dcowden/panelviz/docs/power_schematic.jpg

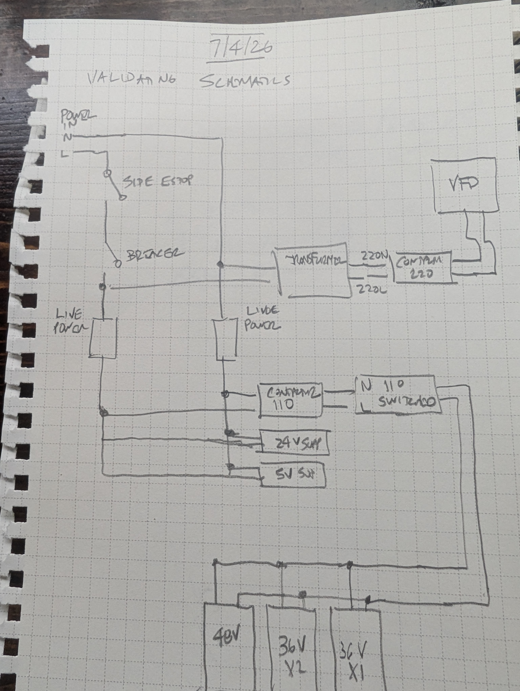
docs/power_schematic.jpg
