dcowden/panelviz/docs/safety_schematic.jpg

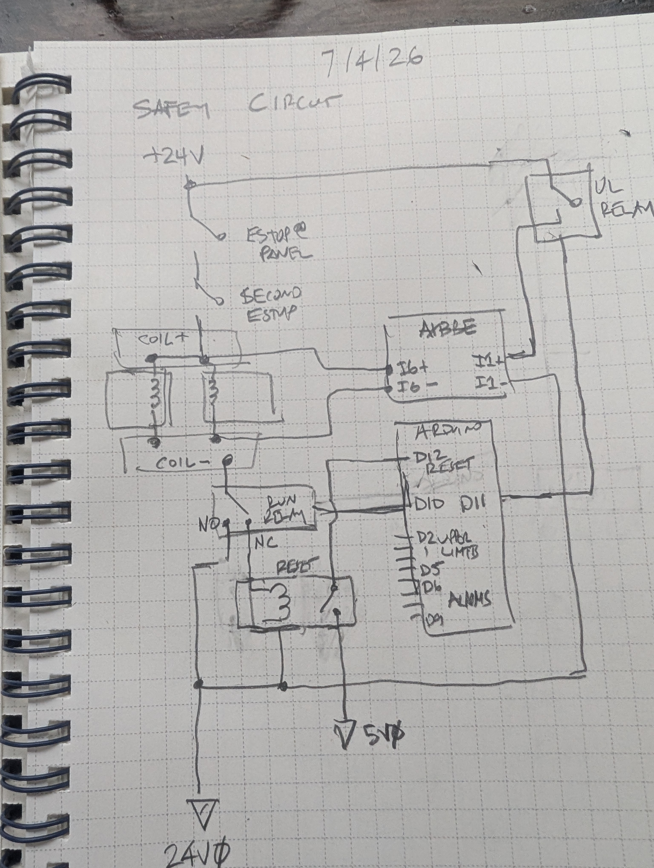
docs/safety_schematic.jpg
