dcowden/panelviz/README.md

# Combination panel software and docs for cnc machine

This is currently in a poor state-- its documentation for the
cnc machine, AND the code that produces it. 

To get interactive docs, install the project and then run:

```
panelviz mycnc.yml.
```

the latest artifacts are in the prod_machine folder
