dcowden/panelviz/wire_list.txt

| wirenumber | from_component | from_pin | to_component | to_pin | netname | awg | tags |
|---|---|---|---|---|---|---|---|
| 110L-1 | wall_plug | 1 | live_power_t | 1A | 110L | 12 | vfd |
| 110L-2 | live_power_t | 1B | transformer | 110L | 110L | 20 | vfd |
| 110L-3 | live_power_t | 3A | contactor_110 | T2 | 110L | 20 | vfd |
| 110L-4 | 24v | 110L | live_power_t | 3B | 110L | 20 | dc_power, vfd |
| 110L-5 | 5v | 110L | live_power_t | 5A | 110L | 20 | dc_power, vfd |
| 110L_SWITCHED-1 | contactor_110 | L2 | switched_110L | 1A | 110L_SWITCHED | 20 | vfd |
| 110L_SWITCHED-2 | 48v | 110L | switched_110L | 1B | 110L_SWITCHED | 20 | vfd |
| 110L_SWITCHED-3 | 36V_X1 | 110L | switched_110L | 2A | 110L_SWITCHED | 20 | vfd |
| 110L_SWITCHED-4 | 36V_X2 | 110L | switched_110L | 2B | 110L_SWITCHED | 20 | vfd |
| 110N-1 | wall_plug | 2 | live_power_t | 2A | 110N | 12 | vfd |
| 110N-2 | live_power_t | 2B | transformer | 110N | 110N | 20 | vfd |
| 110N-3 | live_power_t | 4A | contactor_110 | T3 | 110N | 20 | vfd |
| 110N-4 | 24v | 110N | live_power_t | 4B | 110N | 20 | dc_power, vfd |
| 110N-5 | 5v | 110N | live_power_t | 6A | 110N | 20 | dc_power, vfd |
| 110N_SWITCHED-1 | contactor_110 | L3 | switched_110N | 1A | 110N_SWITCHED | 20 | vfd |
| 110N_SWITCHED-2 | 36V_X1 | 110N | switched_110N | 1B | 110N_SWITCHED | 20 | vfd |
| 110N_SWITCHED-3 | 36V_X2 | 110N | switched_110N | 2A | 110N_SWITCHED | 20 | vfd |
| 110N_SWITCHED-4 | 48v | 110N | switched_110N | 2B | 110N_SWITCHED | 20 | vfd |
| 24V-1 | estop_panel | estop+ | cnc_terminals | 57A | 24V | 20 | terminals |
| 24V-2 | cnc_terminals | 57B | terminals_24v | 1A | 24V | 20 | terminals |
| 24V-3 | estop_panel | light+ | cnc_terminals | 59A | 24V | 20 | terminals |
| 24V-4 | cnc_terminals | 59B | terminals_24v | 1B | 24V | 20 | terminals |
| 24V-5 | 24v | 24V | dc_power_24v | 1A | 24V | 20 | dc_power |
| 24V-6 | dc_power_24v | 1B | safety_24v | 1A | 24V | 20 | dc_power, safety |
| 24V-7 | safety_24v | 1B | control_24v | 1A | 24V | 20 | safety, control |
| 24V-8 | control_24v | 1B | terminals_24v | 2A | 24V | 20 | control, terminals |
| 24V-9 | control_24v | 2A | axbb-e | I1+ | 24V | 20 | control |
| 24V-10 | control_24v | 2B | axbb-e | I2+ | 24V | 20 | control |
| 24V-11 | control_24v | 3A | axbb-e | I3+ | 24V | 20 | control |
| 24V-12 | control_24v | 3B | axbb-e | I4+ | 24V | 20 | control |
| 24V-13 | control_24v | 4A | axbb-e | I5+ | 24V | 20 | control |
| 24V-14 | axbb-e | IN-24V+ | control_24v | 4B | 24V | 20 | control |
| 24V0-1 | 24v | 24V0 | dc_power_24v0 | 1A | 24V0 | 20 | dc_power |
| 24V0-2 | dc_power_24v0 | 1B | safety_24v0 | 1A | 24V0 | 20 | dc_power, safety |
| 24V0-3 | safety_24v0 | 1B | control_24v0 | 1A | 24V0 | 20 | safety, control |
| 24V0-4 | control_24v0 | 1B | terminals_24v0 | 1A | 24V0 | 20 | control, terminals |
| 24V0-5 | axbb-e | IN-24V0 | control_24v0 | 2A | 24V0 | 20 | control |
| 24V0-6 | run_relay | COM | safety_24v0 | 2A | 24V0 | 20 | safety |
| 24V0-7 | upper_limits_ok_relay | COM | safety_24v0 | 2B | 24V0 | 20 | safety |
| 5V-1 | z_limits | 5v | cnc_terminals | 11A | 5V | 20 | terminals |
| 5V-2 | cnc_terminals | 11B | terminals_5v | 1A | 5V | 20 | terminals |
| 5V-3 | y_limits | 5v | cnc_terminals | 25A | 5V | 20 | terminals |
| 5V-4 | cnc_terminals | 25B | terminals_5v | 1B | 5V | 20 | terminals |
| 5V-5 | x1_limits | 5v | cnc_terminals | 37A | 5V | 20 | terminals |
| 5V-6 | cnc_terminals | 37B | terminals_5v | 2A | 5V | 20 | terminals |
| 5V-7 | x2_limits | 5v | cnc_terminals | 49A | 5V | 20 | terminals |
| 5V-8 | cnc_terminals | 49B | terminals_5v | 2B | 5V | 20 | terminals |
| 5V-9 | run_relay | DC+ | safety_5v | 1A | 5V | 20 | safety |
| 5V-10 | upper_limits_ok_relay | DC+ | safety_5v | 1B | 5V | 20 | safety |
| 5V-11 | 5v | 5V | dc_power_5v | 1A | 5V | 20 | dc_power |
| 5V-12 | dc_power_5v | 1B | safety_5v | 2A | 5V | 20 | dc_power, safety |
| 5V-13 | safety_5v | 2B | control_5v | 1A | 5V | 20 | safety, control |
| 5V-14 | control_5v | 1B | terminals_5v | 3A | 5V | 20 | control, terminals |
| 5V-15 | axbb-e | IN-5V+ | control_5v | 2A | 5V | 20 | control |
| 5V-16 | alarm_limit_board | 5V | safety_5v | 3A | 5V | 20 | safety |
| 5V-17 | opto_board | 5+ | safety_5v | 3B | 5V | 20 | safety |
| 5V-18 | opto_board | 6+ | safety_5v | 4A | 5V | 20 | safety |
| 5V-19 | opto_board | 7+ | safety_5v | 4B | 5V | 20 | safety |
| 5V-20 | opto_board | 8+ | safety_5v | 5A | 5V | 20 | safety |
| 5V0-1 | z_limits | 5v0 | cnc_terminals | 14A | 5V0 | 20 | terminals |
| 5V0-2 | cnc_terminals | 14B | terminals_5v0 | 1A | 5V0 | 20 | terminals |
| 5V0-3 | y_limits | 5v0 | cnc_terminals | 28A | 5V0 | 20 | terminals |
| 5V0-4 | cnc_terminals | 28B | terminals_5v0 | 1B | 5V0 | 20 | terminals |
| 5V0-5 | x1_control | alrm- | cnc_terminals | 32A | 5V0 | 20 | terminals |
| 5V0-6 | cnc_terminals | 32B | terminals_5v0 | 2A | 5V0 | 20 | terminals |
| 5V0-7 | x1_control | dir- | cnc_terminals | 34A | 5V0 | 20 | terminals |
| 5V0-8 | cnc_terminals | 34B | terminals_5v0 | 2B | 5V0 | 20 | terminals |
| 5V0-9 | x1_control | pul- | cnc_terminals | 36A | 5V0 | 20 | terminals |
| 5V0-10 | cnc_terminals | 36B | terminals_5v0 | 3A | 5V0 | 20 | terminals |
| 5V0-11 | x1_limits | 5v0 | cnc_terminals | 40A | 5V0 | 20 | terminals |
| 5V0-12 | cnc_terminals | 40B | terminals_5v0 | 3B | 5V0 | 20 | terminals |
| 5V0-13 | x2_control | alrm- | cnc_terminals | 44A | 5V0 | 20 | terminals |
| 5V0-14 | cnc_terminals | 44B | terminals_5v0 | 4A | 5V0 | 20 | terminals |
| 5V0-15 | x2_control | dir- | cnc_terminals | 46A | 5V0 | 20 | terminals |
| 5V0-16 | cnc_terminals | 46B | terminals_5v0 | 4B | 5V0 | 20 | terminals |
| 5V0-17 | x2_control | pul- | cnc_terminals | 48A | 5V0 | 20 | terminals |
| 5V0-18 | cnc_terminals | 48B | terminals_5v0 | 5A | 5V0 | 20 | terminals |
| 5V0-19 | x2_limits | 5v0 | cnc_terminals | 52A | 5V0 | 20 | terminals |
| 5V0-20 | cnc_terminals | 52B | terminals_5v0 | 5B | 5V0 | 20 | terminals |
| 5V0-21 | estop_panel | reset_sw+  | cnc_terminals | 55A | 5V0 | 20 | terminals |
| 5V0-22 | cnc_terminals | 55B | terminals_5v0 | 6A | 5V0 | 20 | terminals |
| 5V0-23 | run_relay | DC- | safety_5v0 | 1A | 5V0 | 20 | safety |
| 5V0-24 | upper_limits_ok_relay | DC- | safety_5v0 | 1B | 5V0 | 20 | safety |
| 5V0-25 | 5v | 5V0 | dc_power_5v0 | 1A | 5V0 | 20 | dc_power |
| 5V0-26 | dc_power_5v0 | 1B | safety_5v0 | 2A | 5V0 | 20 | dc_power, safety |
| 5V0-27 | safety_5v0 | 2B | control_5v0 | 1A | 5V0 | 20 | safety, control |
| 5V0-28 | control_5v0 | 1B | terminals_5v0 | 6B | 5V0 | 20 | control, terminals |
| 5V0-29 | y_cl57s | PUL- | control_5v0 | 2A | 5V0 | 20 | control |
| 5V0-30 | y_cl57s | DIR- | control_5v0 | 2B | 5V0 | 20 | control |
| 5V0-31 | y_cl57s | COM- | control_5v0 | 3A | 5V0 | 20 | control |
| 5V0-32 | Z_cl57s | PUL- | control_5v0 | 3B | 5V0 | 20 | control |
| 5V0-33 | Z_cl57s | DIR- | control_5v0 | 4A | 5V0 | 20 | control |
| 5V0-34 | Z_cl57s | COM- | control_5v0 | 4B | 5V0 | 20 | control |
| 5V0-35 | axbb-e | IN-5V0 | control_5v0 | 5A | 5V0 | 20 | control |
| 5V0-36 | alarm_limit_board | 5V0 | safety_5v0 | 3A | 5V0 | 20 | safety |
| 5V0-37 | opto_board | 1- | safety_5v0 | 3B | 5V0 | 20 | safety |
| 5V0-38 | opto_board | 2- | safety_5v0 | 4A | 5V0 | 20 | safety |
| 5V0-39 | opto_board | 3- | safety_5v0 | 4B | 5V0 | 20 | safety |
| 5V0-40 | opto_board | 4- | safety_5v0 | 5A | 5V0 | 20 | safety |
| COIL+-1 | contactor_110 | A1 | coil_t | 1A | COIL+ | 20 | vfd |
| COIL+-2 | contactor_220 | A1 | coil_t | 1B | COIL+ | 20 | vfd |
| COIL+-3 | secondary_estop | estop- | cnc_terminals | 64A | COIL+ | 20 | terminals |
| COIL+-4 | cnc_terminals | 64B | coil_t | 2A | COIL+ | 20 | terminals, vfd |
| COIL+-5 | axbb-e | I6+ | coil_t | 2B | COIL+ | 20 | control, vfd |
| COIL--1 | contactor_110 | A2 | coil_t | 5A | COIL- | 20 | vfd |
| COIL--2 | contactor_220 | A2 | coil_t | 5B | COIL- | 20 | vfd |
| COIL--3 | axbb-e | I6- | coil_t | 6A | COIL- | 20 | control, vfd |
| COIL--4 | run_relay | NO | coil_t | 6B | COIL- | 20 | safety, vfd |
| DRIVER_48V-1 | y_cl57s | +VDC | 48v | 48V | DRIVER_48V | 20 | control, vfd |
| DRIVER_48V-2 | Z_cl57s | +VDC | 48v | 48V | DRIVER_48V | 20 | control, vfd |
| DRIVER_GND-1 | z_control | gnd | cnc_terminals | 10A | DRIVER_GND | 20 | terminals |
| DRIVER_GND-2 | cnc_terminals | 10B | Z_cl57s | GND | DRIVER_GND | 20 | terminals, control |
| DRIVER_GND-3 | y_control | gnd | cnc_terminals | 24A | DRIVER_GND | 20 | terminals |
| DRIVER_GND-4 | cnc_terminals | 24B | y_cl57s | GND | DRIVER_GND | 20 | terminals, control |
| DRIVER_GND-5 | y_cl57s | GND | 48v | 48V0 | DRIVER_GND | 20 | control, vfd |
| DRIVER_GND-6 | Z_cl57s | GND | 48v | 48V0 | DRIVER_GND | 20 | control, vfd |
| RESET_SW-1 | estop_panel | reset_sw-  | cnc_terminals | 56A | RESET_SW | 20 | terminals |
| RESET_SW-2 | cnc_terminals | 56B | alarm_limit_board | D12 | RESET_SW | 20 | terminals, safety  |
| RUN_RELAY_CTL-1 | alarm_limit_board | D10 | run_relay | IN | RUN_RELAY_CTL | 20 | safety |
| UL1-1 | upper_limits_ok_relay | NC | axbb-e | I1- | UL1 | 20 | safety, control |
| UPPER_LIMITS_OK_RELAY_CTL-1 | alarm_limit_board | D11 | upper_limits_ok_relay | IN | UPPER_LIMITS_OK_RELAY_CTL | 20 | safety |
| VFD_FWD-1 | axbb-e | O3 | vfd | FOR | VFD_FWD | 20 | control, vfd |
| VFD_REV-1 | axbb-e | O2 | vfd | REV | VFD_REV | 20 | control, vfd |
| VFD_V1-1 | axbb-e | A01 | vfd | VI | VFD_V1 | 20 | control, vfd |
| X1DIR-1 | x1_control | dir+ | cnc_terminals | 33A | X1DIR | 20 | terminals |
| X1DIR-2 | cnc_terminals | 33B | axbb-e | O12 | X1DIR | 20 | terminals, control |
| X1LL-1 | x1_limits | ll | cnc_terminals | 39A | X1LL | 20 | terminals |
| X1LL-2 | cnc_terminals | 39B | axbb-e | I3- | X1LL | 20 | terminals, control |
| X1STEP-1 | x1_control | pul+ | cnc_terminals | 35A | X1STEP | 20 | terminals |
| X1STEP-2 | cnc_terminals | 35B | axbb-e | O11 | X1STEP | 20 | terminals, control |
| X1UL_OK-1 | alarm_limit_board | D2 | opto_board | O1 | X1UL_OK | 20 | safety |
| X1_ALM_OK-1 | alarm_limit_board | D6 | opto_board | O5 | X1_ALM_OK | 20 | safety |
| X2DIR-1 | x2_control | dir+ | cnc_terminals | 45A | X2DIR | 20 | terminals |
| X2DIR-2 | cnc_terminals | 45B | axbb-e | O14 | X2DIR | 20 | terminals, control |
| X2LL-1 | x2_limits | ll | cnc_terminals | 51A | X2LL | 20 | terminals |
| X2LL-2 | cnc_terminals | 51B | axbb-e | I4- | X2LL | 20 | terminals, control |
| X2STEP-1 | x2_control | pul+ | cnc_terminals | 47A | X2STEP | 20 | terminals |
| X2STEP-2 | cnc_terminals | 47B | axbb-e | O13 | X2STEP | 20 | terminals, control |
| X2UL_OK-1 | alarm_limit_board | D3 | opto_board | O2 | X2UL_OK | 20 | safety |
| X2_ALM_OK-1 | alarm_limit_board | D7 | opto_board | O6 | X2_ALM_OK | 20 | safety |
| YDIR-1 | y_cl57s | DIR+ | axbb-e | O10 | YDIR | 20 | control |
| YLL-1 | y_limits | ll | cnc_terminals | 27A | YLL | 20 | terminals |
| YLL-2 | cnc_terminals | 27B | axbb-e | I2- | YLL | 20 | terminals, control |
| YSTEP-1 | y_cl57s | PUL+ | axbb-e | O9 | YSTEP | 20 | control |
| YUL_OK-1 | alarm_limit_board | D4 | opto_board | O3 | YUL_OK | 20 | safety |
| Y_ALM_OK-1 | alarm_limit_board | D8 | opto_board | O7 | Y_ALM_OK | 20 | safety |
| ZDIR-1 | Z_cl57s | DIR+ | axbb-e | O16 | ZDIR | 20 | control |
| ZLL-1 | z_limits | ll | cnc_terminals | 13A | ZLL | 20 | terminals |
| ZLL-2 | cnc_terminals | 13B | axbb-e | I5- | ZLL | 20 | terminals, control |
| ZSTEP-1 | Z_cl57s | PUL+ | axbb-e | O15 | ZSTEP | 20 | control |
| ZUL_OK-1 | alarm_limit_board | D5 | opto_board | O4 | ZUL_OK | 20 | safety |
| Z_ALM_OK-1 | alarm_limit_board | D9 | opto_board | O8 | Z_ALM_OK | 20 | safety |
| Z_cl57s.ALM-1 | Z_cl57s | ALM | opto_board | 8- | Z_cl57s.ALM | 20 | control, safety |
| earth-1 | wall_plug | GND | vfd_earth | 1A | earth | 12 | vfd |
| earth-2 | transformer | GND | vfd_earth | 1B | earth | 20 | vfd |
| earth-3 | 48v | GND | vfd_earth | 2A | earth | 20 | vfd |
| earth-4 | 24v | GND | dc_power_earth | 1A | earth | 20 | dc_power |
| earth-5 | 5v | GND | dc_power_earth | 1B | earth | 20 | dc_power |
| earth-6 | 36V_X1 | GND | vfd_earth | 2B | earth | 20 | vfd |
| earth-7 | 36V_X2 | GND | vfd_earth | 3A | earth | 20 | vfd |
| earth-8 | vfd | GND | vfd_earth | 3B | earth | 20 | vfd |
| earth-9 | vfd_earth | 4A | dc_power_earth | 2A | earth | 20 | vfd, dc_power |
| earth-10 | dc_power_earth | 2B | safety_earth | 1A | earth | 20 | dc_power, safety |
| earth-11 | safety_earth | 1B | control_earth | 1A | earth | 20 | safety, control |
| earth-12 | control_earth | 1B | terminals_earth | 1A | earth | 20 | control, terminals |
| estop_panel.estop--1 | estop_panel | estop- | cnc_terminals | 58A | estop_panel.estop- | 20 | terminals |
| estop_panel.estop--2 | cnc_terminals | 58B | secondary_estop | estop+ | estop_panel.estop- | 20 | terminals |
| estop_panel.light--1 | estop_panel | light- | cnc_terminals | 60A | estop_panel.light- | 20 | terminals |
| estop_panel.light--2 | cnc_terminals | 60B | run_relay | NC | estop_panel.light- | 20 | terminals, safety  |
| probe.probe+-1 | probe | probe+ | cnc_terminals | 53A | probe.probe+ | 20 | terminals |
| probe.probe--1 | probe | probe- | cnc_terminals | 54A | probe.probe- | 20 | terminals |
| shield-1 | z_motor | shield | connector_earth | 1A | shield | 20 | terminals |
| shield-2 | z_control | shield | connector_earth | 1B | shield | 20 | terminals |
| shield-3 | z_limits | shield | connector_earth | 2A | shield | 20 | terminals |
| shield-4 | y_motor | shield | connector_earth | 2B | shield | 20 | terminals |
| shield-5 | y_control | shield | connector_earth | 3A | shield | 20 | terminals |
| shield-6 | y_limits | shield | connector_earth | 3B | shield | 20 | terminals |
| shield-7 | x1_motor | shield | connector_earth | 4A | shield | 20 | terminals |
| shield-8 | x1_limits | shield | connector_earth | 4B | shield | 20 | terminals |
| shield-9 | x2_motor | shield | connector_earth | 5A | shield | 20 | terminals |
| shield-10 | x2_limits | shield | connector_earth | 5B | shield | 20 | terminals |
| shield-11 | probe | shield | connector_earth | 6A | shield | 20 | terminals |
| shield-12 | spindle | shield | connector_earth | 6B | shield | 20 | terminals |
| spindle.u-1 | spindle | u | cnc_terminals | 61A | spindle.u | 16 | terminals |
| spindle.u-2 | cnc_terminals | 61B | vfd | U | spindle.u | 16 | terminals, vfd |
| spindle.v-1 | spindle | v | cnc_terminals | 62A | spindle.v | 16 | terminals |
| spindle.v-2 | cnc_terminals | 62B | vfd | V | spindle.v | 16 | terminals, vfd |
| spindle.w-1 | spindle | w | cnc_terminals | 63A | spindle.w | 16 | terminals |
| spindle.w-2 | cnc_terminals | 63B | vfd | W | spindle.w | 16 | terminals, vfd |
| transformer.220L-1 | transformer | 220L | contactor_220 | T1 | transformer.220L | 20 | vfd |
| transformer.220N-1 | transformer | 220N | contactor_220 | T2 | transformer.220N | 20 | vfd |
| vfd.R-1 | vfd | R | contactor_220 | L1 | vfd.R | 20 | vfd |
| vfd.T-1 | vfd | T | contactor_220 | L2 | vfd.T | 20 | vfd |
| x1_control.alrm+-1 | x1_control | alrm+ | cnc_terminals | 31A | x1_control.alrm+ | 20 | terminals |
| x1_control.alrm+-2 | cnc_terminals | 31B | opto_board | 5- | x1_control.alrm+ | 20 | terminals, safety  |
| x1_limits.ul-1 | x1_limits | ul | cnc_terminals | 38A | x1_limits.ul | 20 | terminals |
| x1_limits.ul-2 | cnc_terminals | 38B | opto_board | 1+ | x1_limits.ul | 20 | terminals, safety  |
| x1_motor.M+-1 | x1_motor | M+ | cnc_terminals | 29A | x1_motor.M+ | 16 | terminals |
| x1_motor.M+-2 | cnc_terminals | 29B | 36V_X1 | 36V_X1 | x1_motor.M+ | 16 | terminals, vfd |
| x1_motor.M--1 | x1_motor | M- | cnc_terminals | 30A | x1_motor.M- | 16 | terminals |
| x1_motor.M--2 | cnc_terminals | 30B | 36V_X1 | 36V0_X1  | x1_motor.M- | 16 | terminals, vfd |
| x2_control.alrm+-1 | x2_control | alrm+ | cnc_terminals | 43A | x2_control.alrm+ | 20 | terminals |
| x2_control.alrm+-2 | cnc_terminals | 43B | opto_board | 6- | x2_control.alrm+ | 20 | terminals, safety  |
| x2_limits.ul-1 | x2_limits | ul | cnc_terminals | 50A | x2_limits.ul | 20 | terminals |
| x2_limits.ul-2 | cnc_terminals | 50B | opto_board | 2+ | x2_limits.ul | 20 | terminals, safety  |
| x2_motor.M+-1 | x2_motor | M+ | cnc_terminals | 41A | x2_motor.M+ | 16 | terminals |
| x2_motor.M+-2 | cnc_terminals | 41B | 36V_X2 | 36V_X2 | x2_motor.M+ | 16 | terminals, vfd |
| x2_motor.M--1 | x2_motor | M- | cnc_terminals | 42A | x2_motor.M- | 16 | terminals |
| x2_motor.M--2 | cnc_terminals | 42B | 36V_X2 | 36V0_X2  | x2_motor.M- | 16 | terminals, vfd |
| y_cl57s.ALM-1 | y_cl57s | ALM | opto_board | 7- | y_cl57s.ALM | 20 | control, safety |
| y_control.ea+-1 | y_control | ea+ | cnc_terminals | 21A | y_control.ea+ | 20 | terminals |
| y_control.ea+-2 | cnc_terminals | 21B | y_cl57s | EA+ | y_control.ea+ | 20 | terminals, control |
| y_control.ea--1 | y_control | ea- | cnc_terminals | 22A | y_control.ea- | 20 | terminals |
| y_control.ea--2 | cnc_terminals | 22B | y_cl57s | EA- | y_control.ea- | 20 | terminals, control |
| y_control.eb+-1 | y_control | eb+ | cnc_terminals | 19A | y_control.eb+ | 20 | terminals |
| y_control.eb+-2 | cnc_terminals | 19B | y_cl57s | EB+ | y_control.eb+ | 20 | terminals, control |
| y_control.eb--1 | y_control | eb- | cnc_terminals | 20A | y_control.eb- | 20 | terminals |
| y_control.eb--2 | cnc_terminals | 20B | y_cl57s | EB- | y_control.eb- | 20 | terminals, control |
| y_control.vcc-1 | y_control | vcc | cnc_terminals | 23A | y_control.vcc | 20 | terminals |
| y_control.vcc-2 | cnc_terminals | 23B | y_cl57s | VCC | y_control.vcc | 20 | terminals, control |
| y_limits.ul-1 | y_limits | ul | cnc_terminals | 26A | y_limits.ul | 20 | terminals |
| y_limits.ul-2 | cnc_terminals | 26B | opto_board | 3+ | y_limits.ul | 20 | terminals, safety  |
| y_motor.ma+-1 | y_motor | ma+ | cnc_terminals | 15A | y_motor.ma+ | 16 | terminals |
| y_motor.ma+-2 | cnc_terminals | 15B | y_cl57s | A+ | y_motor.ma+ | 16 | terminals, control |
| y_motor.ma--1 | y_motor | ma- | cnc_terminals | 16A | y_motor.ma- | 16 | terminals |
| y_motor.ma--2 | cnc_terminals | 16B | y_cl57s | A- | y_motor.ma- | 16 | terminals, control |
| y_motor.mb+-1 | y_motor | mb+ | cnc_terminals | 17A | y_motor.mb+ | 16 | terminals |
| y_motor.mb+-2 | cnc_terminals | 17B | y_cl57s | B+ | y_motor.mb+ | 16 | terminals, control |
| y_motor.mb--1 | y_motor | mb- | cnc_terminals | 18A | y_motor.mb- | 16 | terminals |
| y_motor.mb--2 | cnc_terminals | 18B | y_cl57s | B- | y_motor.mb- | 16 | terminals, control |
| z_control.ea+-1 | z_control | ea+ | cnc_terminals | 7A | z_control.ea+ | 20 | terminals |
| z_control.ea+-2 | cnc_terminals | 7B | Z_cl57s | EA+ | z_control.ea+ | 20 | terminals, control |
| z_control.ea--1 | z_control | ea- | cnc_terminals | 8A | z_control.ea- | 20 | terminals |
| z_control.ea--2 | cnc_terminals | 8B | Z_cl57s | EA- | z_control.ea- | 20 | terminals, control |
| z_control.eb+-1 | z_control | eb+ | cnc_terminals | 5A | z_control.eb+ | 20 | terminals |
| z_control.eb+-2 | cnc_terminals | 5B | Z_cl57s | EB+ | z_control.eb+ | 20 | terminals, control |
| z_control.eb--1 | z_control | eb- | cnc_terminals | 6A | z_control.eb- | 20 | terminals |
| z_control.eb--2 | cnc_terminals | 6B | Z_cl57s | EB- | z_control.eb- | 20 | terminals, control |
| z_control.vcc-1 | z_control | vcc | cnc_terminals | 9A | z_control.vcc | 20 | terminals |
| z_control.vcc-2 | cnc_terminals | 9B | Z_cl57s | VCC | z_control.vcc | 20 | terminals, control |
| z_limits.ul-1 | z_limits | ul | cnc_terminals | 12A | z_limits.ul | 20 | terminals |
| z_limits.ul-2 | cnc_terminals | 12B | opto_board | 4+ | z_limits.ul | 20 | terminals, safety  |
| z_motor.ma+-1 | z_motor | ma+ | cnc_terminals | 1A | z_motor.ma+ | 16 | terminals |
| z_motor.ma+-2 | cnc_terminals | 1B | Z_cl57s | A+ | z_motor.ma+ | 16 | terminals, control |
| z_motor.ma--1 | z_motor | ma- | cnc_terminals | 2A | z_motor.ma- | 16 | terminals |
| z_motor.ma--2 | cnc_terminals | 2B | Z_cl57s | A- | z_motor.ma- | 16 | terminals, control |
| z_motor.mb+-1 | z_motor | mb+ | cnc_terminals | 3A | z_motor.mb+ | 16 | terminals |
| z_motor.mb+-2 | cnc_terminals | 3B | Z_cl57s | B+ | z_motor.mb+ | 16 | terminals, control |
| z_motor.mb--1 | z_motor | mb- | cnc_terminals | 4A | z_motor.mb- | 16 | terminals |
| z_motor.mb--2 | cnc_terminals | 4B | Z_cl57s | B- | z_motor.mb- | 16 | terminals, control |
