dcowden/panelviz/prod_machine/mycnc_schematic.pdf

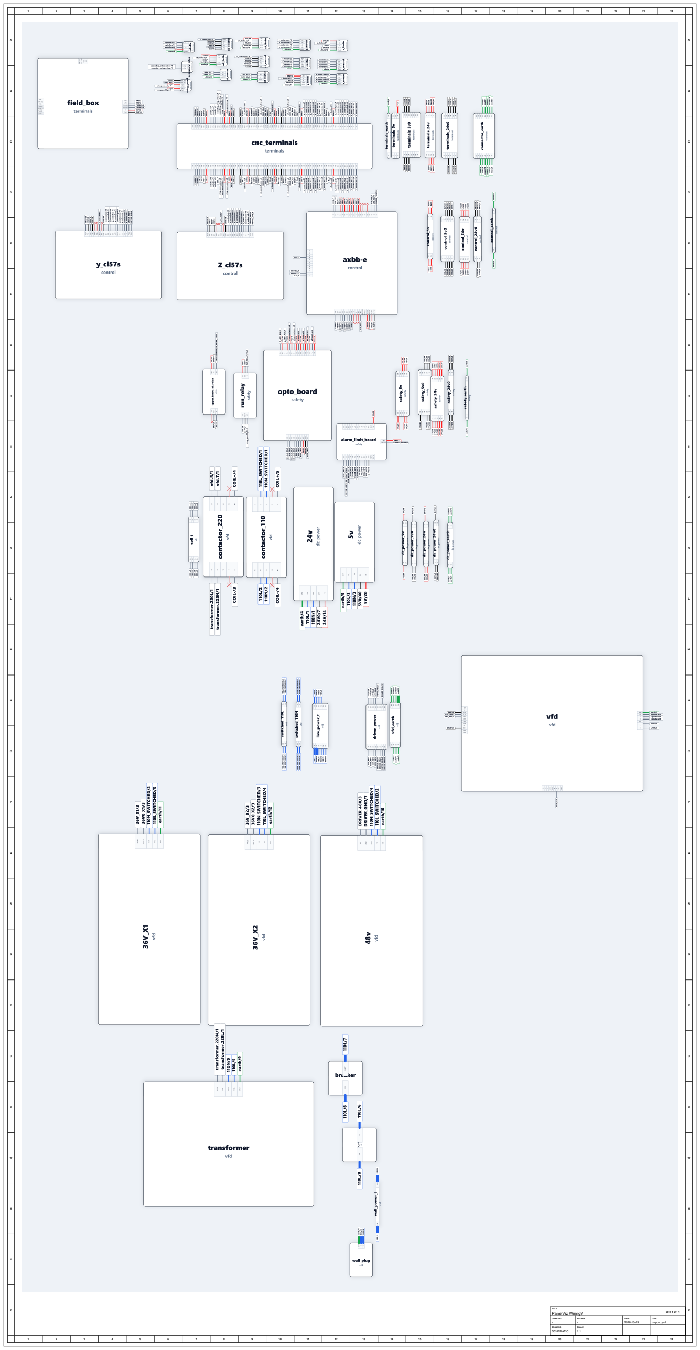
[picture p3: page 1]

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
TITLE

## PanelViz Wiring?

SHT 1 OF 1

COMPANY

AUTHOR

DATE
2026-10-29

FILE
mycnc.yml

DRAWING
SCHEMATIC

SCALE
1:1
