dcowden/panelviz/wirelabel_control.pdf

z_motor.ma+-2 z_motor.ma+-2 z_motor.ma+-2 z_motor.ma+-2 z_motor.ma+-2 | z_control.ea+-2 z_control.ea+-2 z_control.ea+-2 z_control.ea+-2 z_control.ea+-2 | y_motor.mb+-2 y_motor.mb+-2 y_motor.mb+-2 y_motor.mb+-2 y_motor.mb+-2 | y_control.vcc-2 y_control.vcc-2 y_control.vcc-2 y_control.vcc-2 y_control.vcc-2 | ZLL-2 ZLL-2 ZLL-2 ZLL-2 ZLL-2 | X2STEP-2 X2STEP-2 X2STEP-2 X2STEP-2 X2STEP-2
z_motor.ma--2 z_motor.ma--2 z_motor.ma--2 z_motor.ma--2 z_motor.ma--2 | z_control.ea--2 z_control.ea--2 z_control.ea--2 z_control.ea--2 z_control.ea--2 | y_motor.mb--2 y_motor.mb--2 y_motor.mb--2 y_motor.mb--2 y_motor.mb--2 | DRIVER_GND-4 DRIVER_GND-4 DRIVER_GND-4 DRIVER_GND-4 DRIVER_GND-4 | YLL-2 YLL-2 YLL-2 YLL-2 YLL-2 | X2LL-2 X2LL-2 X2LL-2 X2LL-2 X2LL-2
z_motor.mb+-2 z_motor.mb+-2 z_motor.mb+-2 z_motor.mb+-2 z_motor.mb+-2 | z_control.vcc-2 z_control.vcc-2 z_control.vcc-2 z_control.vcc-2 z_control.vcc-2 | y_control.eb+-2 y_control.eb+-2 y_control.eb+-2 y_control.eb+-2 y_control.eb+-2 | y_cl57s.ALM-1 y_cl57s.ALM-1 y_cl57s.ALM-1 y_cl57s.ALM-1 y_cl57s.ALM-1 | X1DIR-2 X1DIR-2 X1DIR-2 X1DIR-2 X1DIR-2 | 5V-13 5V-13 5V-13 5V-13 5V-13
z_motor.mb--2 z_motor.mb--2 z_motor.mb--2 z_motor.mb--2 z_motor.mb--2 | DRIVER_GND-2 DRIVER_GND-2 DRIVER_GND-2 DRIVER_GND-2 DRIVER_GND-2 | y_control.eb--2 y_control.eb--2 y_control.eb--2 y_control.eb--2 y_control.eb--2 | DRIVER_48V-1 DRIVER_48V-1 DRIVER_48V-1 DRIVER_48V-1 DRIVER_48V-1 | X1STEP-2 X1STEP-2 X1STEP-2 X1STEP-2 X1STEP-2 | 5V-14 5V-14 5V-14 5V-14 5V-14
z_control.eb+-2 z_control.eb+-2 z_control.eb+-2 z_control.eb+-2 z_control.eb+-2 | y_motor.ma+-2 y_motor.ma+-2 y_motor.ma+-2 y_motor.ma+-2 y_motor.ma+-2 | y_control.ea+-2 y_control.ea+-2 y_control.ea+-2 y_control.ea+-2 y_control.ea+-2 | DRIVER_GND-5 DRIVER_GND-5 DRIVER_GND-5 DRIVER_GND-5 DRIVER_GND-5 | X1LL-2 X1LL-2 X1LL-2 X1LL-2 X1LL-2 | 5V0-27 5V0-27 5V0-27 5V0-27 5V0-27
z_control.eb--2 z_control.eb--2 z_control.eb--2 z_control.eb--2 z_control.eb--2 | y_motor.ma--2 y_motor.ma--2 y_motor.ma--2 y_motor.ma--2 y_motor.ma--2 | y_control.ea--2 y_control.ea--2 y_control.ea--2 y_control.ea--2 y_control.ea--2 | Z_cl57s.ALM-1 Z_cl57s.ALM-1 Z_cl57s.ALM-1 Z_cl57s.ALM-1 Z_cl57s.ALM-1 | X2DIR-2 X2DIR-2 X2DIR-2 X2DIR-2 X2DIR-2 | 5V0-28 5V0-28 5V0-28 5V0-28 5V0-28
