dcowden/panelviz/wirelabel_control2.pdf

24V-7 24V-7 24V-7 24V-7 24V-7 | YSTEP-1 YSTEP-1 YSTEP-1 YSTEP-1 YSTEP-1 | 5V0-32 5V0-32 5V0-32 5V0-32 5V0-32 | 24V-9 24V-9 24V-9 24V-9 24V-9 | COIL--3 COIL--3 COIL--3 COIL--3 COIL--3 | DRIVER_48V-2 DRIVER_48V-2 DRIVER_48V-2 DRIVER_48V-2 DRIVER_48V-2 | UL1-1 UL1-1 UL1-1 UL1-1 UL1-1
24V-8 24V-8 24V-8 24V-8 24V-8 | 5V0-29 5V0-29 5V0-29 5V0-29 5V0-29 | ZDIR-1 ZDIR-1 ZDIR-1 ZDIR-1 ZDIR-1 | 24V-10 24V-10 24V-10 24V-10 24V-10 | 24V0-5 24V0-5 24V0-5 24V0-5 24V0-5 | DRIVER_GND-6 DRIVER_GND-6 DRIVER_GND-6 DRIVER_GND-6 DRIVER_GND-6
24V0-3 24V0-3 24V0-3 24V0-3 24V0-3 | YDIR-1 YDIR-1 YDIR-1 YDIR-1 YDIR-1 | 5V0-33 5V0-33 5V0-33 5V0-33 5V0-33 | 24V-11 24V-11 24V-11 24V-11 24V-11 | 24V-14 24V-14 24V-14 24V-14 24V-14
24V0-4 24V0-4 24V0-4 24V0-4 24V0-4 | 5V0-30 5V0-30 5V0-30 5V0-30 5V0-30 | 5V0-34 5V0-34 5V0-34 5V0-34 5V0-34 | 24V-12 24V-12 24V-12 24V-12 24V-12 | 5V0-35 5V0-35 5V0-35 5V0-35 5V0-35
earth-11 earth-11 earth-11 earth-11 earth-11 | 5V0-31 5V0-31 5V0-31 5V0-31 5V0-31 | VFD_FWD-1 VFD_FWD-1 VFD_FWD-1 VFD_FWD-1 VFD_FWD-1 | 24V-13 24V-13 24V-13 24V-13 24V-13 | 5V-15 5V-15 5V-15 5V-15 5V-15
earth-12 earth-12 earth-12 earth-12 earth-12 | ZSTEP-1 ZSTEP-1 ZSTEP-1 ZSTEP-1 ZSTEP-1 | VFD_REV-1 VFD_REV-1 VFD_REV-1 VFD_REV-1 VFD_REV-1 | COIL+-5 COIL+-5 COIL+-5 COIL+-5 COIL+-5 | VFD_V1-1 VFD_V1-1 VFD_V1-1 VFD_V1-1 VFD_V1-1
