dcowden/panelviz/wirelabel_dc_power.pdf

earth-4 earth-4 earth-4 earth-4 earth-4 | 5V-11 5V-11 5V-11 5V-11 5V-11 | 24V-6 24V-6 24V-6 24V-6 24V-6
110N-4 110N-4 110N-4 110N-4 110N-4 | 5V0-25 5V0-25 5V0-25 5V0-25 5V0-25 | 24V0-2 24V0-2 24V0-2 24V0-2 24V0-2
110L-4 110L-4 110L-4 110L-4 110L-4 | 24V-5 24V-5 24V-5 24V-5 24V-5 | earth-9 earth-9 earth-9 earth-9 earth-9
110N-5 110N-5 110N-5 110N-5 110N-5 | 24V0-1 24V0-1 24V0-1 24V0-1 24V0-1 | earth-10 earth-10 earth-10 earth-10 earth-10
110L-5 110L-5 110L-5 110L-5 110L-5 | 5V-12 5V-12 5V-12 5V-12 5V-12
earth-5 earth-5 earth-5 earth-5 earth-5 | 5V0-26 5V0-26 5V0-26 5V0-26 5V0-26
