dcowden/panelviz/wirelabel_safety.pdf

z_limits.ul-2 z_limits.ul-2 z_limits.ul-2 z_limits.ul-2 z_limits.ul-2 | 5V-9 5V-9 5V-9 5V-9 5V-9 | 5V0-27 5V0-27 5V0-27 5V0-27 5V0-27 | earth-11 earth-11 earth-11 earth-11 earth-11 | Z_ALM_OK-1 Z_ALM_OK-1 Z_ALM_OK-1 Z_ALM_OK-1 Z_ALM_OK-1 | UL1-1 UL1-1 UL1-1 UL1-1 UL1-1 | x1_control.alrm+-2 x1_control.alrm+-2 x1_control.alrm+-2 x1_control.alrm+-2 x1_control.alrm+-2
y_limits.ul-2 y_limits.ul-2 y_limits.ul-2 y_limits.ul-2 y_limits.ul-2 | 5V0-24 5V0-24 5V0-24 5V0-24 5V0-24 | 24V-6 24V-6 24V-6 24V-6 24V-6 | X1UL_OK-1 X1UL_OK-1 X1UL_OK-1 X1UL_OK-1 X1UL_OK-1 | 5V0-36 5V0-36 5V0-36 5V0-36 5V0-36 | 5V0-37 5V0-37 5V0-37 5V0-37 5V0-37 | x2_control.alrm+-2 x2_control.alrm+-2 x2_control.alrm+-2 x2_control.alrm+-2 x2_control.alrm+-2
x1_limits.ul-2 x1_limits.ul-2 x1_limits.ul-2 x1_limits.ul-2 x1_limits.ul-2 | 5V-10 5V-10 5V-10 5V-10 5V-10 | 24V-7 24V-7 24V-7 24V-7 24V-7 | X2UL_OK-1 X2UL_OK-1 X2UL_OK-1 X2UL_OK-1 X2UL_OK-1 | 5V-16 5V-16 5V-16 5V-16 5V-16 | 5V0-38 5V0-38 5V0-38 5V0-38 5V0-38 | estop_panel.light--2 estop_panel.light--2 estop_panel.light--2 estop_panel.light--2 estop_panel.light--2
x2_limits.ul-2 x2_limits.ul-2 x2_limits.ul-2 x2_limits.ul-2 x2_limits.ul-2 | 5V-12 5V-12 5V-12 5V-12 5V-12 | 24V0-2 24V0-2 24V0-2 24V0-2 24V0-2 | YUL_OK-1 YUL_OK-1 YUL_OK-1 YUL_OK-1 YUL_OK-1 | 24V0-6 24V0-6 24V0-6 24V0-6 24V0-6 | 5V0-39 5V0-39 5V0-39 5V0-39 5V0-39 | RUN_RELAY_CTL-1 RUN_RELAY_CTL-1 RUN_RELAY_CTL-1 RUN_RELAY_CTL-1 RUN_RELAY_CTL-1
RESET_SW-2 RESET_SW-2 RESET_SW-2 RESET_SW-2 RESET_SW-2 | 5V-13 5V-13 5V-13 5V-13 5V-13 | 24V0-3 24V0-3 24V0-3 24V0-3 24V0-3 | ZUL_OK-1 ZUL_OK-1 ZUL_OK-1 ZUL_OK-1 ZUL_OK-1 | COIL--4 COIL--4 COIL--4 COIL--4 COIL--4 | 5V0-40 5V0-40 5V0-40 5V0-40 5V0-40
5V0-23 5V0-23 5V0-23 5V0-23 5V0-23 | 5V0-26 5V0-26 5V0-26 5V0-26 5V0-26 | earth-10 earth-10 earth-10 earth-10 earth-10 | Y_ALM_OK-1 Y_ALM_OK-1 Y_ALM_OK-1 Y_ALM_OK-1 Y_ALM_OK-1 | 24V0-7 24V0-7 24V0-7 24V0-7 24V0-7 | 5V-17 5V-17 5V-17 5V-17 5V-17
