dcowden/panelviz/wirelabel_safety2.pdf

UPPER_LIMITS_OK_RELAY_CTL-1 UPPER_LIMITS_OK_RELAY_CTL-1 UPPER_LIMITS_OK_RELAY_CTL-1 UPPER_LIMITS_OK_RELAY_CTL-1 UPPER_LIMITS_OK_RELAY_CTL-1 | y_cl57s.ALM-1 y_cl57s.ALM-1 y_cl57s.ALM-1 y_cl57s.ALM-1 y_cl57s.ALM-1 | 5V-18 5V-18 5V-18 5V-18 5V-18
| Z_cl57s.ALM-1 Z_cl57s.ALM-1 Z_cl57s.ALM-1 Z_cl57s.ALM-1 Z_cl57s.ALM-1 | 5V-19 5V-19 5V-19 5V-19 5V-19
| X1_ALM_OK-1 X1_ALM_OK-1 X1_ALM_OK-1 X1_ALM_OK-1 X1_ALM_OK-1 | 5V-20 5V-20 5V-20 5V-20 5V-20
| X2_ALM_OK-1 X2_ALM_OK-1 X2_ALM_OK-1 X2_ALM_OK-1 X2_ALM_OK-1
