dcowden/panelviz/wirelabel_terminals.pdf

x1_control.alrm+-1 x1_control.alrm+-1 x1_control.alrm+-1 x1_control.alrm+-1 x1_control.alrm+-1 | z_motor.ma+-1 z_motor.ma+-1 z_motor.ma+-1 z_motor.ma+-1 z_motor.ma+-1 | z_motor.mb--1 z_motor.mb--1 z_motor.mb--1 z_motor.mb--1 z_motor.mb--1 | z_control.ea+-1 z_control.ea+-1 z_control.ea+-1 z_control.ea+-1 z_control.ea+-1 | DRIVER_GND-1 DRIVER_GND-1 DRIVER_GND-1 DRIVER_GND-1 DRIVER_GND-1 | y_motor.mb+-1 y_motor.mb+-1 y_motor.mb+-1 y_motor.mb+-1 y_motor.mb+-1
x1_control.alrm+-2 x1_control.alrm+-2 x1_control.alrm+-2 x1_control.alrm+-2 x1_control.alrm+-2 | z_motor.ma+-2 z_motor.ma+-2 z_motor.ma+-2 z_motor.ma+-2 z_motor.ma+-2 | z_motor.mb--2 z_motor.mb--2 z_motor.mb--2 z_motor.mb--2 z_motor.mb--2 | z_control.ea+-2 z_control.ea+-2 z_control.ea+-2 z_control.ea+-2 z_control.ea+-2 | DRIVER_GND-2 DRIVER_GND-2 DRIVER_GND-2 DRIVER_GND-2 DRIVER_GND-2 | y_motor.mb+-2 y_motor.mb+-2 y_motor.mb+-2 y_motor.mb+-2 y_motor.mb+-2
x2_control.alrm+-1 x2_control.alrm+-1 x2_control.alrm+-1 x2_control.alrm+-1 x2_control.alrm+-1 | z_motor.ma--1 z_motor.ma--1 z_motor.ma--1 z_motor.ma--1 z_motor.ma--1 | z_control.eb+-1 z_control.eb+-1 z_control.eb+-1 z_control.eb+-1 z_control.eb+-1 | z_control.ea--1 z_control.ea--1 z_control.ea--1 z_control.ea--1 z_control.ea--1 | y_motor.ma+-1 y_motor.ma+-1 y_motor.ma+-1 y_motor.ma+-1 y_motor.ma+-1 | y_motor.mb--1 y_motor.mb--1 y_motor.mb--1 y_motor.mb--1 y_motor.mb--1
x2_control.alrm+-2 x2_control.alrm+-2 x2_control.alrm+-2 x2_control.alrm+-2 x2_control.alrm+-2 | z_motor.ma--2 z_motor.ma--2 z_motor.ma--2 z_motor.ma--2 z_motor.ma--2 | z_control.eb+-2 z_control.eb+-2 z_control.eb+-2 z_control.eb+-2 z_control.eb+-2 | z_control.ea--2 z_control.ea--2 z_control.ea--2 z_control.ea--2 z_control.ea--2 | y_motor.ma+-2 y_motor.ma+-2 y_motor.ma+-2 y_motor.ma+-2 y_motor.ma+-2 | y_motor.mb--2 y_motor.mb--2 y_motor.mb--2 y_motor.mb--2 y_motor.mb--2
estop_panel.estop--1 estop_panel.estop--1 estop_panel.estop--1 estop_panel.estop--1 estop_panel.estop--1 | z_motor.mb+-1 z_motor.mb+-1 z_motor.mb+-1 z_motor.mb+-1 z_motor.mb+-1 | z_control.eb--1 z_control.eb--1 z_control.eb--1 z_control.eb--1 z_control.eb--1 | z_control.vcc-1 z_control.vcc-1 z_control.vcc-1 z_control.vcc-1 z_control.vcc-1 | y_motor.ma--1 y_motor.ma--1 y_motor.ma--1 y_motor.ma--1 y_motor.ma--1 | y_control.eb+-1 y_control.eb+-1 y_control.eb+-1 y_control.eb+-1 y_control.eb+-1
estop_panel.estop--2 estop_panel.estop--2 estop_panel.estop--2 estop_panel.estop--2 estop_panel.estop--2 | z_motor.mb+-2 z_motor.mb+-2 z_motor.mb+-2 z_motor.mb+-2 z_motor.mb+-2 | z_control.eb--2 z_control.eb--2 z_control.eb--2 z_control.eb--2 z_control.eb--2 | z_control.vcc-2 z_control.vcc-2 z_control.vcc-2 z_control.vcc-2 z_control.vcc-2 | y_motor.ma--2 y_motor.ma--2 y_motor.ma--2 y_motor.ma--2 y_motor.ma--2 | y_control.eb+-2 y_control.eb+-2 y_control.eb+-2 y_control.eb+-2 y_control.eb+-2
