dcowden/panelviz/wirelabel_terminals2.pdf

y_control.eb--1 y_control.eb--1 y_control.eb--1 y_control.eb--1 y_control.eb--1 | y_control.vcc-1 y_control.vcc-1 y_control.vcc-1 y_control.vcc-1 y_control.vcc-1 | x1_motor.M--1 x1_motor.M--1 x1_motor.M--1 x1_motor.M--1 x1_motor.M--1 | shield-1 shield-1 shield-1 shield-1 shield-1 | ZLL-1 ZLL-1 ZLL-1 ZLL-1 ZLL-1 | shield-5 shield-5 shield-5 shield-5 shield-5 | YLL-2 YLL-2 YLL-2 YLL-2 YLL-2
y_control.eb--2 y_control.eb--2 y_control.eb--2 y_control.eb--2 y_control.eb--2 | y_control.vcc-2 y_control.vcc-2 y_control.vcc-2 y_control.vcc-2 y_control.vcc-2 | x1_motor.M--2 x1_motor.M--2 x1_motor.M--2 x1_motor.M--2 x1_motor.M--2 | shield-2 shield-2 shield-2 shield-2 shield-2 | ZLL-2 ZLL-2 ZLL-2 ZLL-2 ZLL-2 | 5V-3 5V-3 5V-3 5V-3 5V-3 | 5V0-3 5V0-3 5V0-3 5V0-3 5V0-3
y_control.ea+-1 y_control.ea+-1 y_control.ea+-1 y_control.ea+-1 y_control.ea+-1 | DRIVER_GND-3 DRIVER_GND-3 DRIVER_GND-3 DRIVER_GND-3 DRIVER_GND-3 | x2_motor.M+-1 x2_motor.M+-1 x2_motor.M+-1 x2_motor.M+-1 x2_motor.M+-1 | 5V-1 5V-1 5V-1 5V-1 5V-1 | 5V0-1 5V0-1 5V0-1 5V0-1 5V0-1 | 5V-4 5V-4 5V-4 5V-4 5V-4 | 5V0-4 5V0-4 5V0-4 5V0-4 5V0-4
y_control.ea+-2 y_control.ea+-2 y_control.ea+-2 y_control.ea+-2 y_control.ea+-2 | DRIVER_GND-4 DRIVER_GND-4 DRIVER_GND-4 DRIVER_GND-4 DRIVER_GND-4 | x2_motor.M+-2 x2_motor.M+-2 x2_motor.M+-2 x2_motor.M+-2 x2_motor.M+-2 | 5V-2 5V-2 5V-2 5V-2 5V-2 | 5V0-2 5V0-2 5V0-2 5V0-2 5V0-2 | y_limits.ul-1 y_limits.ul-1 y_limits.ul-1 y_limits.ul-1 y_limits.ul-1 | shield-6 shield-6 shield-6 shield-6 shield-6
y_control.ea--1 y_control.ea--1 y_control.ea--1 y_control.ea--1 y_control.ea--1 | x1_motor.M+-1 x1_motor.M+-1 x1_motor.M+-1 x1_motor.M+-1 x1_motor.M+-1 | x2_motor.M--1 x2_motor.M--1 x2_motor.M--1 x2_motor.M--1 x2_motor.M--1 | z_limits.ul-1 z_limits.ul-1 z_limits.ul-1 z_limits.ul-1 z_limits.ul-1 | shield-3 shield-3 shield-3 shield-3 shield-3 | y_limits.ul-2 y_limits.ul-2 y_limits.ul-2 y_limits.ul-2 y_limits.ul-2 | shield-7 shield-7 shield-7 shield-7 shield-7
y_control.ea--2 y_control.ea--2 y_control.ea--2 y_control.ea--2 y_control.ea--2 | x1_motor.M+-2 x1_motor.M+-2 x1_motor.M+-2 x1_motor.M+-2 x1_motor.M+-2 | x2_motor.M--2 x2_motor.M--2 x2_motor.M--2 x2_motor.M--2 x2_motor.M--2 | z_limits.ul-2 z_limits.ul-2 z_limits.ul-2 z_limits.ul-2 z_limits.ul-2 | shield-4 shield-4 shield-4 shield-4 shield-4 | YLL-1 YLL-1 YLL-1 YLL-1 YLL-1 | 5V0-5 5V0-5 5V0-5 5V0-5 5V0-5
