dcowden/panelviz/wirelabel_terminals3.pdf

5V0-6 5V0-6 5V0-6 5V0-6 5V0-6 | X1STEP-2 X1STEP-2 X1STEP-2 X1STEP-2 X1STEP-2 | x1_limits.ul-2 x1_limits.ul-2 x1_limits.ul-2 x1_limits.ul-2 x1_limits.ul-2 | shield-9 shield-9 shield-9 shield-9 shield-9 | 5V0-16 5V0-16 5V0-16 5V0-16 5V0-16 | 5V-8 5V-8 5V-8 5V-8 5V-8 | 5V0-20 5V0-20 5V0-20 5V0-20 5V0-20
X1DIR-1 X1DIR-1 X1DIR-1 X1DIR-1 X1DIR-1 | 5V0-9 5V0-9 5V0-9 5V0-9 5V0-9 | X1LL-1 X1LL-1 X1LL-1 X1LL-1 X1LL-1 | 5V0-13 5V0-13 5V0-13 5V0-13 5V0-13 | X2STEP-1 X2STEP-1 X2STEP-1 X2STEP-1 X2STEP-1 | x2_limits.ul-1 x2_limits.ul-1 x2_limits.ul-1 x2_limits.ul-1 x2_limits.ul-1 | shield-10 shield-10 shield-10 shield-10 shield-10
X1DIR-2 X1DIR-2 X1DIR-2 X1DIR-2 X1DIR-2 | 5V0-10 5V0-10 5V0-10 5V0-10 5V0-10 | X1LL-2 X1LL-2 X1LL-2 X1LL-2 X1LL-2 | 5V0-14 5V0-14 5V0-14 5V0-14 5V0-14 | X2STEP-2 X2STEP-2 X2STEP-2 X2STEP-2 X2STEP-2 | x2_limits.ul-2 x2_limits.ul-2 x2_limits.ul-2 x2_limits.ul-2 x2_limits.ul-2 | shield-11 shield-11 shield-11 shield-11 shield-11
5V0-7 5V0-7 5V0-7 5V0-7 5V0-7 | 5V-5 5V-5 5V-5 5V-5 5V-5 | 5V0-11 5V0-11 5V0-11 5V0-11 5V0-11 | X2DIR-1 X2DIR-1 X2DIR-1 X2DIR-1 X2DIR-1 | 5V0-17 5V0-17 5V0-17 5V0-17 5V0-17 | X2LL-1 X2LL-1 X2LL-1 X2LL-1 X2LL-1 | 5V0-21 5V0-21 5V0-21 5V0-21 5V0-21
5V0-8 5V0-8 5V0-8 5V0-8 5V0-8 | 5V-6 5V-6 5V-6 5V-6 5V-6 | 5V0-12 5V0-12 5V0-12 5V0-12 5V0-12 | X2DIR-2 X2DIR-2 X2DIR-2 X2DIR-2 X2DIR-2 | 5V0-18 5V0-18 5V0-18 5V0-18 5V0-18 | X2LL-2 X2LL-2 X2LL-2 X2LL-2 X2LL-2 | 5V0-22 5V0-22 5V0-22 5V0-22 5V0-22
X1STEP-1 X1STEP-1 X1STEP-1 X1STEP-1 X1STEP-1 | x1_limits.ul-1 x1_limits.ul-1 x1_limits.ul-1 x1_limits.ul-1 x1_limits.ul-1 | shield-8 shield-8 shield-8 shield-8 shield-8 | 5V0-15 5V0-15 5V0-15 5V0-15 5V0-15 | 5V-7 5V-7 5V-7 5V-7 5V-7 | 5V0-19 5V0-19 5V0-19 5V0-19 5V0-19 | RESET_SW-1 RESET_SW-1 RESET_SW-1 RESET_SW-1 RESET_SW-1
