dcowden/panelviz/wirelabel_terminals4.pdf

RESET_SW-2 RESET_SW-2 RESET_SW-2 RESET_SW-2 RESET_SW-2 | COIL+-4 COIL+-4 COIL+-4 COIL+-4 COIL+-4 | spindle.w-2 spindle.w-2 spindle.w-2 spindle.w-2 spindle.w-2 | estop_panel.light--1 estop_panel.light--1 estop_panel.light--1 estop_panel.light--1 estop_panel.light--1 | probe.probe+-1 probe.probe+-1 probe.probe+-1 probe.probe+-1 probe.probe+-1 | earth-12 earth-12 earth-12 earth-12 earth-12
24V-1 24V-1 24V-1 24V-1 24V-1 | spindle.u-1 spindle.u-1 spindle.u-1 spindle.u-1 spindle.u-1 | shield-12 shield-12 shield-12 shield-12 shield-12 | estop_panel.light--2 estop_panel.light--2 estop_panel.light--2 estop_panel.light--2 estop_panel.light--2 | probe.probe--1 probe.probe--1 probe.probe--1 probe.probe--1 probe.probe--1
24V-2 24V-2 24V-2 24V-2 24V-2 | spindle.u-2 spindle.u-2 spindle.u-2 spindle.u-2 spindle.u-2 | 5V-14 5V-14 5V-14 5V-14 5V-14
24V-3 24V-3 24V-3 24V-3 24V-3 | spindle.v-1 spindle.v-1 spindle.v-1 spindle.v-1 spindle.v-1 | 5V0-28 5V0-28 5V0-28 5V0-28 5V0-28
24V-4 24V-4 24V-4 24V-4 24V-4 | spindle.v-2 spindle.v-2 spindle.v-2 spindle.v-2 spindle.v-2 | 24V-8 24V-8 24V-8 24V-8 24V-8
COIL+-3 COIL+-3 COIL+-3 COIL+-3 COIL+-3 | spindle.w-1 spindle.w-1 spindle.w-1 spindle.w-1 spindle.w-1 | 24V0-4 24V0-4 24V0-4 24V0-4 24V0-4
