dcowden/panelviz/wirelabel_vfd.pdf

transformer.220L-1 transformer.220L-1 transformer.220L-1 transformer.220L-1 transformer.220L-1 | x1_motor.M+-2 x1_motor.M+-2 x1_motor.M+-2 x1_motor.M+-2 x1_motor.M+-2 | earth-1 earth-1 earth-1 earth-1 earth-1 | 110N-3 110N-3 110N-3 110N-3 110N-3 | 110L-5 110L-5 110L-5 110L-5 110L-5 | COIL--2 COIL--2 COIL--2 COIL--2 COIL--2 | earth-9 earth-9 earth-9 earth-9 earth-9
transformer.220N-1 transformer.220N-1 transformer.220N-1 transformer.220N-1 transformer.220N-1 | x1_motor.M--2 x1_motor.M--2 x1_motor.M--2 x1_motor.M--2 x1_motor.M--2 | 110L-1 110L-1 110L-1 110L-1 110L-1 | earth-2 earth-2 earth-2 earth-2 earth-2 | earth-6 earth-6 earth-6 earth-6 earth-6 | earth-8 earth-8 earth-8 earth-8 earth-8 | vfd.R-1 vfd.R-1 vfd.R-1 vfd.R-1 vfd.R-1
110L_SWITCHED-1 110L_SWITCHED-1 110L_SWITCHED-1 110L_SWITCHED-1 110L_SWITCHED-1 | x2_motor.M+-2 x2_motor.M+-2 x2_motor.M+-2 x2_motor.M+-2 x2_motor.M+-2 | 110N-1 110N-1 110N-1 110N-1 110N-1 | earth-3 earth-3 earth-3 earth-3 earth-3 | earth-7 earth-7 earth-7 earth-7 earth-7 | COIL+-4 COIL+-4 COIL+-4 COIL+-4 COIL+-4 | vfd.T-1 vfd.T-1 vfd.T-1 vfd.T-1 vfd.T-1
110N_SWITCHED-1 110N_SWITCHED-1 110N_SWITCHED-1 110N_SWITCHED-1 110N_SWITCHED-1 | x2_motor.M--2 x2_motor.M--2 x2_motor.M--2 x2_motor.M--2 x2_motor.M--2 | 110L-2 110L-2 110L-2 110L-2 110L-2 | 110N-4 110N-4 110N-4 110N-4 110N-4 | COIL+-1 COIL+-1 COIL+-1 COIL+-1 COIL+-1 | spindle.u-2 spindle.u-2 spindle.u-2 spindle.u-2 spindle.u-2 | VFD_FWD-1 VFD_FWD-1 VFD_FWD-1 VFD_FWD-1 VFD_FWD-1
110L_SWITCHED-2 110L_SWITCHED-2 110L_SWITCHED-2 110L_SWITCHED-2 110L_SWITCHED-2 | DRIVER_48V-1 DRIVER_48V-1 DRIVER_48V-1 DRIVER_48V-1 DRIVER_48V-1 | 110N-2 110N-2 110N-2 110N-2 110N-2 | 110L-4 110L-4 110L-4 110L-4 110L-4 | COIL+-2 COIL+-2 COIL+-2 COIL+-2 COIL+-2 | spindle.v-2 spindle.v-2 spindle.v-2 spindle.v-2 spindle.v-2 | VFD_REV-1 VFD_REV-1 VFD_REV-1 VFD_REV-1 VFD_REV-1
110N_SWITCHED-2 110N_SWITCHED-2 110N_SWITCHED-2 110N_SWITCHED-2 110N_SWITCHED-2 | DRIVER_GND-5 DRIVER_GND-5 DRIVER_GND-5 DRIVER_GND-5 DRIVER_GND-5 | 110L-3 110L-3 110L-3 110L-3 110L-3 | 110N-5 110N-5 110N-5 110N-5 110N-5 | COIL--1 COIL--1 COIL--1 COIL--1 COIL--1 | spindle.w-2 spindle.w-2 spindle.w-2 spindle.w-2 spindle.w-2 | COIL+-5 COIL+-5 COIL+-5 COIL+-5 COIL+-5
