dcowden/panelviz/wirelabel_vfd2.pdf

110L_SWITCHED-3 110L_SWITCHED-3 110L_SWITCHED-3 110L_SWITCHED-3 110L_SWITCHED-3 | DRIVER_48V-2 DRIVER_48V-2 DRIVER_48V-2 DRIVER_48V-2 DRIVER_48V-2 | COIL--3 COIL--3 COIL--3 COIL--3 COIL--3
110N_SWITCHED-3 110N_SWITCHED-3 110N_SWITCHED-3 110N_SWITCHED-3 110N_SWITCHED-3 | DRIVER_GND-6 DRIVER_GND-6 DRIVER_GND-6 DRIVER_GND-6 DRIVER_GND-6 | VFD_V1-1 VFD_V1-1 VFD_V1-1 VFD_V1-1 VFD_V1-1
110L_SWITCHED-4 110L_SWITCHED-4 110L_SWITCHED-4 110L_SWITCHED-4 110L_SWITCHED-4 | | COIL--4 COIL--4 COIL--4 COIL--4 COIL--4

110N_SWITCHED-4 110N_SWITCHED-4 110N_SWITCHED-4 110N_SWITCHED-4 110N_SWITCHED-4
