dcowden/panelviz/prod_machine/mycnc_wire_list.pdf

WIRE LIST

# PanelViz Wiring Sc?

FILE

### mycnc.yml

PRINTED
2026-10-29

### PAGE 1 OF 7

Wire count: 275 | Component count: 64
Wire | From | Pin | To | Pin | Net | AWG | Tags | From Ref | To Ref
110L/4 | wall_plug | 1 | wall_power_t | 1A | 110L | 12 | vfd | Y13 | Y14
110L/8 | wall_power_t | 1B | power_switch | L_IN | 110L | 12 | vfd | X14 | X13
110L/6 | power_switch | L_OUT | breaker | L_IN | 110L | 12 | vfd | W13 | V12
110L/7 | breaker | L_OUT | live_power_t | 1A | 110L | 12 | vfd | V12 | O11
110L/5 | live_power_t | 1B | transformer | 110L | 110L | 20 | vfd | N11 | V8
110L/2 | live_power_t | 3A | contactor_110 | T2 | 110L | 20 | vfd | O11 | L9
110L/1 | 24v | 110L | live_power_t | 3B | 110L | 20 | dc_power, vfd | L11 | N11
110L/3 | 5v | 110L | live_power_t | 5A | 110L | 20 | dc_power, vfd | L12 | O12
110L_SWITCHED/1 | contactor_110 | L2 | switched_110L | 1A | 110L_SWITCHED | 20 | vfd | J9 | N10
110L_SWITCHED/2 | 48v | 110L | switched_110L | 1B | 110L_SWITCHED | 20 | vfd | Q14 | O10
110L_SWITCHED/3 | 36V_X1 | 110L | switched_110L | 2A | 110L_SWITCHED | 20 | vfd | Q5 | N10
110L_SWITCHED/4 | 36V_X2 | 110L | switched_110L | 2B | 110L_SWITCHED | 20 | vfd | Q9 | O10
110N/4 | wall_plug | 2 | live_power_t | 2A | 110N | 12 | vfd | Y13 | O11
110N/5 | live_power_t | 2B | transformer | 110N | 110N | 20 | vfd | N11 | V8
110N/2 | live_power_t | 4A | contactor_110 | T3 | 110N | 20 | vfd | O11 | L9
110N/1 | 24v | 110N | live_power_t | 4B | 110N | 20 | dc_power, vfd | L11 | N11
110N/3 | 5v | 110N | live_power_t | 6A | 110N | 20 | dc_power, vfd | L13 | O12
110N_SWITCHED/1 | contactor_110 | L3 | switched_110N | 1A | 110N_SWITCHED | 20 | vfd | J9 | N11
110N_SWITCHED/2 | 36V_X1 | 110N | switched_110N | 1B | 110N_SWITCHED | 20 | vfd | Q5 | O11
110N_SWITCHED/3 | 36V_X2 | 110N | switched_110N | 2A | 110N_SWITCHED | 20 | vfd | Q9 | N11
110N_SWITCHED/4 | 48v | 110N | switched_110N | 2B | 110N_SWITCHED | 20 | vfd | Q13 | O11
24V/15 | z_limits | 24v | cnc_terminals | 11A | 24V | 20 | terminals | A12 | C12
24V/16 | cnc_terminals | 11B | terminals_24v | 1A | 24V | 20 | terminals | D12 | B16
24V/17 | y_limits | 24v | cnc_terminals | 25A | 24V | 20 | terminals | B11 | C11
24V/18 | cnc_terminals | 25B | terminals_24v | 1B | 24V | 20 | terminals | D11 | C16
24V/19 | x1_limits | 24v | cnc_terminals | 37A | 24V | 20 | terminals | A9 | C10
24V/20 | cnc_terminals | 37B | terminals_24v | 2A | 24V | 20 | terminals | D10 | B15
24V/21 | x2_limits | 24v | cnc_terminals | 49A | 24V | 20 | terminals | A8 | C9
24V/22 | cnc_terminals | 49B | terminals_24v | 2B | 24V | 20 | terminals | D9 | C15
24V/1 | estop_panel | estop+ | cnc_terminals | 57A | 24V | 20 | terminals | B6 | C8
24V/2 | cnc_terminals | 57B | terminals_24v | 3A | 24V | 20 | terminals | D8 | B15
24V/3 | estop_panel | light+ | cnc_terminals | 59A | 24V | 20 | terminals | B6 | C8
24V/4 | cnc_terminals | 59B | terminals_24v | 3B | 24V | 20 | terminals | D8 | C15
24V/14 | 24v | 24V | dc_power_24v | 1A | 24V | 20 | dc_power | L12 | L15
24V/13 | dc_power_24v | 1B | safety_24v | 1A | 24V | 20 | dc_power, safe? | K15 | I16
24V/12 | safety_24v | 1B | control_24v | 1A | 24V | 20 | safety, control | H16 | D17
24V/5 | control_24v | 1B | terminals_24v | 4A | 24V | 20 | control, termi? | E17 | B15
24V/6 | control_24v | 2A | axbb-e | I1+ | 24V | 20 | control | D17 | D13
24V/7 | control_24v | 2B | axbb-e | I2+ | 24V | 20 | control | E17 | D13
24V/8 | control_24v | 3A | axbb-e | I3+ | 24V | 20 | control | D17 | D12
24V/9 | control_24v | 3B | axbb-e | I4+ | 24V | 20 | control | E17 | D12
24V/10 | control_24v | 4A | axbb-e | I5+ | 24V | 20 | control | D17 | D12

### PAGE 2 OF 7

Wire | From | Pin | To | Pin | Net | AWG | Tags | From Ref | To Ref
24V/11 | axbb-e | IN-24V+ | control_24v | 4B | 24V | 20 | control | F13 | E17
24V/27 | opto_board | 1+ | safety_24v | 4A | 24V | 20 | safety | G11 | I16
24V/28 | opto_board | 2+ | safety_24v | 4B | 24V | 20 | safety | G11 | H16
24V/29 | opto_board | 3+ | safety_24v | 5A | 24V | 20 | safety | G11 | I16
24V/30 | opto_board | 4+ | safety_24v | 5B | 24V | 20 | safety | G11 | H16
24V/23 | opto_board | 5+ | safety_24v | 2A | 24V | 20 | safety | G11 | I16
24V/24 | opto_board | 6+ | safety_24v | 2B | 24V | 20 | safety | G10 | H16
24V/25 | opto_board | 7+ | safety_24v | 3A | 24V | 20 | safety | G10 | I16
24V/26 | opto_board | 8+ | safety_24v | 3B | 24V | 20 | safety | G10 | H16
24V/31 | dc_power_24v | 2A | alarm_limit_board | 24V | 24V | 20 | dc_power, safe? | L15 | I14
24V0/8 | z_limits | 24v0 | cnc_terminals | 14A | 24V0 | 20 | terminals | A12 | C12
24V0/9 | cnc_terminals | 14B | terminals_24v0 | 1A | 24V0 | 20 | terminals | D12 | B16
24V0/10 | y_limits | 24v0 | cnc_terminals | 28A | 24V0 | 20 | terminals | B11 | C10
24V0/11 | cnc_terminals | 28B | terminals_24v0 | 1B | 24V0 | 20 | terminals | D10 | C16
24V0/21 | x1_control | alrm- | cnc_terminals | 32A | 24V0 | 20 | terminals | A9 | C10
24V0/22 | cnc_terminals | 32B | terminals_24v0 | 4A | 24V0 | 20 | terminals | D10 | B16
24V0/12 | x1_limits | 24v0 | cnc_terminals | 40A | 24V0 | 20 | terminals | A9 | C9
24V0/13 | cnc_terminals | 40B | terminals_24v0 | 2A | 24V0 | 20 | terminals | D9 | B16
24V0/23 | x2_control | alrm- | cnc_terminals | 44A | 24V0 | 20 | terminals | A8 | C9
24V0/24 | cnc_terminals | 44B | terminals_24v0 | 4B | 24V0 | 20 | terminals | D9 | C16
24V0/14 | x2_limits | 24v0 | cnc_terminals | 52A | 24V0 | 20 | terminals | A8 | C8
24V0/15 | cnc_terminals | 52B | terminals_24v0 | 2B | 24V0 | 20 | terminals | D8 | C16
24V0/7 | 24v | 24V0 | dc_power_24v0 | 1A | 24V0 | 20 | dc_power | L11 | L16
24V0/6 | dc_power_24v0 | 1B | safety_24v0 | 1A | 24V0 | 20 | dc_power, safe? | K16 | H16
24V0/3 | safety_24v0 | 1B | control_24v0 | 1A | 24V0 | 20 | safety, control | I16 | D17
24V0/25 | y_cl57s | COM- | control_24v0 | 2B | 24V0 | 20 | control | E3 | E17
24V0/26 | Z_cl57s | COM- | control_24v0 | 3A | 24V0 | 20 | control | E8 | D17
24V0/2 | axbb-e | IN-24V0 | control_24v0 | 1B | 24V0 | 20 | control | F13 | E17
24V0/4 | run_relay | COM | safety_24v0 | 2A | 24V0 | 20 | safety | I9 | H16
24V0/5 | upper_limits_ok_relay | COM | safety_24v0 | 2B | 24V0 | 20 | safety | I8 | I16
24V0/20 | control_24v0 | 2A | terminals_24v0 | 3A | 24V0 | 20 | control, termi? | D17 | B16
24V0/27 | dc_power_24v0 | 2A | vfd | DCM | 24V0 | 20 | dc_power, vfd | L16 | O17
36V0_X1/3 | 36V_X1 | 36V0_X1 | driver_power | 2A | 36V0_X1 | 20 | vfd | Q5 | O13
36V0_X1/1 | x1_motor | M- | cnc_terminals | 30A | 36V0_X1 | 16 | terminals | B9 | C10
36V0_X1/2 | cnc_terminals | 30B | driver_power | 2B | 36V0_X1 | 16 | terminals, vfd | D10 | N13
36V0_X2/3 | 36V_X2 | 36V0_X2 | driver_power | 4A | 36V0_X2 | 20 | vfd | Q9 | O13
36V0_X2/1 | x2_motor | M- | cnc_terminals | 42A | 36V0_X2 | 16 | terminals | B8 | C9
36V0_X2/2 | cnc_terminals | 42B | driver_power | 4B | 36V0_X2 | 16 | terminals, vfd | D9 | N13
36V_X1/3 | 36V_X1 | 36V_X1 | driver_power | 1A | 36V_X1 | 20 | vfd | Q5 | O13
36V_X1/1 | x1_motor | M+ | cnc_terminals | 29A | 36V_X1 | 16 | terminals | B9 | C10
36V_X1/2 | cnc_terminals | 29B | driver_power | 1B | 36V_X1 | 16 | terminals, vfd | D10 | N13
36V_X2/3 | 36V_X2 | 36V_X2 | driver_power | 3A | 36V_X2 | 20 | vfd | Q9 | O13
36V_X2/1 | x2_motor | M+ | cnc_terminals | 41A | 36V_X2 | 16 | terminals | B8 | C9
36V_X2/2 | cnc_terminals | 41B | driver_power | 3B | 36V_X2 | 16 | terminals, vfd | D9 | N13
5V/17 | run_relay | DC+ | safety_5v | 1A | 5V | 20 | safety | H9 | H15

### PAGE 3 OF 7

Wire | From | Pin | To | Pin | Net | AWG | Tags | From Ref | To Ref
5V/18 | upper_limits_ok_relay | DC+ | safety_5v | 1B | 5V | 20 | safety | H7 | I15
5V/20 | 5v | 5V | dc_power_5v | 1A | 5V | 20 | dc_power | L13 | L14
5V/19 | dc_power_5v | 1B | safety_5v | 2A | 5V | 20 | dc_power, safe? | K14 | H15
5V/11 | safety_5v | 2B | control_5v | 1A | 5V | 20 | safety, control | I15 | D15
5V/9 | control_5v | 1B | terminals_5v | 1A | 5V | 20 | control, termi? | E15 | B14
5V/10 | axbb-e | IN-5V+ | control_5v | 2A | 5V | 20 | control | F13 | D15
5V/16 | alarm_limit_board | 5V | safety_5v | 3A | 5V | 20 | safety | I13 | H14
5V/21 | opto_board | VCC | safety_5v | 5B | 5V | 20 | safety | I11 | I14
5V/22 | control_5v | 2B | cnc_terminals | 67A | 5V | 20 | control, termi? | E15 | C7
5V/23 | cnc_terminals | 67B | field_box | 5V | 5V | 20 | terminals | D7 | B4
5V0/7 | x1_control | dir- | cnc_terminals | 34A | 5V0 | 20 | terminals | A9 | C10
5V0/8 | cnc_terminals | 34B | terminals_5v0 | 1A | 5V0 | 20 | terminals | D10 | C14
5V0/9 | x1_control | pul- | cnc_terminals | 36A | 5V0 | 20 | terminals | A9 | C10
5V0/10 | cnc_terminals | 36B | terminals_5v0 | 1B | 5V0 | 20 | terminals | D10 | B14
5V0/15 | x2_control | dir- | cnc_terminals | 46A | 5V0 | 20 | terminals | A8 | C9
5V0/16 | cnc_terminals | 46B | terminals_5v0 | 2A | 5V0 | 20 | terminals | D9 | C15
5V0/17 | x2_control | pul- | cnc_terminals | 48A | 5V0 | 20 | terminals | A8 | C9
5V0/18 | cnc_terminals | 48B | terminals_5v0 | 2B | 5V0 | 20 | terminals | D9 | B15
5V0/21 | estop_panel | reset_sw+ | cnc_terminals | 55A | 5V0 | 20 | terminals | B6 | C8
5V0/22 | cnc_terminals | 55B | terminals_5v0 | 3A | 5V0 | 20 | terminals | D8 | C15
5V0/37 | run_relay | DC- | safety_5v0 | 1A | 5V0 | 20 | safety | H9 | H15
5V0/38 | upper_limits_ok_relay | DC- | safety_5v0 | 1B | 5V0 | 20 | safety | H8 | I15
5V0/40 | 5v | 5V0 | dc_power_5v0 | 1A | 5V0 | 20 | dc_power | L13 | L15
5V0/39 | dc_power_5v0 | 1B | safety_5v0 | 2A | 5V0 | 20 | dc_power, safe? | K15 | H15
5V0/31 | safety_5v0 | 2B | control_5v0 | 1A | 5V0 | 20 | safety, control | I15 | D16
5V0/23 | control_5v0 | 1B | terminals_5v0 | 3B | 5V0 | 20 | control, termi? | E16 | B15
5V0/28 | y_cl57s | PUL- | control_5v0 | 2A | 5V0 | 20 | control | E3 | D16
5V0/29 | y_cl57s | DIR- | control_5v0 | 2B | 5V0 | 20 | control | E3 | E16
5V0/24 | Z_cl57s | PUL- | control_5v0 | 3A | 5V0 | 20 | control | E7 | D16
5V0/25 | Z_cl57s | DIR- | control_5v0 | 3B | 5V0 | 20 | control | E8 | E16
5V0/27 | axbb-e | IN-5V0 | control_5v0 | 4A | 5V0 | 20 | control | F13 | D16
5V0/36 | alarm_limit_board | 5V0 | safety_5v0 | 3A | 5V0 | 20 | safety | I13 | H15
5V0/41 | opto_board | GND | safety_5v0 | 5B | 5V0 | 20 | safety | I11 | I15
5V0/42 | dc_power_5v0 | 2A | vfd | ACM | 5V0 | 20 | dc_power, vfd | L15 | O17
5V0/43 | control_5v0 | 4B | cnc_terminals | 68A | 5V0 | 20 | control, termi? | E16 | C7
5V0/44 | cnc_terminals | 68B | field_box | 5V0 | 5V0 | 20 | terminals | D7 | B4
ATC/1 | axbb-e | 12 | cnc_terminals | 69A | ATC | 20 | control, termi? | F11 | C7
ATC/2 | cnc_terminals | 69B | field_box | ATC | ATC | 20 | terminals | D7 | B4
CHARGE_PUMP/1 | axbb-e | O1 | alarm_limit_board | CPUMP | CHARGE_PUMP | 20 | control, safety | D13 | I14
COIL-/4 | contactor_110 | A2 | coil_t | 3A | COIL- | 20 | vfd | L10 | L7
COIL-/3 | contactor_220 | A2 | coil_t | 3B | COIL- | 20 | vfd | L8 | K7
COIL-/1 | axbb-e | I6- | coil_t | 4A | COIL- | 20 | control, vfd | D12 | L7
COIL-/2 | run_relay | NO | coil_t | 4B | COIL- | 20 | safety, vfd | I9 | K7
DRIVER_48V/3 | 48v | 48V | driver_power | 5A | DRIVER_48V | 20 | vfd | Q13 | O14
DRIVER_48V/2 | y_cl57s | +VDC | driver_power | 5B | DRIVER_48V | 20 | control, vfd | E4 | N14

### PAGE 4 OF 7

Wire | From | Pin | To | Pin | Net | AWG | Tags | From Ref | To Ref
DRIVER_48V/1 | Z_cl57s | +VDC | driver_power | 6A | DRIVER_48V | 20 | control, vfd | E9 | O14
DRIVER_GND/7 | 48v | 48V0 | driver_power | 7A | DRIVER_GND | 20 | vfd | Q13 | O14
DRIVER_GND/6 | y_cl57s | GND | driver_power | 7B | DRIVER_GND | 20 | control, vfd | E4 | N14
DRIVER_GND/5 | Z_cl57s | GND | driver_power | 8A | DRIVER_GND | 20 | control, vfd | E9 | O14
PROBE1/1 | axbb-e | 10 | cnc_terminals | 71A | PROBE1 | 20 | control, termi? | F11 | C7
PROBE1/2 | cnc_terminals | 71B | field_box | PROBE1 | PROBE1 | 20 | terminals | D7 | B4
PROBE2/1 | axbb-e | 11 | cnc_terminals | 72A | PROBE2 | 20 | control, termi? | F11 | C7
PROBE2/2 | cnc_terminals | 72B | field_box | PROBE2 | PROBE2 | 20 | terminals | D7 | B4
RESET_SW/1 | estop_panel | reset_sw- | cnc_terminals | 56A | RESET_SW | 20 | terminals | B6 | C8
RESET_SW/2 | cnc_terminals | 56B | alarm_limit_board | D12 | RESET_SW | 20 | terminals, saf? | D8 | I12
RUN_RELAY_CTL/1 | alarm_limit_board | D10 | run_relay | IN | RUN_RELAY_CTL | 20 | safety | I12 | H9
UL1/1 | upper_limits_ok_relay | NC | axbb-e | I1- | UL1 | 20 | safety, control | I8 | D13
UPPER_LIMITS_OK_R?alarm_limit_board | | D11 | upper_limits_ok_relay | IN | UPPER_LIMITS_OK_REL?20 | | safety | I12 | H8
VAC/1 | axbb-e | 4 | cnc_terminals | 70A | VAC | 20 | control, termi? | E11 | C7
VAC/2 | cnc_terminals | 70B | field_box | VAC | VAC | 20 | terminals | D7 | B4
VFD_FWD/1 | axbb-e | O3 | vfd | FOR | VFD_FWD | 20 | control, vfd | D13 | O17
VFD_REV/1 | axbb-e | O2 | vfd | REV | VFD_REV | 20 | control, vfd | D13 | O17
VFD_V1/1 | axbb-e | A01 | vfd | VI | VFD_V1 | 20 | control, vfd | F13 | P20
X1DIR/1 | x1_control | dir+ | cnc_terminals | 33A | X1DIR | 20 | terminals | A9 | C10
X1DIR/2 | cnc_terminals | 33B | axbb-e | O12 | X1DIR | 20 | terminals, con? | D10 | F12
X1LL/1 | x1_limits | ll | cnc_terminals | 39A | X1LL | 20 | terminals | A9 | C10
X1LL/2 | cnc_terminals | 39B | axbb-e | I3- | X1LL | 20 | terminals, con? | D10 | D12
X1STEP/1 | x1_control | pul+ | cnc_terminals | 35A | X1STEP | 20 | terminals | A9 | C10
X1STEP/2 | cnc_terminals | 35B | axbb-e | O11 | X1STEP | 20 | terminals, con? | D10 | F12
X1UL_OK/1 | alarm_limit_board | D2 | opto_board | O1 | X1UL_OK | 20 | safety | I13 | I11
X1_ALM_OK/1 | alarm_limit_board | D6 | opto_board | O5 | X1_ALM_OK | 20 | safety | I13 | I10
X2DIR/1 | x2_control | dir+ | cnc_terminals | 45A | X2DIR | 20 | terminals | A8 | C9
X2DIR/2 | cnc_terminals | 45B | axbb-e | O14 | X2DIR | 20 | terminals, con? | D9 | F12
X2LL/1 | x2_limits | ll | cnc_terminals | 51A | X2LL | 20 | terminals | A8 | C9
X2LL/2 | cnc_terminals | 51B | axbb-e | I4- | X2LL | 20 | terminals, con? | D9 | D12
X2STEP/1 | x2_control | pul+ | cnc_terminals | 47A | X2STEP | 20 | terminals | A8 | C9
X2STEP/2 | cnc_terminals | 47B | axbb-e | O13 | X2STEP | 20 | terminals, con? | D9 | F12
X2UL_OK/1 | alarm_limit_board | D3 | opto_board | O2 | X2UL_OK | 20 | safety | I13 | I11
X2_ALM_OK/1 | alarm_limit_board | D7 | opto_board | O6 | X2_ALM_OK | 20 | safety | I13 | I10
YDIR/1 | y_cl57s | DIR+ | axbb-e | O10 | YDIR | 20 | control | E3 | F12
YLL/1 | y_limits | ll | cnc_terminals | 27A | YLL | 20 | terminals | B11 | C11
YLL/2 | cnc_terminals | 27B | axbb-e | I2- | YLL | 20 | terminals, con? | D11 | D13
YSTEP/1 | y_cl57s | PUL+ | axbb-e | O9 | YSTEP | 20 | control | E3 | F12
YUL_OK/1 | alarm_limit_board | D4 | opto_board | O3 | YUL_OK | 20 | safety | I13 | I11
Y_ALM_OK/1 | alarm_limit_board | D8 | opto_board | O7 | Y_ALM_OK | 20 | safety | I13 | I10
ZDIR/1 | Z_cl57s | DIR+ | axbb-e | O16 | ZDIR | 20 | control | E7 | F13
ZLL/1 | z_limits | ll | cnc_terminals | 13A | ZLL | 20 | terminals | A12 | C12
ZLL/2 | cnc_terminals | 13B | axbb-e | I5- | ZLL | 20 | terminals, con? | D12 | D12
ZSTEP/1 | Z_cl57s | PUL+ | axbb-e | O15 | ZSTEP | 20 | control | E7 | F12
ZUL_OK/1 | alarm_limit_board | D5 | opto_board | O4 | ZUL_OK | 20 | safety | I13 | I11

### PAGE 5 OF 7

Wire | From | Pin | To | Pin | Net | AWG | Tags | From Ref | To Ref
Z_ALM_OK/1 | alarm_limit_board | D9 | opto_board | O8 | Z_ALM_OK | 20 | safety | I13 | I10
Z_cl57s.ALM/1 | Z_cl57s | ALM | opto_board | 8- | Z_cl57s.ALM | 20 | control, safety | E8 | G10
earth/8 | wall_plug | GND | vfd_earth | 1A | earth | 12 | vfd | Y13 | N14
earth/9 | transformer | GND | vfd_earth | 1B | earth | 20 | vfd | V8 | O14
earth/10 | 48v | GND | vfd_earth | 2A | earth | 20 | vfd | Q14 | N14
earth/4 | 24v | GND | dc_power_earth | 1A | earth | 20 | dc_power | L11 | K16
earth/5 | 5v | GND | dc_power_earth | 1B | earth | 20 | dc_power | L12 | L16
earth/11 | 36V_X1 | GND | vfd_earth | 2B | earth | 20 | vfd | Q6 | O14
earth/12 | 36V_X2 | GND | vfd_earth | 3A | earth | 20 | vfd | Q10 | N14
earth/7 | vfd | GND | vfd_earth | 3B | earth | 20 | vfd | O23 | O14
earth/6 | vfd_earth | 4A | dc_power_earth | 2A | earth | 20 | vfd, dc_power | N14 | K16
earth/3 | dc_power_earth | 2B | safety_earth | 1A | earth | 20 | dc_power, safe? | L16 | H17
earth/2 | safety_earth | 1B | control_earth | 1A | earth | 20 | safety, control | I17 | D18
earth/1 | control_earth | 1B | terminals_earth | 1A | earth | 20 | control, termi? | E18 | B14
estop_panel.estop? | estop_panel | estop- | cnc_terminals | 58A | estop_panel.estop- | 20 | terminals | B6 | C8
estop_panel.estop? | cnc_terminals | 58B | cnc_terminals | 61B | estop_panel.estop- | 20 | terminals | D8 | D8
secondary_estop.e? | secondary_estop | estop+ | cnc_terminals | 61A | estop_panel.estop- | 20 | terminals | A6 | C8
estop_panel.light? | estop_panel | light- | cnc_terminals | 60A | estop_panel.light- | 20 | terminals | B6 | C8
estop_panel.light? | cnc_terminals | 60B | run_relay | NC | estop_panel.light- | 20 | terminals, saf? | D8 | I9
COIL+/5 | contactor_110 | A1 | coil_t | 1A | secondary_estop.est? | 20 | vfd | J10 | L7
COIL+/4 | contactor_220 | A1 | coil_t | 1B | secondary_estop.est? | 20 | vfd | J8 | K7
secondary_estop.e? | secondary_estop | estop- | cnc_terminals | 62A | secondary_estop.est? | 20 | terminals | A6 | C8
COIL+/1 | cnc_terminals | 62B | coil_t | 2A | secondary_estop.est? | 20 | terminals, vfd | D8 | L7
COIL+/3 | axbb-e | I6+ | coil_t | 2B | secondary_estop.est? | 20 | control, vfd | D12 | K7
shield/2 | z_motor | shield | connector_earth | 1A | shield | 20 | terminals | B12 | B18
shield/8 | z_control | shield | connector_earth | 1B | shield | 20 | terminals | A12 | C18
shield/12 | z_limits | shield | connector_earth | 2A | shield | 20 | terminals | A12 | B18
shield/1 | y_motor | shield | connector_earth | 2B | shield | 20 | terminals | A11 | C18
shield/6 | y_control | shield | connector_earth | 3A | shield | 20 | terminals | A11 | B18
shield/11 | y_limits | shield | connector_earth | 3B | shield | 20 | terminals | B11 | C18
shield/3 | x1_motor | shield | connector_earth | 4A | shield | 20 | terminals | B9 | B17
shield/10 | x1_limits | shield | connector_earth | 4B | shield | 20 | terminals | A9 | C17
shield/5 | x2_motor | shield | connector_earth | 5A | shield | 20 | terminals | B8 | B17
shield/9 | x2_limits | shield | connector_earth | 5B | shield | 20 | terminals | A8 | C17
shield/4 | spindle | shield | connector_earth | 6B | shield | 20 | terminals | A6 | C17
spindle.u/1 | spindle | u | cnc_terminals | 63A | spindle.u | 16 | terminals | A6 | C8
spindle.u/2 | cnc_terminals | 63B | vfd | U | spindle.u | 16 | terminals, vfd | D8 | O23
spindle.v/1 | spindle | v | cnc_terminals | 64A | spindle.v | 16 | terminals | A6 | C7
spindle.v/2 | cnc_terminals | 64B | vfd | V | spindle.v | 16 | terminals, vfd | D7 | O23
spindle.w/1 | spindle | w | cnc_terminals | 65A | spindle.w | 16 | terminals | A6 | C7
spindle.w/2 | cnc_terminals | 65B | vfd | W | spindle.w | 16 | terminals, vfd | D7 | O23
transformer.220L/1 | transformer | 220L | contactor_220 | T1 | transformer.220L | 20 | vfd | V8 | L7
transformer.220N/1 | transformer | 220N | contactor_220 | T2 | transformer.220N | 20 | vfd | V8 | L8
vfd.R/1 | vfd | R | contactor_220 | L1 | vfd.R | 20 | vfd | O23 | J7
vfd.T/1 | vfd | T | contactor_220 | L2 | vfd.T | 20 | vfd | O23 | J8

### PAGE 6 OF 7

Wire | From | Pin | To | Pin | Net | AWG | Tags | From Ref | To Ref
x1_control.alrm+/1 | x1_control | alrm+ | cnc_terminals | 31A | x1_control.alrm+ | 20 | terminals | A9 | C10
x1_control.alrm+/2 | cnc_terminals | 31B | opto_board | 5- | x1_control.alrm+ | 20 | terminals, saf? | D10 | G10
x1_limits.ul/1 | x1_limits | ul | cnc_terminals | 38A | x1_limits.ul | 20 | terminals | A9 | C10
x1_limits.ul/2 | cnc_terminals | 38B | opto_board | 1- | x1_limits.ul | 20 | terminals, saf? | D10 | G11
x2_control.alrm+/1 | x2_control | alrm+ | cnc_terminals | 43A | x2_control.alrm+ | 20 | terminals | A8 | C9
x2_control.alrm+/2 | cnc_terminals | 43B | opto_board | 6- | x2_control.alrm+ | 20 | terminals, saf? | D9 | G10
x2_limits.ul/1 | x2_limits | ul | cnc_terminals | 50A | x2_limits.ul | 20 | terminals | A8 | C9
x2_limits.ul/2 | cnc_terminals | 50B | opto_board | 2- | x2_limits.ul | 20 | terminals, saf? | D9 | G11
y_cl57s.ALM/1 | y_cl57s | ALM | opto_board | 7- | y_cl57s.ALM | 20 | control, safety | E3 | G10
y_control.ea+/1 | y_control | ea+ | cnc_terminals | 21A | y_control.ea+ | 20 | terminals | A11 | C11
y_control.ea+/2 | cnc_terminals | 21B | y_cl57s | EA+ | y_control.ea+ | 20 | terminals, con? | D11 | E4
y_control.ea-/1 | y_control | ea- | cnc_terminals | 22A | y_control.ea- | 20 | terminals | A11 | C11
y_control.ea-/2 | cnc_terminals | 22B | y_cl57s | EA- | y_control.ea- | 20 | terminals, con? | D11 | E4
y_control.eb+/1 | y_control | eb+ | cnc_terminals | 19A | y_control.eb+ | 20 | terminals | A11 | C11
y_control.eb+/2 | cnc_terminals | 19B | y_cl57s | EB+ | y_control.eb+ | 20 | terminals, con? | D11 | E4
y_control.eb-/1 | y_control | eb- | cnc_terminals | 20A | y_control.eb- | 20 | terminals | A11 | C11
y_control.eb-/2 | cnc_terminals | 20B | y_cl57s | EB- | y_control.eb- | 20 | terminals, con? | D11 | E4
y_control.gnd/1 | y_control | gnd | cnc_terminals | 24A | y_control.gnd | 20 | terminals | A11 | C11
y_control.gnd/2 | cnc_terminals | 24B | y_cl57s | EGND | y_control.gnd | 20 | terminals, con? | D11 | E4
y_control.vcc/1 | y_control | vcc | cnc_terminals | 23A | y_control.vcc | 20 | terminals | A11 | C11
y_control.vcc/2 | cnc_terminals | 23B | y_cl57s | VCC | y_control.vcc | 20 | terminals, con? | D11 | E4
y_limits.ul/1 | y_limits | ul | cnc_terminals | 26A | y_limits.ul | 20 | terminals | B11 | C11
y_limits.ul/2 | cnc_terminals | 26B | opto_board | 3- | y_limits.ul | 20 | terminals, saf? | D11 | G11
y_motor.ma+/1 | y_motor | ma+ | cnc_terminals | 15A | y_motor.ma+ | 16 | terminals | A11 | C12
y_motor.ma+/2 | cnc_terminals | 15B | y_cl57s | A+ | y_motor.ma+ | 16 | terminals, con? | D12 | E4
y_motor.ma-/1 | y_motor | ma- | cnc_terminals | 16A | y_motor.ma- | 16 | terminals | A11 | C11
y_motor.ma-/2 | cnc_terminals | 16B | y_cl57s | A- | y_motor.ma- | 16 | terminals, con? | D11 | E4
y_motor.mb+/1 | y_motor | mb+ | cnc_terminals | 17A | y_motor.mb+ | 16 | terminals | A11 | C11
y_motor.mb+/2 | cnc_terminals | 17B | y_cl57s | B+ | y_motor.mb+ | 16 | terminals, con? | D11 | E4
y_motor.mb-/1 | y_motor | mb- | cnc_terminals | 18A | y_motor.mb- | 16 | terminals | A11 | C11
y_motor.mb-/2 | cnc_terminals | 18B | y_cl57s | B- | y_motor.mb- | 16 | terminals, con? | D11 | E4
z_control.ea+/1 | z_control | ea+ | cnc_terminals | 7A | z_control.ea+ | 20 | terminals | A12 | C12
z_control.ea+/2 | cnc_terminals | 7B | Z_cl57s | EA+ | z_control.ea+ | 20 | terminals, con? | D12 | E8
z_control.ea-/1 | z_control | ea- | cnc_terminals | 8A | z_control.ea- | 20 | terminals | A12 | C12
z_control.ea-/2 | cnc_terminals | 8B | Z_cl57s | EA- | z_control.ea- | 20 | terminals, con? | D12 | E8
z_control.eb+/1 | z_control | eb+ | cnc_terminals | 5A | z_control.eb+ | 20 | terminals | A12 | C12
z_control.eb+/2 | cnc_terminals | 5B | Z_cl57s | EB+ | z_control.eb+ | 20 | terminals, con? | D12 | E8
z_control.eb-/1 | z_control | eb- | cnc_terminals | 6A | z_control.eb- | 20 | terminals | A12 | C12
z_control.eb-/2 | cnc_terminals | 6B | Z_cl57s | EB- | z_control.eb- | 20 | terminals, con? | D12 | E8
z_control.gnd/1 | z_control | gnd | cnc_terminals | 10A | z_control.gnd | 20 | terminals | A12 | C12
z_control.gnd/2 | cnc_terminals | 10B | Z_cl57s | EGND | z_control.gnd | 20 | terminals, con? | D12 | E8
z_control.vcc/1 | z_control | vcc | cnc_terminals | 9A | z_control.vcc | 20 | terminals | A12 | C12
z_control.vcc/2 | cnc_terminals | 9B | Z_cl57s | VCC | z_control.vcc | 20 | terminals, con? | D12 | E8
z_limits.ul/1 | z_limits | ul | cnc_terminals | 12A | z_limits.ul | 20 | terminals | A12 | C12
z_limits.ul/2 | cnc_terminals | 12B | opto_board | 4- | z_limits.ul | 20 | terminals, saf? | D12 | G11

### PAGE 7 OF 7

Wire | From | Pin | To | Pin | Net | AWG | Tags | From Ref | To Ref
z_motor.ma+/1 | z_motor | ma+ | cnc_terminals | 1A | z_motor.ma+ | 16 | terminals | B12 | C13
z_motor.ma+/2 | cnc_terminals | 1B | Z_cl57s | A+ | z_motor.ma+ | 16 | terminals, con? | D13 | E9
z_motor.ma-/1 | z_motor | ma- | cnc_terminals | 2A | z_motor.ma- | 16 | terminals | B12 | C13
z_motor.ma-/2 | cnc_terminals | 2B | Z_cl57s | A- | z_motor.ma- | 16 | terminals, con? | D13 | E9
z_motor.mb+/1 | z_motor | mb+ | cnc_terminals | 3A | z_motor.mb+ | 16 | terminals | B12 | C13
z_motor.mb+/2 | cnc_terminals | 3B | Z_cl57s | B+ | z_motor.mb+ | 16 | terminals, con? | D13 | E9
z_motor.mb-/1 | z_motor | mb- | cnc_terminals | 4A | z_motor.mb- | 16 | terminals | B12 | C12
z_motor.mb-/2 | cnc_terminals | 4B | Z_cl57s | B- | z_motor.mb- | 16 | terminals, con? | D12 | E9
