dcowden/panelviz/output/pdf/axbb_e_opto_board_labels.pdf

PANEL COMPONENT OVERLAYS - PRINT AT 100% | CUT SOLID | FOLD BLUE DASHED

### AXBB-E - 3.3 IN FACE + 2 x 0.5 IN FOLDS FOLD DOWN ⁻ SHELL / TERMINAL GAP

FOLD DOWN - SHELL / TERMINAL GAP

O9 | YSTEP
O10 | YDIR
O11 | X1STEP
O12 | X1DIR

OUT-5V+ NC / SPARE

OUT-5V0 NC / SPARE

O13 | X2STEP
O14 | X2DIR
O15 | ZSTEP
O16 | ZDIR
O17 | NC / SPARE
AI1 | NC / SPARE
AI2 | NC / SPARE
A01 | VFD V1

OUT-5V+ NC / SPARE

OUT-5V0 NC / SPARE

IN-5V+ | 5V
IN-5V0 | 5V0

IN-24V+ 24V

IN-24V0 24V0

COIL- I6-

secondary estop.estop- I6+

ZLL I5-

24V I5+

X2LL I4-

24V I4+

X1LL I3-

24V I3+

YLL I2-

24V I2+

UL1 I1-

24V I1+

NC / SPARE O8

NC / SPARE O7

NC / SPARE O6

NC / SPARE O5

NC / SPARE O4

VFD FWD O3

VFD REV O2

CHARGE_PUMP O1

## AXBB-E

MOTION CONTROL

CUSTOM / REVISION
09/2026

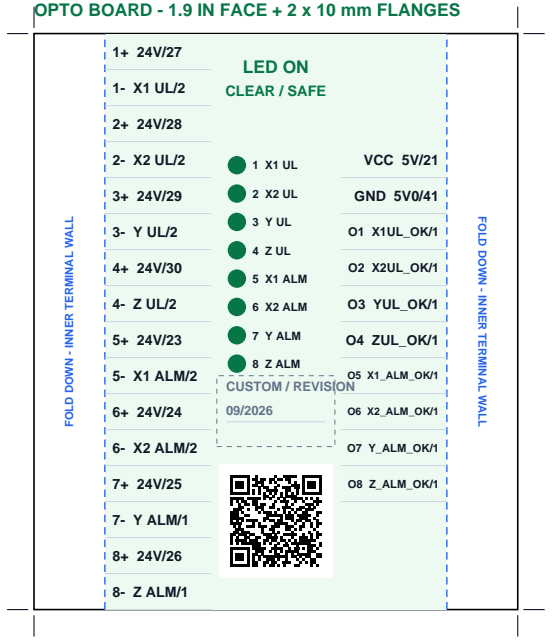
[picture p4: figure]
FOLD DOWN - INNER TERMINAL WALL; 5- X1 ALM/2; 6- X2 ALM/2; 7- Y ALM/1; 8- Z ALM/1; VCC 5V/21; GND 5V0/41; O3 YUL_OK/1; O4 ZUL_OK/1; O5 X1_ALM_OK/1; O6 X2_ALM_OK/1; O7 Y_ALM_OK/1; O8 Z_ALM_OK/1; LED ON; CLEAR / SAFE; 5 X1 ALM; 6 X2 ALM; 7 Y ALM; 8 Z ALM CUSTOM / REVISION

### OPTO BOARD - 1.9 IN FACE + 2 x 10 mm FLANGES FOLD DOWN ⁻ INNER TERMINAL WALL NANO SAFETY CONTROLLER - ROTATED 90 DEGREES

N/C
RESET <--
UL OK <--
RUN <--
Z ALM <--
Y ALM <--
X2 ALM <--
X1 ALM <--
Z UL <--
Y UL <--
X2 UL <--
X1 UL <--
GND
RST
RX
TX
N/C XXXXXXX
5V
UL OK -->
RUN -->

UL OK LED

RUN OK LED
N/C
24V
OK<--

github.com/dcowden/panelviz/blob/master/src/EstopBoardv3

50 mm SCALE CHECK | PRINT AT 100% - DISABLE FIT / SHRINK / SCALE | 1.000 IN / 0.100 IN TICKS
