dcowden/panelviz/docs/as_built/1000005609.jpg

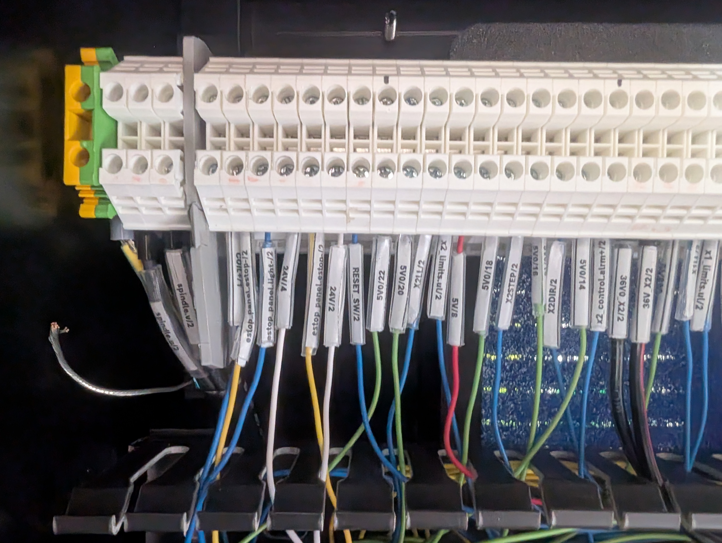
docs/as_built/1000005609.jpg
