dcowden/panelviz/docs/as_built/1000005610.jpg

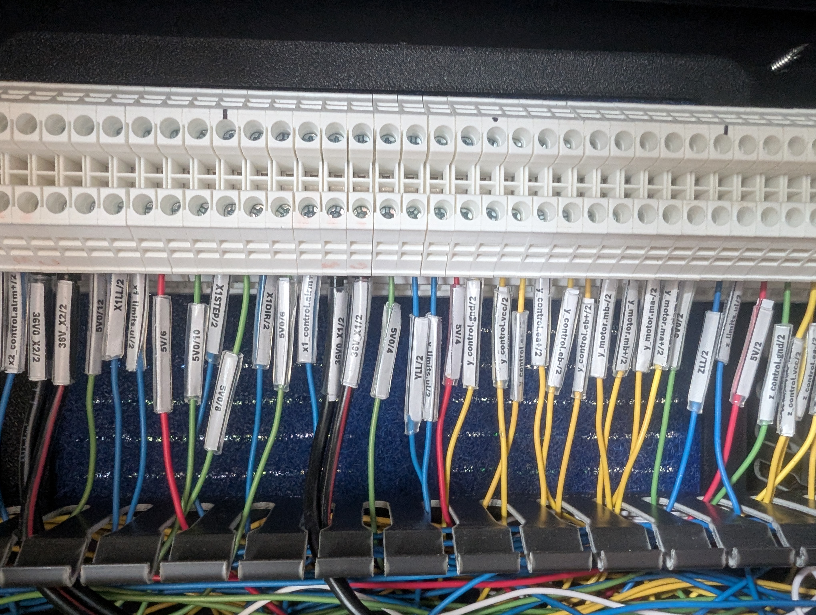
docs/as_built/1000005610.jpg
