dcowden/panelviz/docs/as_built/1000005611.jpg

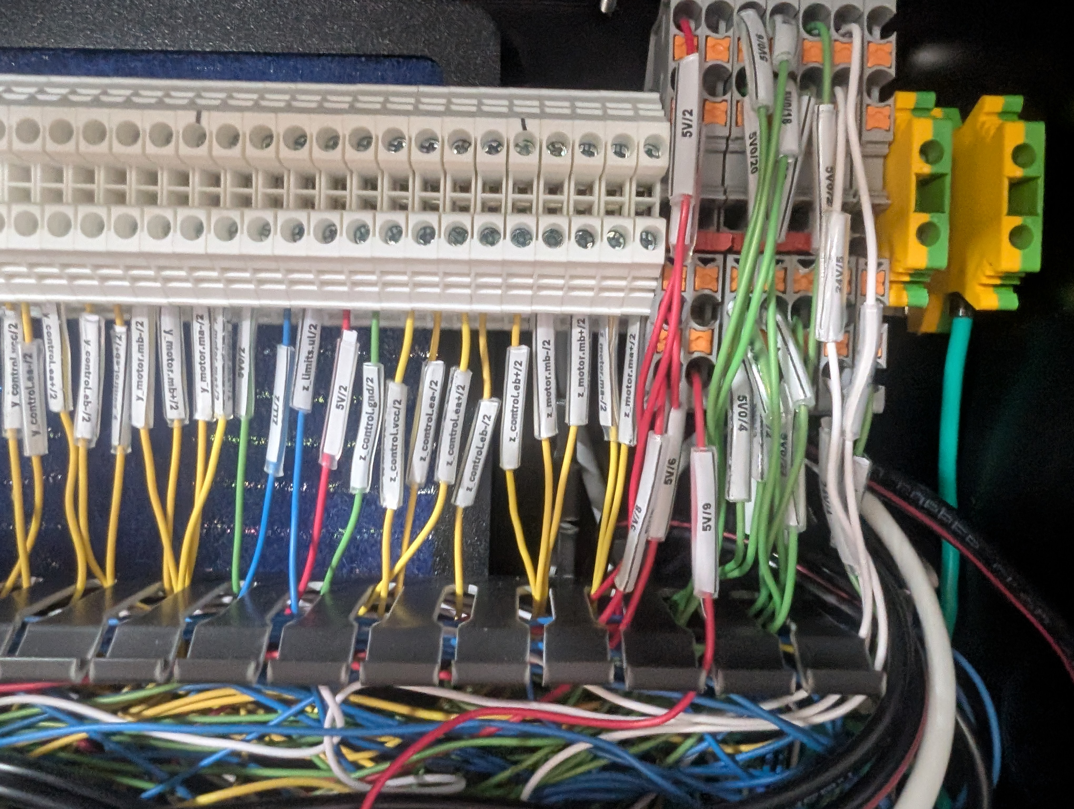
docs/as_built/1000005611.jpg
