dcowden/panelviz/docs/as_built/1000005612.jpg

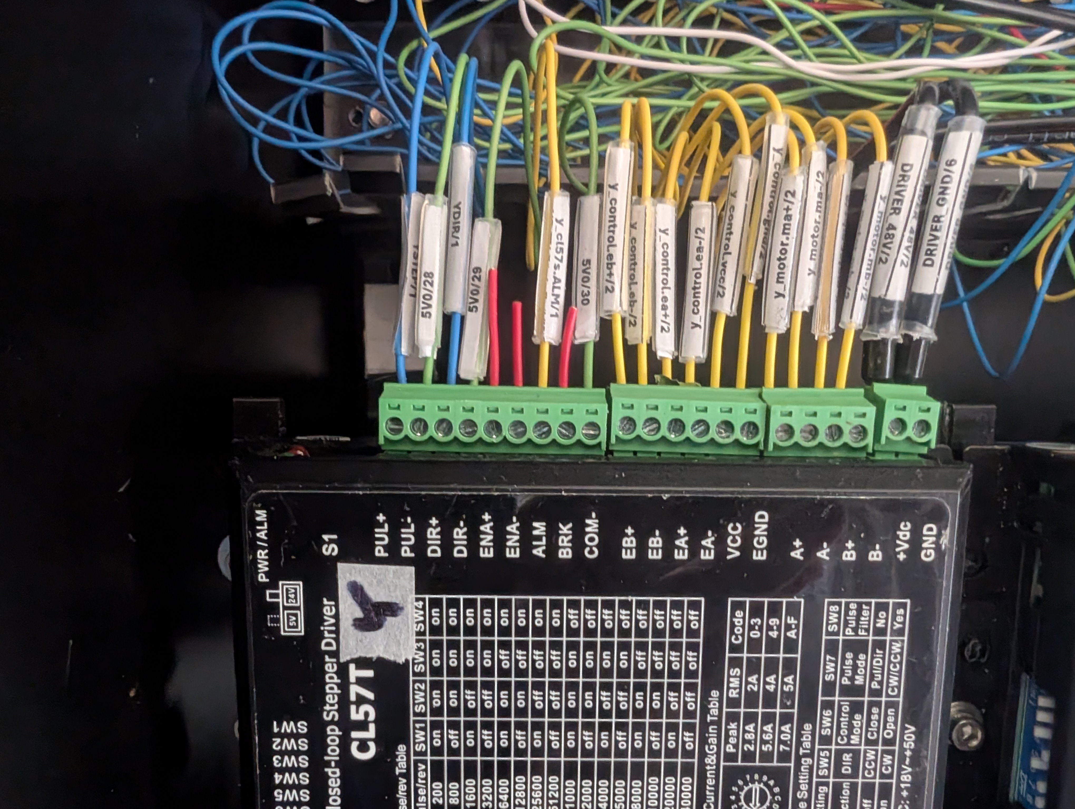
docs/as_built/1000005612.jpg
