dcowden/panelviz/docs/as_built/1000005613.jpg

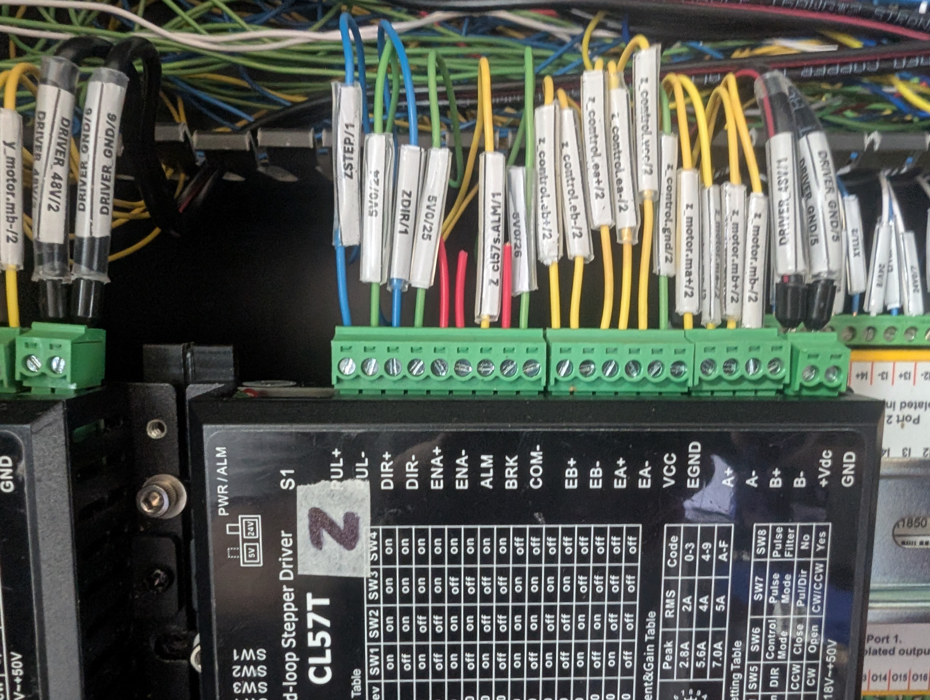
docs/as_built/1000005613.jpg
