dcowden/panelviz/docs/as_built/1000005614.jpg

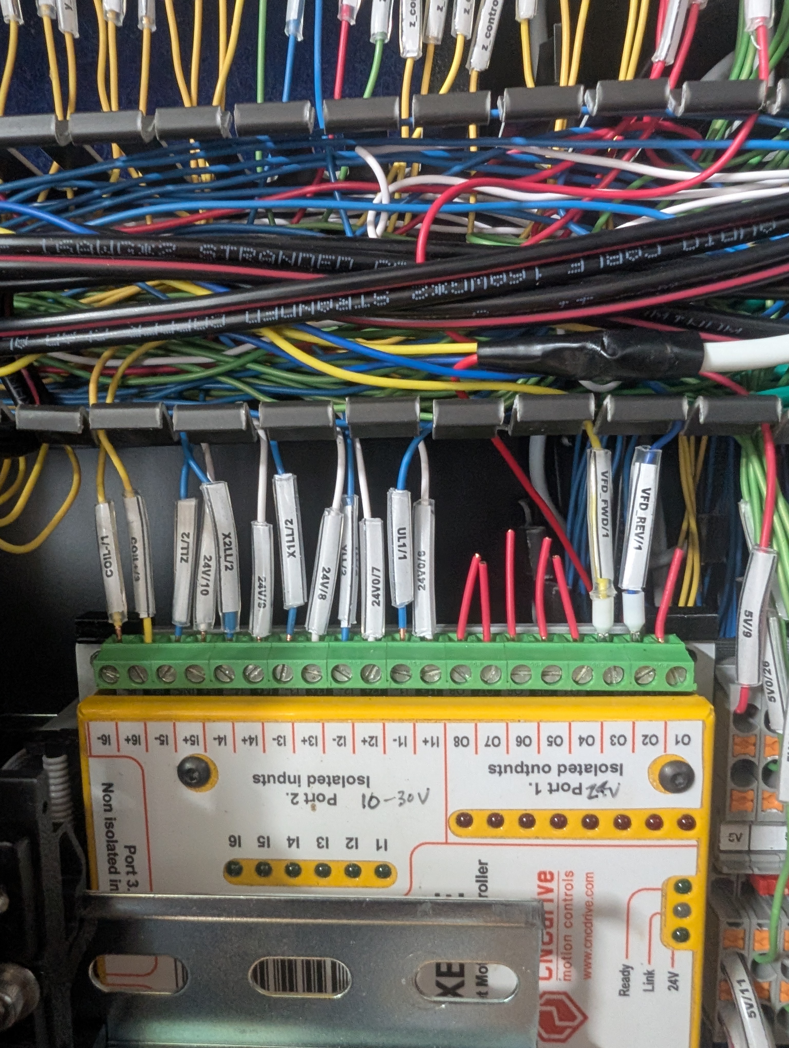
docs/as_built/1000005614.jpg
