dcowden/panelviz/docs/as_built/1000005616.jpg

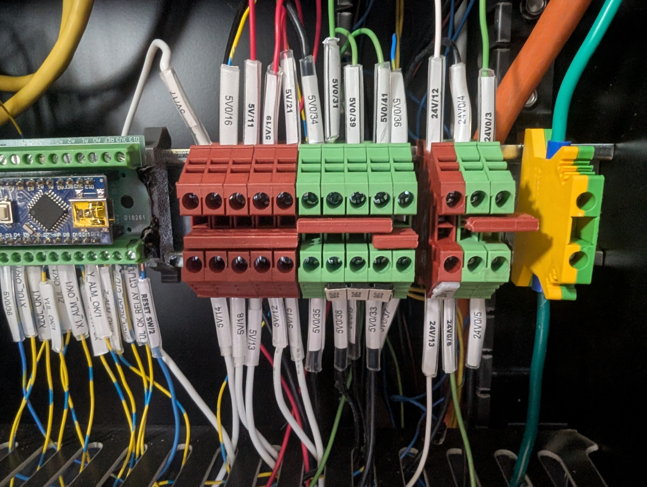
docs/as_built/1000005616.jpg
