dcowden/panelviz/docs/as_built/1000005617.jpg

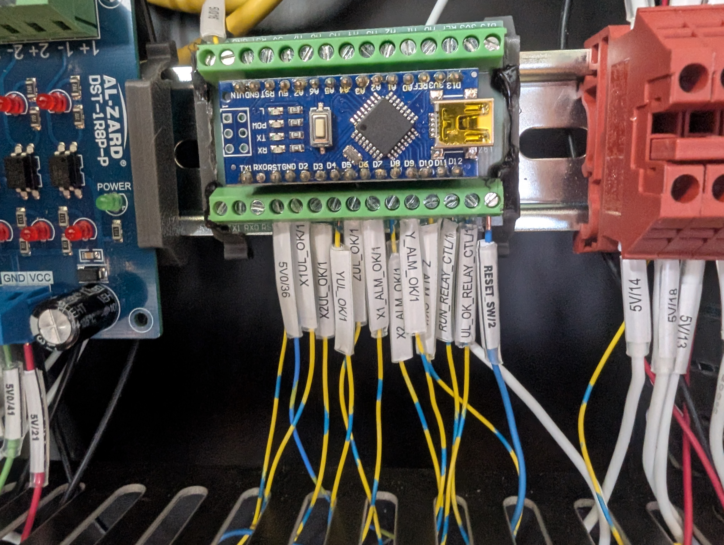
docs/as_built/1000005617.jpg
