dcowden/panelviz/docs/as_built/1000005618.jpg

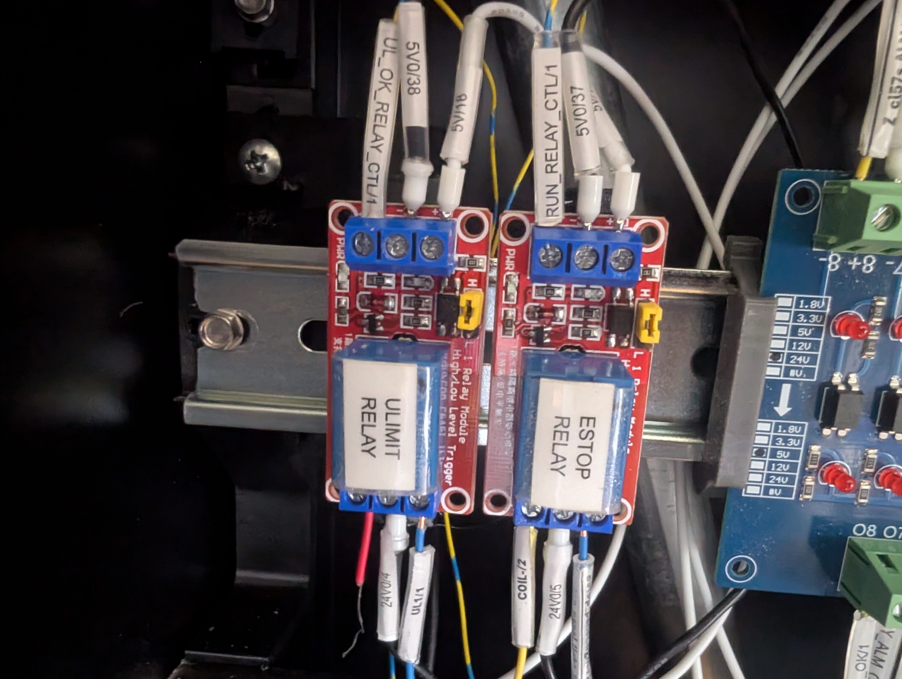
docs/as_built/1000005618.jpg
