dcowden/panelviz/docs/as_built/1000005619.jpg

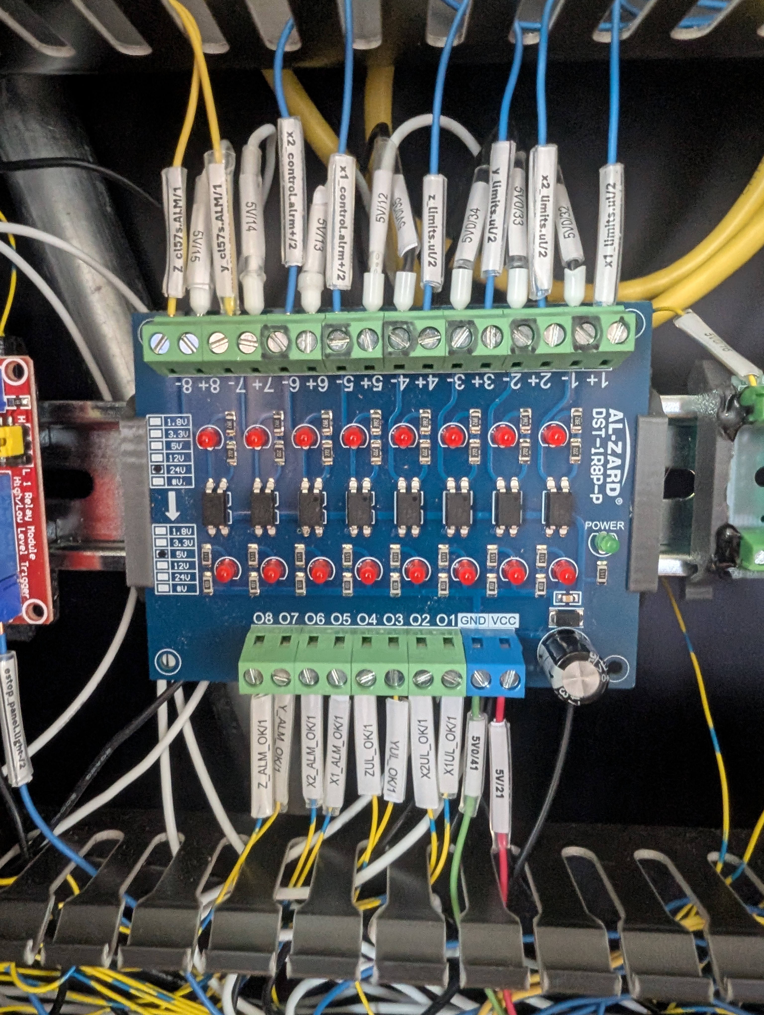
docs/as_built/1000005619.jpg
