dcowden/panelviz/docs/as_built/1000005620.jpg

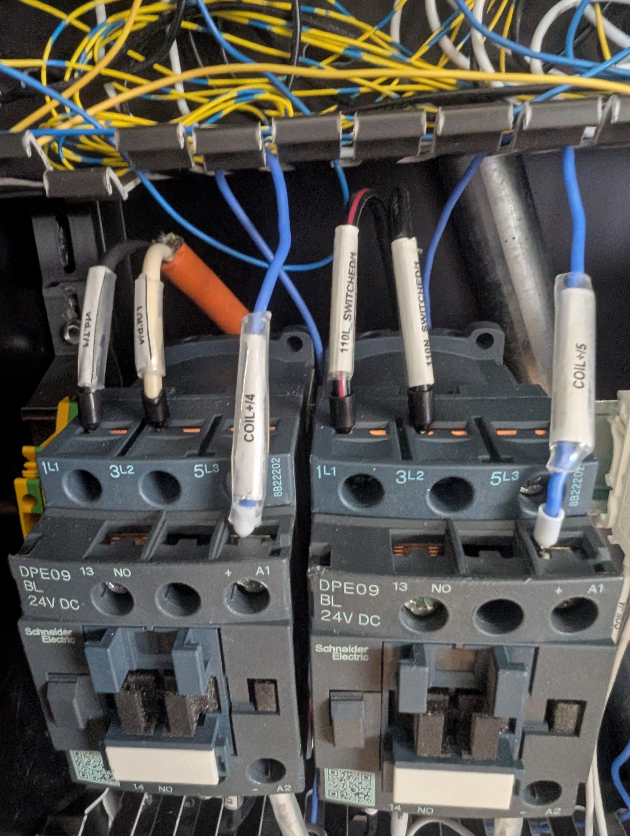
docs/as_built/1000005620.jpg
