dcowden/panelviz/docs/as_built/1000005621.jpg

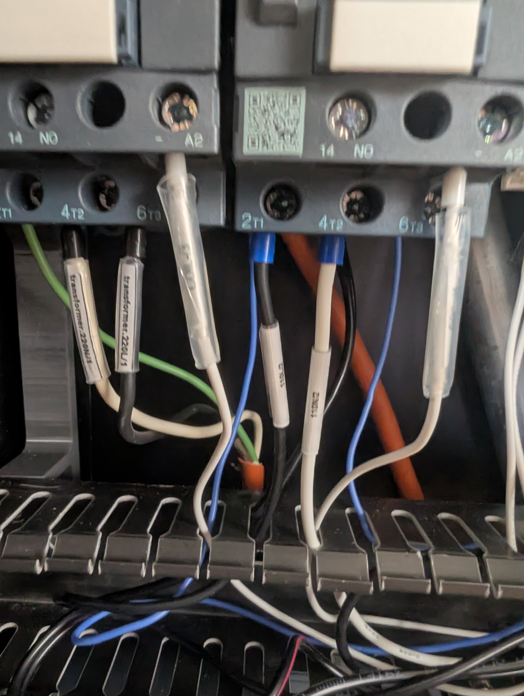
docs/as_built/1000005621.jpg
