dcowden/panelviz/docs/as_built/1000005622.jpg

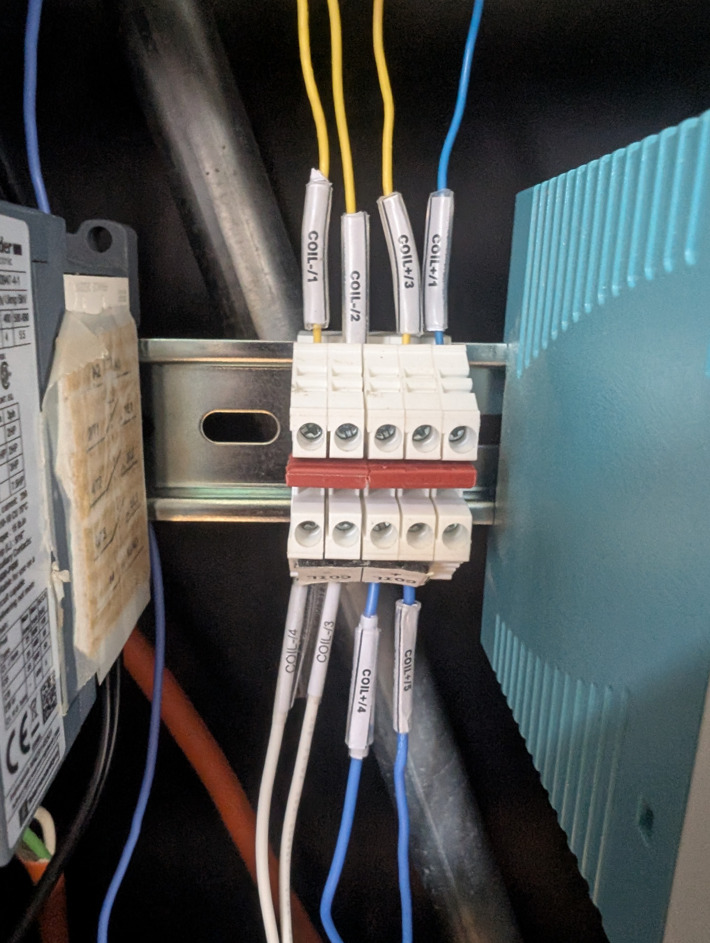
docs/as_built/1000005622.jpg
