dcowden/panelviz/docs/as_built/1000005623.jpg

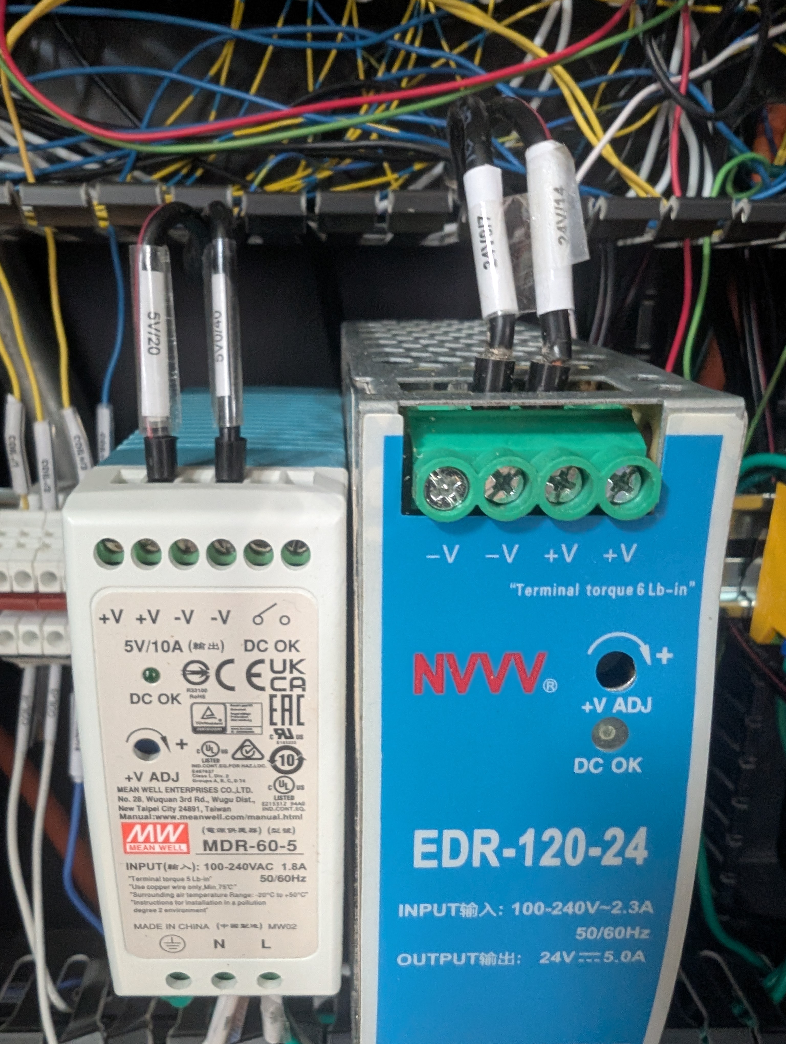
docs/as_built/1000005623.jpg
