dcowden/panelviz/docs/as_built/1000005624.jpg

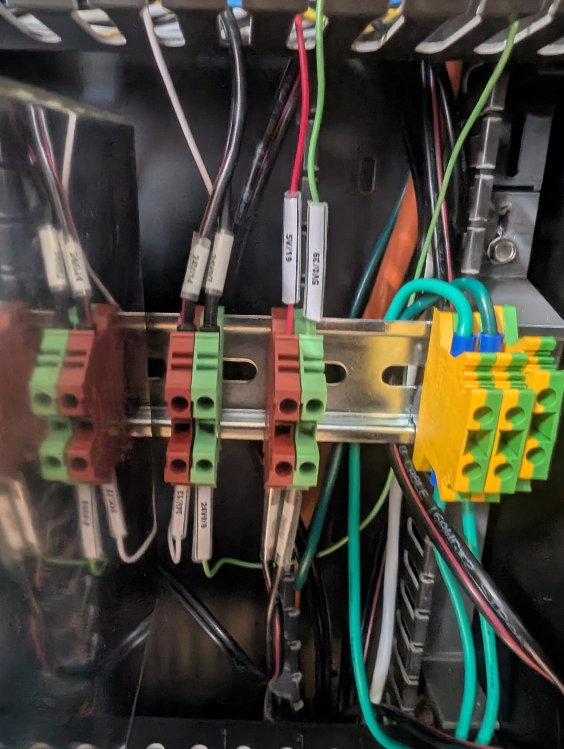
docs/as_built/1000005624.jpg
