dcowden/panelviz/docs/as_built/1000005626.jpg

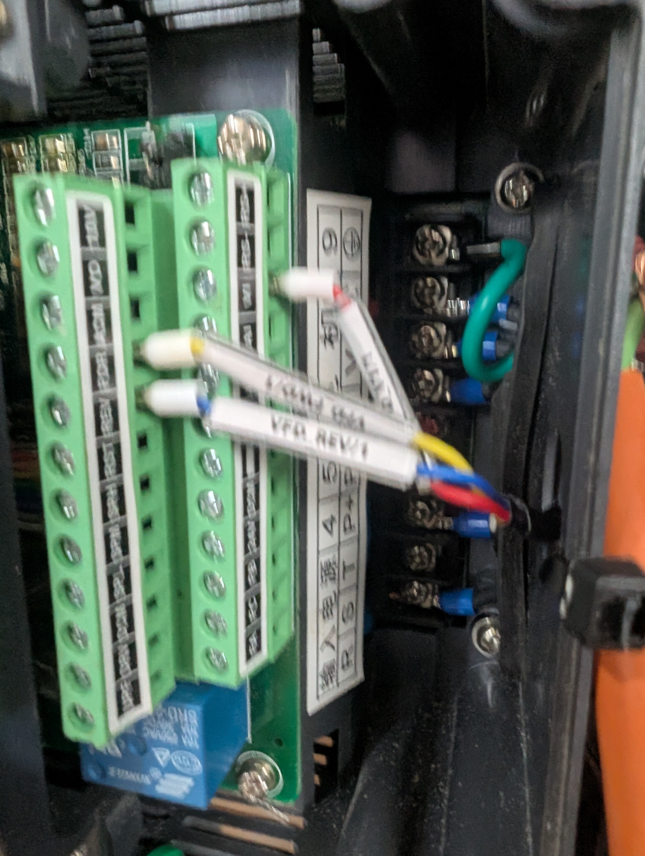
docs/as_built/1000005626.jpg
