dcowden/panelviz/docs/safety_circuit_with_charge_pump.jpg

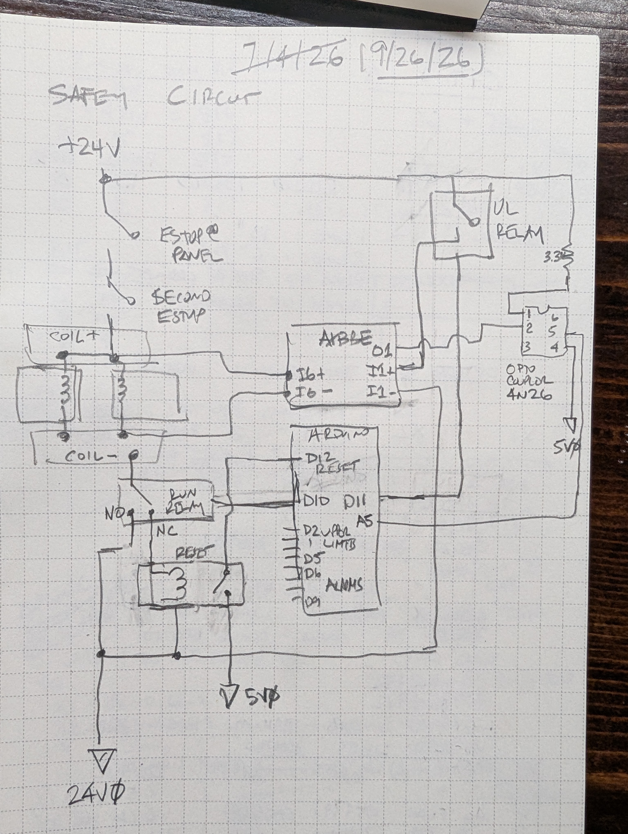
docs/safety_circuit_with_charge_pump.jpg
