dcowden/panelviz/component_summary.txt

| component | type | pins | unconnected_pins | no_connects | multi_connected_pins | warnings |
|---|---|---|---|---|---|---|
| y_cl57s | driver | 21 | EGND | ENA+, ENA-, BRK | GND (2) | 1 unconnected; 1 multi-connected |
| Z_cl57s | driver | 21 | EGND | ENA+, ENA-, BRK | GND (2) | 1 unconnected; 1 multi-connected |
| axbb-e | driver | 48 | OUT-5V+, OUT-5V0, 1, 2, 3, 4, 5, 6, 7, 8, 9, 10 | O1, O4, O5, O6, O7, O8, AI2, AI1, O17 | - | 12 unconnected |
| contactor_110 | switch | 10 | L1, T1 | 13, 14 | - | 2 unconnected |
| contactor_220 | switch | 10 | L3, T3 | 13, 14 | - | 2 unconnected |
| transformer | power_supply | 5 | - | - | - | - |
| 36V_X1 | power_supply | 5 | - | - | - | - |
| 36V_X2 | power_supply | 5 | - | - | - | - |
| 48v | power_supply | 5 | - | - | 48V0 (2), 48V (2) | 2 multi-connected |
| 24v | power_supply | 5 | - | - | - | - |
| 5v | power_supply | 5 | - | - | - | - |
| wall_plug | connector | 3 | - | - | - | - |
| run_relay | relay | 6 | - | - | - | - |
| upper_limits_ok_relay | relay | 6 | - | NO | - | - |
| opto_board | pcb | 24 | - | - | - | - |
| alarm_limit_board | pcb | 28 | D13, 3V3, REF, A0, A1, A2, A3, A4, A5, A6, A7, RST, GND, RST2, RX TX | - | - | 15 unconnected |
| vfd | vfd | 29 | FA, PC, FB, 24V, DCM2, AI, RS-, RS+, UPF, DRV, DCM, SPL, SPM, SPH, RST, ACM, V0, 10V, S, P+ | - | - | 20 unconnected |
| cnc_terminals | terminal_block | 132 | 53B, 54B, 65A, 65B, 66A, 66B | - | - | 6 unconnected |
| live_power_t | terminal_block | 12 | 5B, 6B | - | - | 2 unconnected |
| switched_110N | bus_block | 8 | 3A, 3B, 4A, 4B | - | - | 4 unconnected |
| switched_110L | bus_block | 8 | 3A, 3B, 4A, 4B | - | - | 4 unconnected |
| terminals_5v | bus_block | 6 | 3B | - | - | 1 unconnected |
| terminals_5v0 | bus_block | 14 | 7A, 7B | - | - | 2 unconnected |
| terminals_24v | bus_block | 4 | 2B | - | - | 1 unconnected |
| terminals_24v0 | bus_block | 2 | 1B | - | - | 1 unconnected |
| terminals_earth | bus_block | 2 | 1B | - | - | 1 unconnected |
| control_5v | bus_block | 4 | 2B | - | - | 1 unconnected |
| control_5v0 | bus_block | 10 | 5B | - | - | 1 unconnected |
| control_24v | bus_block | 8 | - | - | - | - |
| control_24v0 | bus_block | 4 | 2B | - | - | 1 unconnected |
| control_earth | bus_block | 2 | - | - | - | - |
| safety_5v | bus_block | 10 | 5B | - | - | 1 unconnected |
| safety_5v0 | bus_block | 10 | 5B | - | - | 1 unconnected |
| safety_24v | bus_block | 2 | - | - | - | - |
| safety_24v0 | bus_block | 4 | - | - | - | - |
| safety_earth | bus_block | 2 | - | - | - | - |
| dc_power_5v | bus_block | 4 | 2A, 2B | - | - | 2 unconnected |
| dc_power_5v0 | bus_block | 4 | 2A, 2B | - | - | 2 unconnected |
| dc_power_24v | bus_block | 4 | 2A, 2B | - | - | 2 unconnected |
| dc_power_24v0 | bus_block | 4 | 2A, 2B | - | - | 2 unconnected |
| dc_power_earth | bus_block | 4 | - | - | - | - |
| vfd_earth | bus_block | 8 | 4B | - | - | 1 unconnected |
| coil_t | terminal_block | 16 | 3A, 3B, 4A, 4B, 7A, 7B, 8A, 8B | - | - | 8 unconnected |
| connector_earth | bus_block | 16 | 7A, 7B, 8A, 8B | - | - | 4 unconnected |
| z_motor | connector | 5 | - | - | - | - |
| z_control | connector | 7 | - | - | - | - |
| z_limits | connector | 5 | - | - | - | - |
| y_motor | connector | 5 | - | - | - | - |
| y_control | connector | 7 | - | - | - | - |
| y_limits | connector | 5 | - | - | - | - |
| x1_motor | connector | 3 | - | - | - | - |
| x1_control | connector | 6 | - | - | - | - |
| x1_limits | connector | 5 | - | - | - | - |
| x2_motor | connector | 3 | - | - | - | - |
| x2_control | connector | 6 | - | - | - | - |
| x2_limits | connector | 5 | - | - | - | - |
| probe | connector | 3 | - | - | - | - |
| estop_panel | connector | 6 | - | - | - | - |
| secondary_estop | connector | 2 | - | - | - | - |
| spindle | connector | 5 | - | x | - | - |
