dcowden/panelviz/output/pdf/arduino_safety_logic_test_sheet.pdf

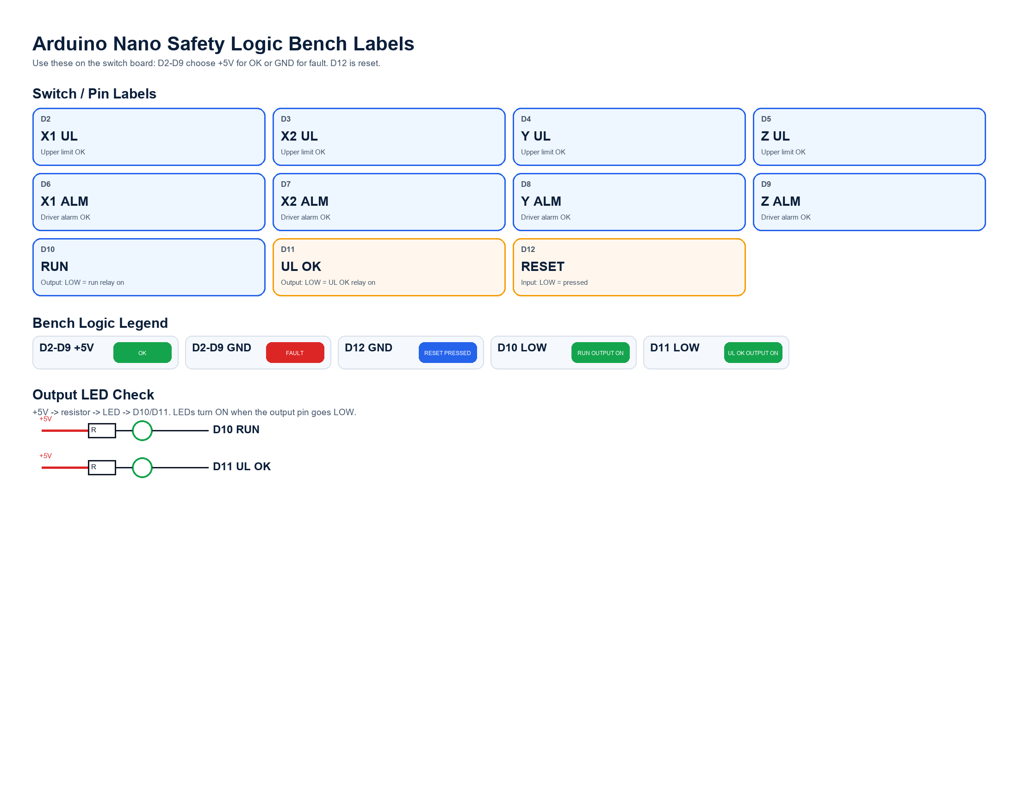
[picture p22: page 1]
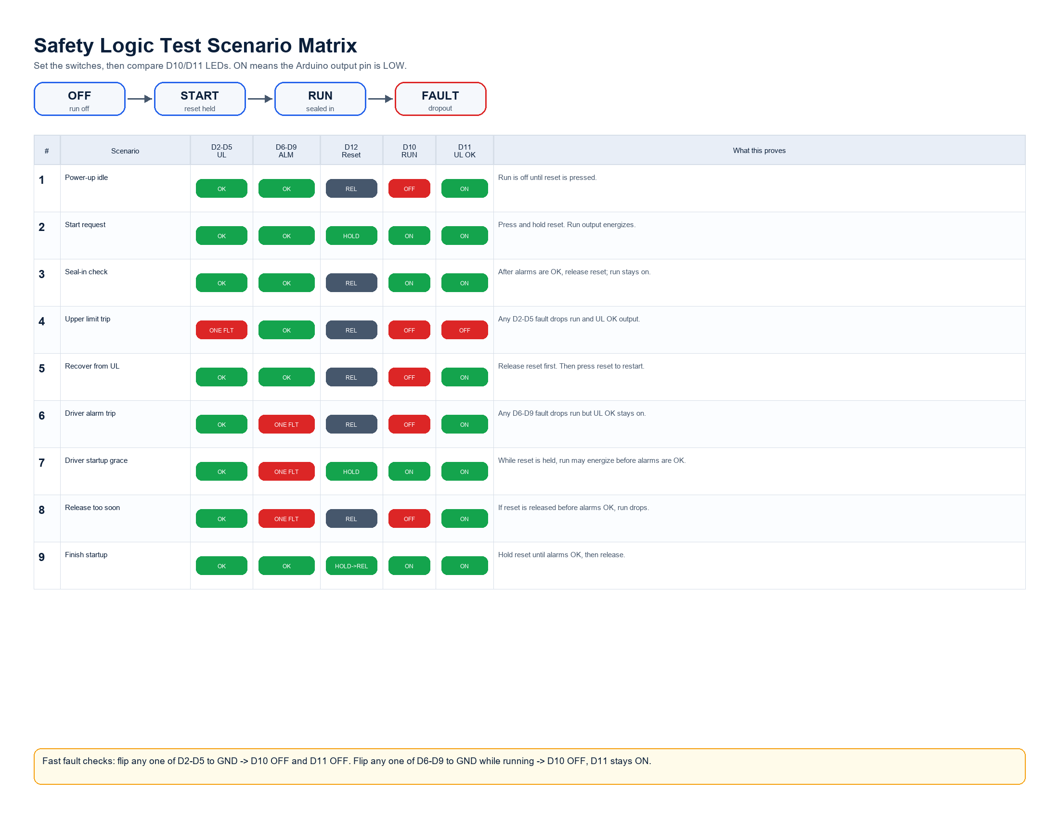
[picture p23: page 2]
