dcowden/panelviz/docs/HY01D523B-VFD-Manual.pdf

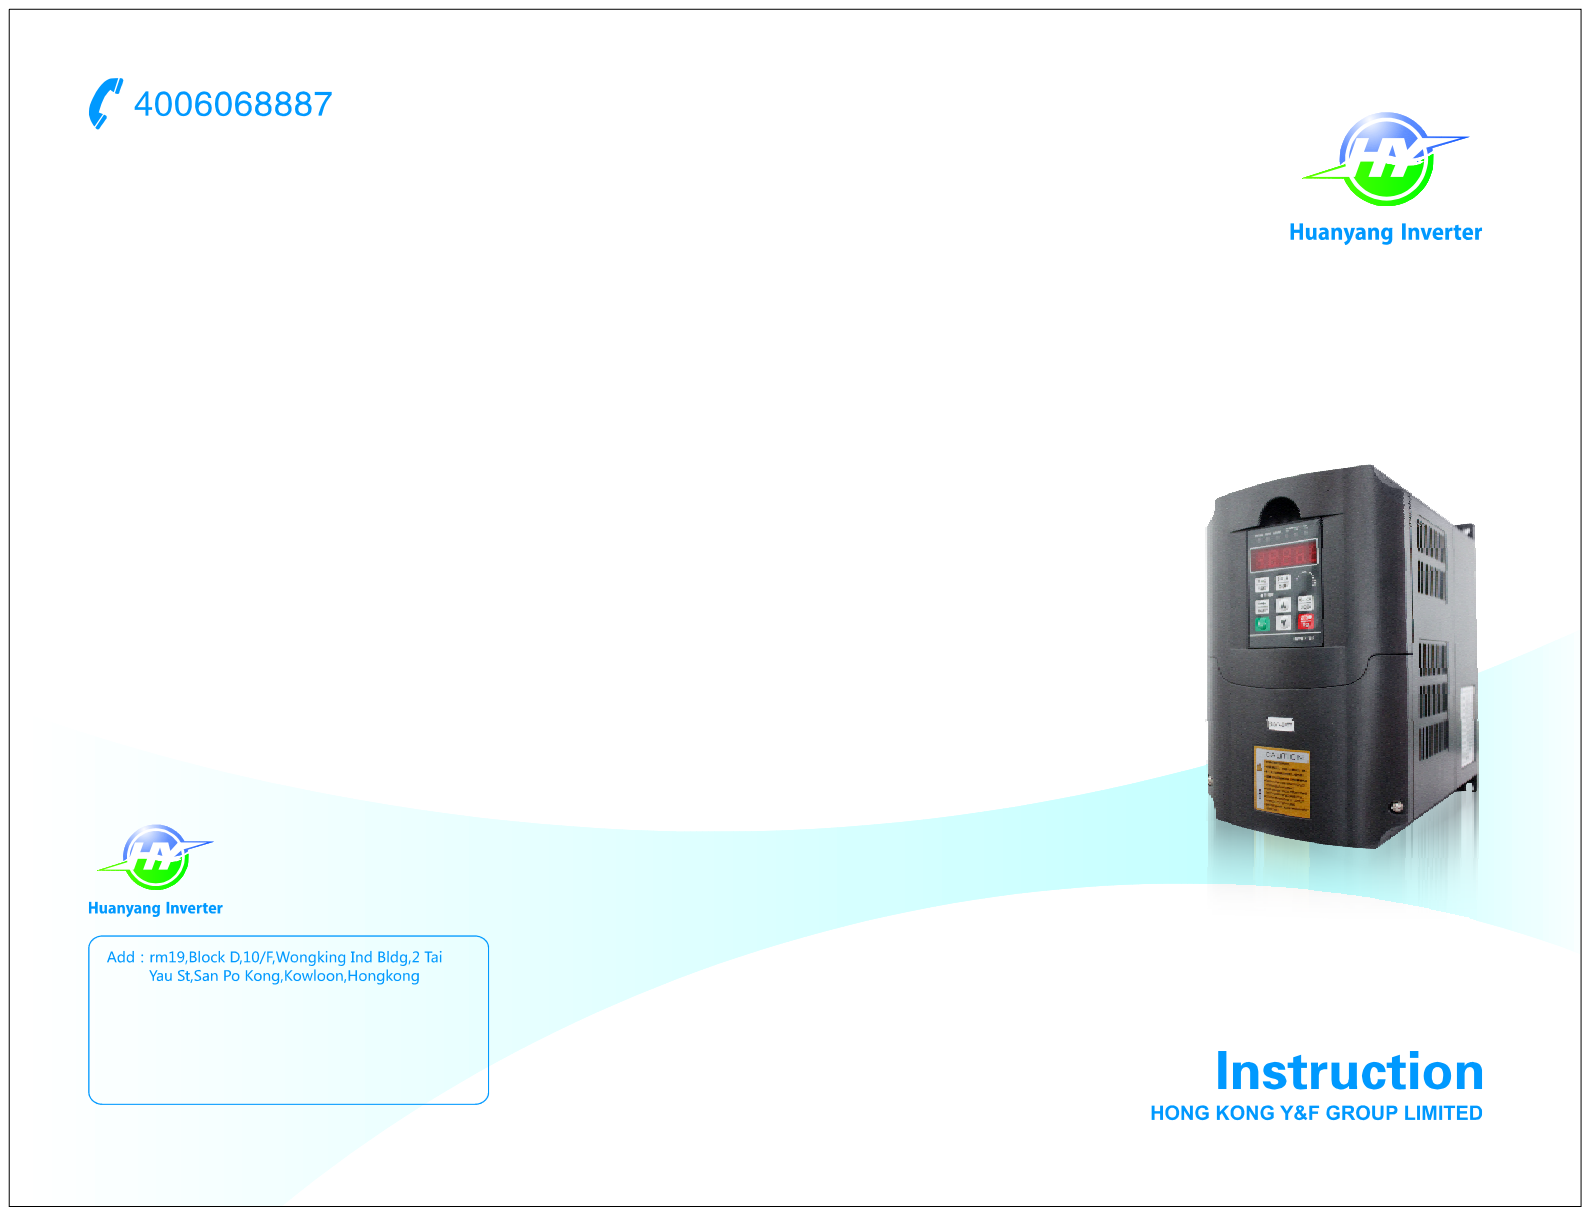
[picture p24: page 1]

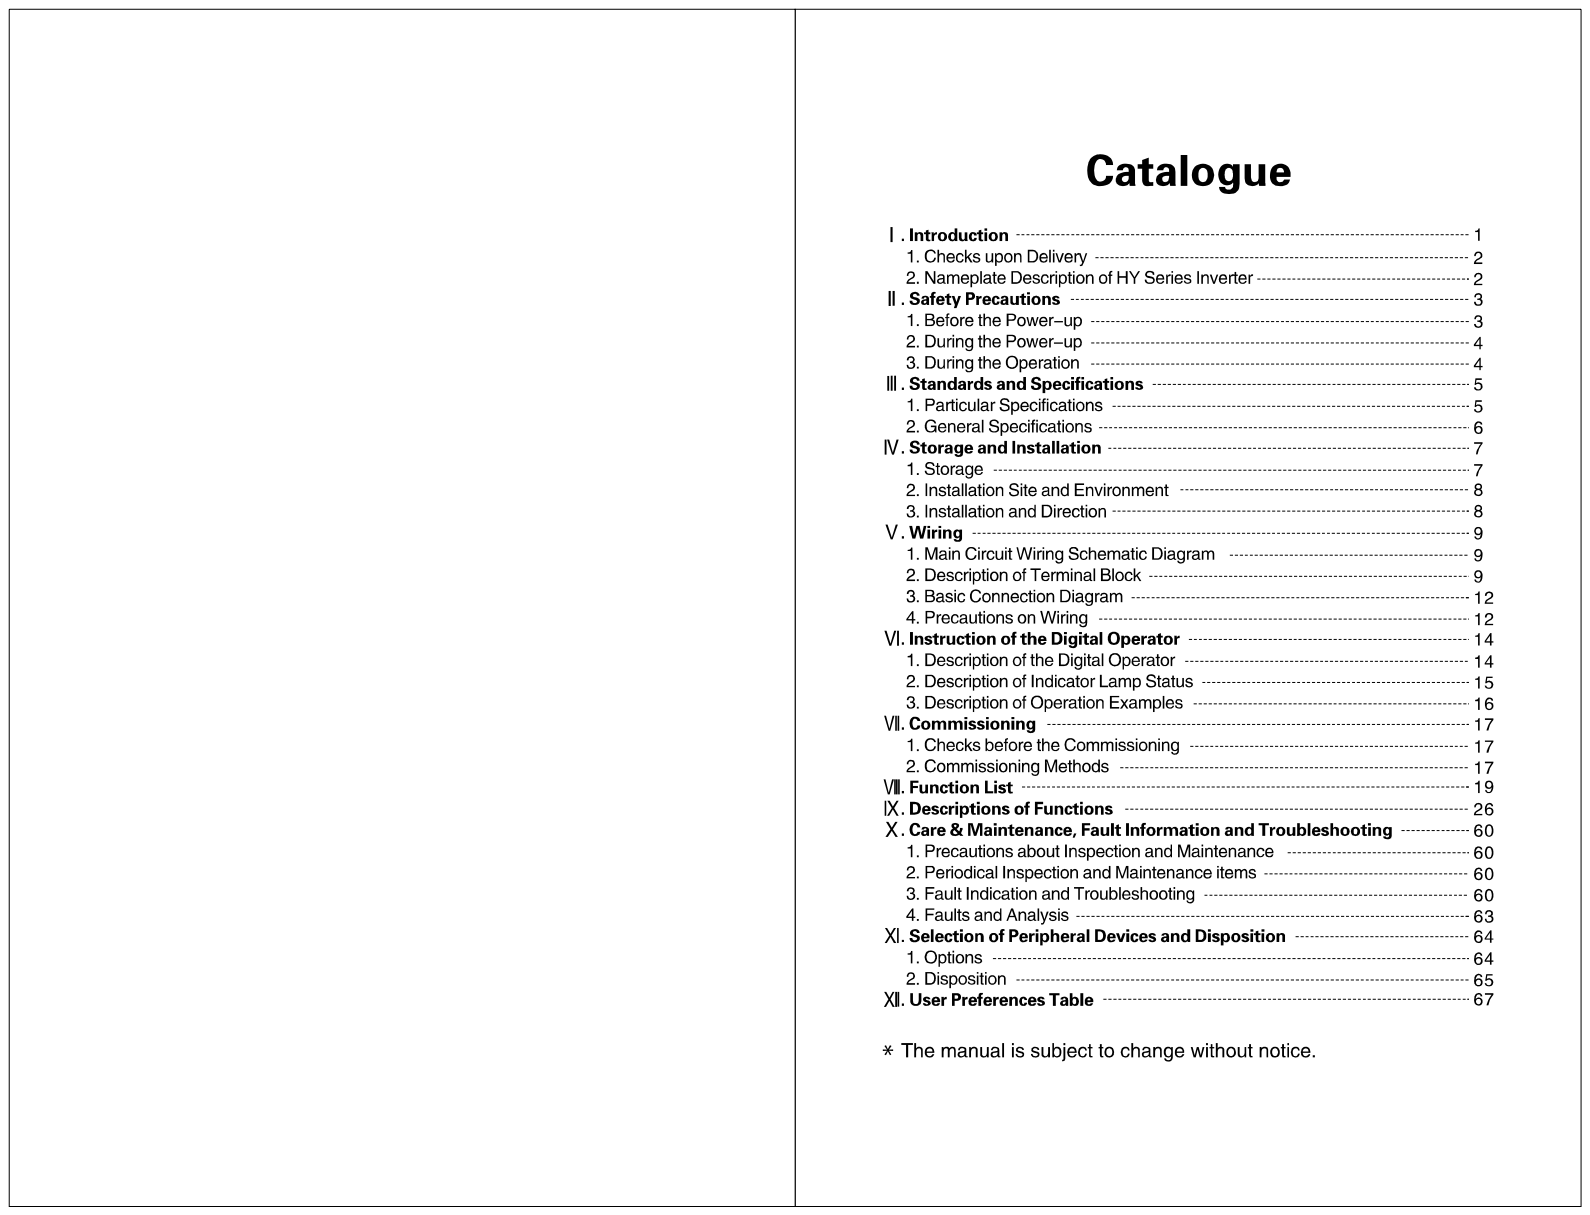
[picture p25: page 2]

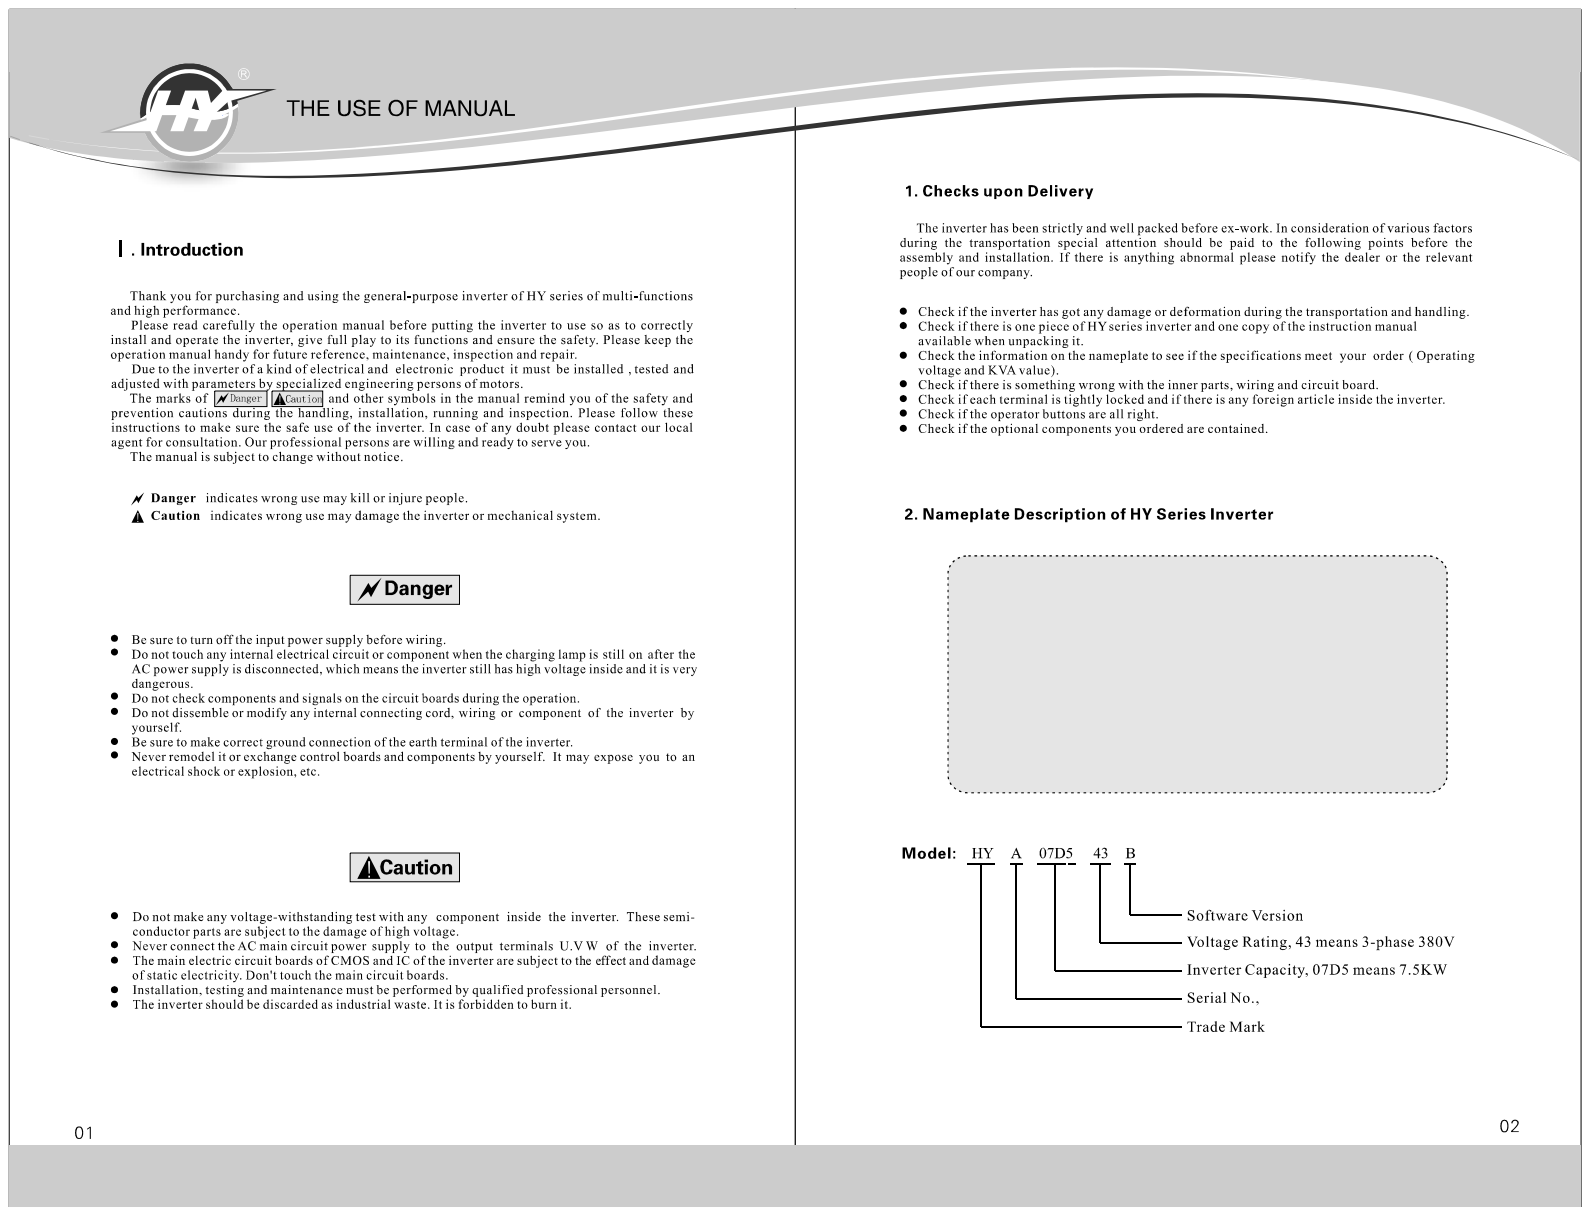
[picture p26: page 3]

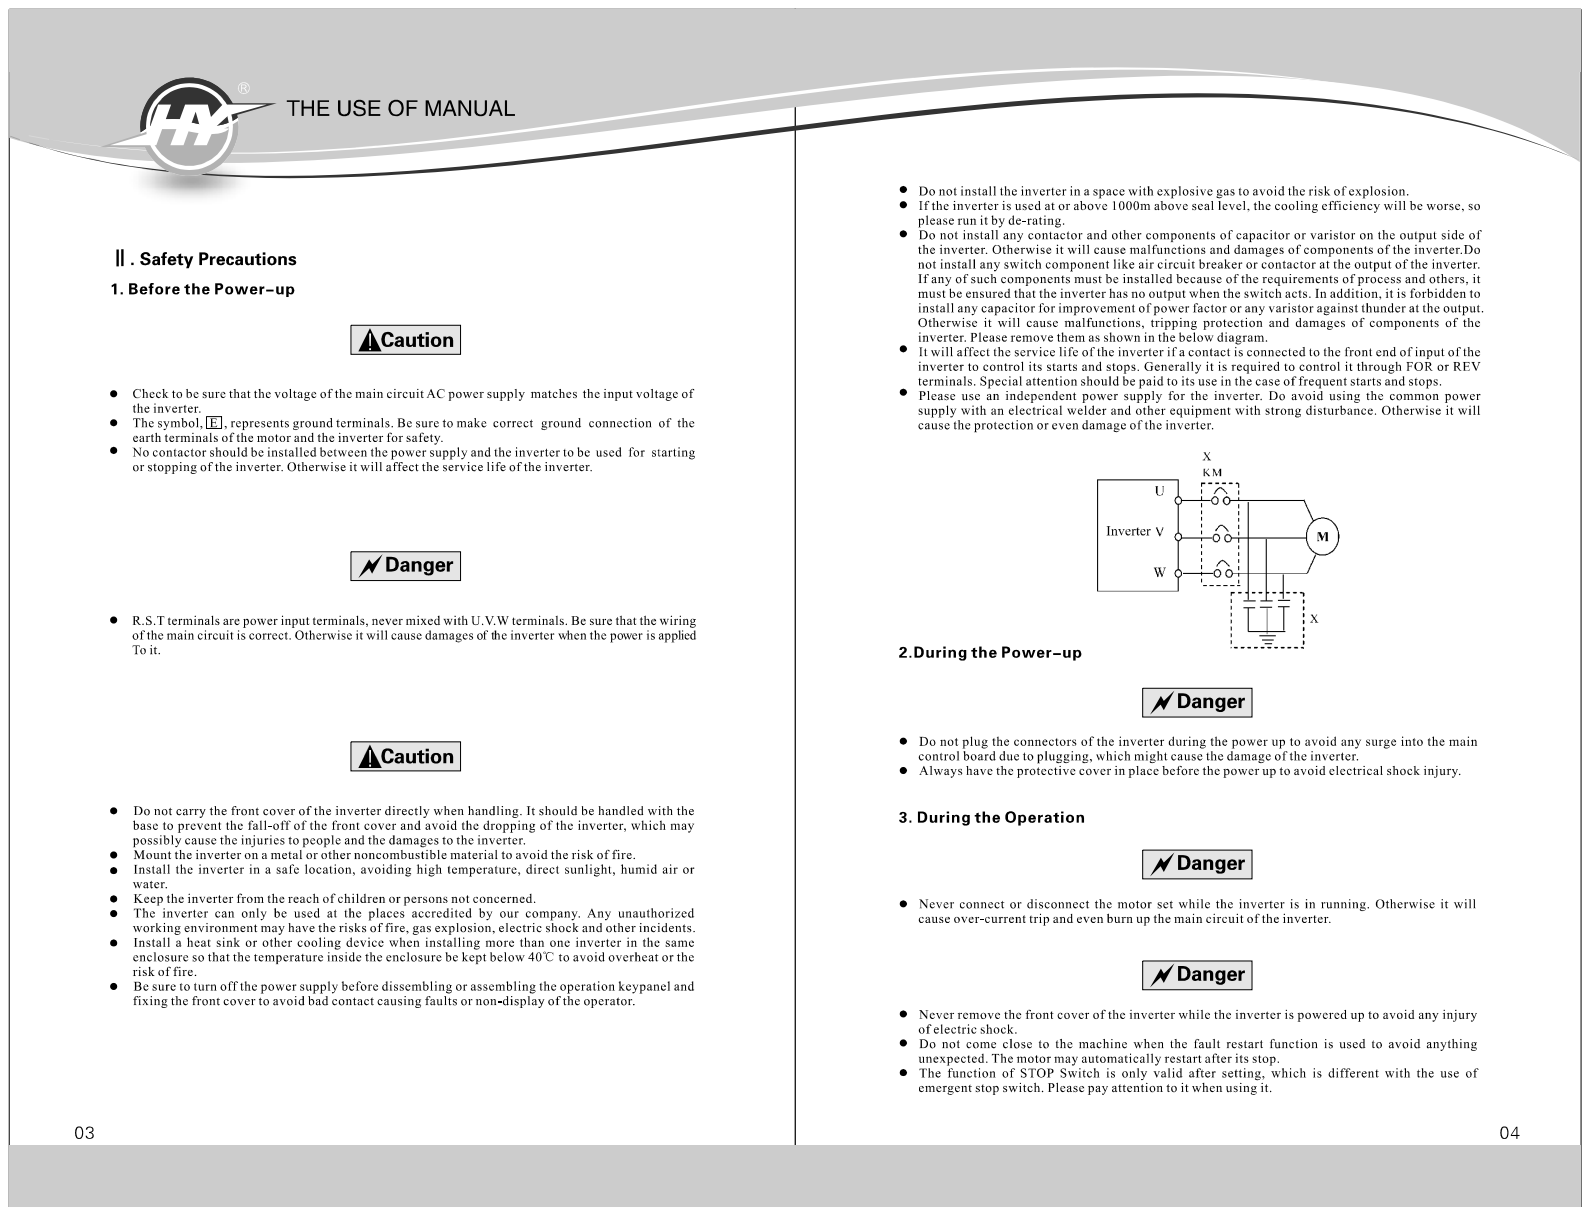
[picture p27: page 4]

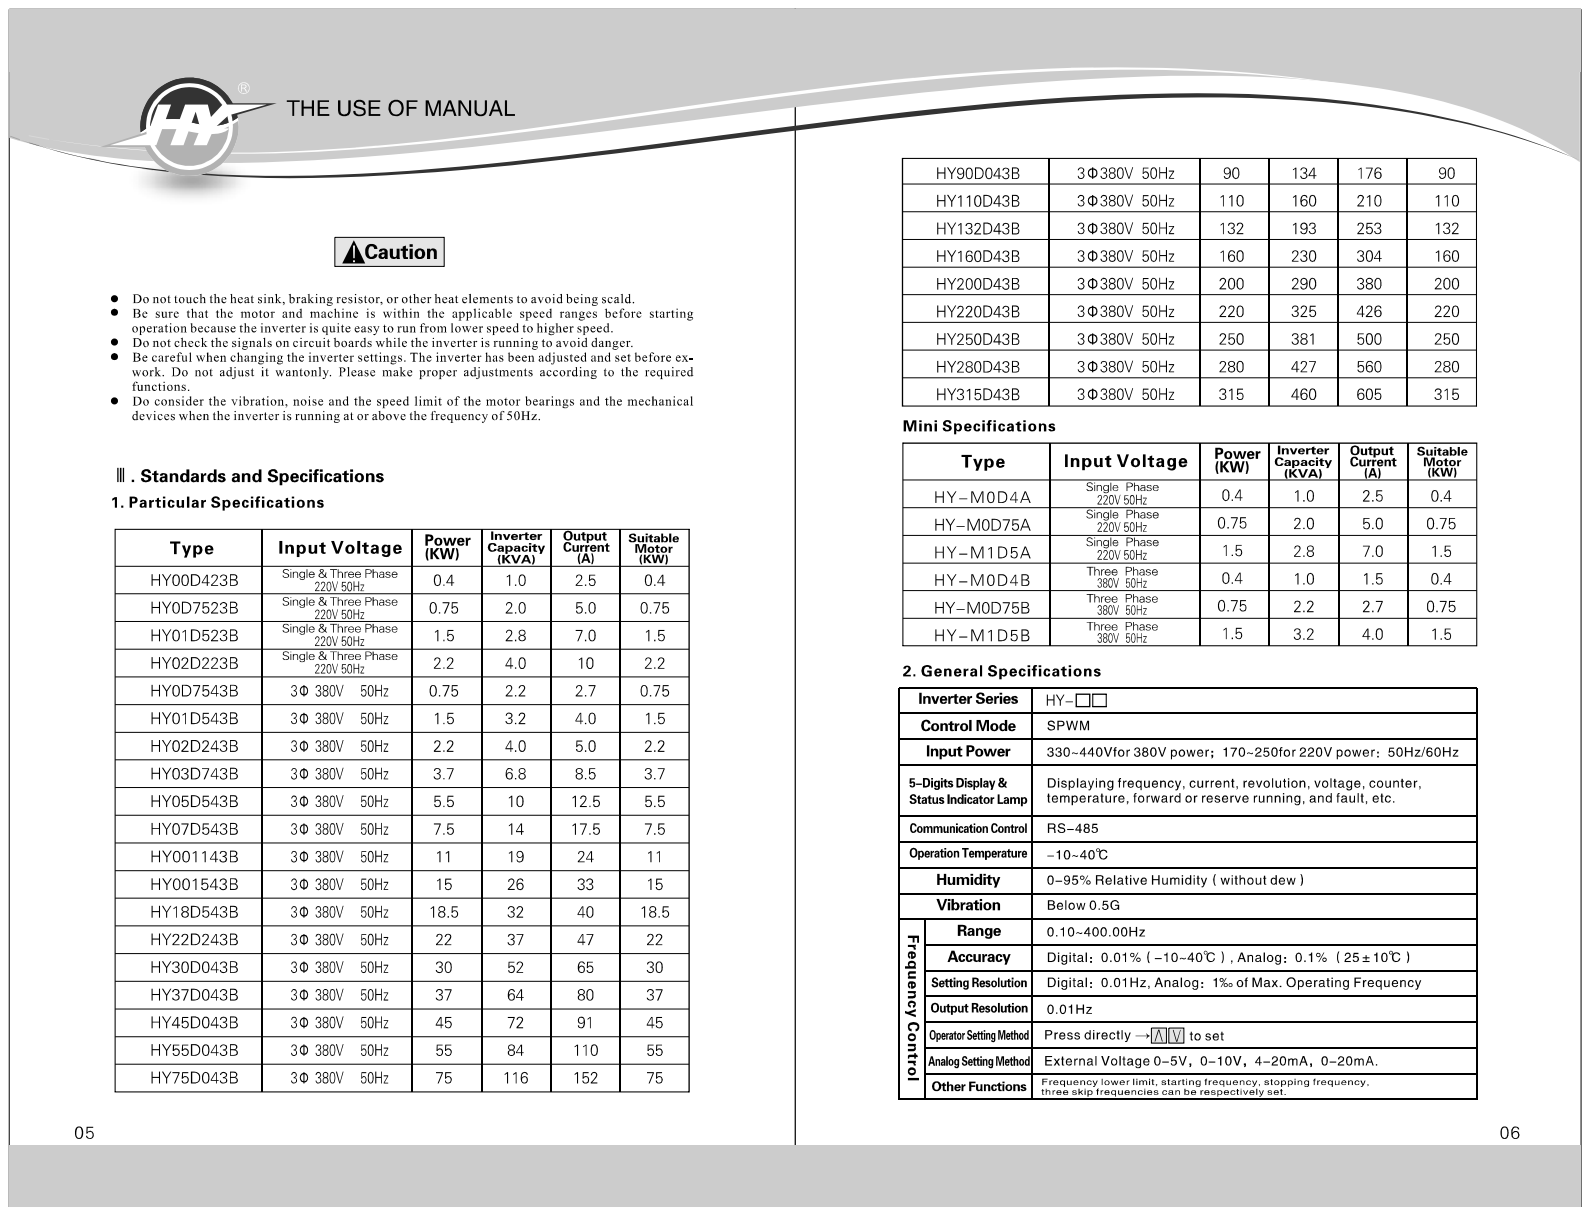
[picture p28: page 5]

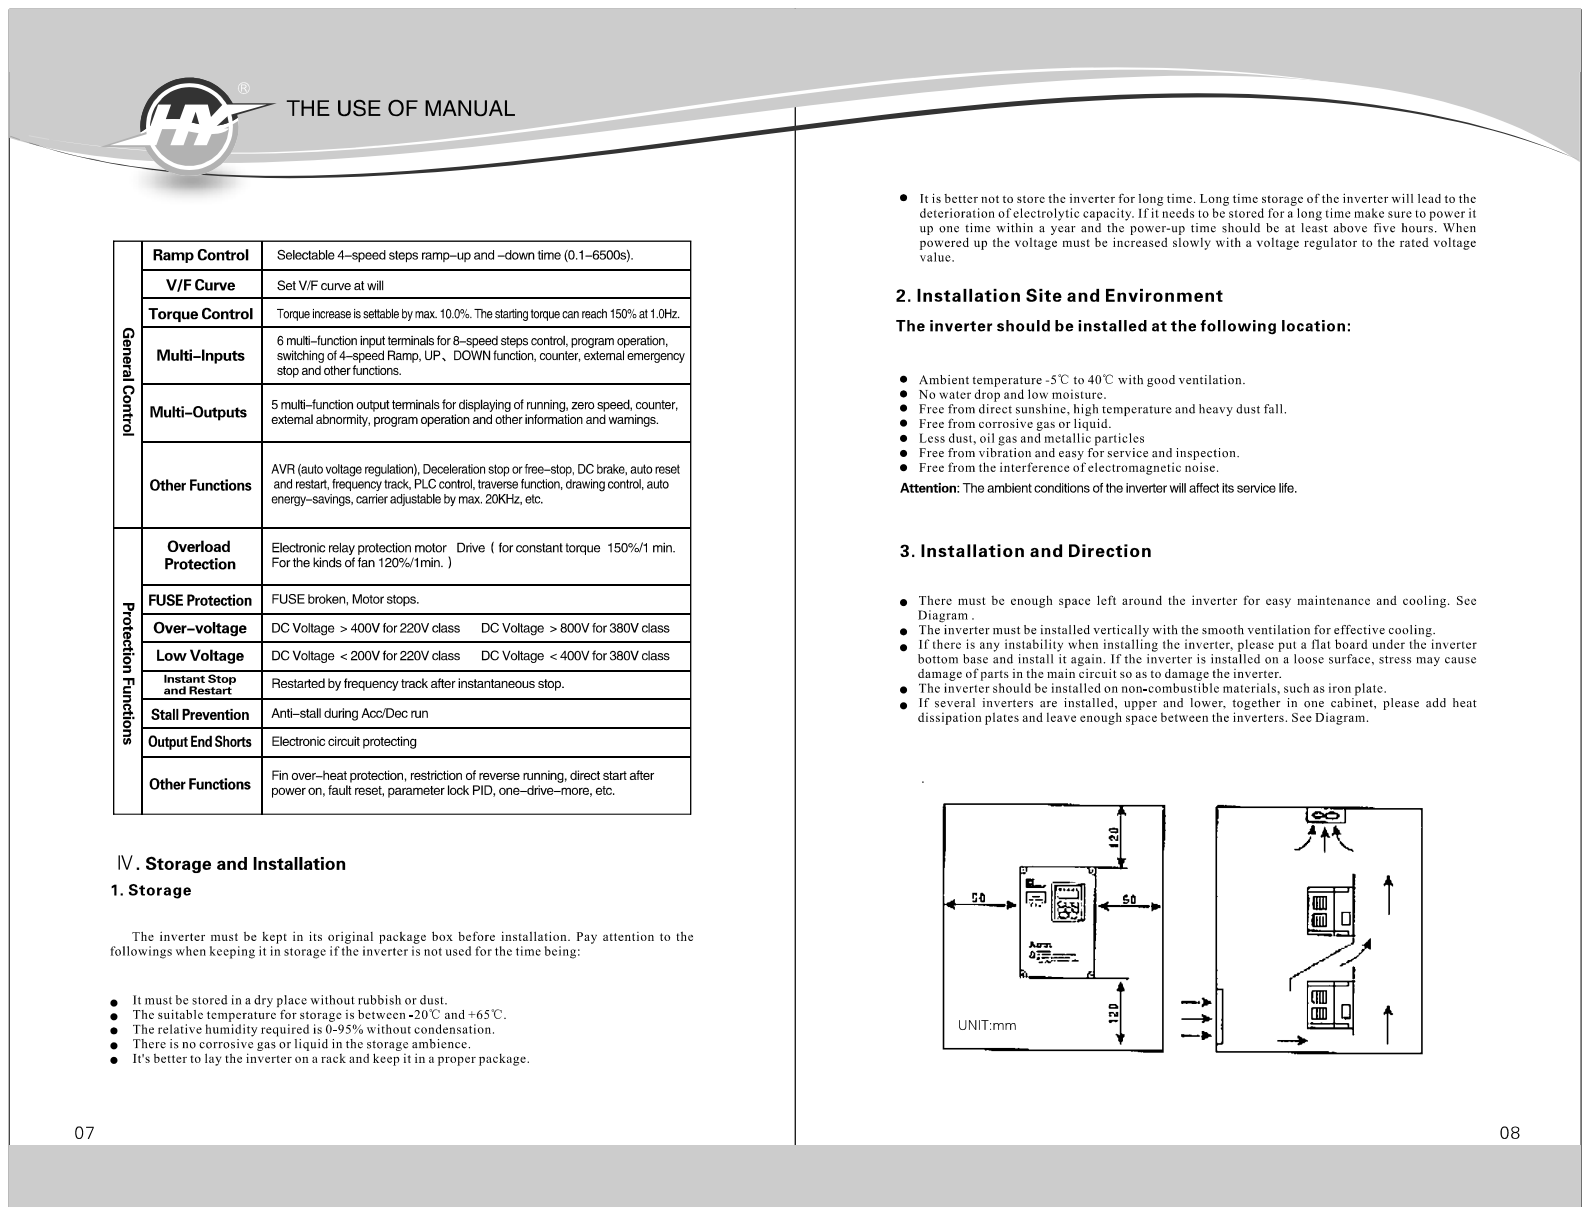
[picture p29: page 6]

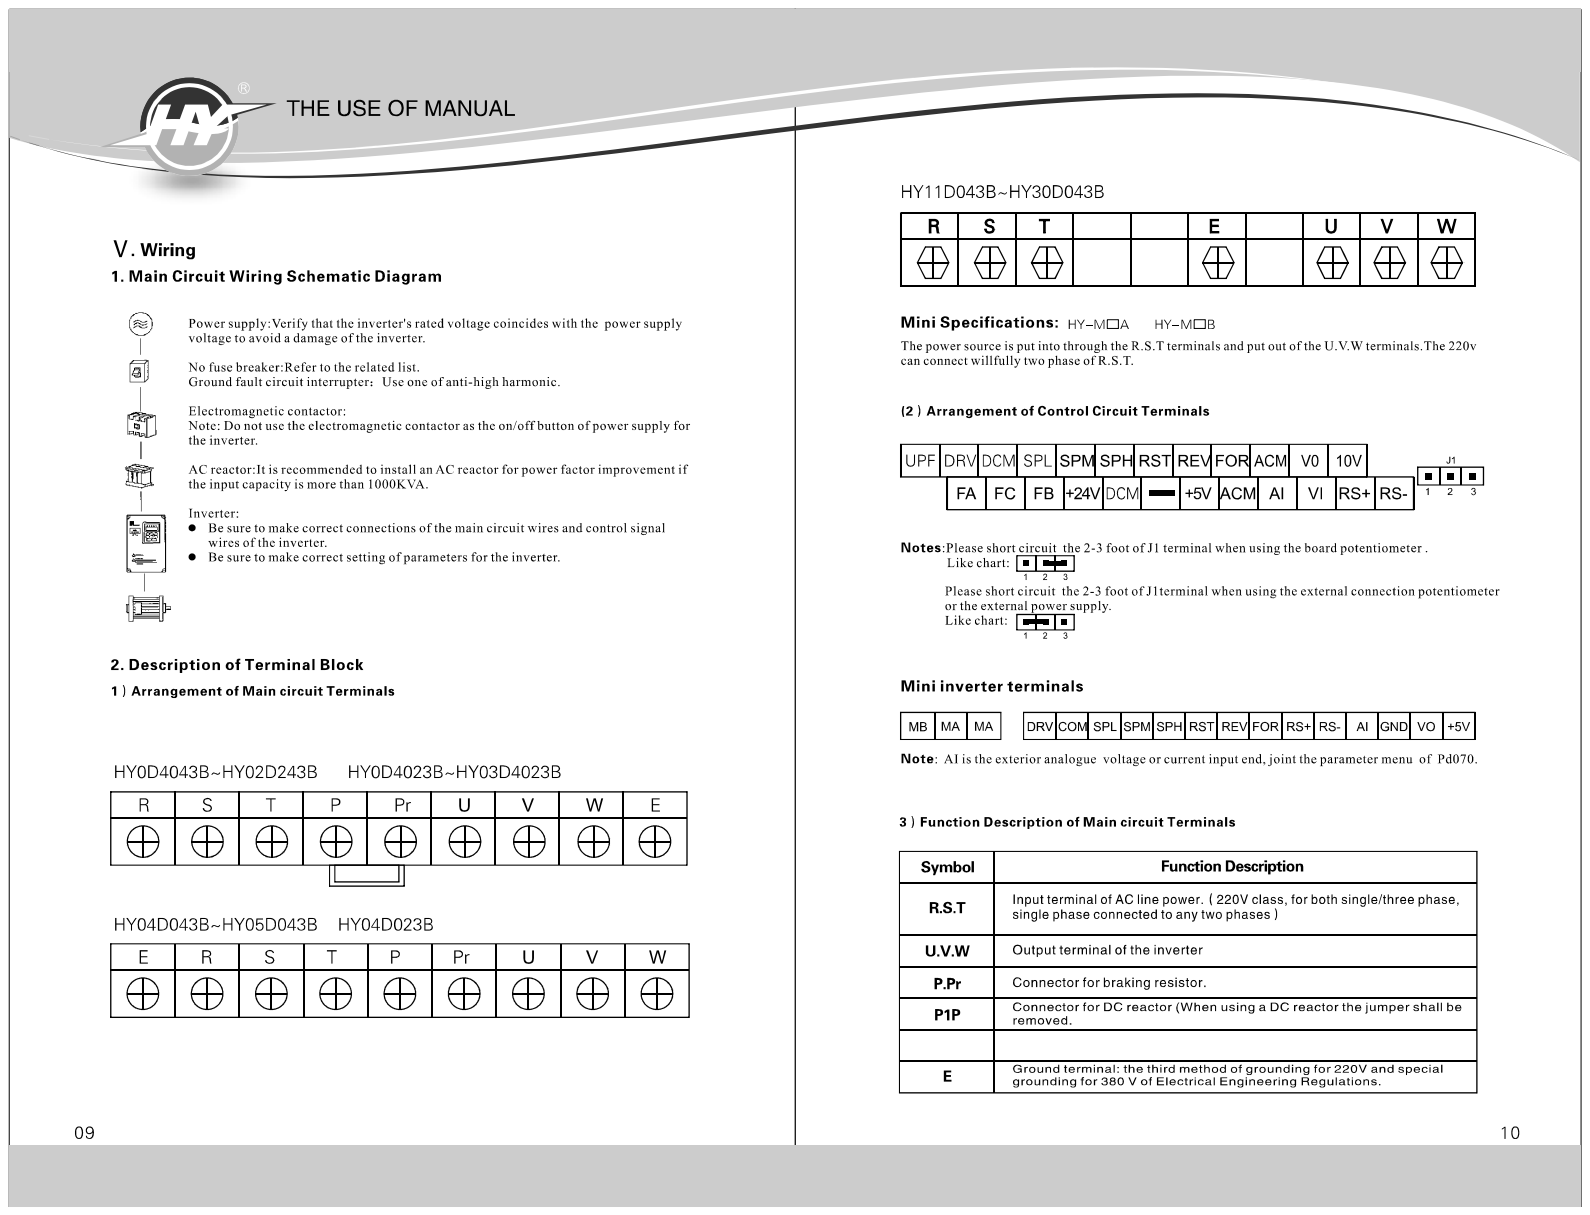
[picture p30: page 7]

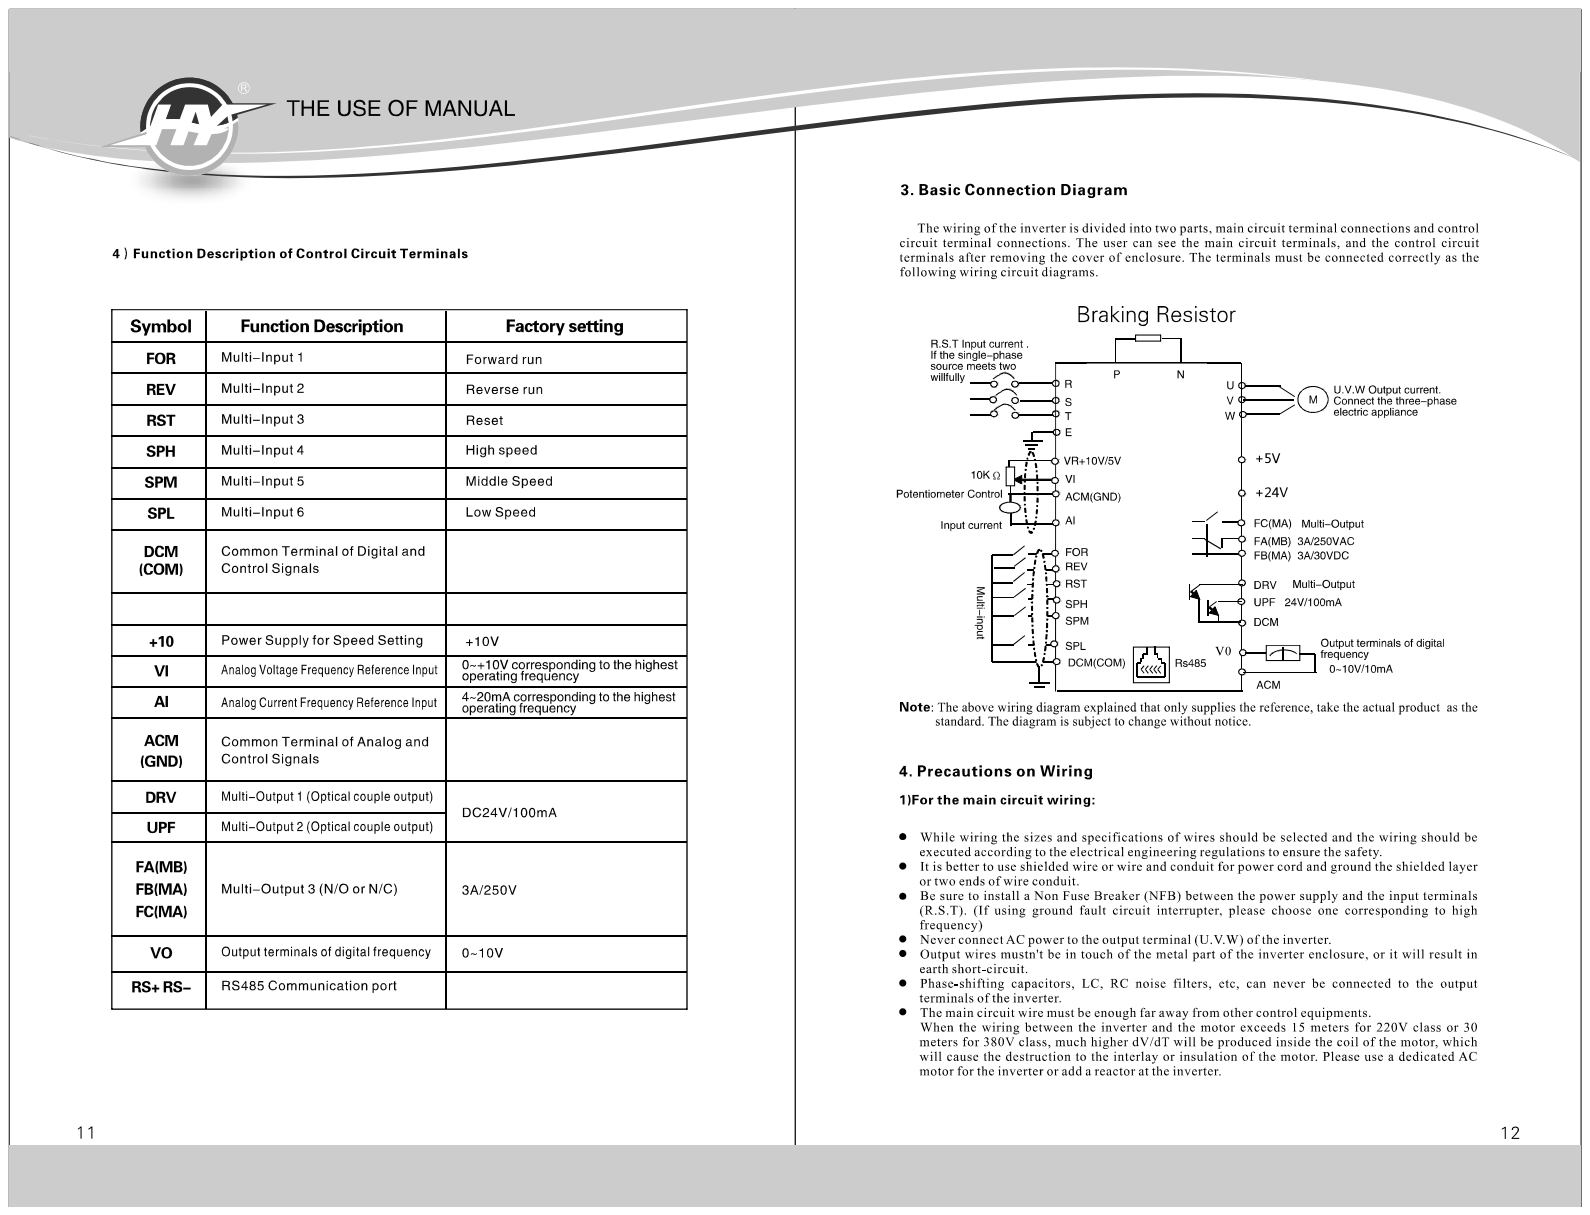
[picture p31: page 8]

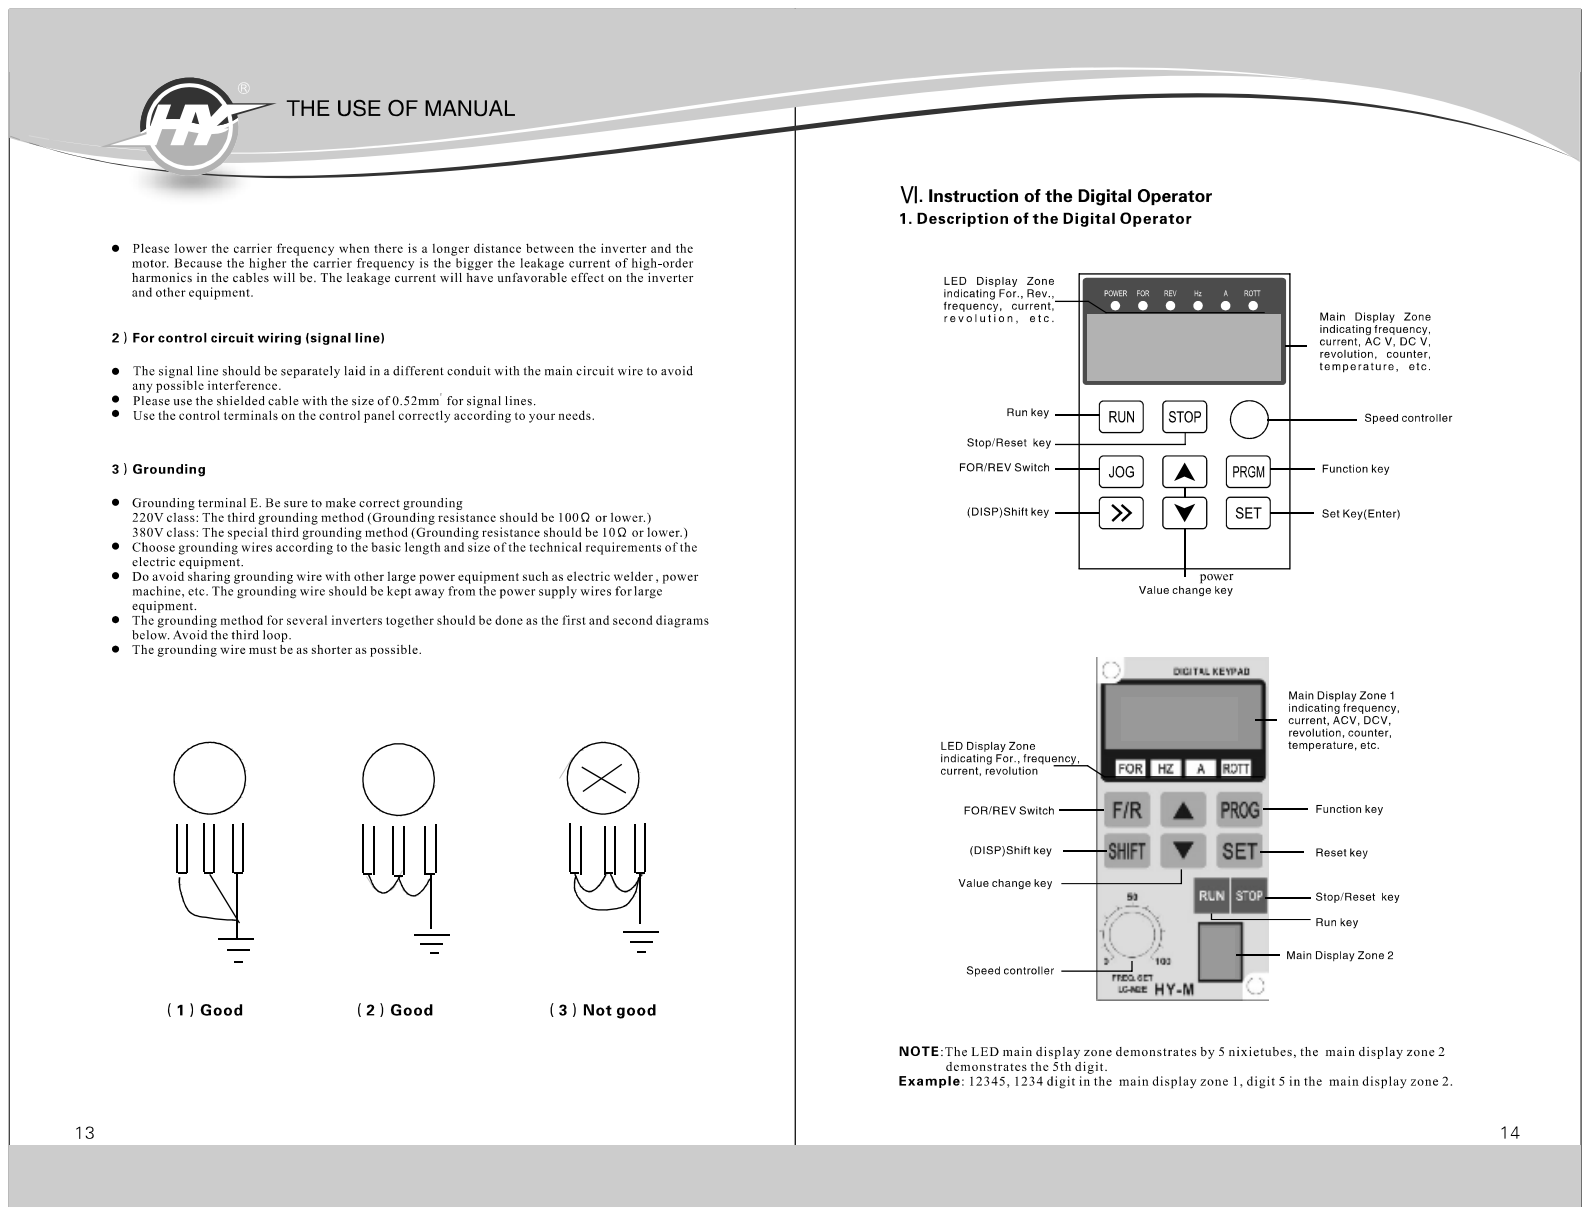
[picture p32: page 9]

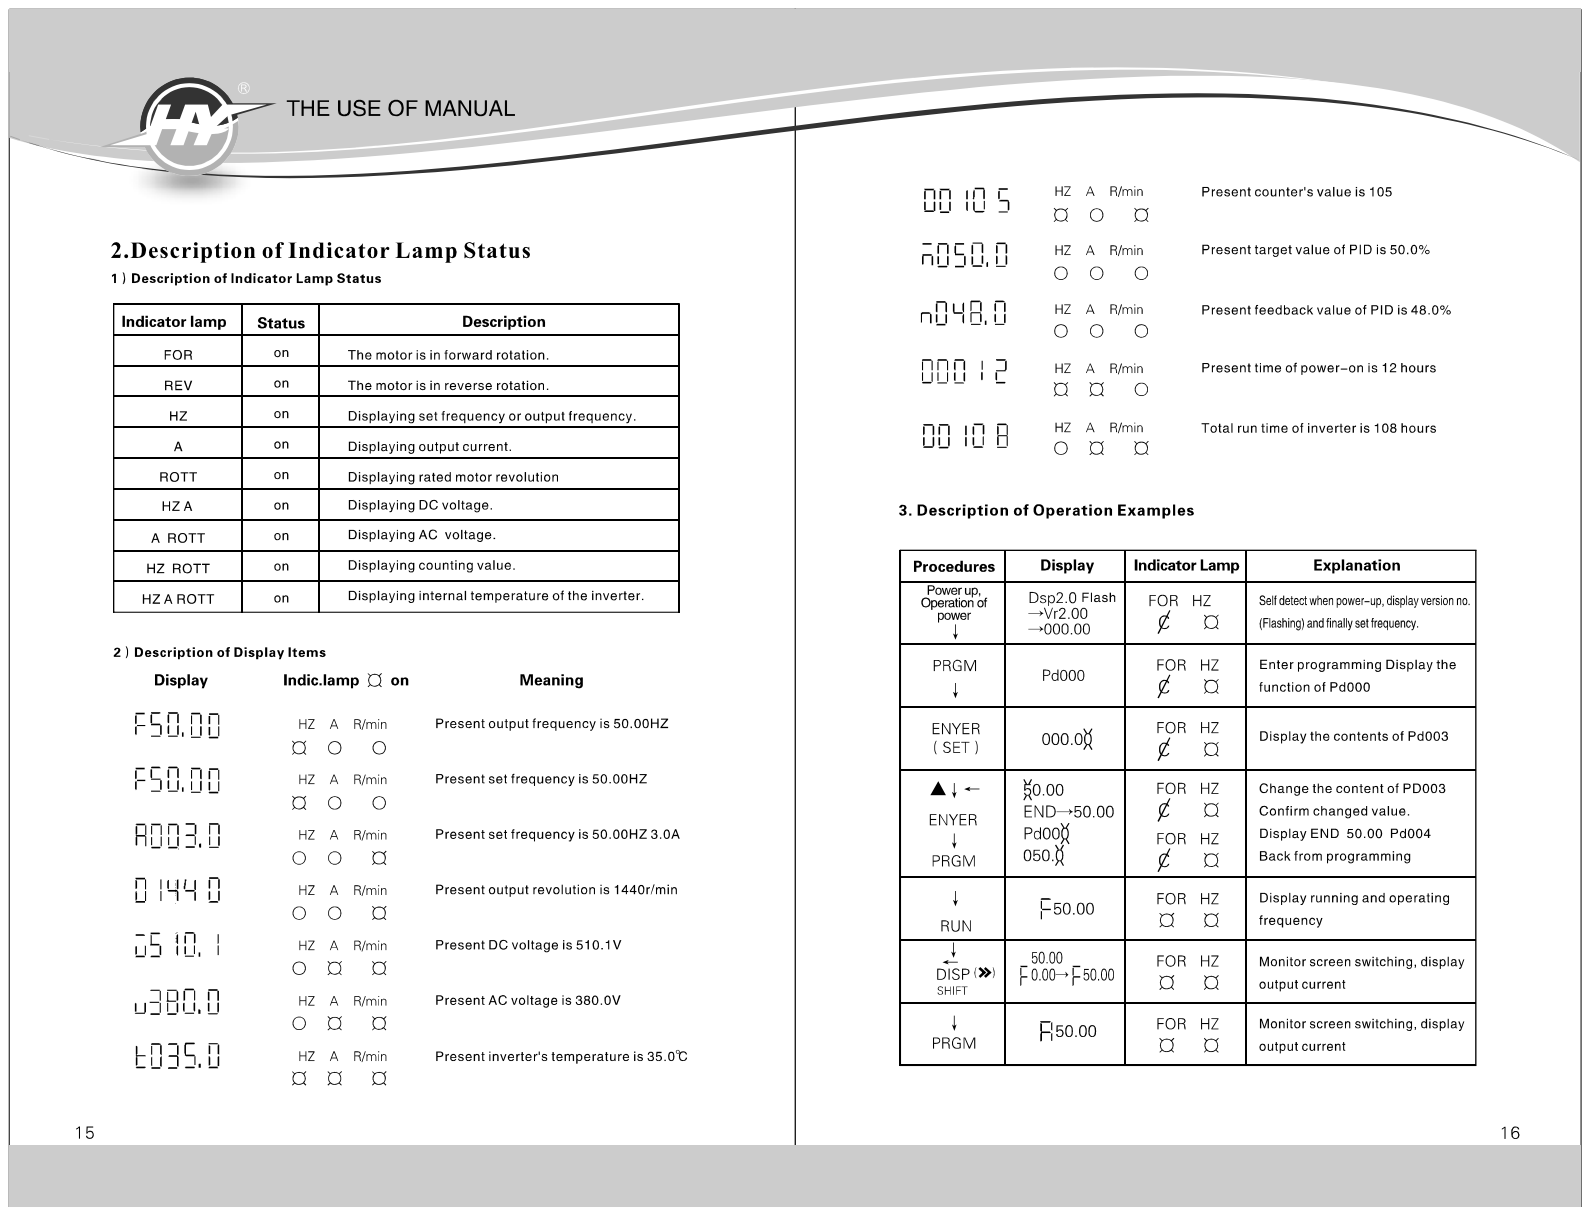
[picture p33: page 10]

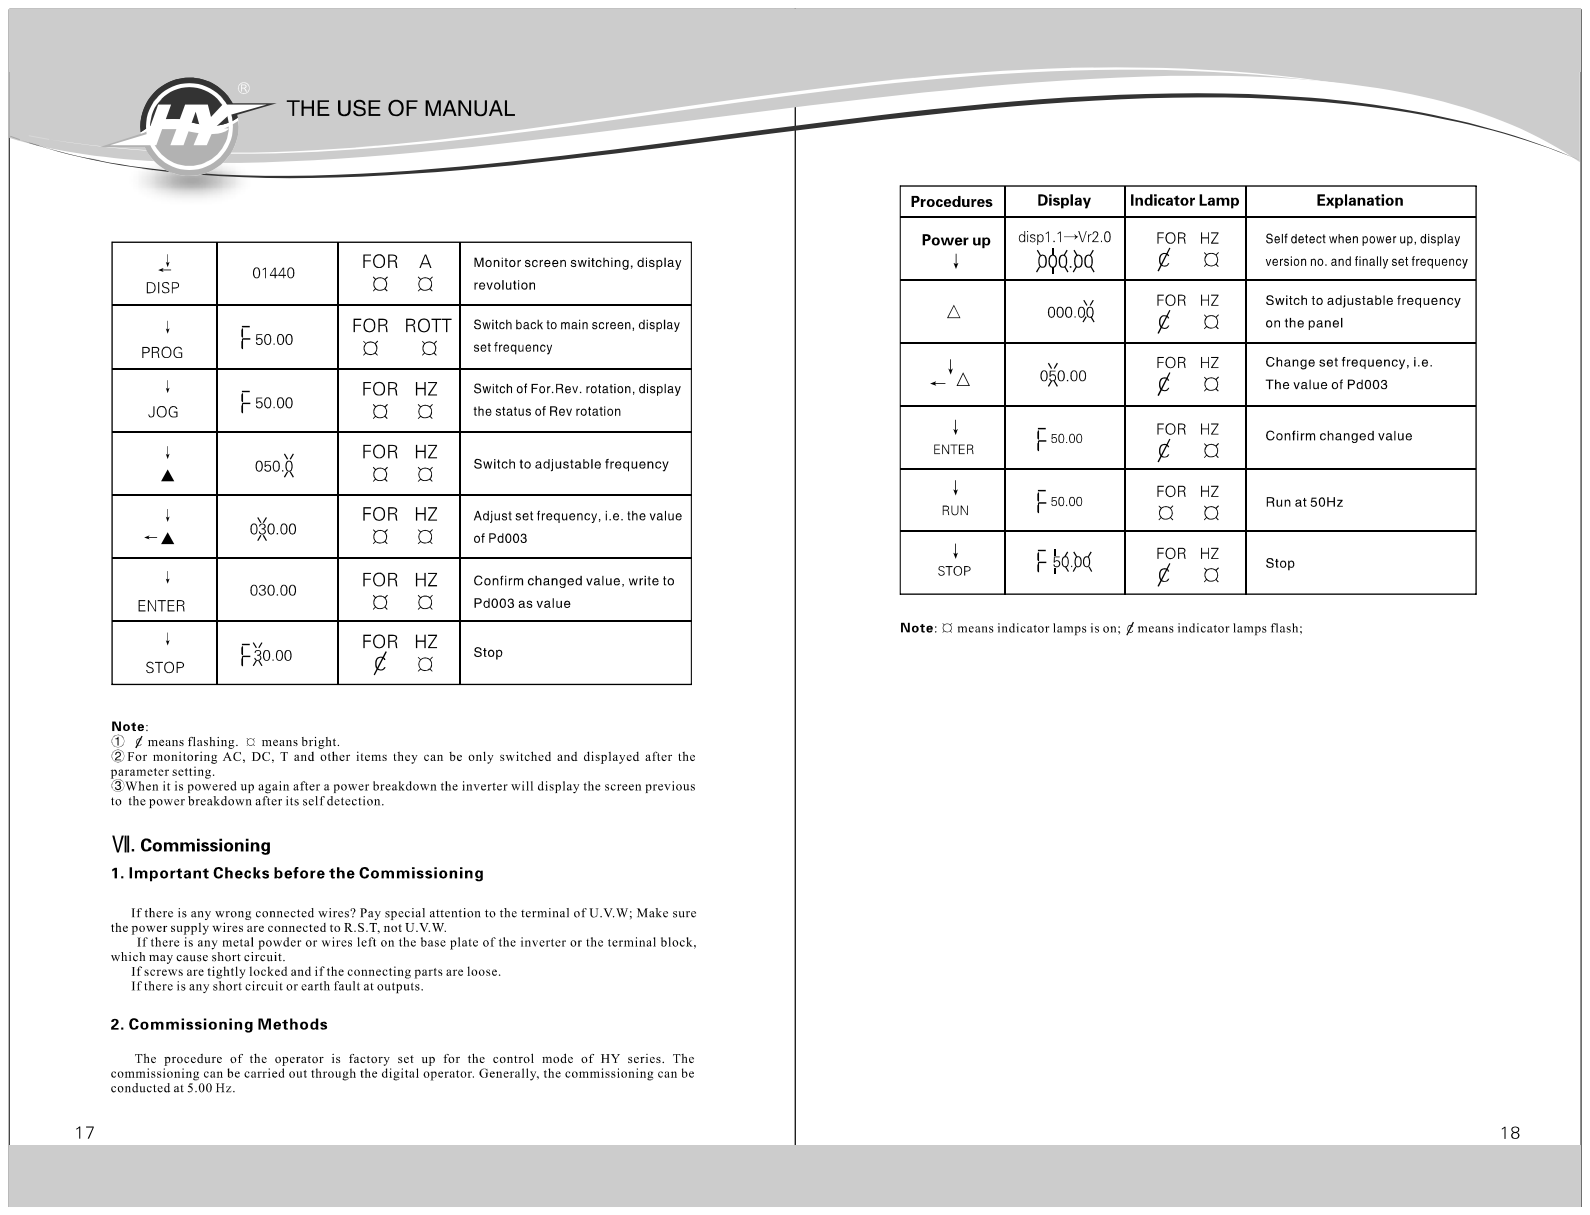
[picture p34: page 11]

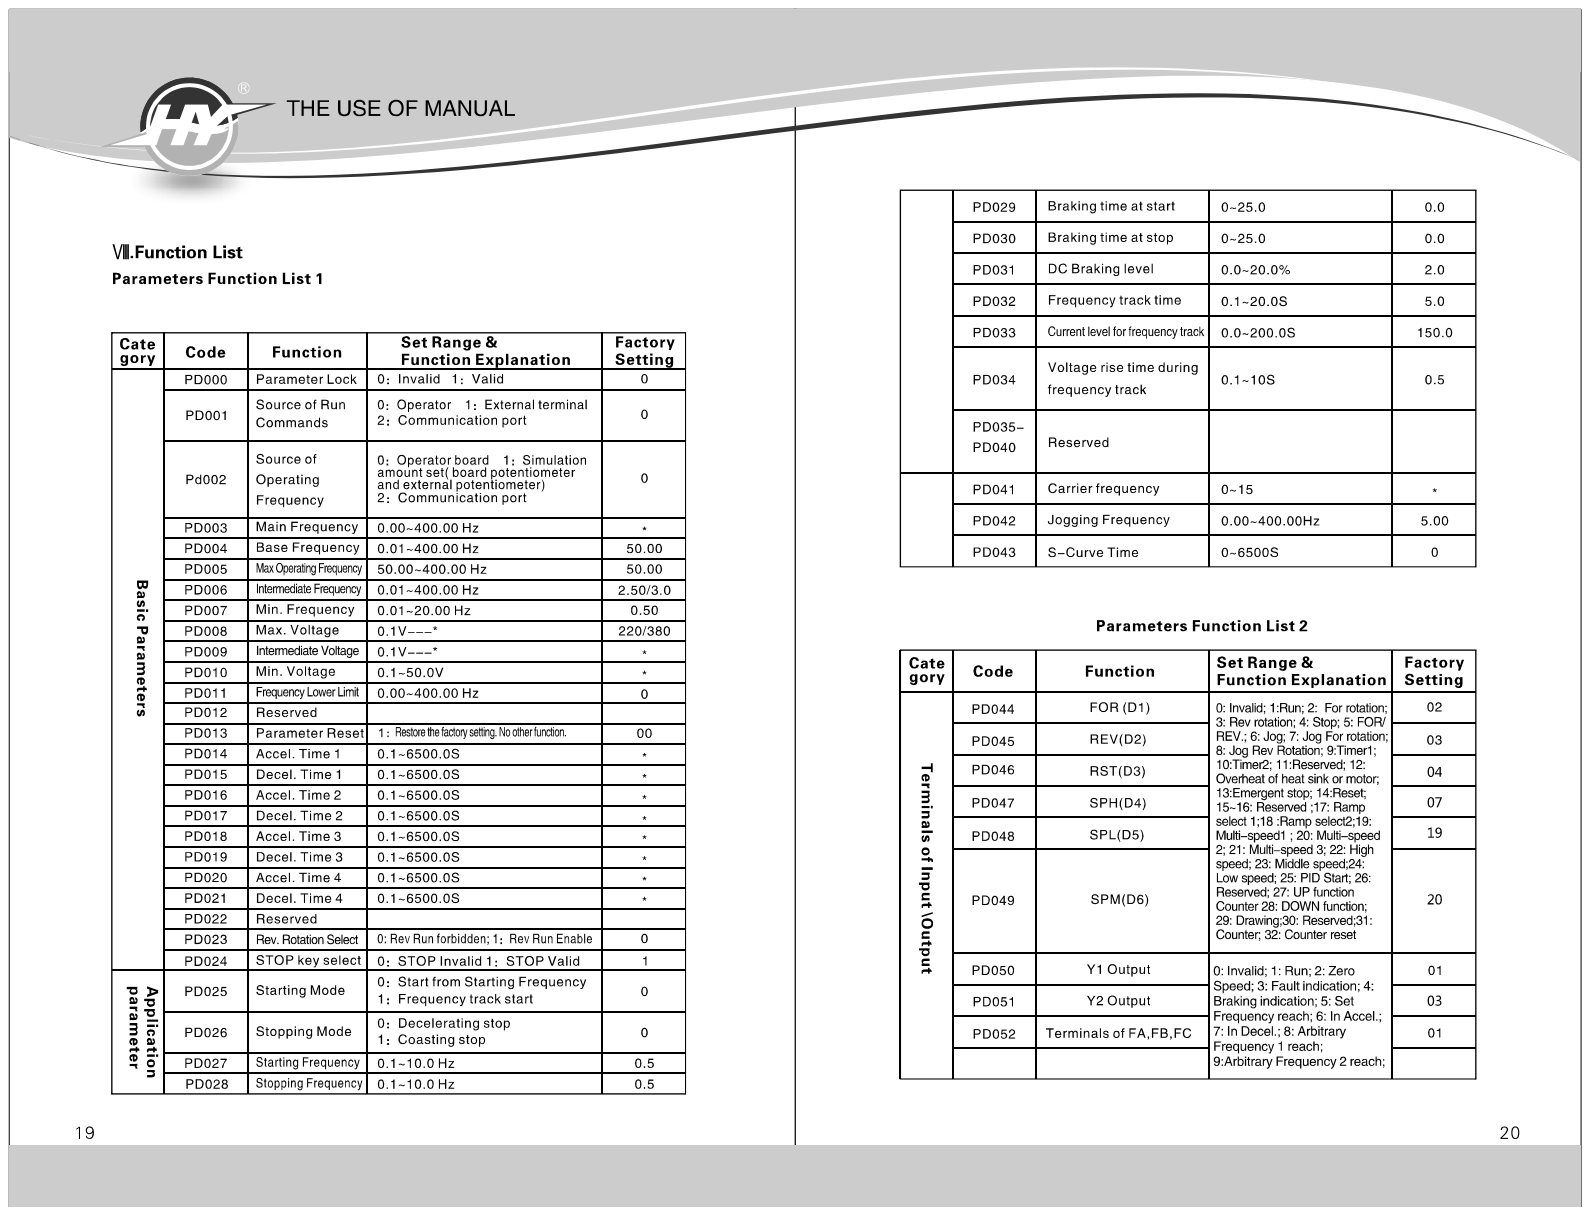
[picture p35: page 12]

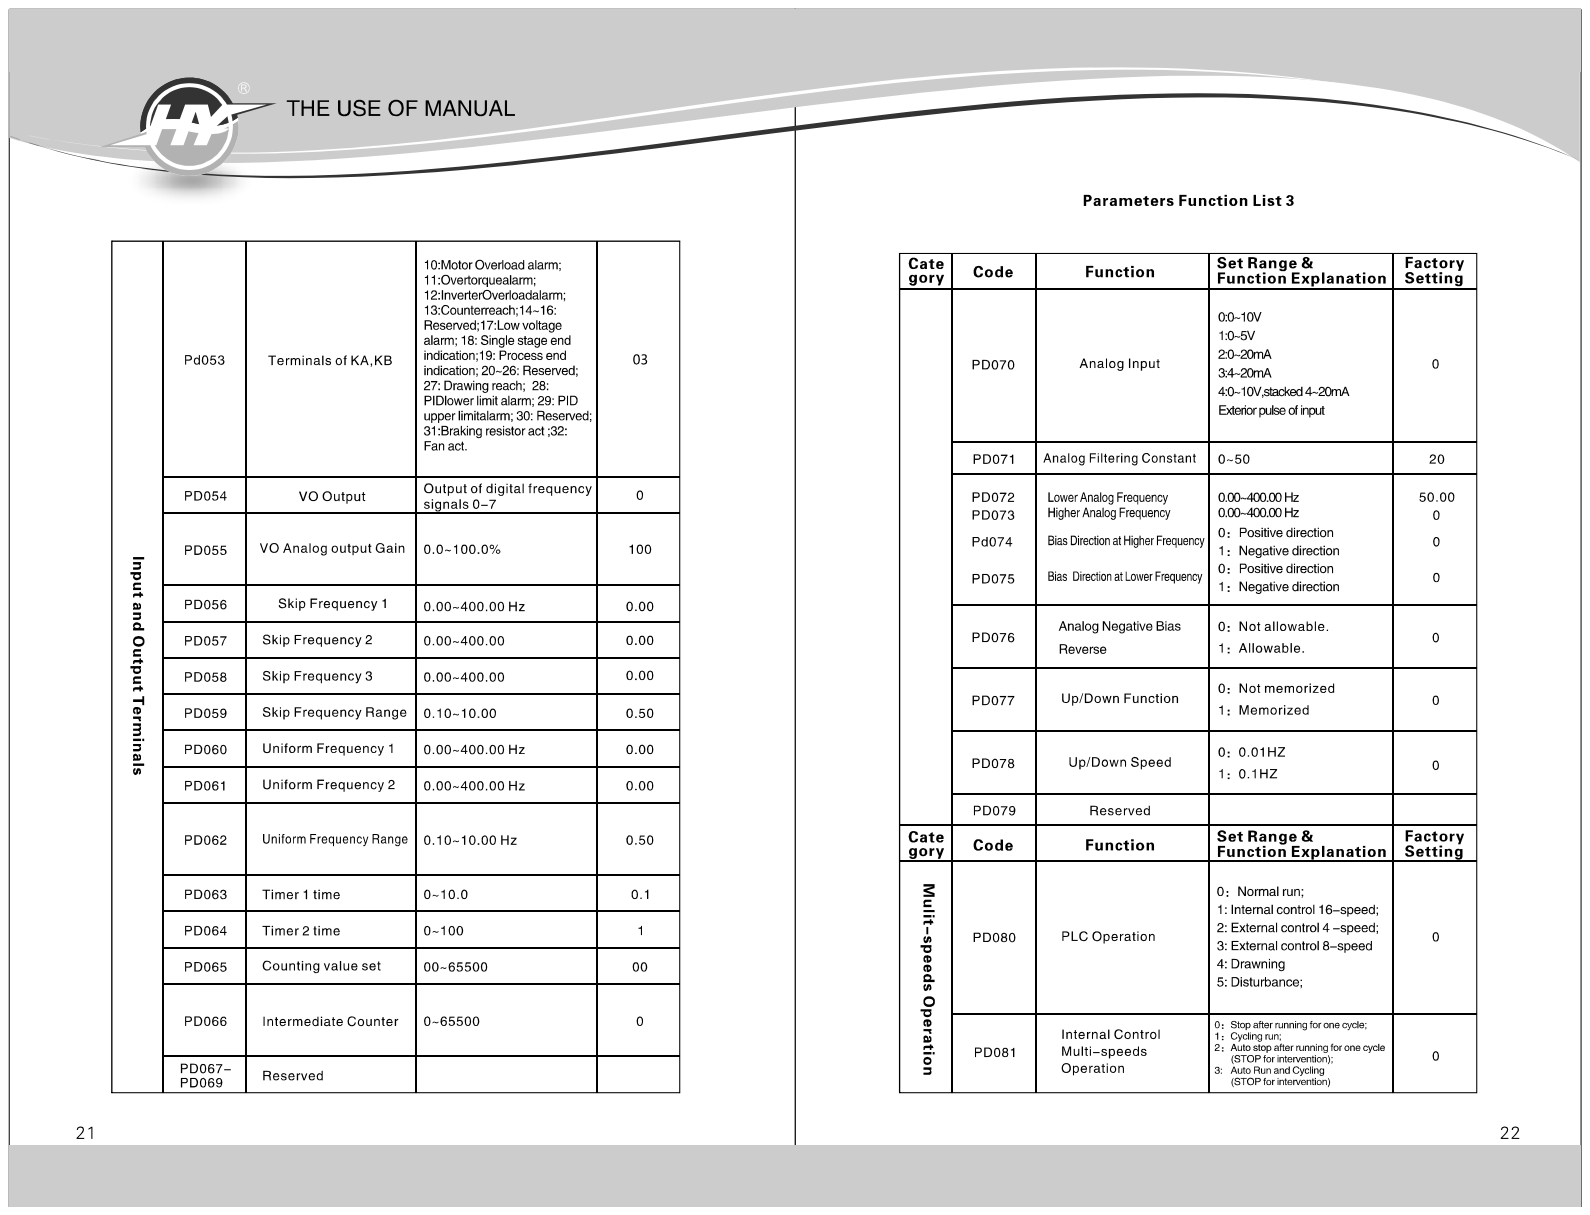
[picture p36: page 13]

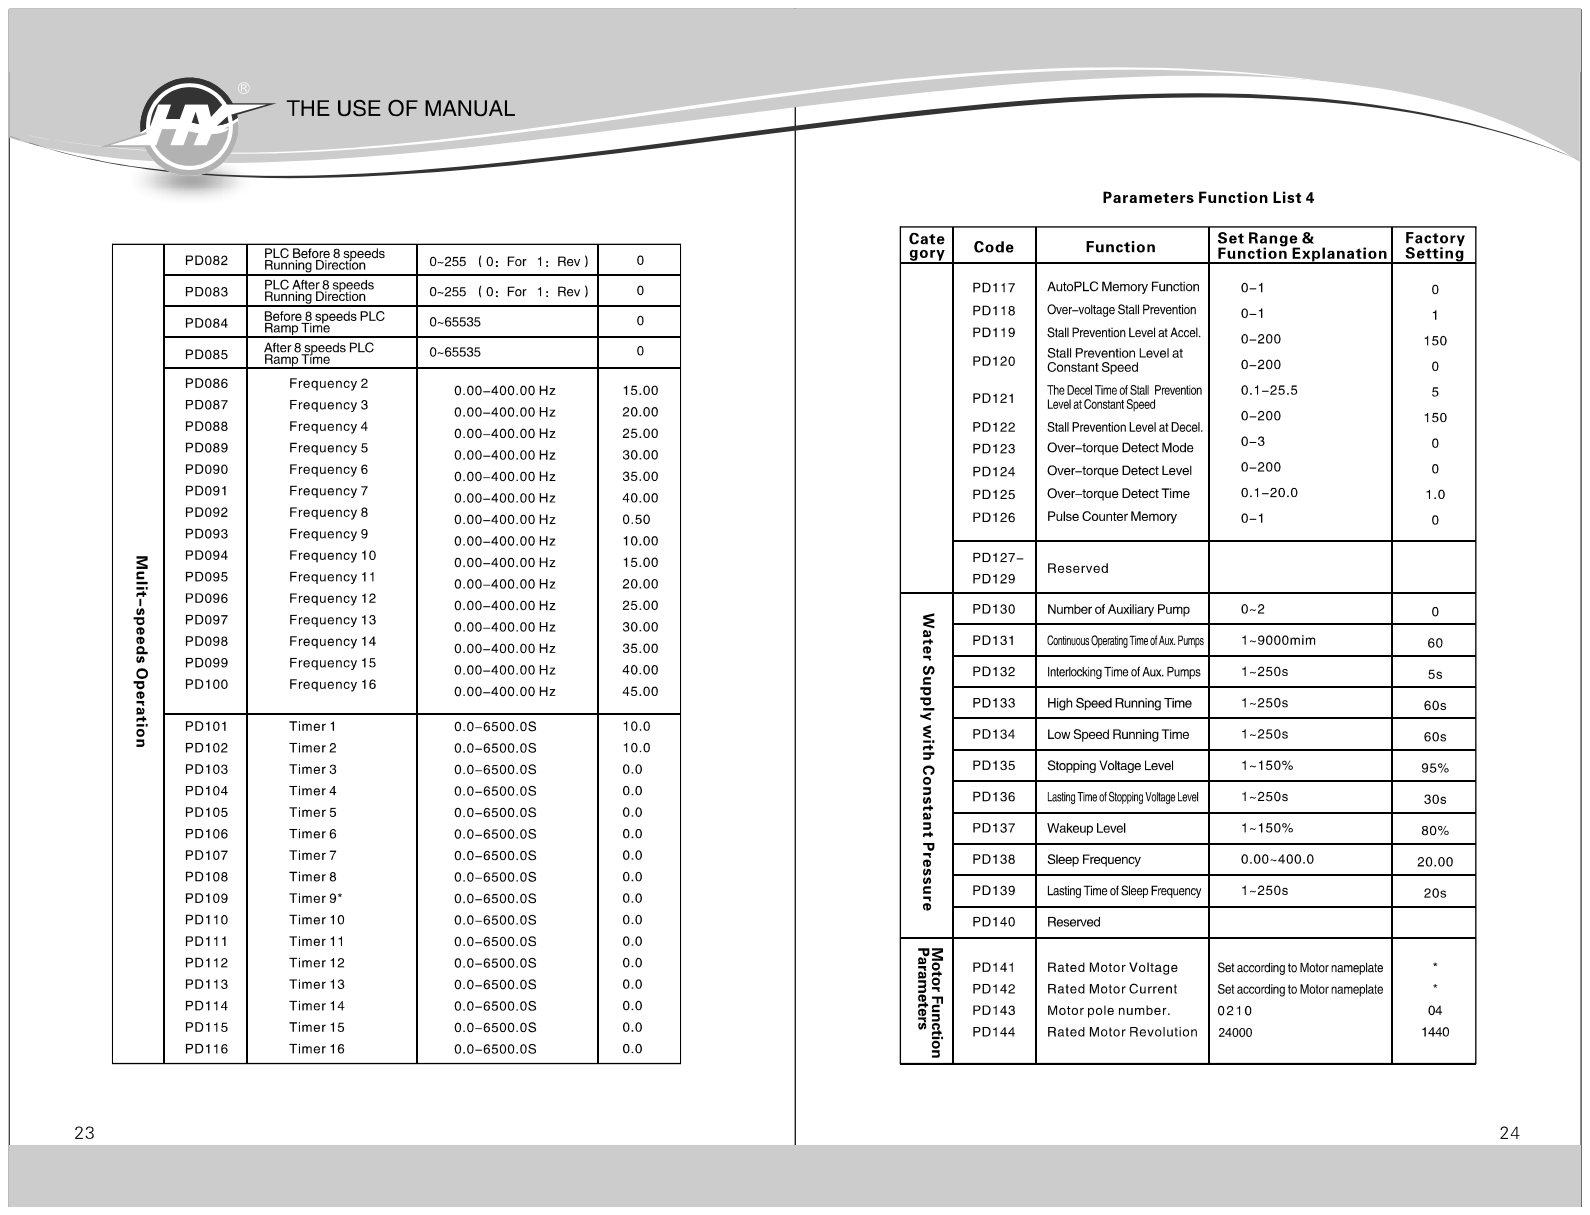
[picture p37: page 14]

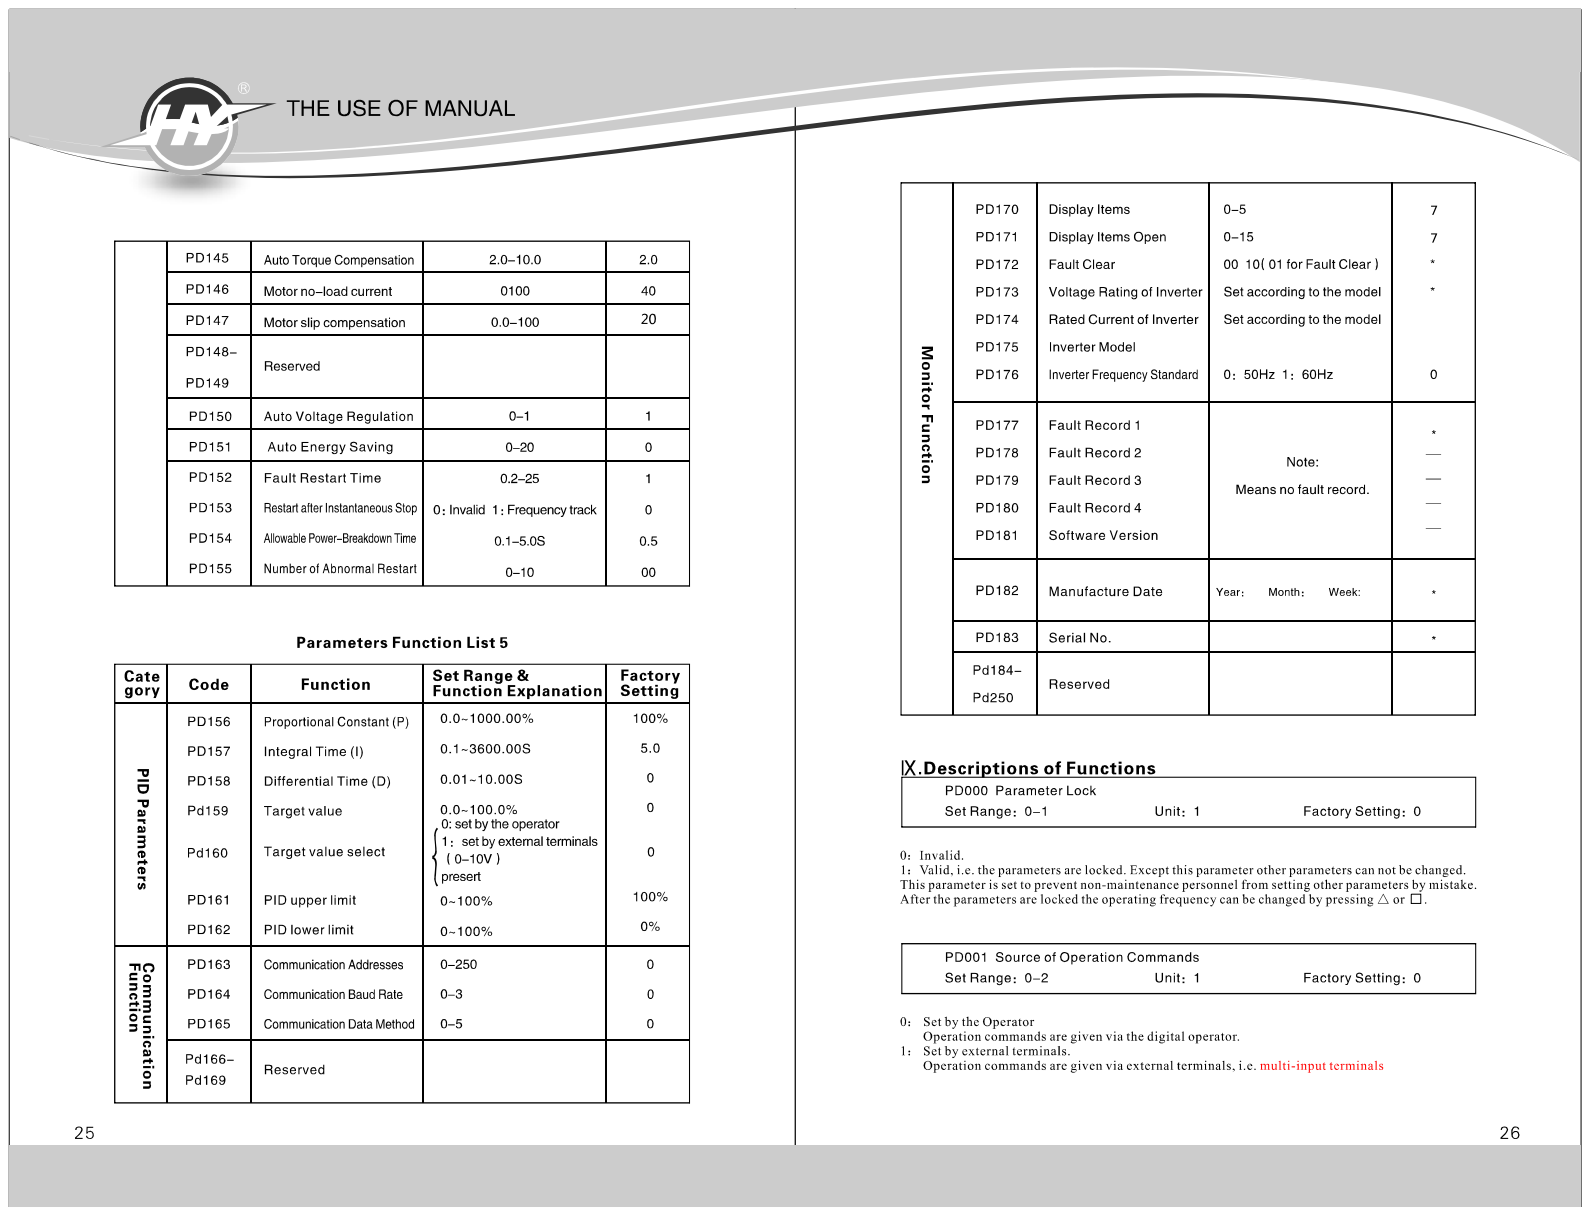
[picture p38: page 15]

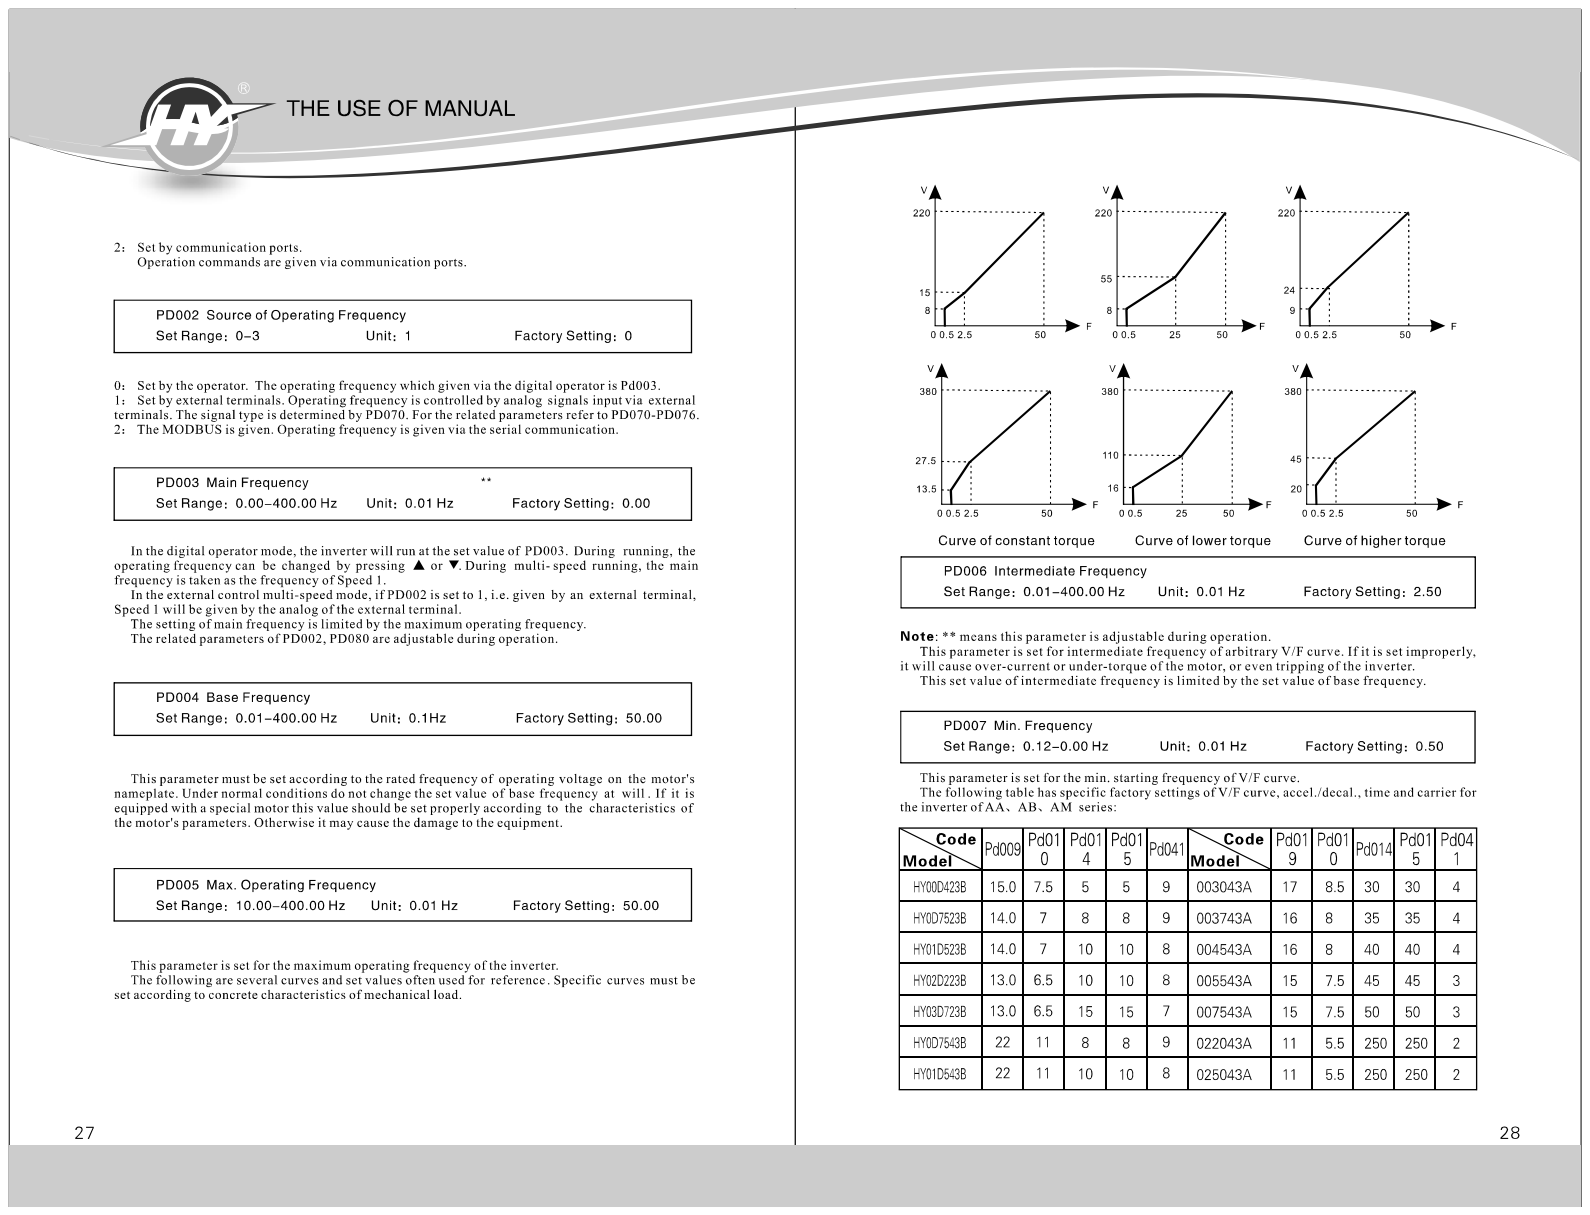
[picture p39: page 16]

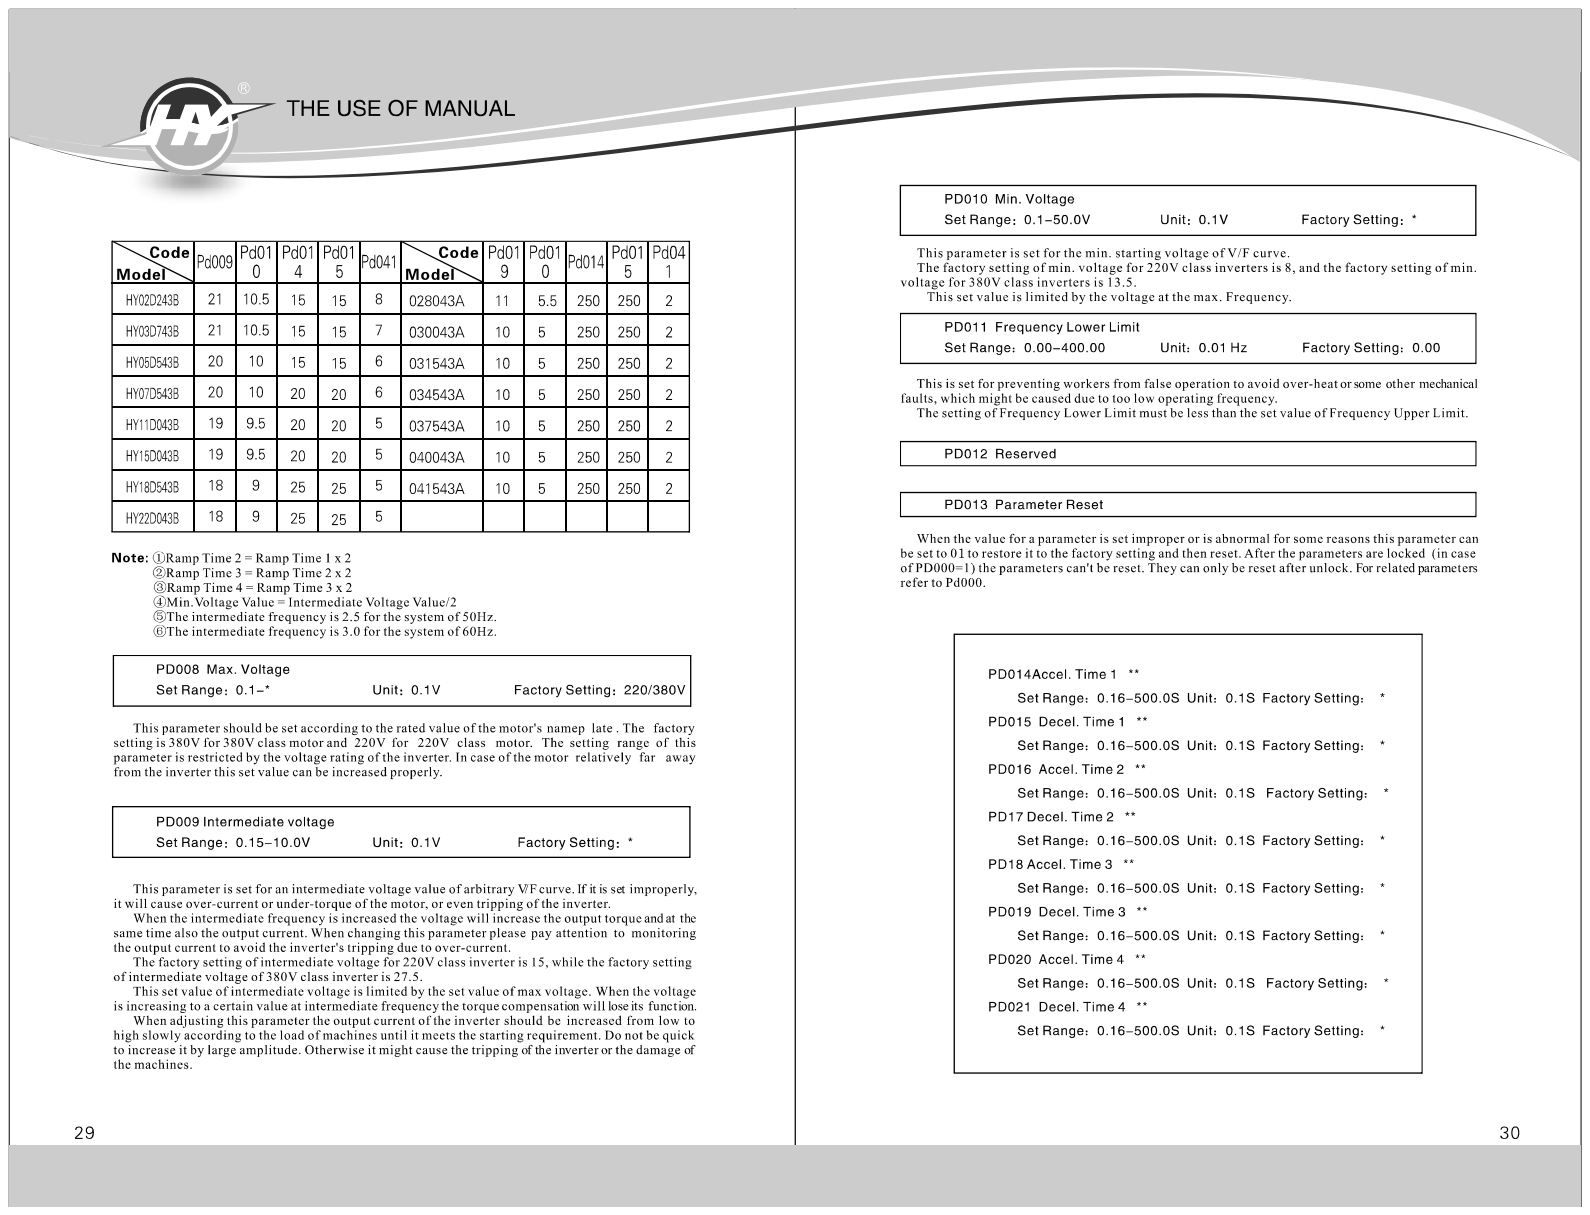
[picture p40: page 17]

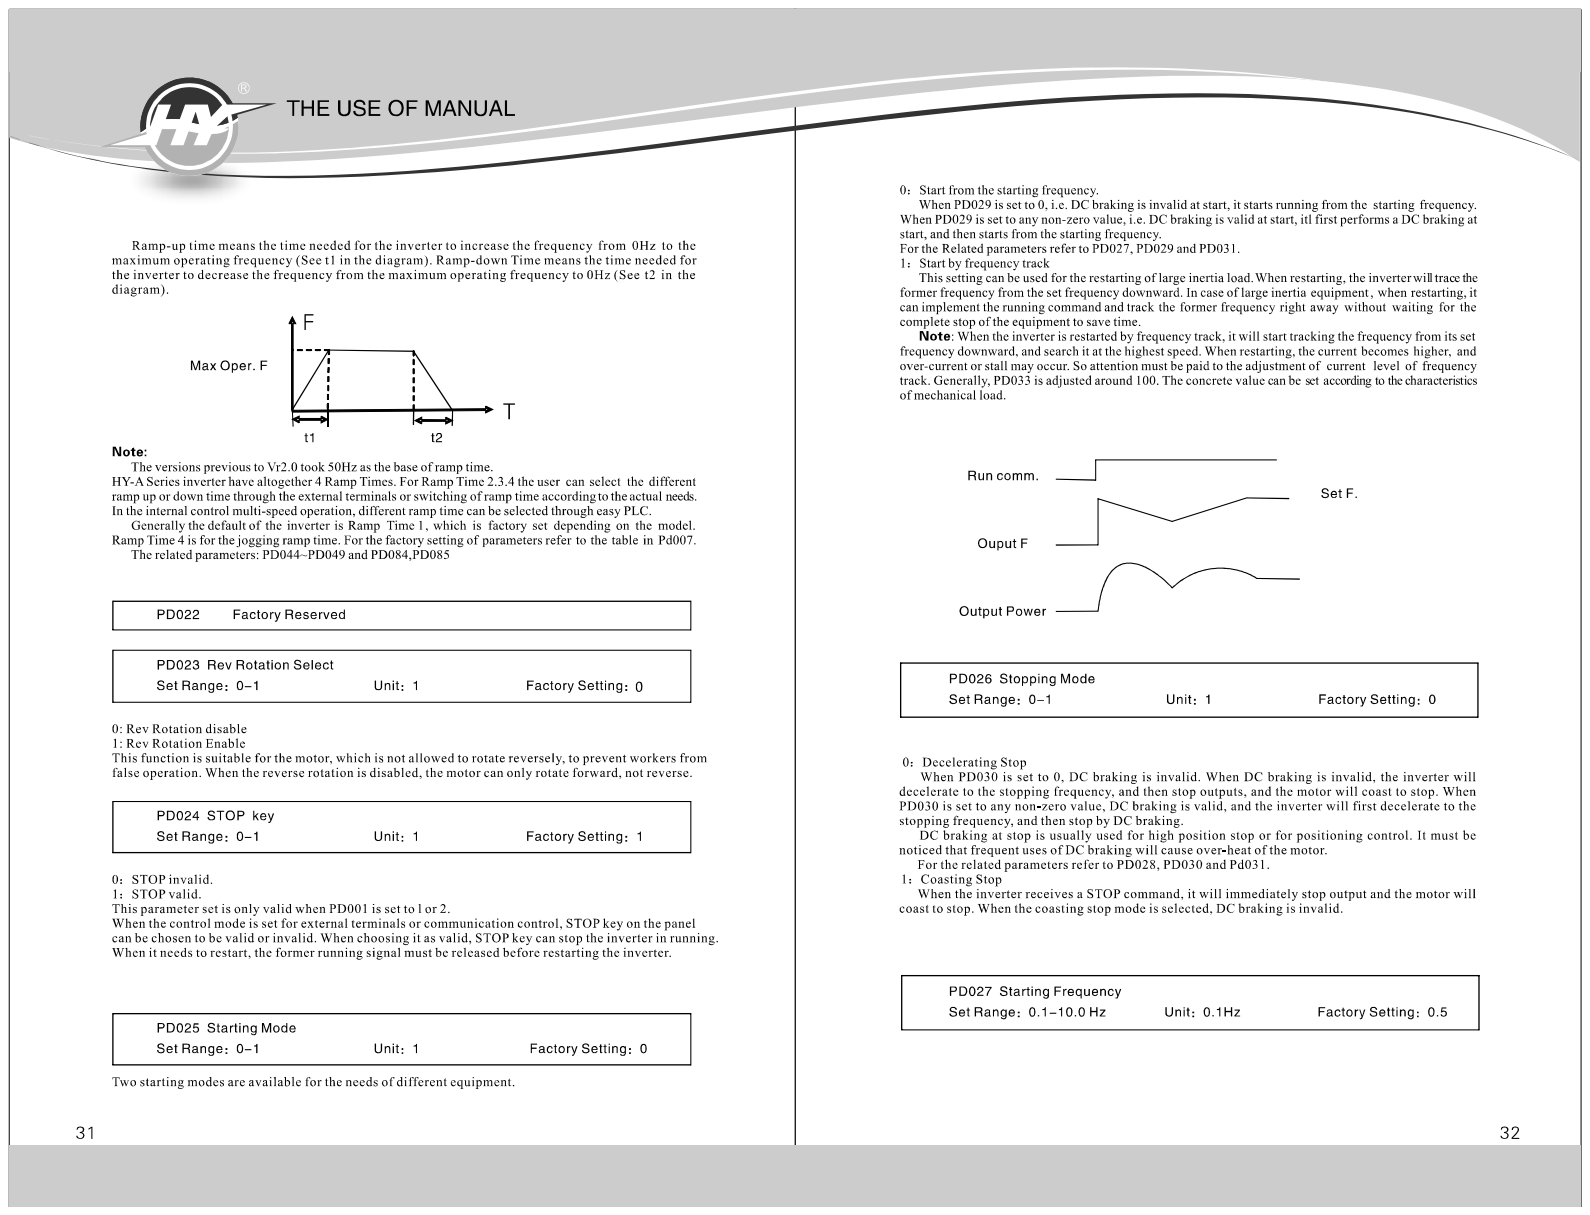
[picture p41: page 18]

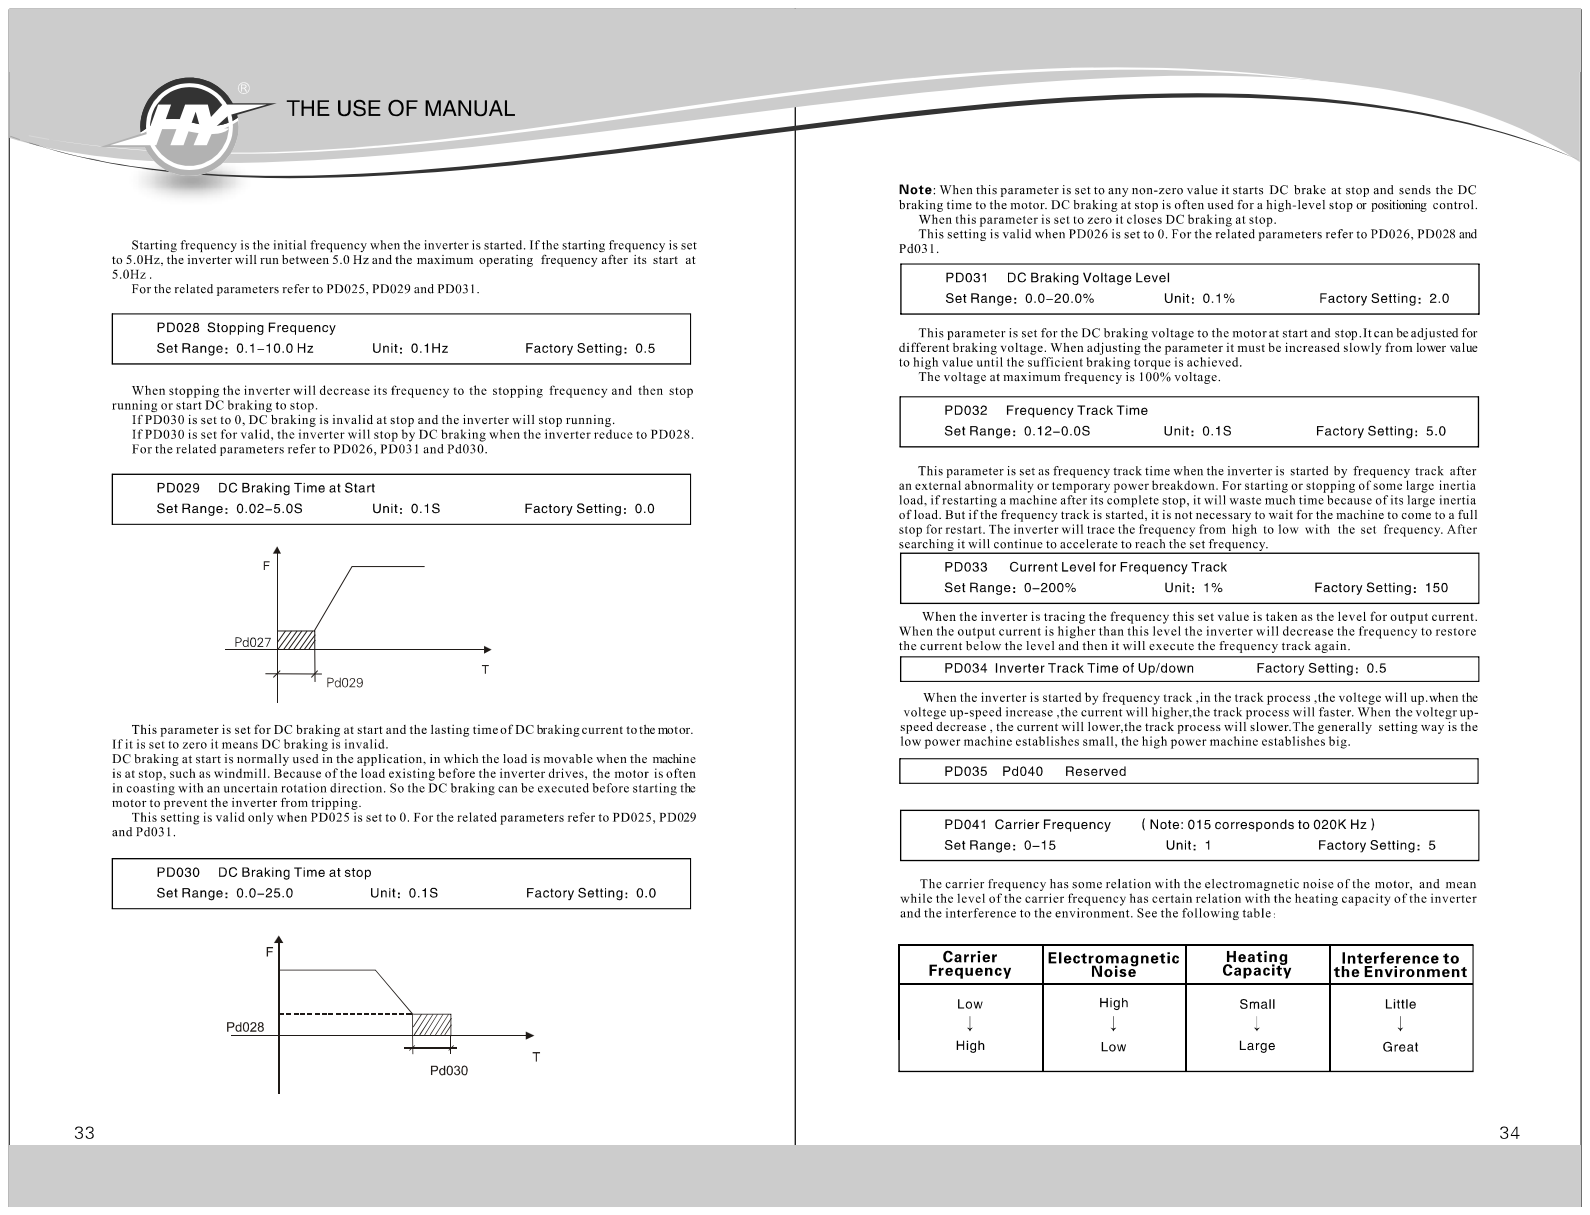
[picture p42: page 19]

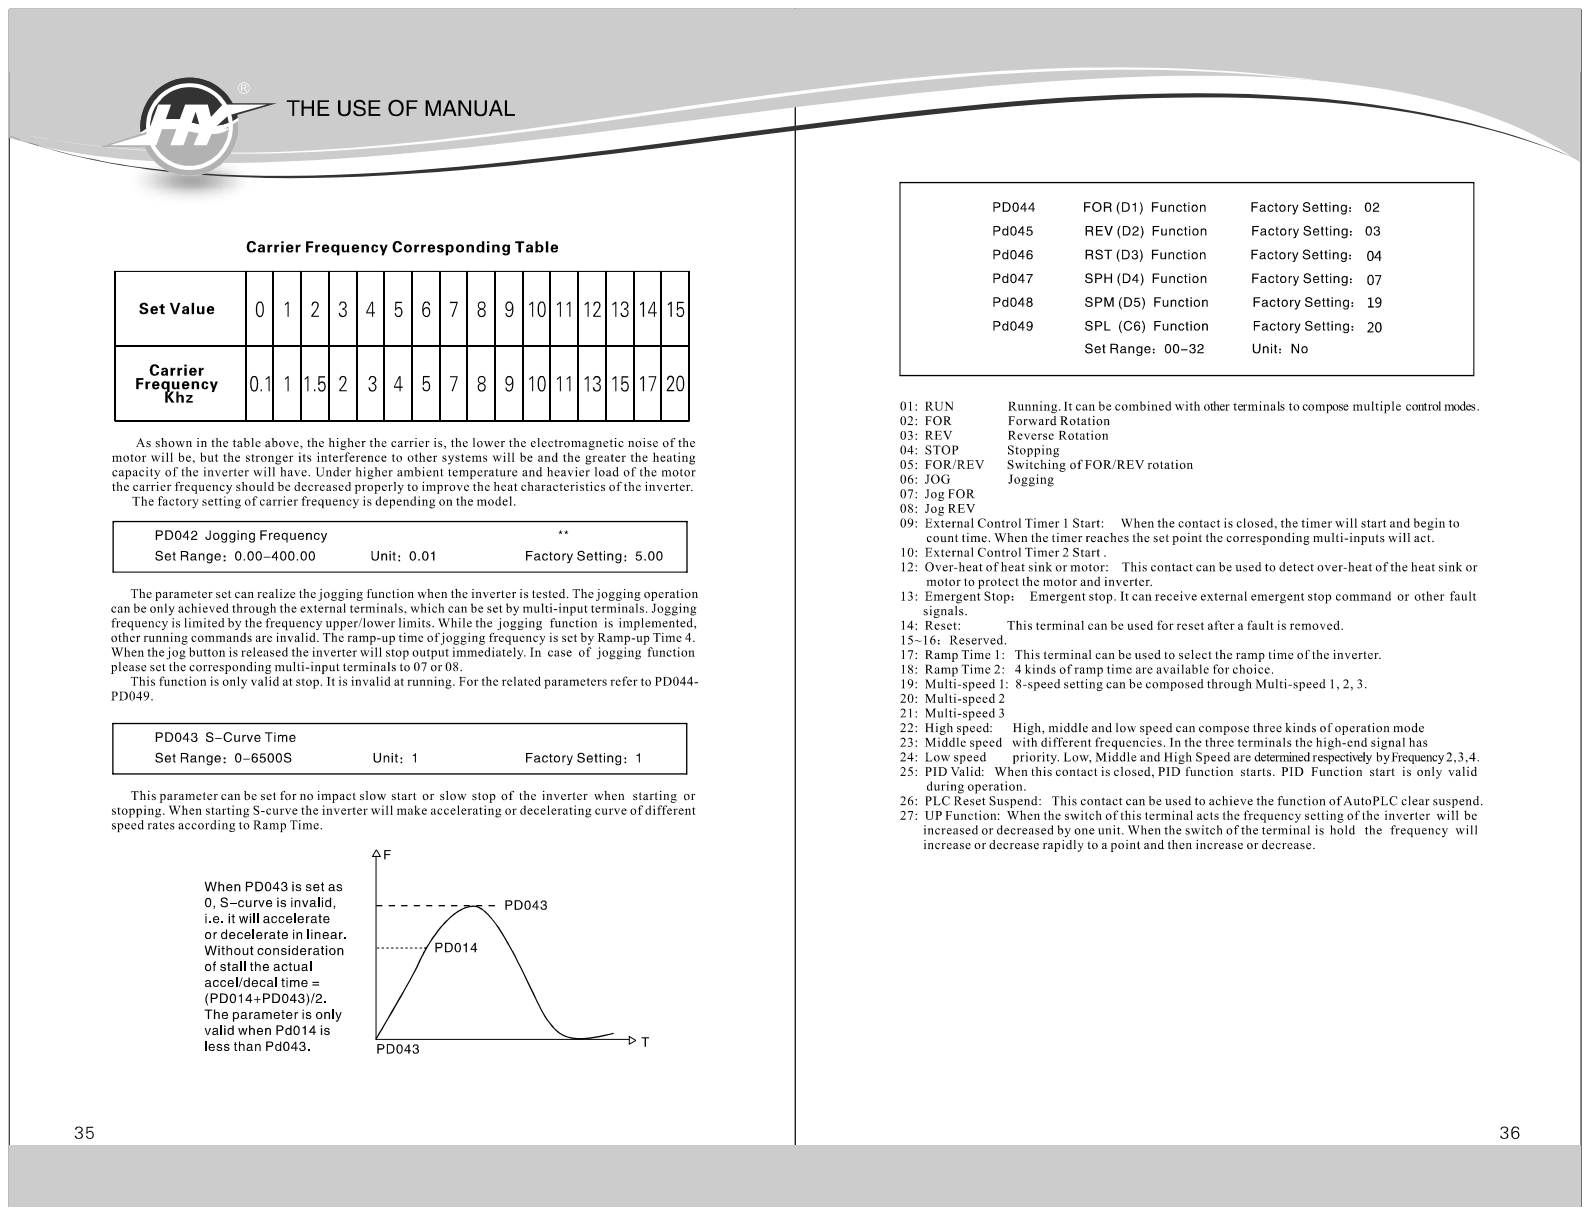
[picture p43: page 20]

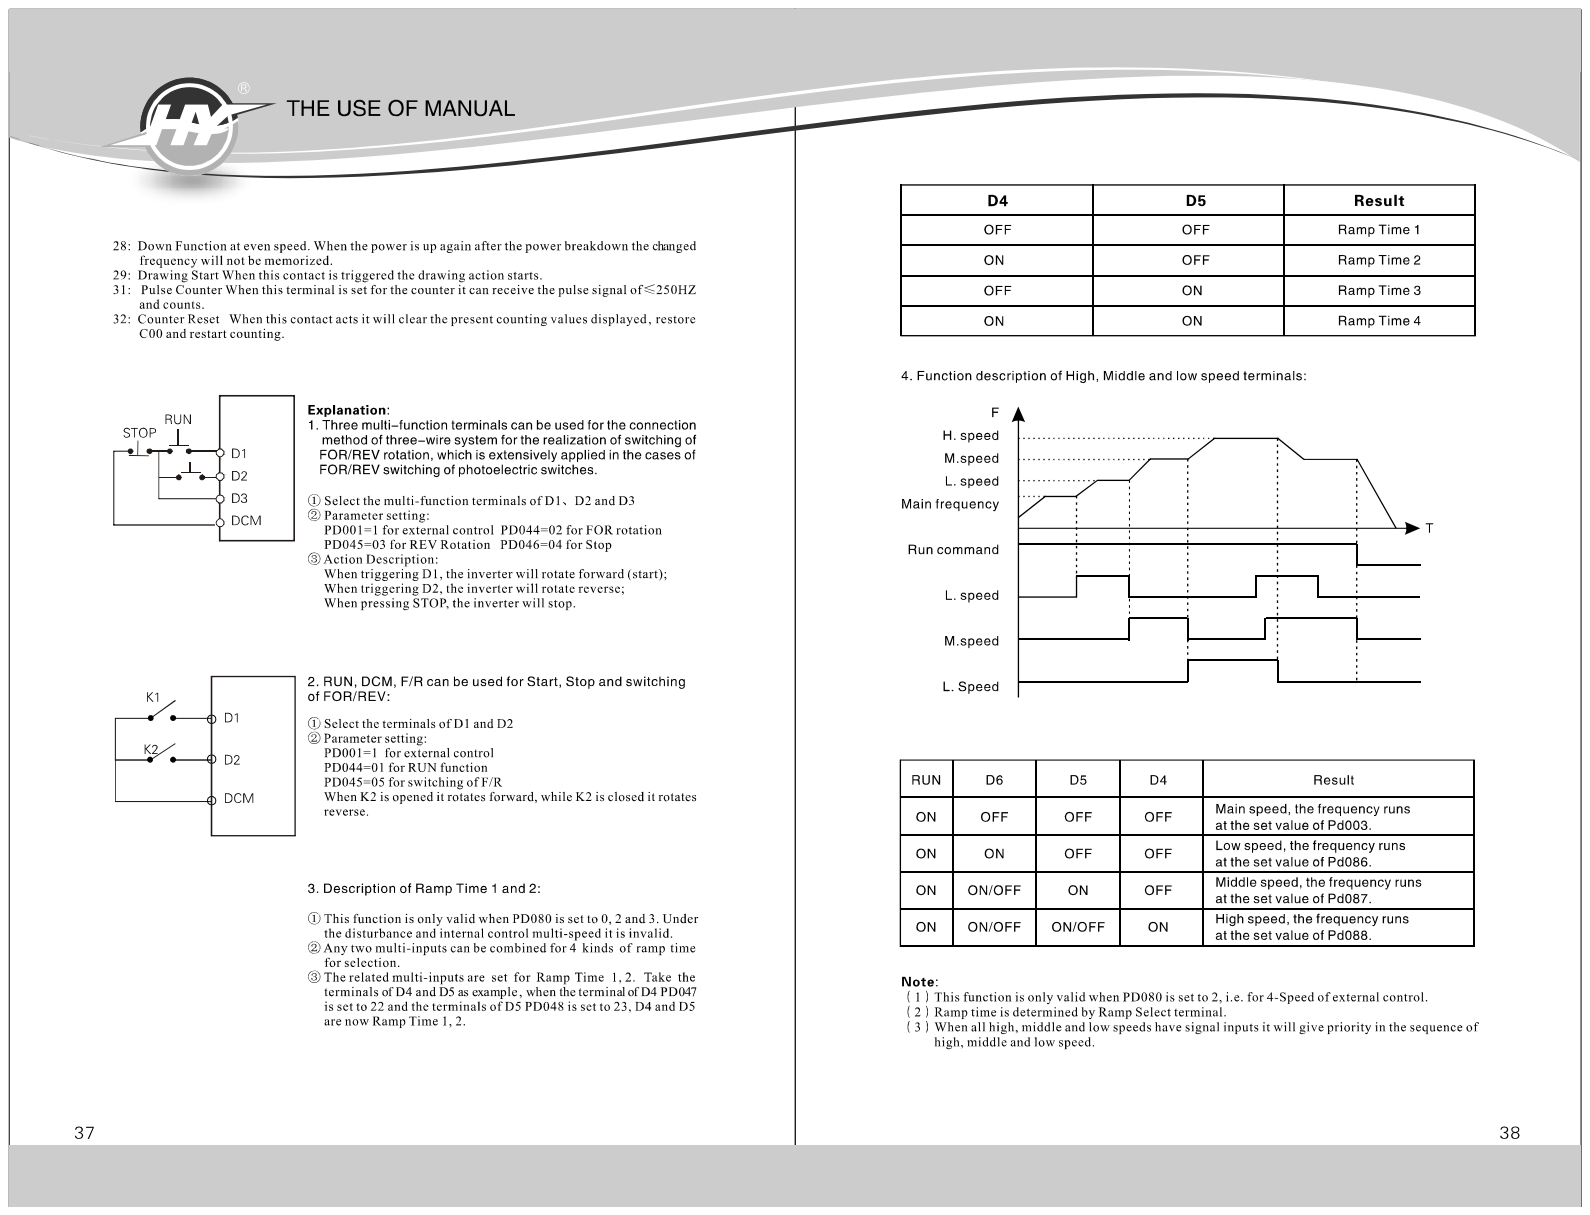
[picture p44: page 21]

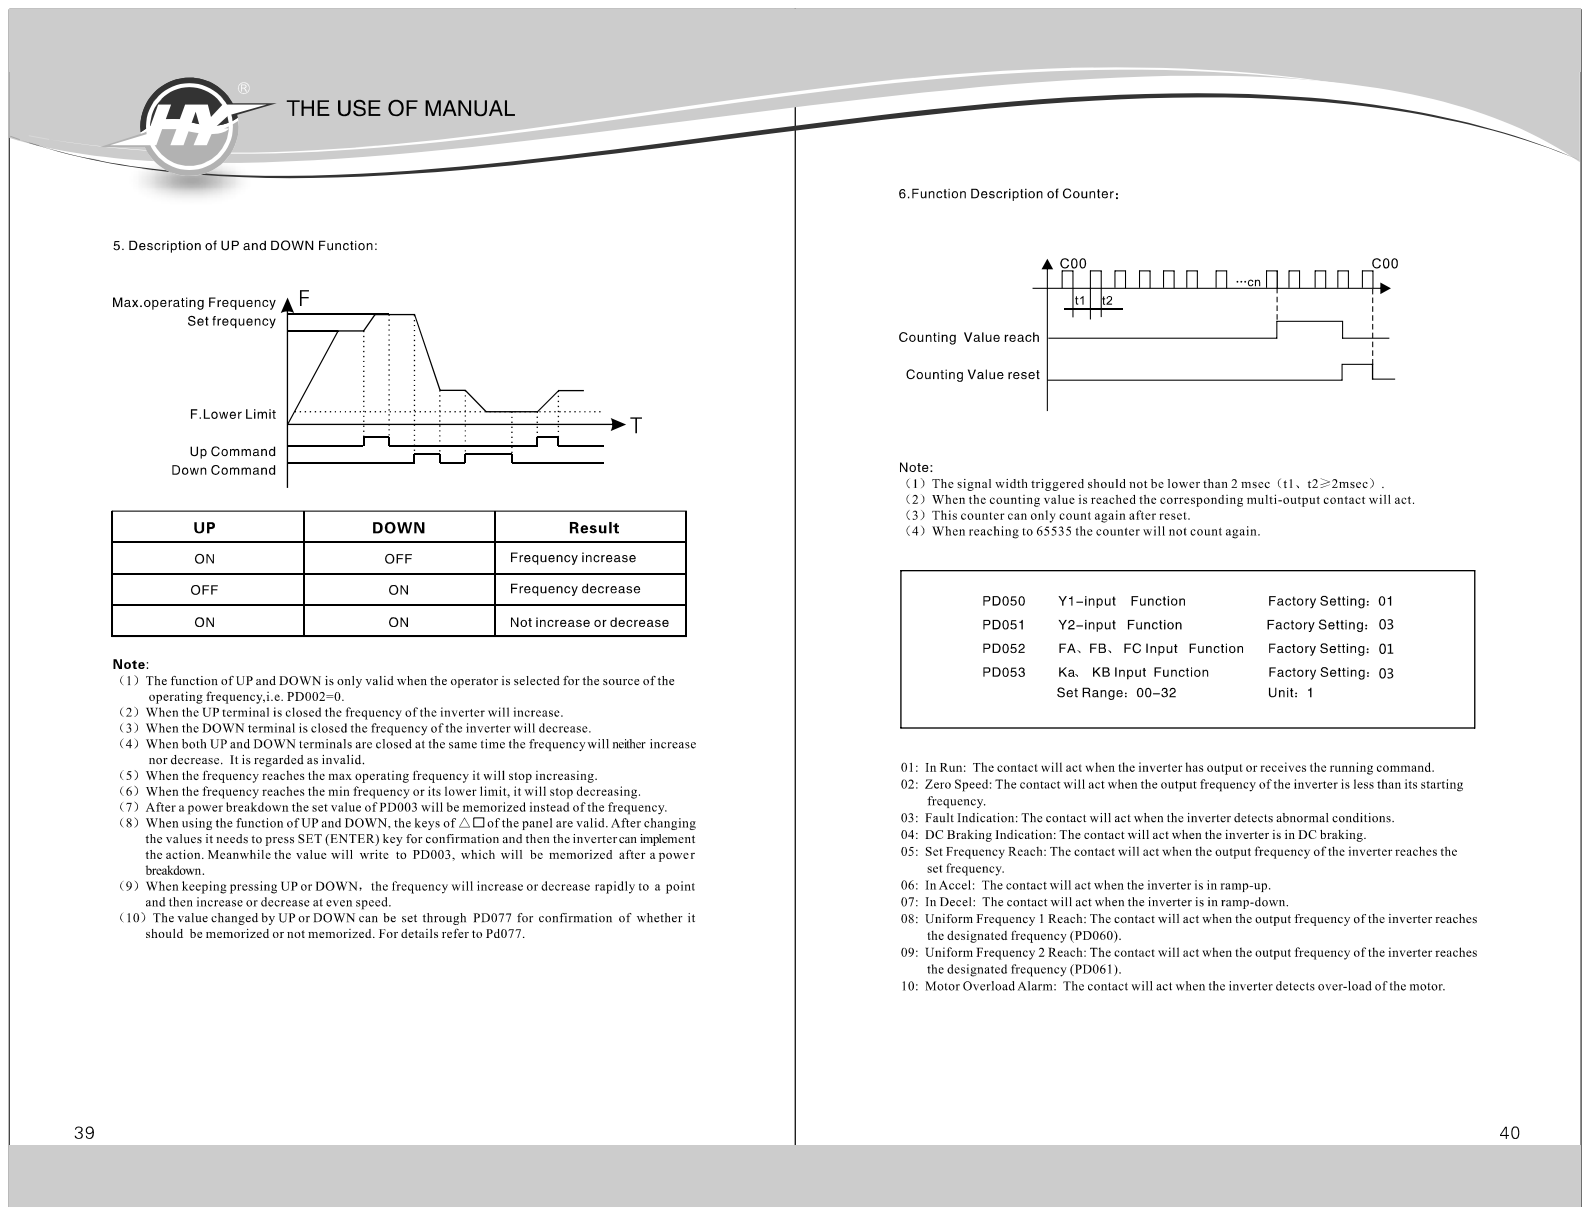
[picture p45: page 22]

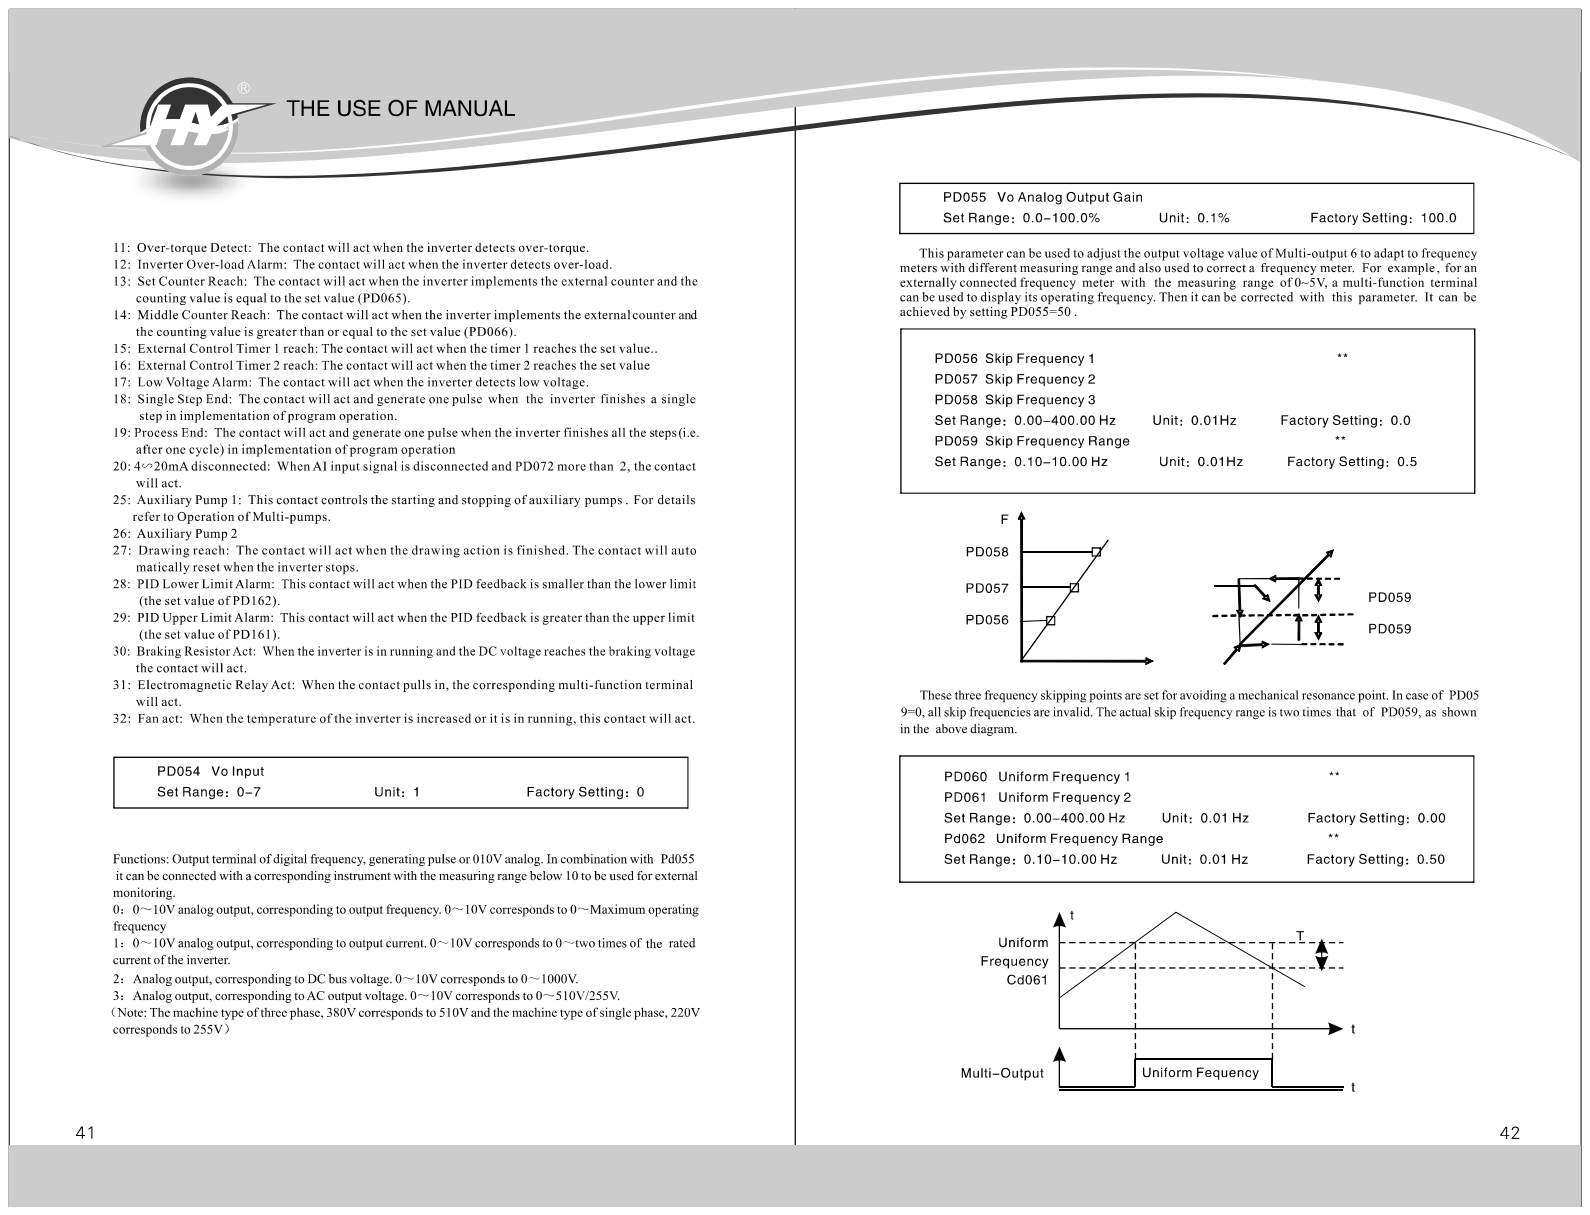
[picture p46: page 23]

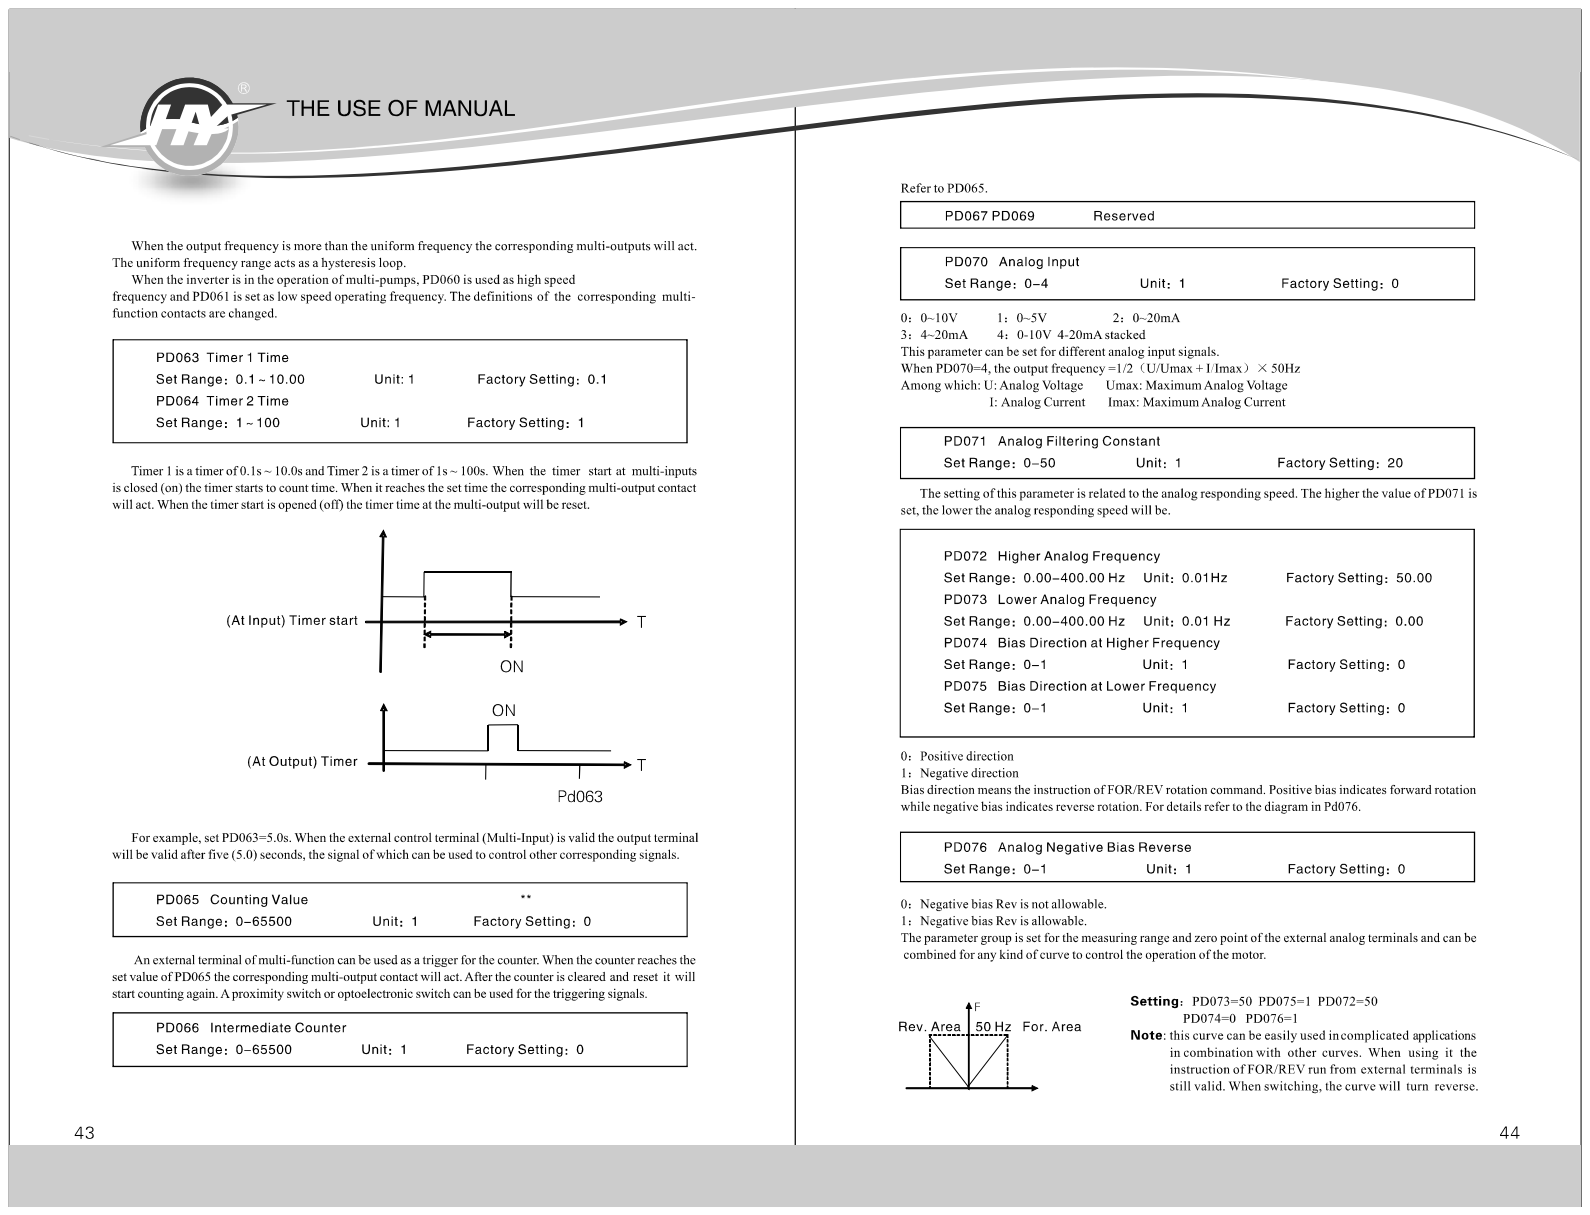
[picture p47: page 24]

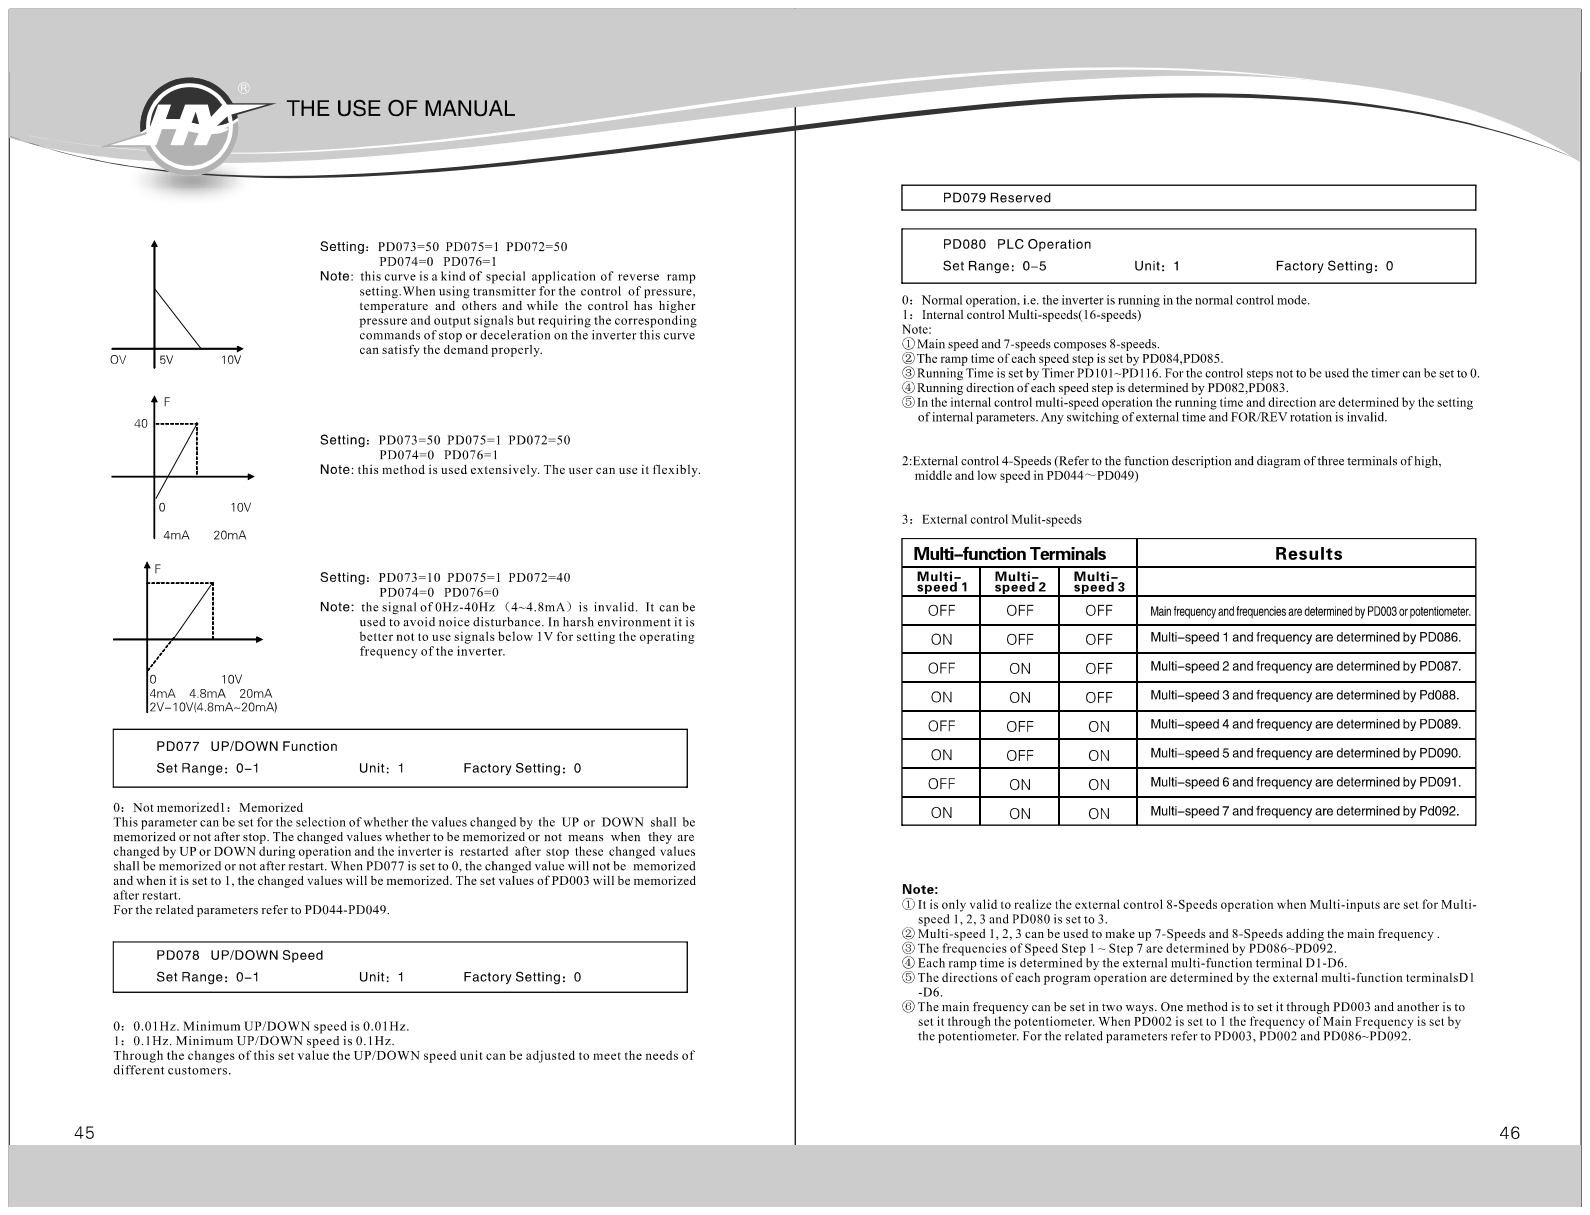
[picture p48: page 25]

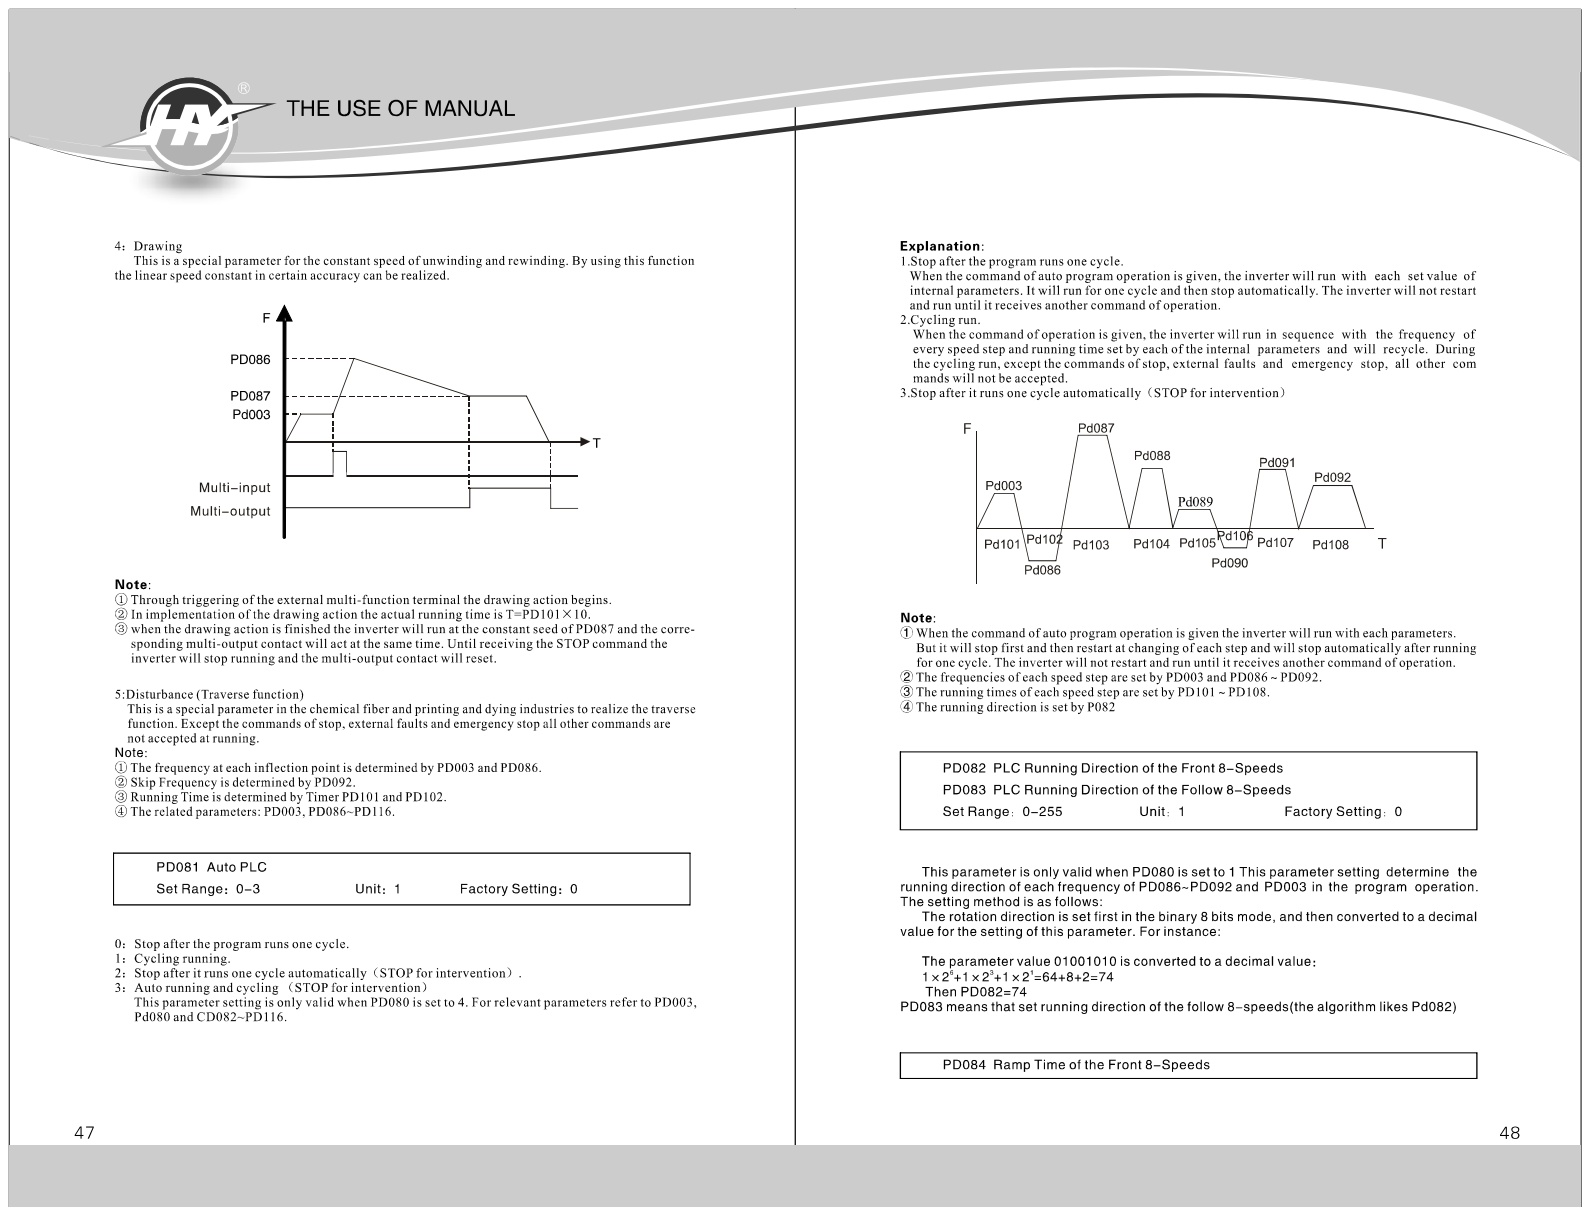
[picture p49: page 26]

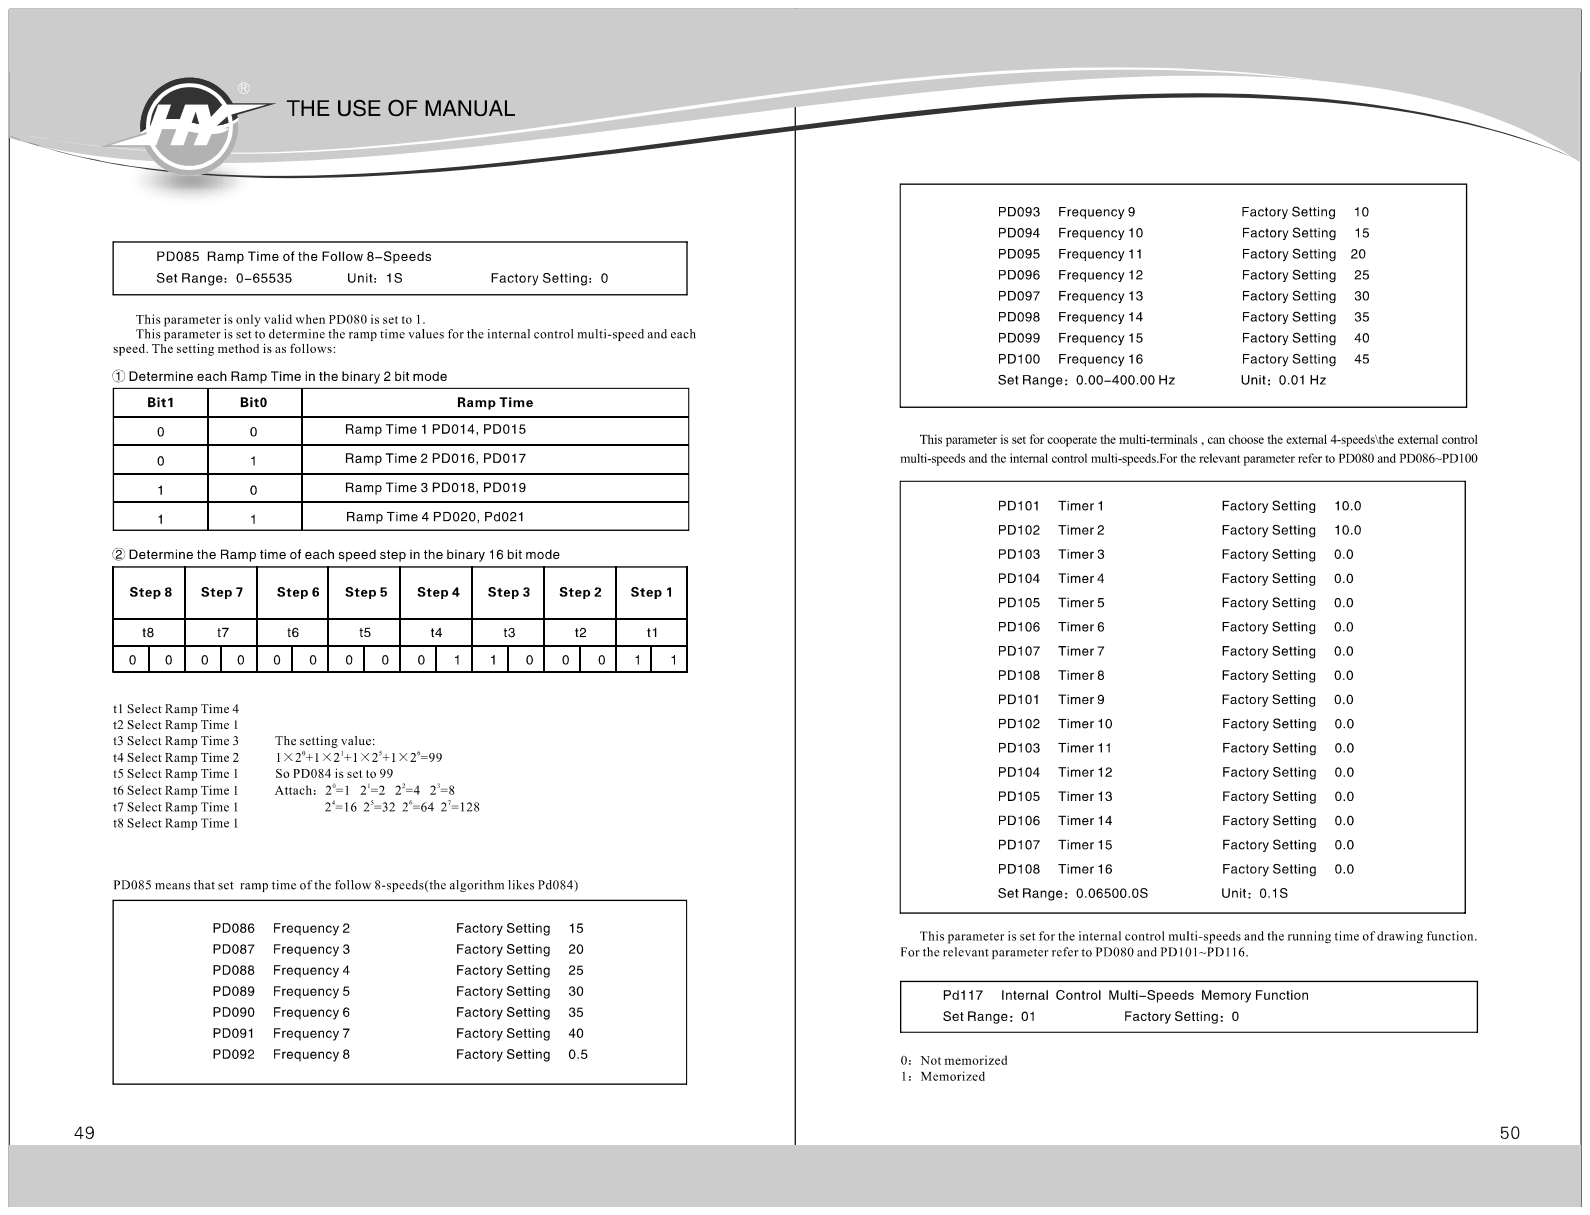
[picture p50: page 27]

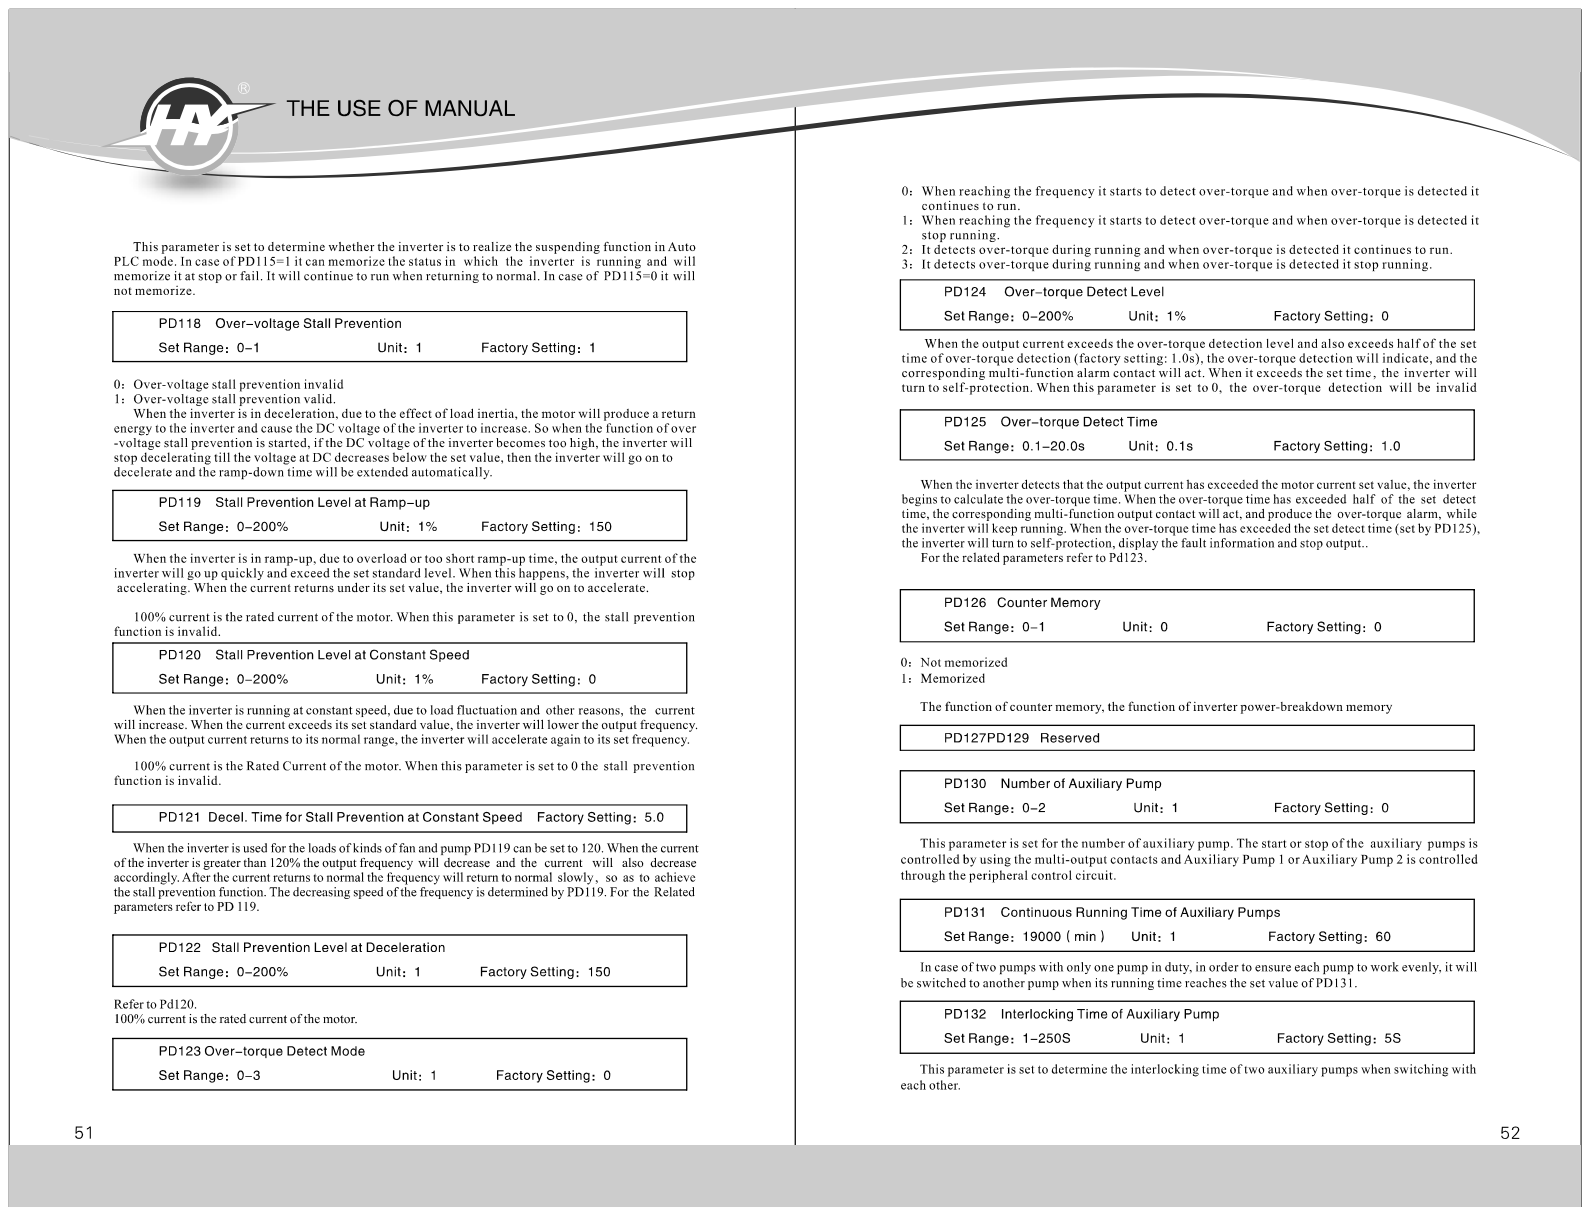
[picture p51: page 28]

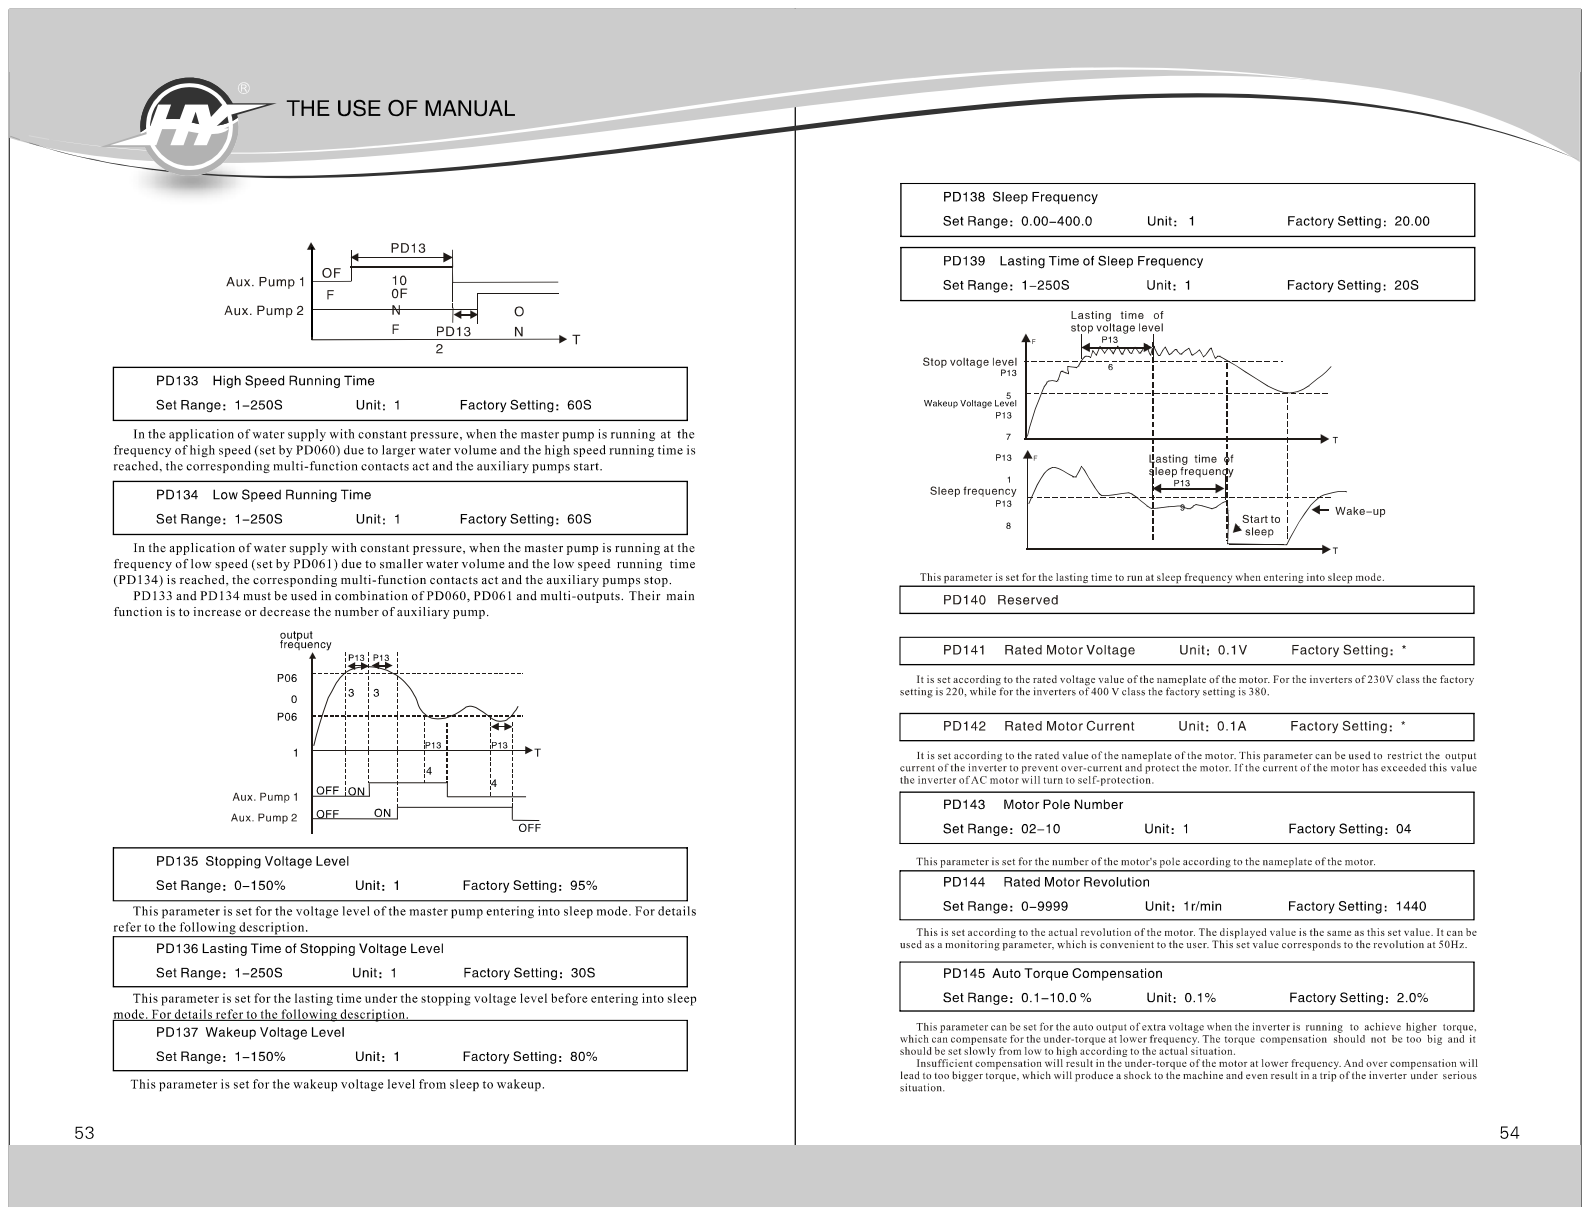
[picture p52: page 29]

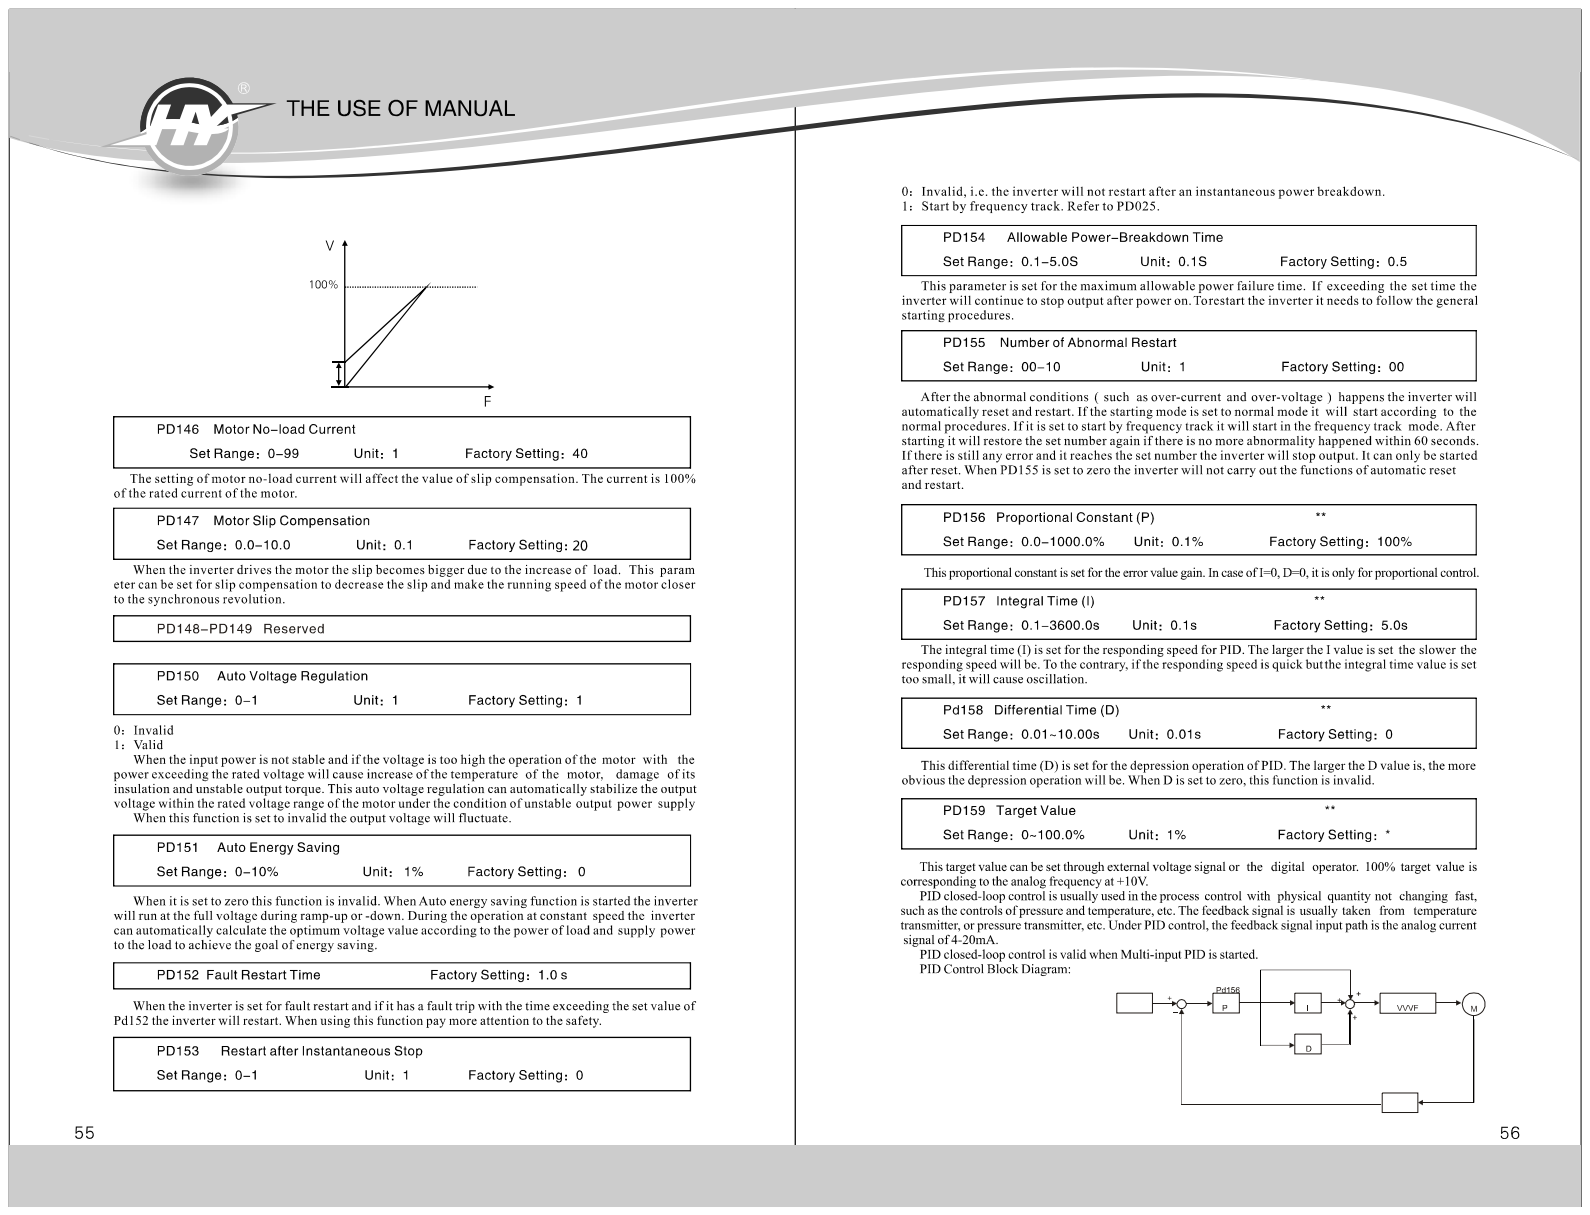
[picture p53: page 30]

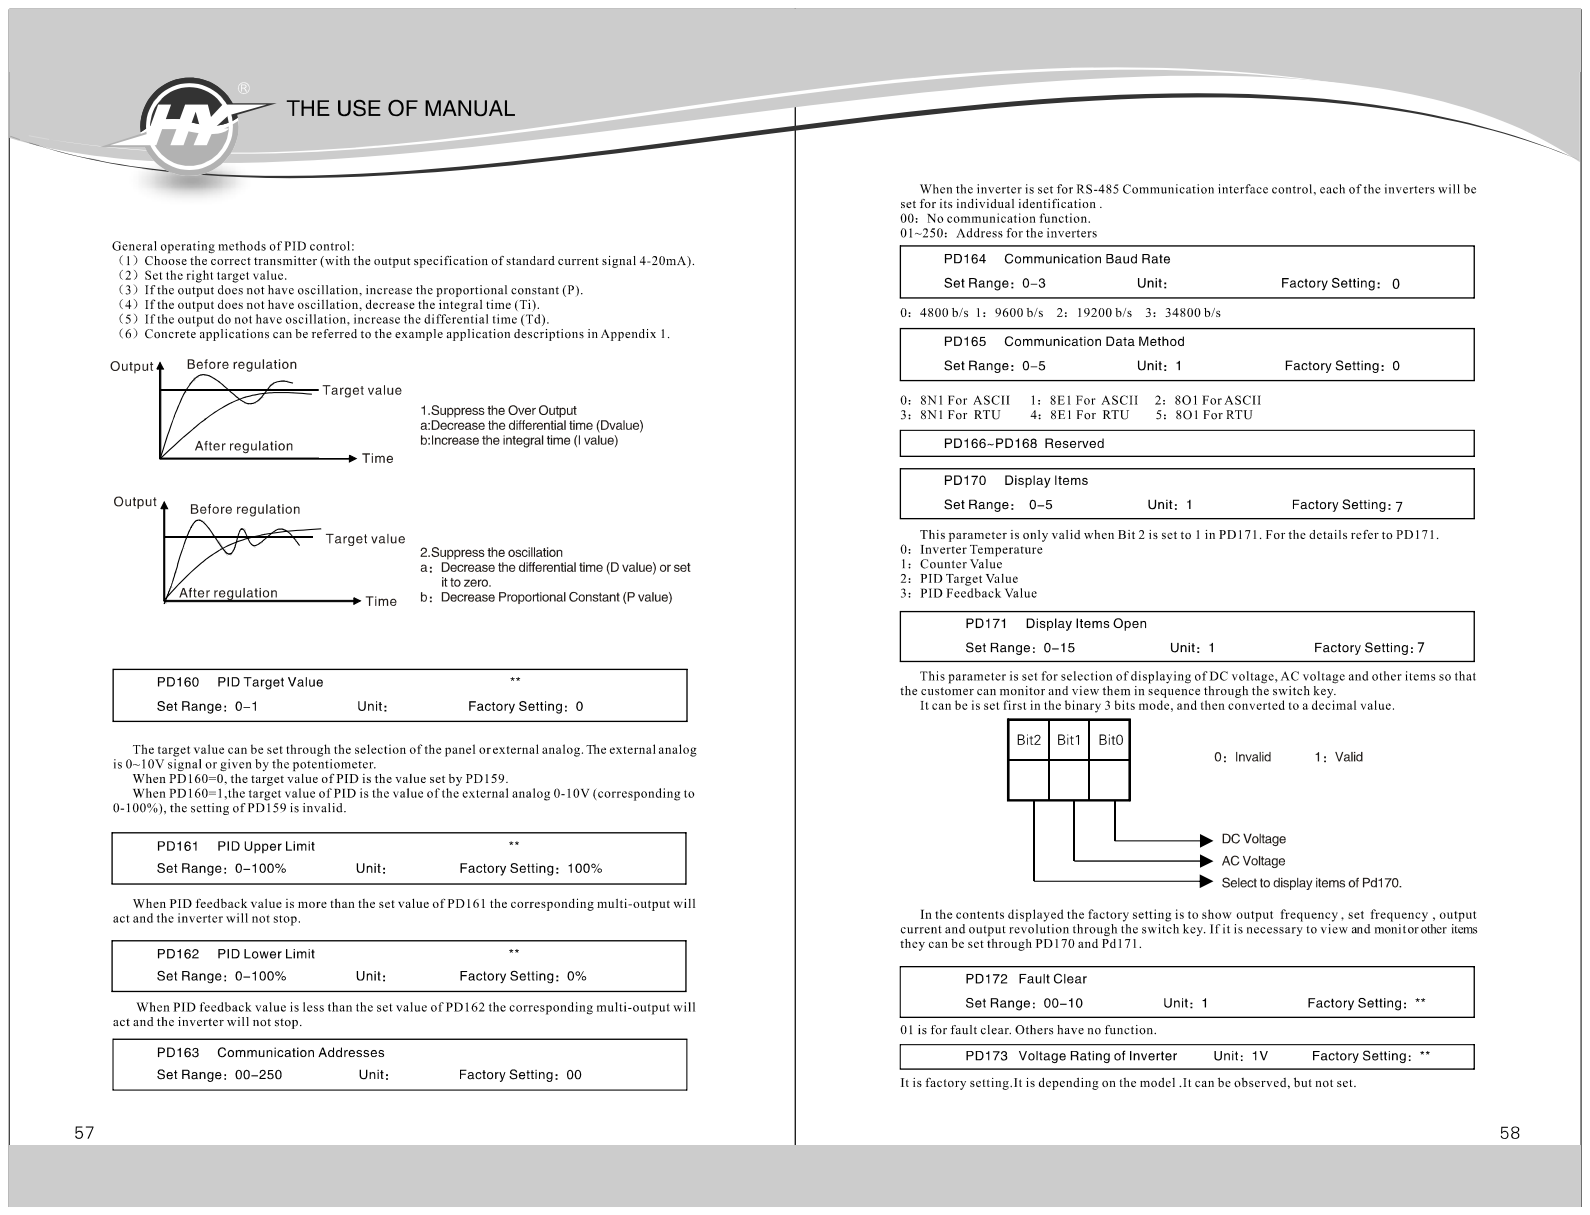
[picture p54: page 31]

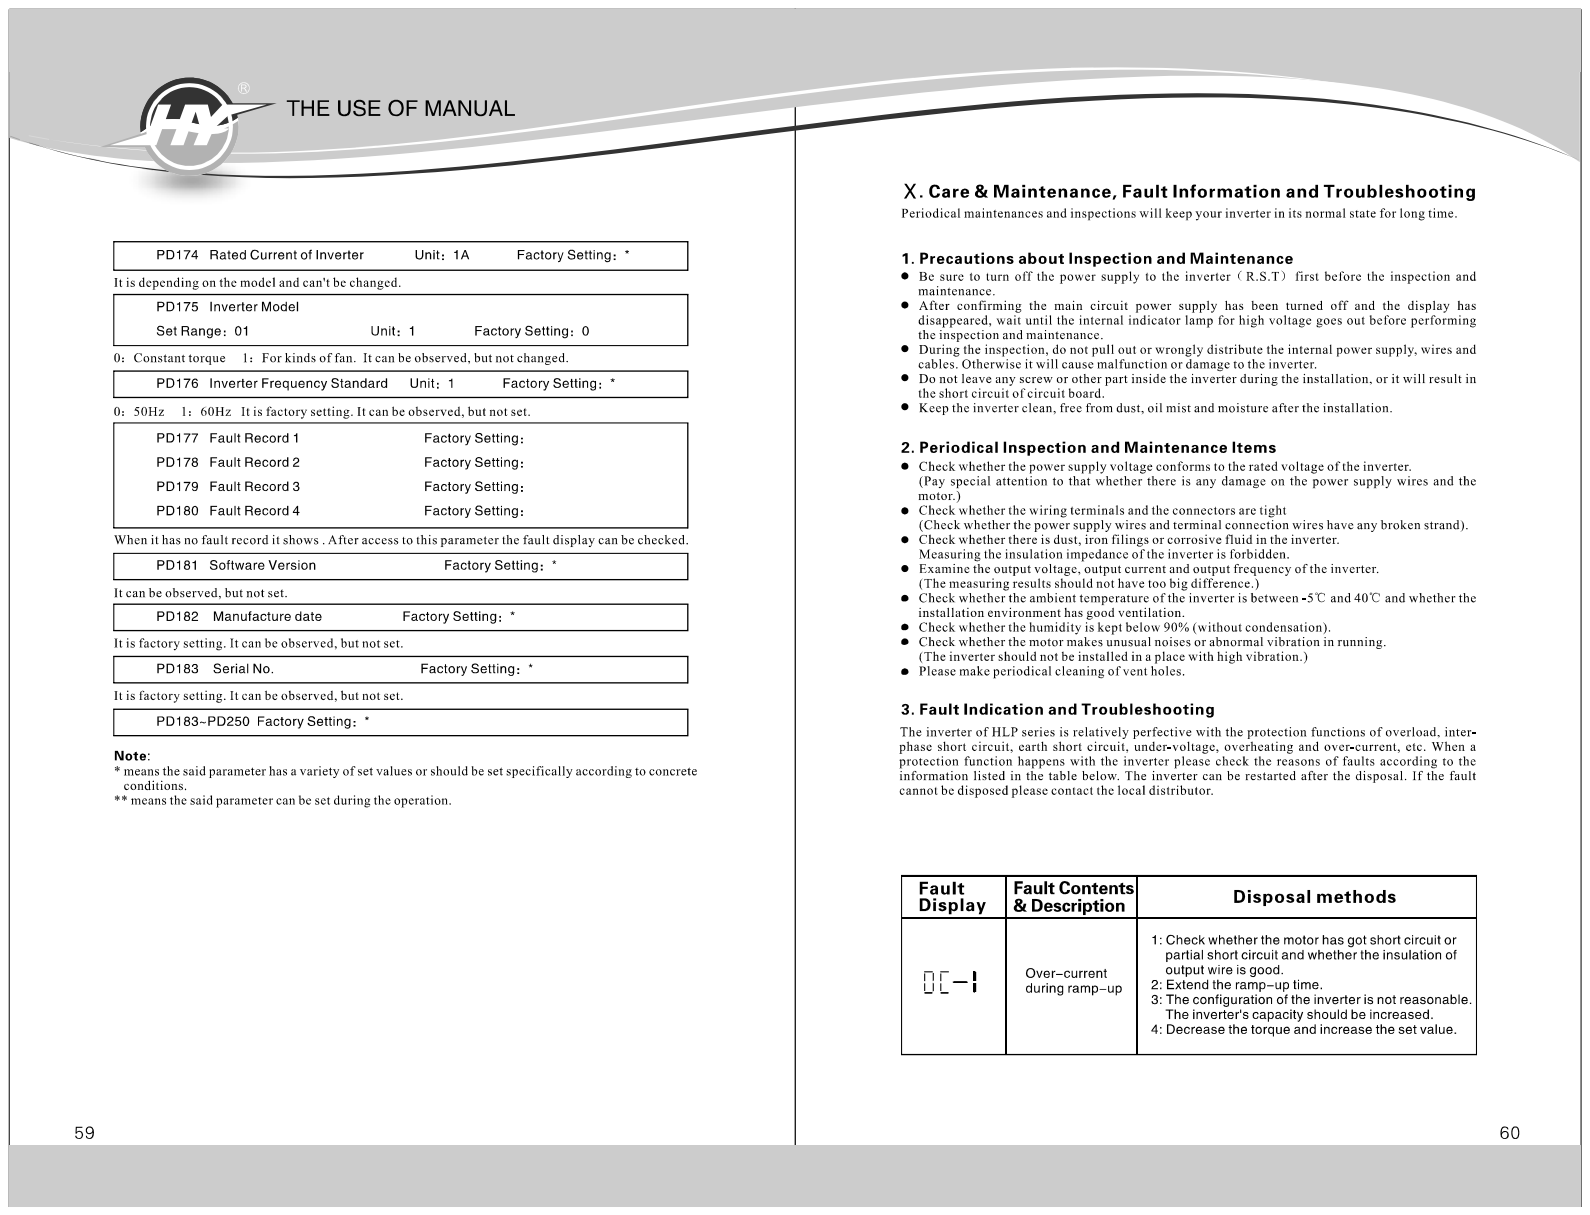
[picture p55: page 32]

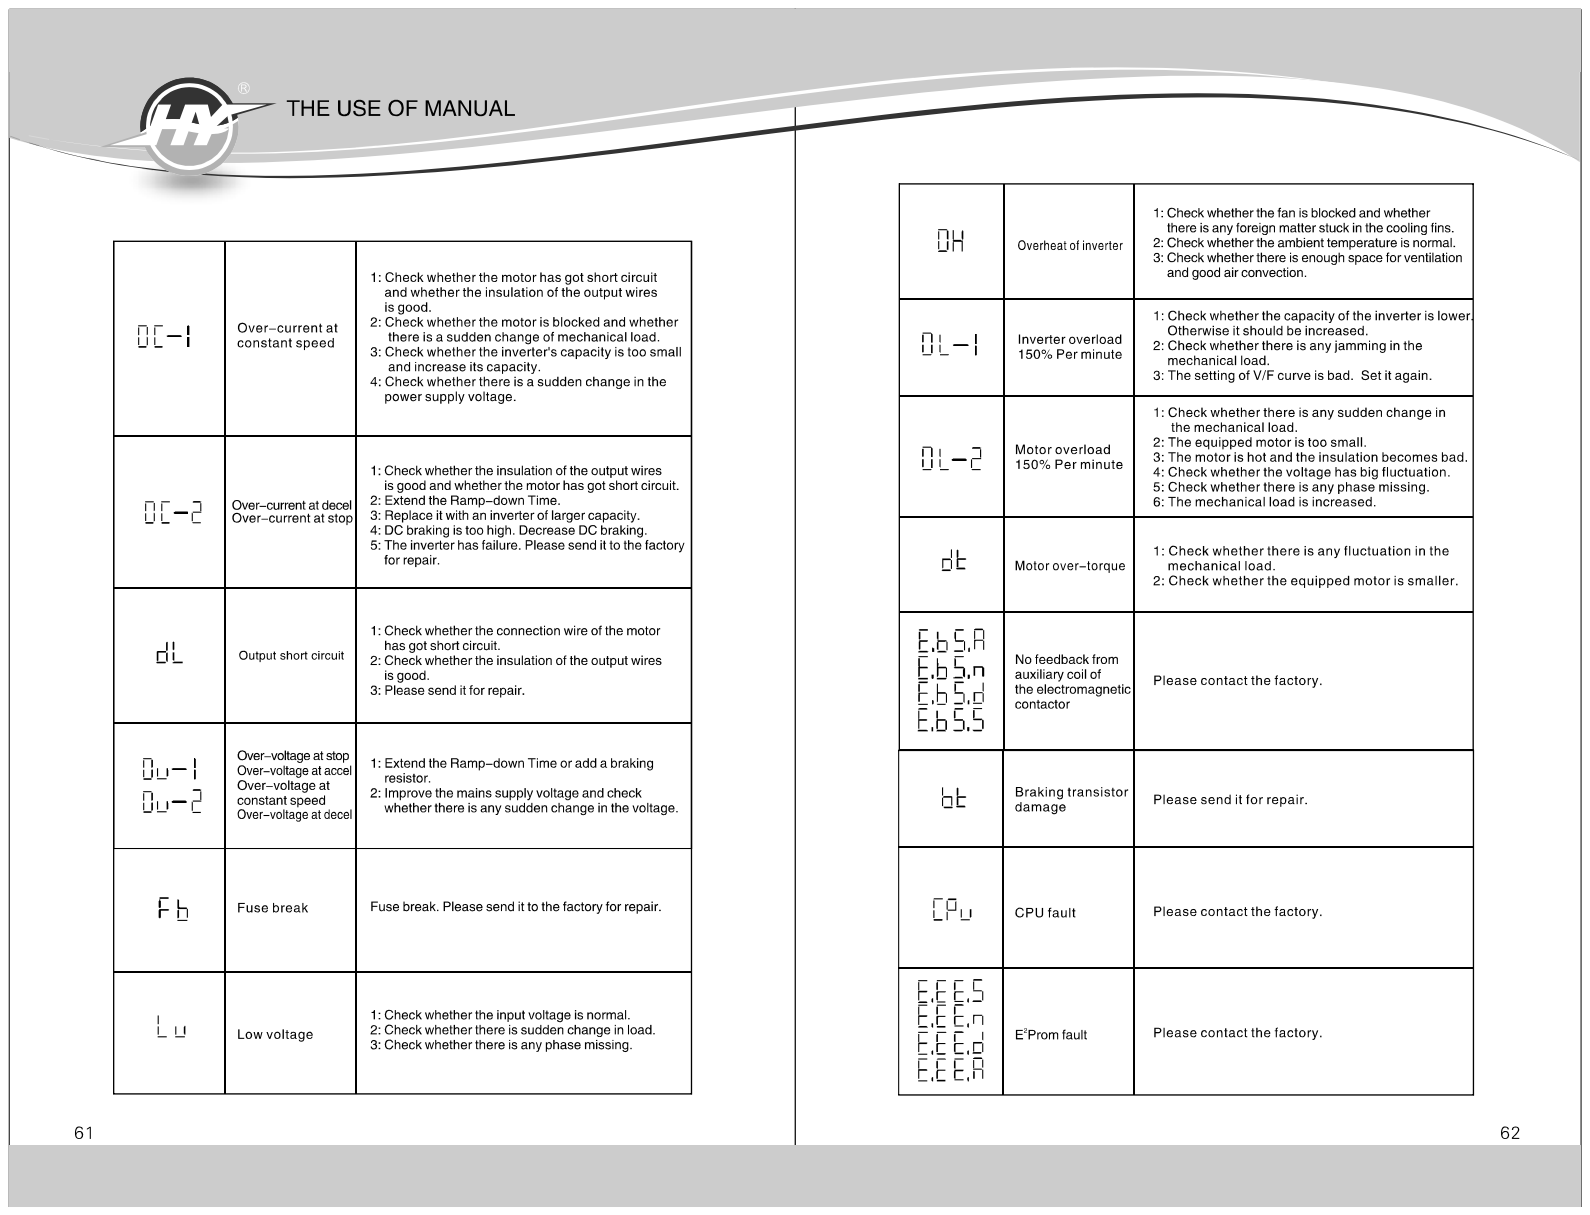
[picture p56: page 33]

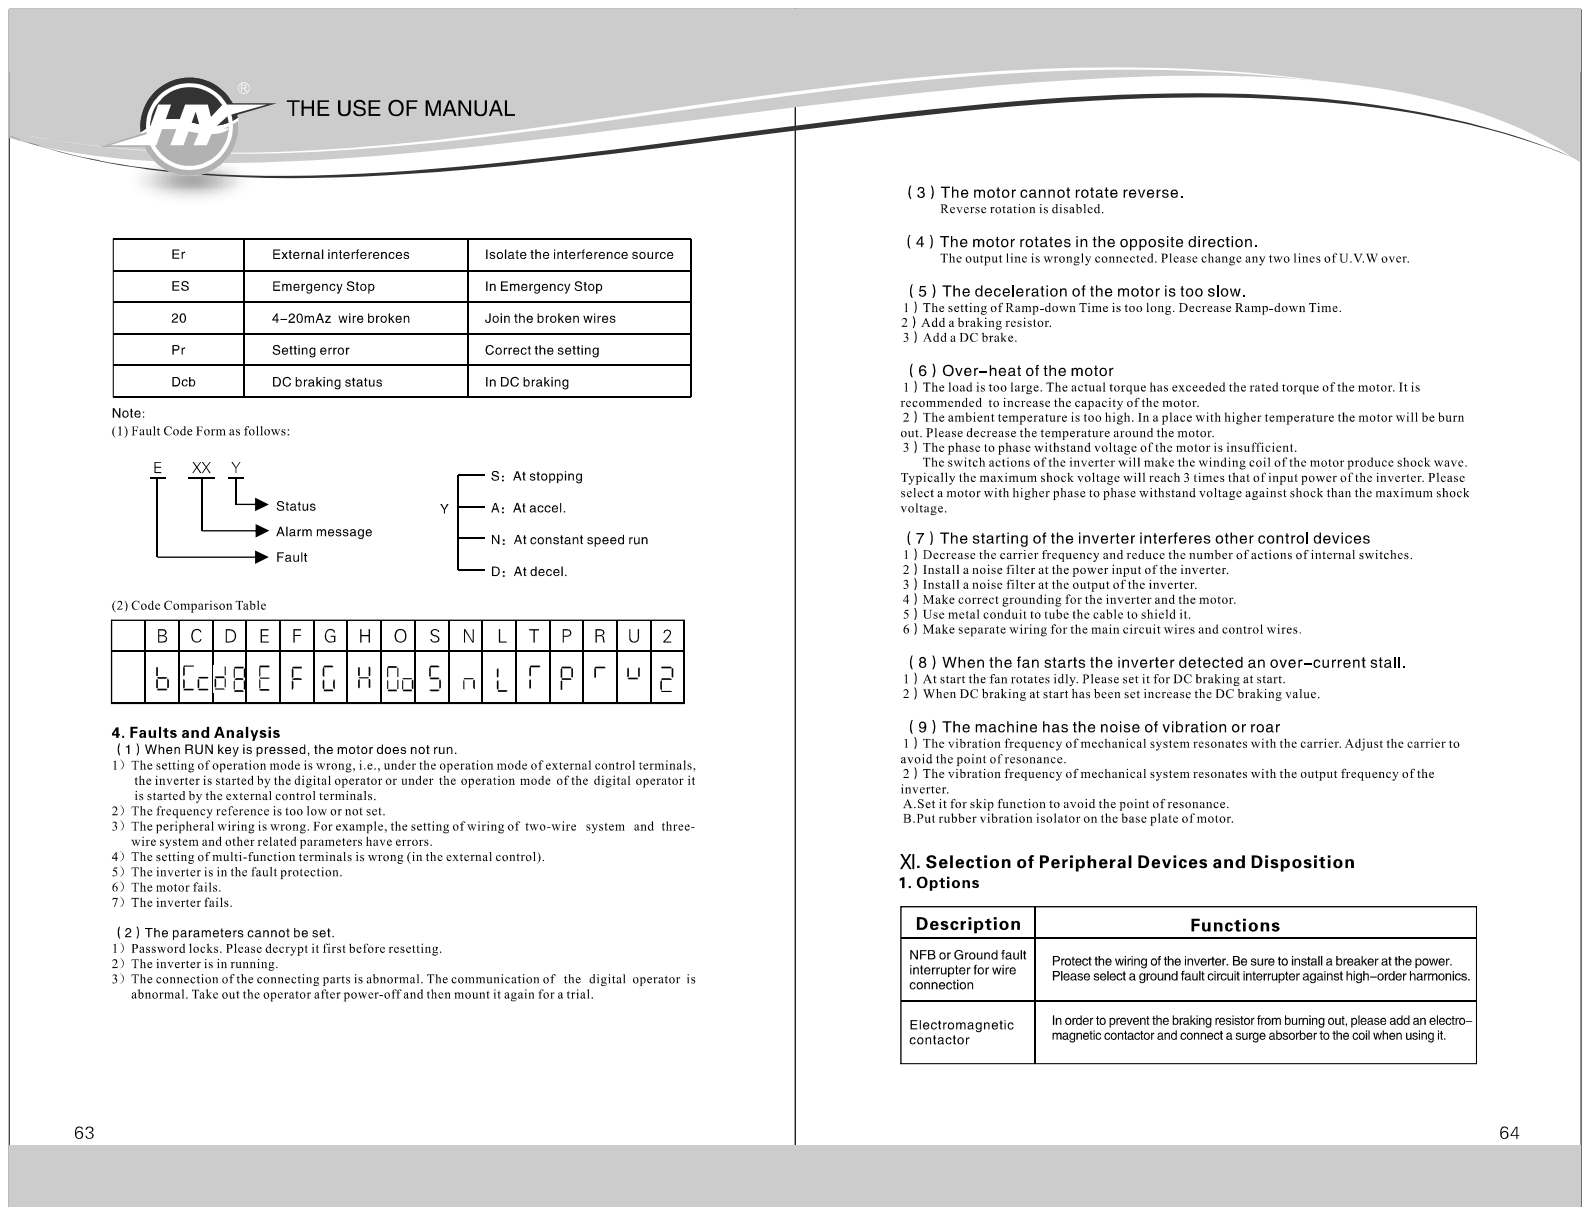
[picture p57: page 34]

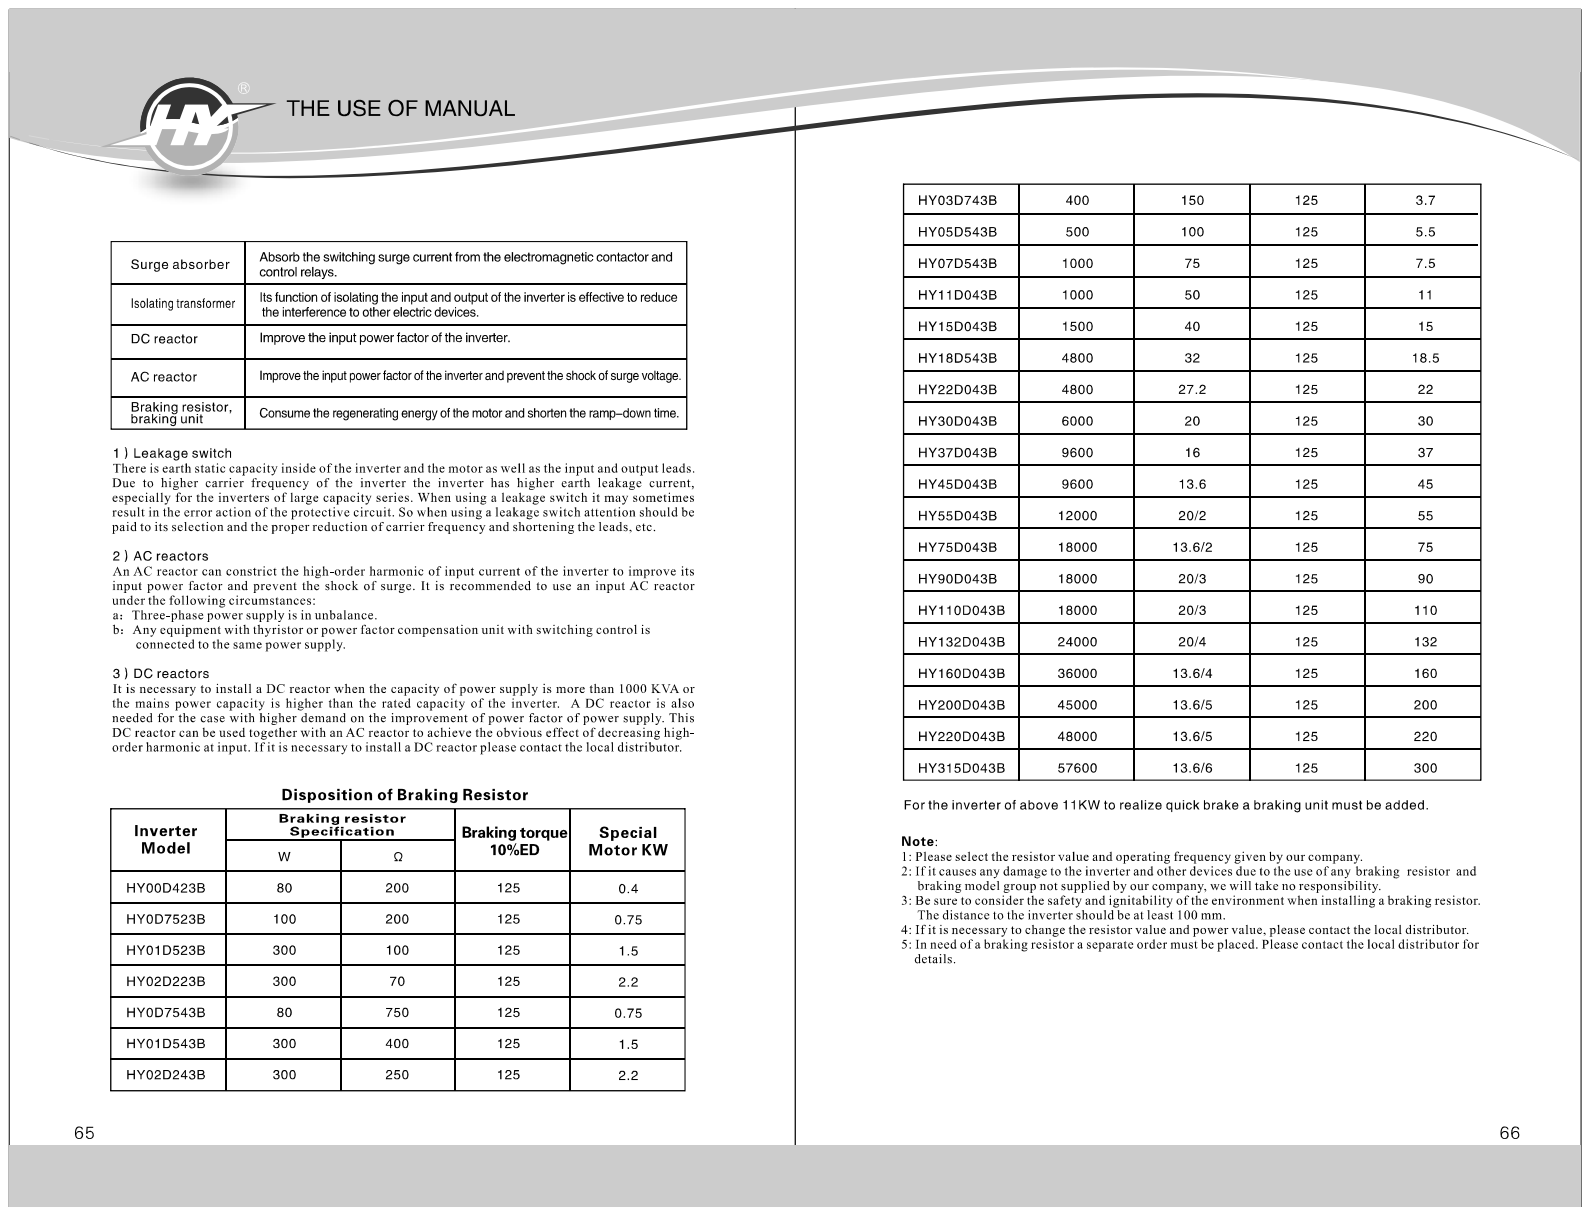
[picture p58: page 35]

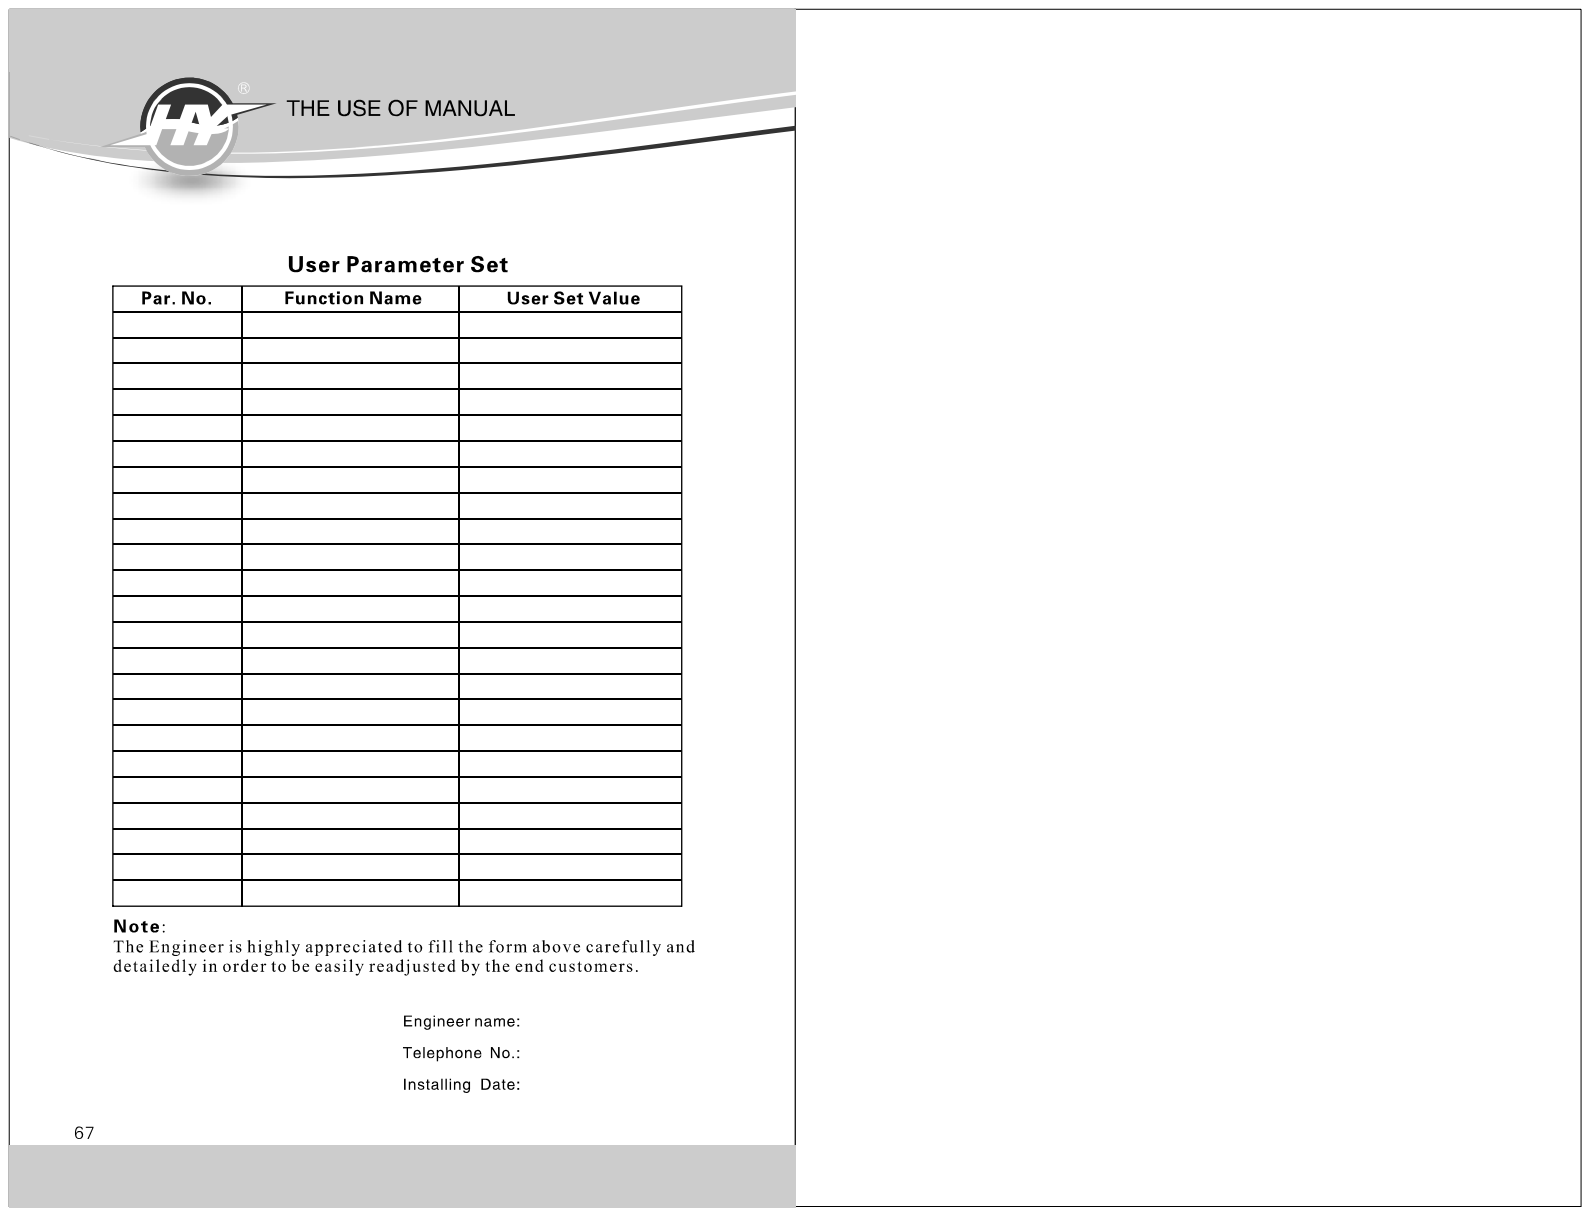
[picture p59: page 36]
