dcowden/panelviz/mycnc.yml

config:
  wire_label_format: "%netname/%seq"
  wiring_mode: labels
  defaults:
    awg: 20
  drawing:
    company: ""
    author: ""
    title: "PanelViz Wiring Schematic"
  labels:
    stock: premium_2_625x1_split
    style:
      font-family: Helvetica
      font-weight: bold
      color: "#000000"
    font_face: Helvetica
    font_height: 0.08
    font_height_unit: in
    left_margin: 0.1
    right_margin: 0.1
    page_margin: 0.3
    text_clearance: 2
    text_clearance_unit: pt
    tail_length: 0.75
    width_increment: 0.25
    whitespace: [2]
  units:
    length: in
  visualization:
    terminal_width: 0.1
    terminal_width_unit: in
    default_net_style:
      color: "#576579"
      line_weight: 1.4
      line_style: solid
    net_styles:
      110L: {color: "#2563eb", line_weight: 2.5, line_style: solid}
      110N: {color: "#2563eb", line_weight: 2.5, line_style: solid}
      110L_SWITCHED: {color: "#2563eb", line_weight: 2.5, line_style: solid}
      110N_SWITCHED: {color: "#2563eb", line_weight: 2.5, line_style: solid}
      24V: {color: "#ff1111", line_weight: 2, line_style: solid}
      5V: {color: "#ff2222", line_weight: 2, line_style: solid}
      24V0: {color: "#000000", line_weight: 2, line_style: solid}
      5V0: {color: "#000000", line_weight: 2, line_style: solid}
      220L: {color: "#000000", line_weight: 2, line_style: solid}
      220N: {color: "#2563eb", line_weight: 2, line_style: solid}
      earth: {color: "#16a34a", line_weight: 2.5, line_style: solid}
      shield: {color: "#16a34a", line_weight: 2.5, line_style: solid}
components:
  y_cl57s:
    type: driver
    tags: [control]
    size:
      width: 3
      height: 4.7
    pins:
      right: [PUL+, PUL-, DIR+, DIR-, ENA+, ENA-, ALM, BRK, COM-, EB+, EB-, EA+, 
            EA-, VCC, EGND, A+, A-, B+, B-, +VDC, GND]
  Z_cl57s:
    type: driver
    tags: [control]
    size:
      width: 3
      height: 4.7
    pins:
      right: [PUL+, PUL-, DIR+, DIR-, ENA+, ENA-, ALM, BRK, COM-, EB+, EB-, EA+, 
            EA-, VCC, EGND, A+, A-, B+, B-, +VDC, GND]
  axbb-e:
    type: driver
    tags: [control]
    size:
      width: 4.55
      height: 4
    pins:
      left: [O1, O2, O3, O4, O5, O6, O7, O8, I1+, I1-, I2+, I2-, I3+, I3-, I4+, 
            I4-, I5+, I5-, I6+, I6-]
      right: [IN-24V0, IN-24V+, IN-5V0, IN-5V+, OUT-5V+, OUT-5V0, A01, AI2, AI1, 
            O17, O16, O15, O14, O13, O12, O11, O10, O9]
      bottom: [1, 2, 3, 4, 5, 6, 7, 8, 9, 10,11,12]                                                                           #these are in the aux board
    nets:
      - {name: VFD_REV, pins: [O2]}
      - {name: VFD_FWD, pins: [O3]}
      - {name: UL1, pins: [I1-]}
      - {name: YLL, pins: [I2-]}
      - {name: X1LL, pins: [I3-]}
      - {name: X2LL, pins: [I4-]}
      - {name: ZLL, pins: [I5-]}
      - {name: COIL+, pins: [I6+]}
      - {name: COIL-, pins: [I6-]}
      - {name: VFD_V1, pins: [A01]}
      - {name: ZDIR, pins: [O16]}
      - {name: ZSTEP, pins: [O15]}
      - {name: X2DIR, pins: [O14]}
      - {name: X2STEP, pins: [O13]}
      - {name: X1DIR, pins: [O12]}
      - {name: X1STEP, pins: [O11]}
      - {name: YDIR, pins: [O10]}
      - {name: YSTEP, pins: [O9]}
      - { name: VAC, pins: [ 4 ] }
      - { name: ATC, pins: [ 12 ] }
      - { name: PROBE1, pins: [ 10 ] }
      - { name: PROBE2, pins: [ 11 ] }
  contactor_110:
    type: switch
    tags: [vfd]
    size:
      width: 1.772
      height: 3.543
      terminal_width: 0.25
    pins:
      top: [L1, L2, L3, 13, A1]
      bottom: [T1, T2, T3, 14, A2]
  contactor_220:
    type: switch
    tags: [vfd]
    size:
      width: 1.772
      height: 3.543
      terminal_width: 0.25
    pins:
      top: [L1, L2, L3, 13, A1]
      bottom: [T1, T2, T3, 14, A2]
  transformer:
    type: power_supply
    tags: [vfd]
    size:
      width: 7.5
      height: 5.5
      terminal_width: 0.25
    pins:
      bottom: [GND, 110L, 110N, 220L, 220N]
  36V_X1:
    type: power_supply
    tags: [vfd]
    size:
      width: 4.5
      height: 8.4
      terminal_width: 0.25
    pins:
      bottom: [GND, 110L, 110N, 36V0_X1, 36V_X1]
  36V_X2:
    type: power_supply
    tags: [vfd]
    size:
      width: 4.5
      height: 8.4
      terminal_width: 0.25
    pins:
      bottom: [GND, 110L, 110N, 36V0_X2, 36V_X2]
  48v:
    type: power_supply
    tags: [vfd]
    size:
      width: 4.5
      height: 8.4
      terminal_width: 0.25
    pins:
      bottom: [GND, 110L, 110N, 48V0, 48V]
    nets:
      - name: DRIVER_GND
        pins: [48V0]
      - name: DRIVER_48V
        pins: [48V]
  24v:
    type: power_supply
    tags: [dc_power]
    size:
      width: 1.772
      height: 5
      terminal_width: 0.25
    pins:
      bottom: [GND, 110L, 110N, 24V0, 24V]
  5v:
    type: power_supply
    tags: [dc_power]
    size:
      width: 1.772
      height: 3.543
      terminal_width: 0.25
    pins:
      bottom: [GND, 110L, 110N, 5V0, 5V]
  wall_plug:
    type: connector
    tags: [vfd]
    size:
      width: 1.5
      height: 1
    pins:
      right: [GND, 1, 2]
  wall_power_t:
    type: terminal_block
    tags: [vfd]
    size:
      width: 2
      height: 0.118
    pins:
      left: [A]
      right: [B]
    positions: 1
    nets:
      - name: 110L
        positions: [1]
  power_switch:
    type: switch
    tags: [vfd]
    size:
      width: 1.5
      height: 1.5
      terminal_width: 0.25
    pins:
      left: [L_IN]
      right: [L_OUT]
  breaker:
    type: switch
    tags: [vfd]
    size:
      width: 1.5
      height: 1.5
      terminal_width: 0.25
    pins:
      left: [L_IN]
      right: [L_OUT]
  run_relay:
    type: relay
    tags: [safety]
    size:
      width: 1
      height: 2
    pins:
      top: [DC+, DC-, IN]
      bottom: [NO, COM, NC]
  upper_limits_ok_relay:
    type: relay
    tags: [safety]
    size:
      width: 1
      height: 2
    pins:
      top: [DC+, DC-, IN]
      bottom: [NO, COM, NC]
  opto_board:
    type: pcb
    tags: [safety]
    size:
      width: 4
      height: 3
    pins:
      left: [1+, 1-, 2+, 2-, 3+, 3-, 4+, 4-, 5+, 5-, 6+, 6-, 7+, 7-, 8+, 8-]
      right: [O1, GND, VCC, O2, O3, O4, O5, O6, O7, O8]
    nets:
      - name: X1UL_OK
        pins: [O1]
      - name: X2UL_OK
        pins: [O2]
      - name: YUL_OK
        pins: [O3]
      - name: ZUL_OK
        pins: [O4]
      - name: X1_ALM_OK
        pins: [O5]
      - name: X2_ALM_OK
        pins: [O6]
      - name: Y_ALM_OK
        pins: [O7]
      - name: Z_ALM_OK
        pins: [O8]
      - name: 5V0
        pins: [GND]
      - name: 5V
        pins: [VCC]
  alarm_limit_board:
    type: pcb
    tags: [safety]
    size:
      width: 2.2
      height: 1.6
    pins:
      top: [D13, 3V3, REF, A0, A1, A2, A3, A4, A5, A6, A7, RST, GND, 5V]
      bottom: [D12, D11, D10, D9, D8, D7, D6, D5, D4, D3, D2, 5V0, RST2, RX TX]
      # Isolated 24 V-side inputs; CPUMP reaches Nano A5 through the 4N26.
      right: [24V, CPUMP]
    nets:
      - name: X1UL_OK
        pins: [D2]
      - name: X2UL_OK
        pins: [D3]
      - name: YUL_OK
        pins: [D4]
      - name: ZUL_OK
        pins: [D5]
      - name: X1_ALM_OK
        pins: [D6]
      - name: X2_ALM_OK
        pins: [D7]
      - name: Y_ALM_OK
        pins: [D8]
      - name: Z_ALM_OK
        pins: [D9]
      - name: RUN_RELAY_CTL
        pins: [D10]
      - name: UPPER_LIMITS_OK_RELAY_CTL
        pins: [D11]
      - name: RESET_SW
        pins: [D12]
  vfd:
    type: vfd
    tags: [vfd]
    size:
      width: 6
      height: 8
    pins:
      top: [UPF, DRV, DCM, SPL, SPM, SPH, RST, REV, FOR, ACM, V0, 10V]
      left: [FA, PC, FB, 24V, DCM2, AI, VI, RS-, RS+]
      bottom: [R, S, T, P+, U, V, W, GND]
  cnc_terminals:
    type: terminal_block
    tags: [terminals]
    size:
      width: 2
      height: 0.118 # per position
    pins:
      left: [A]
      right: [B]
    positions: 73 # Fieldbox: 67-72; 73 reserved spare.
  live_power_t:
    type: terminal_block
    tags: [vfd]
    size:
      width: 2
      height: 0.118
    pins:
      left: [A]
      right: [B]
    nets:
      - name: 110L
        positions: [1, 3, 5]
      - name: 110N
        positions: [2, 4, 6]
  switched_110N:
    type: bus_block
    tags: [vfd]
    size:
      width: 2
      height: 0.118
    nets:
      - name: 110N_SWITCHED
    pins:
      left: [A]
      right: [B]
    positions: 2
  switched_110L:
    type: bus_block
    tags: [vfd]
    size:
      width: 2
      height: 0.118
    nets:
      - name: 110L_SWITCHED
    pins:
      left: [A]
      right: [B]
    positions: 2
  driver_power:
    type: terminal_block
    tags: [vfd]
    size:
      width: 2
      height: 0.118
    pins:
      left: [A]
      right: [B]
    nets:
      - name: 36V_X1
        positions: [1]
      - name: 36V0_X1
        positions: [2]
      - name: 36V_X2
        positions: [3]
      - name: 36V0_X2
        positions: [4]
      - name: DRIVER_48V
        positions: [5, 6]
      - name: DRIVER_GND
        positions: [7, 8]
    positions: 8
  terminals_5v:
    type: bus_block
    tags: [terminals]
    size:
      width: 2
      height: 0.118
    nets:
      - name: 5V
    pins:
      left: [A]
      right: [B]
    positions: 3
  terminals_5v0:
    type: bus_block
    tags: [terminals]
    size:
      width: 2
      height: 0.118
    nets:
      - name: 5V0
    pins:
      left: [A]
      right: [B]
    positions: 7
  terminals_24v:
    type: bus_block
    tags: [terminals]
    size:
      width: 2
      height: 0.118
    nets:
      - name: 24V
    pins:
      left: [A]
      right: [B]
    positions: 4
  terminals_24v0:
    type: bus_block
    tags: [terminals]
    size:
      width: 2
      height: 0.118
    nets:
      - name: 24V0
    pins:
      left: [A]
      right: [B]
    positions: 6
  terminals_earth:
    type: bus_block
    tags: [terminals]
    size:
      width: 2
      height: 0.118
    nets:
      - name: earth
    pins:
      left: [A]
      right: [B]
    positions: 1
  control_5v:
    type: bus_block
    tags: [control]
    size:
      width: 2
      height: 0.118
    nets:
      - name: 5V
    pins:
      left: [A]
      right: [B]
    positions: 2
  control_5v0:
    type: bus_block
    tags: [control]
    size:
      width: 2
      height: 0.118
    nets:
      - name: 5V0
    pins:
      left: [A]
      right: [B]
    positions: 5
  control_24v:
    type: bus_block
    tags: [control]
    size:
      width: 2
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
  x1_limits:
    type: connector
    tags: [terminals]
    size:
      width: .5
      height: .5
    pins:
      left: [24v, ul, ll, 24v0, shield]
  x2_motor:
    type: connector
    tags: [terminals]
    size:
      width: .5
      height: .5
    pins:
      left: [M+, M-, shield]
  x2_control:
    type: connector
    tags: [terminals]
    size:
      width: .5
      height: .5
    pins:
      left: [alrm+, alrm-, dir+, dir-, pul+, pul-]
  x2_limits:
    type: connector
    tags: [terminals]
    size:
      width: .5
      height: .5
    pins:
      left: [24v, ul, ll, 24v0, shield]
  estop_panel:
    type: connector
    tags: [terminals]
    size:
      width: 0.5
      height: 0.5
    pins:
      left: [reset_sw+, reset_sw-, estop+, estop-, light+, light-]
  secondary_estop:
    type: connector
    tags: [terminals]
    size:
      width: 0.5
      height: 0.5
    pins:
      left: [estop+, estop-]
  spindle:
    type: connector
    tags: [terminals]
    size:
      width: 0.5
      height: 0.5
    pins:
      left: [u, v, w, x, shield]
  field_box:
    type: connector
    tags: [terminals]
    size:
      width: 4
      height: 4
    pins:
      left: [ 5V0, 5V, PROBE1, PROBE2,ATC,VAC]
      right: [ PROBE1+,PROBE1-,PROBE2+,PROBE2-,ATC+,ATC-SIG,ATC-]
      bottom:  [ 110L, 110N, VAC-110N, VAC-110L ]
connections:
  wires:
    - from: wall_plug.GND
      to: vfd_earth.earth
      net: earth
      awg: 12
    - from: wall_plug.1
      to: wall_power_t.1A
      net: 110L
      awg: 12
    - from: wall_power_t.1B
      to: power_switch.L_IN
      net: 110L
      awg: 12
    - from: power_switch.L_OUT
      to: breaker.L_IN
      net: 110L
      awg: 12
    - from: breaker.L_OUT
      to: live_power_t.110L
      net: 110L
      awg: 12
    - from: wall_plug.2
      to: live_power_t.110N
      net: 110N
      awg: 12
    - [live_power_t.110L, transformer.110L]
    - [live_power_t.110N, transformer.110N]
    - [live_power_t.110L, contactor_110.T2]
    - [live_power_t.110N, contactor_110.T3]
    - [transformer.GND, vfd_earth.earth]
    - [transformer.220L, contactor_220.T1]
    - [transformer.220N, contactor_220.T2]
    - [contactor_110.L2, switched_110L.110L_SWITCHED]
    - [contactor_110.L3, switched_110N.110N_SWITCHED]
    - [48v.GND, vfd_earth.earth]
    - [24v.GND, dc_power_earth.earth]
    - [24v.110N, live_power_t.110N]
    - [24v.110L, live_power_t.110L]
    - [5v.110N, live_power_t.110N]
    - [5v.110L, live_power_t.110L]
    - [5v.GND, dc_power_earth.earth]
    - [48v.110L, switched_110L.110L_SWITCHED]
    - [36V_X1.110N, switched_110N.110N_SWITCHED]
    - [36V_X1.110L, switched_110L.110L_SWITCHED]
    - [36V_X1.GND, vfd_earth.earth]
    - [36V_X1.36V_X1, driver_power.36V_X1]
    - [36V_X1.36V0_X1, driver_power.36V0_X1]
    - [36V_X2.GND, vfd_earth.earth]
    - [36V_X2.110N, switched_110N.110N_SWITCHED]
    - [36V_X2.110L, switched_110L.110L_SWITCHED]
    - [36V_X2.36V_X2, driver_power.36V_X2]
    - [36V_X2.36V0_X2, driver_power.36V0_X2]
    - [48v.DRIVER_48V, driver_power.DRIVER_48V]
    - [48v.DRIVER_GND, driver_power.DRIVER_GND]
    - [contactor_110.A1, coil_t.COIL+]
    - [contactor_220.A1, coil_t.COIL+]
    - [contactor_110.A2, coil_t.COIL-]
    - [contactor_220.A2, coil_t.COIL-]
    - [vfd.GND, vfd_earth.earth]
    - route: [48v.110N, switched_110N.110N_SWITCHED]
      net: 110N_SWITCHED

    - route: [z_motor.ma+, cnc_terminals.1, Z_cl57s.A+]
      awg: 16
    - route: [z_motor.ma-, cnc_terminals.2, Z_cl57s.A-]
      awg: 16
    - route: [z_motor.mb+, cnc_terminals.3, Z_cl57s.B+]
      awg: 16
    - route: [z_motor.mb-, cnc_terminals.4, Z_cl57s.B-]
      awg: 16
    - [z_motor.shield, connector_earth.shield]
    - [z_control.eb+, cnc_terminals.5, Z_cl57s.EB+]
    - [z_control.eb-, cnc_terminals.6, Z_cl57s.EB-]
    - [z_control.ea+, cnc_terminals.7, Z_cl57s.EA+]
    - [z_control.ea-, cnc_terminals.8, Z_cl57s.EA-]
    - [z_control.vcc, cnc_terminals.9, Z_cl57s.VCC]
    - [z_control.gnd, cnc_terminals.10, Z_cl57s.EGND]
    - [z_control.shield, connector_earth.shield]
    - [z_limits.24v, cnc_terminals.11, terminals_24v.24V]
    - [z_limits.ul, cnc_terminals.12, opto_board.4-]
    - [z_limits.ll, cnc_terminals.13, axbb-e.ZLL]
    - [z_limits.24v0, cnc_terminals.14, terminals_24v0.24V0]
    - [z_limits.shield, connector_earth.shield]
    - route: [y_motor.ma+, cnc_terminals.15, y_cl57s.A+]
      awg: 16
    - route: [y_motor.ma-, cnc_terminals.16, y_cl57s.A-]
      awg: 16
    - route: [y_motor.mb+, cnc_terminals.17, y_cl57s.B+]
      awg: 16
    - route: [y_motor.mb-, cnc_terminals.18, y_cl57s.B-]
      awg: 16
    - [y_motor.shield, connector_earth.shield]
    - [y_control.eb+, cnc_terminals.19, y_cl57s.EB+]
    - [y_control.eb-, cnc_terminals.20, y_cl57s.EB-]
    - [y_control.ea+, cnc_terminals.21, y_cl57s.EA+]
    - [y_control.ea-, cnc_terminals.22, y_cl57s.EA-]
    - [y_control.vcc, cnc_terminals.23, y_cl57s.VCC]
    - [y_control.gnd, cnc_terminals.24, y_cl57s.EGND]
    - [y_control.shield, connector_earth.shield]
    - [y_limits.24v, cnc_terminals.25, terminals_24v.24V]
    - [y_limits.ul, cnc_terminals.26, opto_board.3-]
    - [y_limits.ll, cnc_terminals.27, axbb-e.YLL]
    - [y_limits.24v0, cnc_terminals.28, terminals_24v0.24V0]
    - [y_limits.shield, connector_earth.shield]
    - route: [x1_motor.M+, cnc_terminals.29, driver_power.36V_X1]
      awg: 16
    - route: [x1_motor.M-, cnc_terminals.30, driver_power.36V0_X1]
      awg: 16
    - [x1_motor.shield, connector_earth.shield]
    - [x1_control.alrm+, cnc_terminals.31, opto_board.5-]
    - [x1_control.alrm-, cnc_terminals.32, terminals_24v0.4A]
    - [x1_control.dir+, cnc_terminals.33, axbb-e.X1DIR]
    - [x1_control.dir-, cnc_terminals.34, terminals_5v0.5V0]
    - [x1_control.pul+, cnc_terminals.35, axbb-e.X1STEP]
    - [x1_control.pul-, cnc_terminals.36, terminals_5v0.5V0]
    - [x1_limits.24v, cnc_terminals.37, terminals_24v.24V]
    - [x1_limits.ul, cnc_terminals.38, opto_board.1-]
    - [x1_limits.ll, cnc_terminals.39, axbb-e.X1LL]
    - [x1_limits.24v0, cnc_terminals.40, terminals_24v0.24V0]
    - [x1_limits.shield, connector_earth.shield]
    - route: [x2_motor.M+, cnc_terminals.41, driver_power.36V_X2]
      awg: 16
    - route: [x2_motor.M-, cnc_terminals.42, driver_power.36V0_X2]
      awg: 16
    - [x2_motor.shield, connector_earth.shield]
    - [x2_control.alrm+, cnc_terminals.43, opto_board.6-]
    - [x2_control.alrm-, cnc_terminals.44, terminals_24v0.4B]
    - [x2_control.dir+, cnc_terminals.45, axbb-e.X2DIR]
    - [x2_control.dir-, cnc_terminals.46, terminals_5v0.5V0]
    - [x2_control.pul+, cnc_terminals.47, axbb-e.X2STEP]
    - [x2_control.pul-, cnc_terminals.48, terminals_5v0.5V0]
    - [x2_limits.24v, cnc_terminals.49, terminals_24v.24V]
    - [x2_limits.ul, cnc_terminals.50, opto_board.2-]
    - [x2_limits.ll, cnc_terminals.51, axbb-e.X2LL]
    - [x2_limits.24v0, cnc_terminals.52, terminals_24v0.24V0]
    - [x2_limits.shield, connector_earth.shield]
    - [estop_panel.reset_sw+, cnc_terminals.55, terminals_5v0.5V0]
    - [estop_panel.reset_sw-, cnc_terminals.56, alarm_limit_board.RESET_SW]
    - [estop_panel.estop+, cnc_terminals.57, terminals_24v.24V]
    - from: estop_panel.estop-
      to: cnc_terminals.58A
      net: estop_panel.estop-
    - from: cnc_terminals.58B
      to: cnc_terminals.61B
      net: estop_panel.estop-
    - from: secondary_estop.estop+
      to: cnc_terminals.61A
      net: secondary_estop.estop+
    - [estop_panel.light+, cnc_terminals.59, terminals_24v.24V]
    - [estop_panel.light-, cnc_terminals.60, run_relay.NC]
    - from: secondary_estop.estop-
      to: cnc_terminals.62A
      net: secondary_estop.estop-
    - from: cnc_terminals.62B
      to: coil_t.COIL+
      net: COIL+
    - route: [spindle.u, cnc_terminals.63, vfd.U]
      awg: 16
    - route: [spindle.v, cnc_terminals.64, vfd.V]
      awg: 16
    - route: [spindle.w, cnc_terminals.65, vfd.W]
      awg: 16
    - [spindle.shield, connector_earth.6B]
    - [run_relay.DC-, safety_5v0.5V0]
    - [run_relay.DC+, safety_5v.5V]
    - [upper_limits_ok_relay.DC-, safety_5v0.5V0]
    - [upper_limits_ok_relay.DC+, safety_5v.5V]
    - [5v.5V, dc_power_5v.5V]
    - [5v.5V0, dc_power_5v0.5V0]
    - [24v.24V, dc_power_24v.24V]
    - [24v.24V0, dc_power_24v0.24V0]
    - [dc_power_5v.5V, safety_5v.5V]
    - [safety_5v.5V, control_5v.5V]
    - [control_5v.5V, terminals_5v.5V]
    - [dc_power_5v0.5V0, safety_5v0.5V0]
    - [safety_5v0.5V0, control_5v0.5V0]
    - [control_5v0.5V0, terminals_5v0.5V0]
    - [dc_power_24v.24V, safety_24v.24V]
    - [safety_24v.24V, control_24v.24V]
    - [control_24v.24V, terminals_24v.24V]
    - [dc_power_24v0.24V0, safety_24v0.24V0]
    - [safety_24v0.24V0, control_24v0.24V0]
    - [vfd_earth.earth, dc_power_earth.earth]
    - [dc_power_earth.earth, safety_earth.earth]
    - [safety_earth.earth, control_earth.earth]
    - [control_earth.earth, terminals_earth.earth]

    - [vfd.R, contactor_220.L1]
    - [vfd.T, contactor_220.L2]
    #drivers
    - [y_cl57s.PUL+, axbb-e.YSTEP]
    - [y_cl57s.ALM, opto_board.7-]
    - [y_cl57s.PUL-, control_5v0.5V0]
    - [y_cl57s.DIR+, axbb-e.YDIR]
    - [y_cl57s.DIR-, control_5v0.5V0]
    - [y_cl57s.COM-, control_24v0.2B]
    - [y_cl57s.+VDC, driver_power.DRIVER_48V]
    - [y_cl57s.GND, driver_power.DRIVER_GND]

    - [Z_cl57s.PUL+, axbb-e.ZSTEP]
    - [Z_cl57s.ALM, opto_board.8-]
    - [Z_cl57s.PUL-, control_5v0.5V0]
    - [Z_cl57s.DIR+, axbb-e.ZDIR]
    - [Z_cl57s.DIR-, control_5v0.5V0]
    - [Z_cl57s.COM-, control_24v0.3A]
    - [Z_cl57s.+VDC, driver_power.DRIVER_48V]
    - [Z_cl57s.GND, driver_power.DRIVER_GND]



  #axbb-e
    - [axbb-e.VFD_FWD, vfd.FOR]
    - [axbb-e.VFD_REV, vfd.REV]
    - [control_24v.24V, axbb-e.I1+]
    - [control_24v.24V, axbb-e.I2+]
    - [control_24v.24V, axbb-e.I3+]
    - [control_24v.24V, axbb-e.I4+]
    - [control_24v.24V, axbb-e.I5+]

    - [axbb-e.COIL+, coil_t.COIL+]
    - [axbb-e.COIL-, coil_t.COIL-]
    - [axbb-e.IN-24V0, control_24v0.24V0]
    - [axbb-e.IN-24V+, control_24v.24V]
    - [axbb-e.IN-5V0, control_5v0.5V0]
    - [axbb-e.IN-5V+, control_5v.5V]
    - [axbb-e.VFD_V1, vfd.VI]


  #alarm_limit_board
    - [alarm_limit_board.X1UL_OK, opto_board.X1UL_OK]
    - [alarm_limit_board.X2UL_OK, opto_board.X2UL_OK]
    - [alarm_limit_board.YUL_OK, opto_board.YUL_OK]
    - [alarm_limit_board.ZUL_OK, opto_board.ZUL_OK]
    - [alarm_limit_board.X1_ALM_OK, opto_board.X1_ALM_OK]
    - [alarm_limit_board.X2_ALM_OK, opto_board.X2_ALM_OK]
    - [alarm_limit_board.Y_ALM_OK, opto_board.Y_ALM_OK]
    - [alarm_limit_board.Z_ALM_OK, opto_board.Z_ALM_OK]
    - [alarm_limit_board.5V0, safety_5v0.5V0]
    - [alarm_limit_board.5V, safety_5v.5V]
    - [alarm_limit_board.RUN_RELAY_CTL, run_relay.IN]
    - [alarm_limit_board.UPPER_LIMITS_OK_RELAY_CTL, upper_limits_ok_relay.IN]

  #relay boards
    - [run_relay.COM, safety_24v0.24V0]
    - [run_relay.NO, coil_t.COIL-]
    - [upper_limits_ok_relay.COM, safety_24v0.24V0]
    - [upper_limits_ok_relay.NC, axbb-e.UL1]

  #opto board
    - [opto_board.1+, safety_24v.4A]
    - [opto_board.2+, safety_24v.4B]
    - [opto_board.3+, safety_24v.5A]
    - [opto_board.4+, safety_24v.5B]
    - [opto_board.5+, safety_24v.2A]
    - [opto_board.6+, safety_24v.2B]
    - [opto_board.7+, safety_24v.3A]
    - [opto_board.8+, safety_24v.3B]
    - [opto_board.GND, safety_5v0.5B]
    - [opto_board.VCC, safety_5v.5B]
    - [control_24v0.24V0, terminals_24v0.24V0]

    # Charge-pump optocoupler on the alarm/limit board.
    - [dc_power_24v.24V, alarm_limit_board.24V]
    - from: axbb-e.O1
      to: alarm_limit_board.CPUMP
      net: CHARGE_PUMP

    # As-built VFD commons added 2026-10-17, from DC supply row terminal blocks.
    # Append routes to preserve all existing wire-label assignment keys.
    - [dc_power_24v0.24V0, vfd.DCM]
    - [dc_power_5v0.5V0, vfd.ACM]

  #field box
    - [control_5v.5V,cnc_terminals.67, field_box.5V]
    - [control_5v0.5V0,cnc_terminals.68, field_box.5V0 ]
    - [axbb-e.ATC, cnc_terminals.69, field_box.ATC]
    - [ axbb-e.VAC, cnc_terminals.70 , field_box.VAC]
    - [axbb-e.PROBE1, cnc_terminals.71 , field_box.PROBE1]
    - [ axbb-e.PROBE2, cnc_terminals.72, field_box.PROBE2 ]

no_connects:
  - axbb-e.O5
  - axbb-e.O6
  - axbb-e.O7
  - axbb-e.O8
  - axbb-e.AI2
  - axbb-e.AI1
  - axbb-e.O17

  - y_cl57s.ENA+
  - y_cl57s.ENA-
  - y_cl57s.BRK
  - Z_cl57s.ENA+
  - Z_cl57s.ENA-
  - Z_cl57s.BRK

  - contactor_110.13
  - contactor_110.14
  - contactor_220.13
  - contactor_220.14
  - upper_limits_ok_relay.NO

  - spindle.x
