dcowden/panelviz/src/panelviz/viewer.py

"""Static interactive viewer export."""

from __future__ import annotations

import hashlib
import json
import math
from collections import Counter, defaultdict
from dataclasses import dataclass
from pathlib import Path
from typing import Any

from panelviz.components import PinSide
from panelviz.parser import UnitsConfig
from panelviz.pdf_export import diagram_reference_grid
from panelviz.references import attach_wire_references
from panelviz.routing import RoutedWire, WireRouter
from panelviz.visualization import (
    ApproximateTextMeasurer,
    ComponentVisualConfig,
    PinBox,
    WireLabelSizeCalculator,
    plan_component_sheet_layout,
)


VIEWER_FILES = ("viewer.html", "viewer.css", "viewer.js", "panel-data.json")
_SIDE_ORDER = ("top", "right", "bottom", "left")


def normalize_text_rotation(rotation: float) -> int:
    """Normalize a text rotation to SVG's compact -180..180 range."""

    normalized = int(round(rotation)) % 360
    if normalized > 180:
        normalized -= 360
    return normalized


def rotated_pin_side(side: PinSide | str, component_rotation: float) -> str:
    """Return the screen side a local pin side lands on after component rotation."""

    side_value = side.value if isinstance(side, PinSide) else str(side)
    if side_value not in _SIDE_ORDER:
        return side_value
    turns = (int(round(component_rotation / 90)) % 4 + 4) % 4
    return _SIDE_ORDER[(_SIDE_ORDER.index(side_value) + turns) % len(_SIDE_ORDER)]


def readable_screen_text_rotation_for_side(side: PinSide | str, component_rotation: float) -> int:
    """Choose the only allowed screen angle for side-attached labels."""

    screen_side = rotated_pin_side(side, component_rotation)
    return -90 if screen_side in {"top", "bottom"} else 0


def readable_local_text_rotation(target_screen_rotation: float, component_rotation: float) -> int:
    """Compute local SVG text rotation that renders at the target screen angle."""

    return normalize_text_rotation(target_screen_rotation - component_rotation)


def readable_local_text_rotation_for_side(side: PinSide | str, component_rotation: float) -> int:
    """Local rotation for terminal and wire labels attached to a pin side."""

    return readable_local_text_rotation(
        readable_screen_text_rotation_for_side(side, component_rotation),
        component_rotation,
    )


def readable_center_text_rotation(center_orientation: str, component_rotation: float) -> int:
    """Local rotation for component name/type labels."""

    target = -90 if center_orientation == "vertical" else 0
    return readable_local_text_rotation(target, component_rotation)


def screen_center_text_orientation(
    center_width: float,
    center_height: float,
    text: str,
    preferred_size: float,
    component_rotation: float,
) -> str:
    """Choose center-label orientation from the center dimensions visible on screen."""

    normalized = normalize_text_rotation(component_rotation)
    screen_width, screen_height = (
        (center_height, center_width) if abs(normalized) == 90 else (center_width, center_height)
    )
    estimated_width = max(1.0, len(str(text)) * preferred_size * 0.58)
    if screen_width < screen_height * 0.62 or estimated_width > max(1.0, screen_width - 8):
        return "vertical"
    return "horizontal"


def write_static_viewer(
    router: WireRouter,
    path: str | Path,
    units: UnitsConfig | None = None,
    columns: int | None = None,
    config: ComponentVisualConfig | None = None,
) -> list[Path]:
    """Write a no-build static SVG.js viewer bundle."""

    output_dir = Path(path)
    output_dir.mkdir(parents=True, exist_ok=True)
    data = viewer_data(router, units=units, columns=columns, config=config)

    files = {
        "viewer.html": _viewer_html(),
        "viewer.css": _viewer_css(),
        "viewer.js": _viewer_js(),
        "panel-data.json": json.dumps(data, indent=2),
    }
    written = []
    for name, contents in files.items():
        target = output_dir / name
        target.write_text(contents, encoding="utf-8")
        written.append(target)
    return written


def viewer_data(
    router: WireRouter,
    units: UnitsConfig | None = None,
    columns: int | None = None,
    config: ComponentVisualConfig | None = None,
) -> dict[str, Any]:
    """Build the JSON view model used by the static interactive viewer."""

    render_units = units or UnitsConfig()
    visual_config = config or ComponentVisualConfig()
    components = list(router.components.values())
    sheet = plan_component_sheet_layout(
        components,
        render_units,
        columns,
        visual_config,
        ApproximateTextMeasurer(),
    )
    margin = visual_config.wiring_label_margin_pt
    component_data = []
    anchors: dict[str, _Anchor] = {}

    for layout in sheet.layouts:
        component_x, component_y = sheet.positions[layout.component_name]
        x = component_x + margin + layout.margin_pt
        y = component_y + margin + layout.margin_pt
        pins = []
        for box in layout.pin_boxes:
            anchor = _pin_anchor(box, x, y)
            node = f"{layout.component_name}.{box.pin}"
            node_attrs = router.physical_graph.nodes.get(node, {})
            anchors[node] = anchor
            pins.append(
                {
                    "node": node,
                    "pin": box.pin,
                    "side": box.side.value,
                    "x": box.x,
                    "y": box.y,
                    "width": box.width,
                    "height": box.height,
                    "anchor": {"x": anchor.x, "y": anchor.y},
                    "nets": list(node_attrs.get("exposed_nets", [])),
                    "no_connect": node in router.no_connects,
                }
            )

        component_data.append(
            {
                "name": layout.component_name,
                "type": router.components[layout.component_name].type.value,
                "tags": list(router.components[layout.component_name].tags),
                "x": x,
                "y": y,
                "width": layout.width_pt,
                "height": layout.height_pt,
                "center": {
                    "x": layout.center_x,
                    "y": layout.center_y,
                    "width": layout.center_width,
                    "height": layout.center_height,
                },
                "font": {
                    "pin": layout.typography.pin_font_size_pt,
                    "name": layout.typography.component_name_font_size_pt,
                },
                "pins": pins,
            }
        )

    endpoint_slots = _endpoint_slots(router.routed_wires)
    wires = [_wire_view(wire, anchors, router, visual_config, endpoint_slots) for wire in router.routed_wires]
    data = {
        "canvas": {
            "width": sheet.width_pt + margin * 2,
            "height": sheet.height_pt + margin * 2,
        },
        "styles": {
            "default": router.visualization.default_net_style.model_dump(),
            "nets": {name: style.model_dump() for name, style in router.visualization.net_styles.items()},
        },
        "components": component_data,
        "wires": wires,
        "diagnostics": _diagnostics(router),
    }
    update_transformed_endpoint_geometry(data)
    update_scene_bounds(data)
    data["reference_grid"] = diagram_reference_grid(data)
    attach_wire_references(data)
    return data


def update_transformed_endpoint_geometry(data: dict[str, Any]) -> None:
    """Store endpoint reference points in rendered, post-rotation coordinates."""

    components = {str(component.get("name")): component for component in data.get("components", [])}
    pins_by_node = {
        str(pin.get("node")): (component, pin)
        for component in components.values()
        for pin in component.get("pins", [])
    }

    for component in components.values():
        for pin in component.get("pins", []):
            anchor = _transformed_pin_anchor(component, pin)
            pin["anchor"] = {"x": anchor[0], "y": anchor[1]}

    for wire in data.get("wires", []):
        for endpoint in wire.get("endpoints", []):
            component, pin = pins_by_node.get(str(endpoint.get("node")), (None, None))
            if not component or not pin:
                continue
            _update_transformed_endpoint(component, pin, endpoint)


def update_scene_bounds(data: dict[str, Any], padding: float = 96.0) -> None:
    """Update canvas and scene bounds from rendered component and endpoint geometry."""

    min_x, min_y, max_x, max_y = _scene_content_bounds(data)
    if not math.isfinite(min_x):
        width = float(data.get("canvas", {}).get("width", 1))
        height = float(data.get("canvas", {}).get("height", 1))
        data["scene"] = {"x": 0.0, "y": 0.0, "width": width, "height": height}
        data["canvas"] = {"x": 0.0, "y": 0.0, "width": width, "height": height}
        return

    scene = {
        "x": min_x,
        "y": min_y,
        "width": max(1.0, max_x - min_x),
        "height": max(1.0, max_y - min_y),
    }
    canvas = {
        "x": min_x - padding,
        "y": min_y - padding,
        "width": max(1.0, max_x - min_x + padding * 2),
        "height": max(1.0, max_y - min_y + padding * 2),
    }
    data["scene"] = scene
    data["canvas"] = canvas


def _scene_content_bounds(data: dict[str, Any]) -> tuple[float, float, float, float]:
    min_x = math.inf
    min_y = math.inf
    max_x = -math.inf
    max_y = -math.inf

    def include_rect(x: float, y: float, width: float, height: float) -> None:
        nonlocal min_x, min_y, max_x, max_y
        min_x = min(min_x, x)
        min_y = min(min_y, y)
        max_x = max(max_x, x + width)
        max_y = max(max_y, y + height)

    def include_point(x: float, y: float, pad: float = 0.0) -> None:
        include_rect(x - pad, y - pad, pad * 2, pad * 2)

    for component in data.get("components", []):
        for x, y in _rotated_rect_corners(
            float(component["x"]),
            float(component["y"]),
            float(component["width"]),
            float(component["height"]),
            float(component.get("rotation", 0)),
        ):
            include_point(x, y)
        for pin in component.get("pins", []):
            if pin.get("no_connect"):
                anchor = pin.get("anchor", {})
                include_point(float(anchor.get("x", 0)), float(anchor.get("y", 0)), 34.0)

    for wire in data.get("wires", []):
        for endpoint in wire.get("endpoints", []):
            for point_name in ("anchor", "stub"):
                point = endpoint.get(point_name, {})
                if "x" in point and "y" in point:
                    include_point(float(point["x"]), float(point["y"]), 8.0)
            label = endpoint.get("label", {})
            if "x" not in label or "y" not in label:
                continue
            label_width = float(label.get("width", 44))
            label_height = float(label.get("height", 17))
            if int(label.get("rotation", 0)) % 180:
                label_width, label_height = label_height, label_width
            include_rect(
                float(label["x"]) - label_width / 2,
                float(label["y"]) - label_height / 2,
                label_width,
                label_height,
            )

    return min_x, min_y, max_x, max_y


def _rotated_rect_corners(x: float, y: float, width: float, height: float, rotation: float) -> list[tuple[float, float]]:
    center = (x + width / 2, y + height / 2)
    corners = [(x, y), (x + width, y), (x + width, y + height), (x, y + height)]
    return [_rotate_point(point, center, rotation) for point in corners]


def _rotate_point(point: tuple[float, float], center: tuple[float, float], rotation: float) -> tuple[float, float]:
    radians = math.radians(rotation)
    px, py = point
    cx, cy = center
    dx, dy = px - cx, py - cy
    return (cx + dx * math.cos(radians) - dy * math.sin(radians), cy + dx * math.sin(radians) + dy * math.cos(radians))


def _transformed_pin_anchor(component: dict[str, Any], pin: dict[str, Any]) -> tuple[float, float]:
    return _transform_component_local_point(component, _pin_boundary_point(pin))


def _update_transformed_endpoint(component: dict[str, Any], pin: dict[str, Any], endpoint: dict[str, Any]) -> None:
    local_side = str(endpoint.get("side") or pin.get("side") or "bottom")
    dx, dy = _side_vector_value(local_side)
    label = endpoint.get("label", {})
    slot = int(label.get("slot", 0) or 0)
    stub_length = float(endpoint.get("stub_length", 0) or 0)
    label_width = float(label.get("width", 44) or 44)
    label_gap = float(endpoint.get("label_gap", 0) or 0)
    stub_distance = stub_length + slot * (label_width + stub_length)
    label_offset = label_gap + label_width / 2
    anchor = _pin_boundary_point(pin)
    stub = (anchor[0] + dx * stub_distance, anchor[1] + dy * stub_distance)
    label_point = (stub[0] + dx * label_offset, stub[1] + dy * label_offset)
    anchor_x, anchor_y = _transform_component_local_point(component, anchor)
    stub_x, stub_y = _transform_component_local_point(component, stub)
    label_x, label_y = _transform_component_local_point(component, label_point)

    endpoint["anchor"] = {"x": anchor_x, "y": anchor_y}
    endpoint["stub"] = {"x": stub_x, "y": stub_y}
    endpoint["stub_distance"] = stub_distance
    label["x"] = label_x
    label["y"] = label_y
    label["rotation"] = readable_screen_text_rotation_for_side(local_side, float(component.get("rotation", 0) or 0))


def _pin_boundary_point(pin: dict[str, Any]) -> tuple[float, float]:
    x = float(pin.get("x", 0) or 0)
    y = float(pin.get("y", 0) or 0)
    width = float(pin.get("width", 0) or 0)
    height = float(pin.get("height", 0) or 0)
    side = str(pin.get("side") or "bottom")
    if side == "left":
        return x, y + height / 2
    if side == "right":
        return x + width, y + height / 2
    if side == "top":
        return x + width / 2, y
    return x + width / 2, y + height


def _transform_component_local_point(component: dict[str, Any], point: tuple[float, float]) -> tuple[float, float]:
    width = float(component.get("width", 0) or 0)
    height = float(component.get("height", 0) or 0)
    rotated = _rotate_point(point, (width / 2, height / 2), float(component.get("rotation", 0) or 0))
    return float(component.get("x", 0) or 0) + rotated[0], float(component.get("y", 0) or 0) + rotated[1]


def _side_vector_value(side: str) -> tuple[float, float]:
    if side == "left":
        return -1.0, 0.0
    if side == "right":
        return 1.0, 0.0
    if side == "top":
        return 0.0, -1.0
    return 0.0, 1.0


@dataclass(frozen=True)
class _Anchor:
    x: float
    y: float
    side: PinSide
    terminal_width_pt: float


@dataclass(frozen=True)
class _EndpointSlot:
    index: int
    count: int


def _pin_anchor(box: PinBox, offset_x: float, offset_y: float) -> _Anchor:
    terminal_width = min(box.width, box.height)
    if box.side == PinSide.LEFT:
        return _Anchor(offset_x + box.x, offset_y + box.y + box.height / 2, box.side, terminal_width)
    if box.side == PinSide.RIGHT:
        return _Anchor(offset_x + box.x + box.width, offset_y + box.y + box.height / 2, box.side, terminal_width)
    if box.side == PinSide.TOP:
        return _Anchor(offset_x + box.x + box.width / 2, offset_y + box.y, box.side, terminal_width)
    return _Anchor(offset_x + box.x + box.width / 2, offset_y + box.y + box.height, box.side, terminal_width)


def _wire_view(
    wire: RoutedWire,
    anchors: dict[str, _Anchor],
    router: WireRouter,
    config: ComponentVisualConfig,
    endpoint_slots: dict[tuple[int, str], _EndpointSlot],
) -> dict[str, Any]:
    from_anchor = anchors[str(wire.from_pin)]
    to_anchor = anchors[str(wire.to_pin)]
    style_model = router.visualization.style_for_net(wire.net_name or "")
    style = style_model.model_dump()
    style["line_weight"] = _wire_line_weight(style_model.line_weight, wire.awg)
    return {
        "index": wire.index,
        "label": wire.wire_label or f"wire-{wire.index}",
        "net": wire.net_name or "",
        "awg": wire.awg,
        "from": str(wire.from_pin),
        "to": str(wire.to_pin),
        "from_component": wire.from_pin.component,
        "from_pin": wire.from_pin.pin,
        "to_component": wire.to_pin.component,
        "to_pin": wire.to_pin.pin,
        "tags": _wire_tags(router, wire.from_pin.component, wire.to_pin.component),
        "source": {
            "row": wire.source_row_index,
            "segment": wire.source_segment_index,
            "route_length": wire.source_route_length,
        },
        "style": style,
        "endpoints": [
            _endpoint_view(
                str(wire.from_pin),
                wire.from_pin.component,
                wire.from_pin.pin,
                wire.wire_label or f"wire-{wire.index}",
                from_anchor,
                config,
                endpoint_slots[(wire.index, "from")],
            ),
            _endpoint_view(
                str(wire.to_pin),
                wire.to_pin.component,
                wire.to_pin.pin,
                wire.wire_label or f"wire-{wire.index}",
                to_anchor,
                config,
                endpoint_slots[(wire.index, "to")],
            ),
        ],
    }


def _endpoint_view(
    node: str,
    component: str,
    pin: str,
    wire_label: str,
    anchor: _Anchor,
    config: ComponentVisualConfig,
    slot: _EndpointSlot,
) -> dict[str, Any]:
    dx, dy = _side_vector(anchor.side)
    label_size = WireLabelSizeCalculator().for_label(wire_label, anchor.terminal_width_pt)
    label_width = label_size.width_pt
    stub_distance = config.wire_stub_pt + slot.index * (label_width + config.wire_stub_pt)
    stub = {
        "x": anchor.x + dx * stub_distance,
        "y": anchor.y + dy * stub_distance,
    }
    label_height = label_size.height_pt
    label_offset = config.wire_label_gap_pt + label_width / 2
    label_position = {
        "x": stub["x"] + dx * label_offset,
        "y": stub["y"] + dy * label_offset,
        "width": label_width,
        "height": label_height,
        "font_size": label_size.font_size_pt,
        "corner_radius": label_size.corner_radius_pt,
        "rotation": 0,
        "side": anchor.side.value,
        "slot": slot.index,
        "slot_count": slot.count,
    }
    if anchor.side in {PinSide.TOP, PinSide.BOTTOM}:
        label_position["rotation"] = 90

    return {
        "node": node,
        "component": component,
        "pin": pin,
        "side": anchor.side.value,
        "anchor": {"x": anchor.x, "y": anchor.y},
        "stub": stub,
        "stub_length": config.wire_stub_pt,
        "stub_distance": stub_distance,
        "label_gap": config.wire_label_gap_pt,
        "dot_radius": config.wire_endpoint_radius_pt,
        "label": label_position,
    }


def _wire_line_weight(base_weight: float, awg: int | None) -> float:
    if awg is None:
        return base_weight
    weight = base_weight + max(0, 20 - awg) * 0.12
    if awg <= 12:
        weight *= 2
    return max(base_weight, weight)


def _wire_tags(router: WireRouter, from_component: str, to_component: str) -> str:
    tags: list[str] = []
    for component_name in (from_component, to_component):
        for tag in router.components[component_name].tags:
            if tag not in tags:
                tags.append(tag)
    return ", ".join(tags)


def _side_vector(side: PinSide) -> tuple[float, float]:
    if side == PinSide.LEFT:
        return -1.0, 0.0
    if side == PinSide.RIGHT:
        return 1.0, 0.0
    if side == PinSide.TOP:
        return 0.0, -1.0
    return 0.0, 1.0


def _fan_offset(side: PinSide, slot: _EndpointSlot, spacing: float) -> tuple[float, float]:
    if slot.count <= 1:
        return 0.0, 0.0
    offset = (slot.index - (slot.count - 1) / 2) * spacing
    if side in {PinSide.LEFT, PinSide.RIGHT}:
        return 0.0, offset
    return offset, 0.0


def _wire_label_padding(config: ComponentVisualConfig) -> float:
    return WireLabelSizeCalculator().for_label("", config.terminal_width_pt).padding_pt


def _wire_label_height(config: ComponentVisualConfig) -> float:
    return WireLabelSizeCalculator().for_label("", config.terminal_width_pt).height_pt


def _wire_label_width(label: str, config: ComponentVisualConfig) -> float:
    return WireLabelSizeCalculator().for_label(label, config.terminal_width_pt).width_pt


def _endpoint_slots(wires: list[RoutedWire]) -> dict[tuple[int, str], _EndpointSlot]:
    endpoints = []
    for wire in wires:
        endpoints.append(((wire.index, "from"), str(wire.from_pin)))
        endpoints.append(((wire.index, "to"), str(wire.to_pin)))

    counts = Counter(node for _, node in endpoints)
    seen: defaultdict[str, int] = defaultdict(int)
    slots: dict[tuple[int, str], _EndpointSlot] = {}
    for key, node in endpoints:
        slots[key] = _EndpointSlot(index=seen[node], count=counts[node])
        seen[node] += 1
    return slots


def _diagnostics(router: WireRouter) -> dict[str, list[dict[str, Any]]]:
    unconnected = []
    multi_connected = []
    isolated_components = []
    for component_name, component in router.components.items():
        statuses = router.pin_statuses(component_name)
        routed_count = sum(status.connection_count for status in statuses)
        if routed_count == 0:
            isolated_components.append({"component": component_name, "type": component.type.value})
        for status in statuses:
            node = str(status.pin)
            if not status.is_routed and not status.is_no_connect:
                unconnected.append({"node": node, "component": status.pin.component, "pin": status.pin.pin})
            if status.connection_count > 1:
                multi_connected.append(
                    {
                        "node": node,
                        "component": status.pin.component,
                        "pin": status.pin.pin,
                        "connections": status.connection_count,
                    }
                )
    return {
        "unconnected_pins": unconnected,
        "multi_connected_pins": multi_connected,
        "isolated_components": isolated_components,
    }


def _viewer_html() -> str:
    asset_version = hashlib.sha1((_viewer_css() + _viewer_js()).encode("utf-8")).hexdigest()[:12]
    return f"""<!doctype html>
<html lang="en">
<head>
  <meta charset="utf-8">
  <meta name="viewport" content="width=device-width, initial-scale=1">
  <title>PanelViz Viewer</title>
  <link rel="stylesheet" href="viewer.css?v={asset_version}">
  <script src="https://cdn.jsdelivr.net/npm/@svgdotjs/svg.js@3.2.4/dist/svg.min.js"></script>
</head>
<body>
  <main class="app-shell">
    <header class="toolbar">
      <div>
        <h1>PanelViz</h1>
        <p id="status">Loading panel...</p>
      </div>
      <div class="help-strip">
        <span>Drag canvas: pan</span>
        <span>Shift-drag canvas: select components</span>
        <span>Wheel: zoom</span>
        <span>Right-click canvas: clear</span>
        <span>Right-click component: rotate</span>
      </div>
      <div class="diagnostic-actions" role="group" aria-label="Diagnostic highlighting">
        <button id="show-unconnected" type="button">Unconnected</button>
        <button id="show-multiconnected" type="button">Multi-connected</button>
        <button id="show-isolated" type="button">No Connections</button>
      </div>
      <div class="controls" role="group" aria-label="Highlight mode">
        <label><input type="radio" name="highlight-mode" value="wire" checked> Wire</label>
        <label><input type="radio" name="highlight-mode" value="net"> Net</label>
        <button id="toggle-reference-grid" type="button" aria-pressed="false">Ref Grid</button>
        <button id="toggle-wire-table" type="button" aria-expanded="true" title="Collapse wire list">Wire List &lt;</button>
        <button id="clear-selection" type="button">Clear</button>
      </div>
    </header>
    <section class="workspace">
      <section id="canvas-host" aria-label="Interactive PanelViz wiring canvas"></section>
      <div id="wire-table-resizer" aria-hidden="true"></div>
      <aside class="wire-table-panel" aria-label="Wire list">
        <div class="wire-table-header">
          <h2>Wire List <span id="wire-table-count" class="wire-table-count">0 wires</span></h2>
          <div class="wire-table-actions">
            <label class="wire-tag-filter">Tag <input id="wire-tag-filter" type="search" list="wire-tag-options" placeholder="all"></label>
            <datalist id="wire-tag-options"></datalist>
            <button id="toggle-wire-columns" type="button">Split Columns</button>
          </div>
        </div>
        <div class="wire-table-scroll">
          <table class="wire-table">
            <thead id="wire-table-head"></thead>
            <tbody id="wire-table-body"></tbody>
          </table>
        </div>
      </aside>
    </section>
  </main>
  <script src="viewer.js?v={asset_version}"></script>
</body>
</html>
"""


def _viewer_css() -> str:
    return """html, body {
  height: 100%;
  margin: 0;
  font-family: "Segoe UI", Arial, Helvetica, sans-serif;
  color: #0f172a;
  background: #e5e7eb;
}
.app-shell {
  height: 100%;
  display: grid;
  grid-template-rows: auto 1fr;
}
.workspace {
  min-height: 0;
  display: grid;
  grid-template-columns: minmax(0, 1fr) 6px var(--wire-table-width, 420px);
}
.workspace.table-collapsed {
  grid-template-columns: minmax(0, 1fr) 0 0;
}
.toolbar {
  display: flex;
  align-items: center;
  justify-content: space-between;
  gap: 24px;
  padding: 12px 16px;
  border-bottom: 1px solid #cbd5e1;
  background: #ffffff;
}
.help-strip {
  display: flex;
  flex-wrap: wrap;
  gap: 6px;
  color: #475569;
  font-size: 11px;
}
.help-strip span {
  padding: 2px 6px;
  border: 1px solid #cbd5e1;
  border-radius: 4px;
  background: #f8fafc;
}
h1 {
  margin: 0;
  font-size: 18px;
}
p {
  margin: 2px 0 0;
  color: #64748b;
  font-size: 12px;
}
.controls {
  display: flex;
  align-items: center;
  gap: 12px;
  font-size: 13px;
}
.diagnostic-actions,
.wire-table-actions {
  display: flex;
  align-items: center;
  gap: 6px;
}
.wire-tag-filter {
  display: flex;
  align-items: center;
  gap: 4px;
  color: #475569;
  font-size: 12px;
}
.wire-tag-filter input {
  width: 96px;
  border: 1px solid #94a3b8;
  border-radius: 4px;
  padding: 4px 6px;
  font: inherit;
}
button {
  border: 1px solid #94a3b8;
  background: #f8fafc;
  color: #0f172a;
  padding: 5px 9px;
  border-radius: 4px;
}
#canvas-host {
  min-height: 0;
  overflow: auto;
  background:
    linear-gradient(#f8fafc 1px, transparent 1px),
    linear-gradient(90deg, #f8fafc 1px, transparent 1px),
    #eef2f7;
  background-size: 24px 24px;
}
#canvas-host.panning {
  cursor: grabbing;
}
#wire-table-resizer {
  min-height: 0;
  cursor: col-resize;
  background: #dbe3ee;
}
#wire-table-resizer:hover {
  background: #94a3b8;
}
.table-collapsed #wire-table-resizer,
.table-collapsed .wire-table-panel {
  display: none;
}
.wire-table-panel {
  min-width: 0;
  min-height: 0;
  display: grid;
  grid-template-rows: auto 1fr;
  border-left: 1px solid #cbd5e1;
  background: #ffffff;
}
.wire-table-header {
  display: flex;
  align-items: center;
  justify-content: space-between;
  gap: 8px;
  padding: 10px 12px;
  border-bottom: 1px solid #e2e8f0;
}
h2 {
  margin: 0;
  font-size: 14px;
}
.wire-table-count {
  display: inline-block;
  margin-left: 8px;
  color: #64748b;
  font-size: 12px;
  font-weight: 700;
}
.wire-table-scroll {
  overflow: auto;
}
.wire-table {
  width: 100%;
  border-collapse: collapse;
  font-size: 12px;
}
.wire-table th,
.wire-table td {
  padding: 6px 8px;
  border-bottom: 1px solid #e2e8f0;
  text-align: left;
  white-space: nowrap;
}
.wire-table th {
  position: sticky;
  top: 0;
  z-index: 1;
  background: #f8fafc;
  color: #475569;
  font-weight: 800;
}
.wire-table thead tr:nth-child(2) th {
  top: 29px;
}
.wire-table th button {
  width: 100%;
  border: 0;
  padding: 0;
  background: transparent;
  color: inherit;
  font: inherit;
  text-align: inherit;
  cursor: pointer;
}
.wire-table th button::after {
  content: attr(data-sort-marker);
  padding-left: 4px;
}
.wire-table-row {
  border-left: 4px solid var(--net-color, #475569);
  cursor: pointer;
}
.wire-table-row:hover {
  background: #f8fafc;
}
.wire-table-row.dimmed {
  opacity: 0.3;
}
.wire-table-row.selected {
  background: color-mix(in srgb, var(--net-color, #475569) 12%, white);
}
.wire-chip {
  display: inline-block;
  min-width: 58px;
  padding: 2px 6px;
  border: 1px solid var(--net-color, #475569);
  border-radius: 4px;
  background: color-mix(in srgb, var(--net-color, #475569) 10%, white);
  font-weight: 800;
}
svg {
  display: block;
  min-width: 100%;
  min-height: 100%;
}
.component {
  cursor: grab;
}
.component.dragging {
  cursor: grabbing;
}
.component.selected .component-body {
  stroke-width: 1.4;
}
.component.group-selected .component-body,
.component.group-selected .component-outline-overlay {
  stroke: #2563eb;
  stroke-width: 1.4;
}
.component-body {
  fill: #ffffff;
  stroke: #1f2937;
  stroke-width: 0.9;
  filter: drop-shadow(0 3px 6px rgb(15 23 42 / 0.14));
}
.component-outline-overlay {
  fill: none;
  stroke: #1f2937;
  stroke-width: 0.9;
  pointer-events: none;
}
.component-center {
  fill: #ffffff;
}
.component-name {
  font-family: "Segoe UI", Arial, Helvetica, sans-serif;
  text-anchor: middle;
  dominant-baseline: middle;
  fill: #0f172a;
  font-weight: 800;
  pointer-events: none;
}
.component-type {
  font-family: "Segoe UI", Arial, Helvetica, sans-serif;
  text-anchor: middle;
  dominant-baseline: middle;
  fill: #64748b;
  font-weight: 700;
  pointer-events: none;
}
.pin-box {
  fill: #f8fafc;
  stroke: #94a3b8;
  stroke-width: 0.4;
  cursor: pointer;
}
.pin-label {
  font-family: "Segoe UI", Arial, Helvetica, sans-serif;
  text-anchor: middle;
  dominant-baseline: middle;
  fill: #0f172a;
  pointer-events: none;
}
.no-connect-stub {
  stroke: #dc2626;
  stroke-width: 0.9;
  stroke-linecap: round;
  pointer-events: none;
}
.no-connect-dot {
  fill: #dc2626;
  stroke: #ffffff;
  stroke-width: 0.45;
  pointer-events: none;
}
.no-connect-x {
  stroke: #dc2626;
  stroke-width: 1.0;
  stroke-linecap: round;
  pointer-events: none;
}
.scene-layer {
  isolation: isolate;
}
.debug-layer,
.interaction-layer {
  pointer-events: none;
}
.wire-stub {
  fill: none;
  stroke: var(--net-color, #475569);
  stroke-width: var(--net-weight, 1.6);
  stroke-dasharray: var(--net-dasharray, none);
  stroke-linecap: round;
}
.wire-dot {
  fill: var(--net-color, #475569);
  stroke: #ffffff;
  stroke-width: 0.45;
}
.wire-label-bg {
  fill: #ffffff;
  stroke: var(--net-color, #475569);
  stroke-width: 0.45;
}
.wire-label-text {
  font-family: "Segoe UI", Arial, Helvetica, sans-serif;
  text-anchor: middle;
  dominant-baseline: middle;
  font-weight: 900;
  fill: #0f172a;
  pointer-events: none;
}
.wire-label-group {
  cursor: pointer;
}
.dimmed {
  opacity: 0.18;
}
.selected .wire-stub,
.selected.wire-stub {
  stroke-width: var(--net-selected-weight, 4);
}
.selected .wire-dot,
.selected.wire-dot {
  stroke: var(--net-color, #475569);
  stroke-width: 1;
}
.selected .wire-label-bg,
.selected.wire-label-bg,
.selected.pin-box,
.diagnostic-selected.pin-box {
  stroke: var(--net-color, #475569);
  stroke-width: 1.2;
  fill: color-mix(in srgb, var(--net-color, #475569) 12%, white);
}
.diagnostic-selected.pin-box {
  --net-color: #dc2626;
}
.diagnostic-selected .wire-label-bg,
.diagnostic-selected.wire-label-bg {
  stroke: #dc2626;
  stroke-width: 1.2;
  fill: color-mix(in srgb, #dc2626 10%, white);
}
.diagnostic-selected .wire-stub {
  stroke: #dc2626;
  stroke-width: 1.8;
}
.diagnostic-selected .wire-dot {
  fill: #dc2626;
}
.diagnostic-selected.component .component-body,
.diagnostic-selected.component .component-outline-overlay {
  stroke: #dc2626;
  stroke-width: 1.6;
}
.selection-marquee {
  fill: rgb(37 99 235 / 0.12);
  stroke: #2563eb;
  stroke-width: 1.5;
  stroke-dasharray: 7 4;
  pointer-events: none;
}
.reference-grid-layer {
  display: none;
  pointer-events: none;
}
.reference-grid-layer.visible {
  display: block;
}
.reference-grid-line {
  stroke: #f97316;
  stroke-width: 0.85;
  stroke-dasharray: 8 6;
  vector-effect: non-scaling-stroke;
  opacity: 0.6;
}
.reference-grid-label {
  fill: #c2410c;
  font-family: "Segoe UI", Arial, Helvetica, sans-serif;
  font-size: 14px;
  font-weight: 800;
  text-anchor: middle;
  dominant-baseline: middle;
  opacity: 0.48;
  paint-order: stroke;
  stroke: #ffffff;
  stroke-width: 3px;
  vector-effect: non-scaling-stroke;
}
"""


def _viewer_js() -> str:
    return """const NS = 'http://www.w3.org/2000/svg';

const state = {
  mode: 'wire',
  selectedWire: null,
  selectedNet: null,
  selectedWires: [],
  selectedNets: [],
  selectedNode: null,
  selectedComponent: null,
  selectedComponents: [],
  viewBox: null,
  canvas: null,
  scene: null,
  data: null,
  components: new Map(),
  tableMode: 'combined',
  sortKey: 'index',
  sortDirection: 'asc',
  tagFilter: '',
  diagnosticNodes: [],
  diagnosticComponents: [],
};

const host = document.getElementById('canvas-host');
const workspace = document.querySelector('.workspace');
const statusEl = document.getElementById('status');
const wireTableHead = document.getElementById('wire-table-head');
const wireTableBody = document.getElementById('wire-table-body');
const wireTableCount = document.getElementById('wire-table-count');
const toggleWireColumnsButton = document.getElementById('toggle-wire-columns');
const toggleWireTableButton = document.getElementById('toggle-wire-table');
const toggleReferenceGridButton = document.getElementById('toggle-reference-grid');
const wireTableResizer = document.getElementById('wire-table-resizer');
const wireTagFilterInput = document.getElementById('wire-tag-filter');
const wireTagOptions = document.getElementById('wire-tag-options');
const diagnosticButtons = {
  unconnected: document.getElementById('show-unconnected'),
  multiconnected: document.getElementById('show-multiconnected'),
  isolated: document.getElementById('show-isolated'),
};

document.querySelectorAll('input[name="highlight-mode"]').forEach((input) => {
  input.addEventListener('change', () => {
    state.mode = input.value;
    if (state.selectedComponent) {
      selectComponent(state.selectedComponent);
    } else if (state.selectedNode) {
      selectPin(state.selectedNode);
    } else {
      applyHighlight();
    }
  });
});

document.getElementById('clear-selection').addEventListener('click', () => {
  clearSelectionState();
  setDiagnosticButtonState(null);
  applyHighlight();
});

document.getElementById('show-unconnected').addEventListener('click', () => {
  selectDiagnosticNodes(state.data.diagnostics.unconnected_pins.map((item) => item.node));
  setDiagnosticButtonState('unconnected');
});

document.getElementById('show-multiconnected').addEventListener('click', () => {
  selectDiagnosticNodes(state.data.diagnostics.multi_connected_pins.map((item) => item.node));
  setDiagnosticButtonState('multiconnected');
});

document.getElementById('show-isolated').addEventListener('click', () => {
  clearSelectionState();
  state.diagnosticComponents = state.data.diagnostics.isolated_components.map((item) => item.component);
  setDiagnosticButtonState('isolated');
  applyHighlight();
});

toggleWireColumnsButton.addEventListener('click', () => {
  state.tableMode = state.tableMode === 'combined' ? 'split' : 'combined';
  toggleWireColumnsButton.textContent = state.tableMode === 'combined' ? 'Split Columns' : 'Combined Columns';
  renderWireTable(state.data.wires);
  applyHighlight();
});

toggleWireTableButton.addEventListener('click', () => {
  workspace.classList.toggle('table-collapsed');
  const collapsed = workspace.classList.contains('table-collapsed');
  toggleWireTableButton.textContent = collapsed ? 'Wire List >' : 'Wire List <';
  toggleWireTableButton.setAttribute('aria-expanded', String(!collapsed));
  toggleWireTableButton.setAttribute('title', collapsed ? 'Expand wire list' : 'Collapse wire list');
});

if (wireTagFilterInput) {
  wireTagFilterInput.addEventListener('input', () => {
    state.tagFilter = wireTagFilterInput.value.trim().toLowerCase();
    renderWireTable(state.data.wires);
    applyHighlight();
  });
}

toggleReferenceGridButton.addEventListener('click', () => {
  const svg = host.querySelector('svg');
  const layer = host.querySelector('.reference-grid-layer');
  const visible = !(layer?.classList.contains('visible') ?? false);
  updateReferenceGrid(svg, visible);
});

fetch('panel-data.json', { cache: 'no-store' })
  .then((response) => response.json().then((data) => {
    if (!response.ok) throw new Error(data.error || `${response.status} ${response.statusText}`);
    return data;
  }))
  .then((data) => render(data))
  .catch((error) => {
    statusEl.textContent = `Could not load panel-data.json: ${error}`;
  });

function render(data, options = {}) {
  host.textContent = '';
  if (data.error) {
    statusEl.textContent = `Could not load panel-data.json: ${data.error}`;
    return;
  }
  const preservedViewBox = options.preserveViewBox && state.viewBox ? { ...state.viewBox } : null;
  state.data = data;
  state.components = new Map(data.components.map((component) => [component.name, {
    ...component,
    baseX: component.x,
    baseY: component.y,
    endpointOriginX: component.x,
    endpointOriginY: component.y,
    rotation: component.rotation || 0,
  }]));
  state.canvas = normalizeBounds(data.canvas);
  state.scene = normalizeBounds(data.scene || data.canvas);
  state.viewBox = preservedViewBox || fitBoundsToViewport(state.scene, 72);
  const svg = createCanvas(state.canvas);
  const layers = createSceneLayers(svg);

  data.components.forEach((component) => renderComponent(layers.physical, component));
  data.wires.forEach((wire) => renderWireEndpointGroups(wire, layers.labels));
  sortEndpointLayers();
  state.scene = renderedSceneBounds(svg, state.scene);
  updateReferenceGrid(svg, false);
  if (!preservedViewBox) {
    state.viewBox = fitBoundsToViewport(state.scene, 72);
  }
  setViewBox(svg);
  populateTagFilterOptions(data.wires);
  renderWireTable(data.wires);

  enableDrag(svg);
  enableMarqueeSelect(svg);
  enablePan(svg);
  enableZoom(svg);
  enableContextMenu(svg);
  enableTableResize();
  statusEl.textContent = `${data.components.length} components, ${data.wires.length} wires. SVG.js ${window.SVG ? 'loaded' : 'fallback renderer active'}.`;
}

window.PanelVizRender = render;
window.PanelVizRefreshData = refreshData;

function refreshData(data, options = {}) {
  if (data.error) {
    statusEl.textContent = `Could not load panel-data.json: ${data.error}`;
    return;
  }
  const componentNames = new Set(data.components.map((component) => component.name));
  const existingNames = new Set([...state.components.keys()]);
  const componentSetChanged = componentNames.size !== existingNames.size
    || [...componentNames].some((name) => !existingNames.has(name));
  if (!host.querySelector('svg') || componentSetChanged) {
    render(data, options);
    return;
  }

  state.data = data;
  state.canvas = normalizeBounds(data.canvas);
  state.scene = normalizeBounds(data.scene || data.canvas);
  data.components.forEach((component) => {
    const existing = state.components.get(component.name) || {};
    state.components.set(component.name, {
      ...component,
      x: existing.x ?? component.x,
      y: existing.y ?? component.y,
      baseX: existing.baseX ?? component.x,
      baseY: existing.baseY ?? component.y,
      endpointOriginX: component.x,
      endpointOriginY: component.y,
      rotation: existing.rotation ?? component.rotation ?? 0,
    });
  });

  const labelsLayer = host.querySelector('.wire-label-layer');
  if (labelsLayer) labelsLayer.textContent = '';
  data.wires.forEach((wire) => renderWireEndpointGroups(wire, labelsLayer));
  const svg = host.querySelector('svg');
  const oldGrid = host.querySelector('.reference-grid-layer');
  const gridVisible = oldGrid?.classList.contains('visible') ?? false;
  sortEndpointLayers();
  state.scene = renderedSceneBounds(svg, state.scene);
  updateReferenceGrid(svg, gridVisible);
  populateTagFilterOptions(data.wires);
  renderWireTable(data.wires);
  applyHighlight();
  statusEl.textContent = `${data.components.length} components, ${data.wires.length} wires. SVG.js ${window.SVG ? 'loaded' : 'fallback renderer active'}.`;
}

function createCanvas(canvas) {
  if (window.SVG) {
    const draw = SVG().addTo(host).viewbox(canvas.x, canvas.y, canvas.width, canvas.height).attr({
      role: 'img',
      'aria-label': 'PanelViz interactive wiring viewer',
    });
    return draw.node;
  }
  const svg = el('svg', {
    viewBox: `${canvas.x} ${canvas.y} ${canvas.width} ${canvas.height}`,
    role: 'img',
    'aria-label': 'PanelViz interactive wiring viewer',
  });
  host.appendChild(svg);
  return svg;
}

function createSceneLayers(svg) {
  const physical = el('g', { class: 'scene-layer physical-layer components-layer' });
  const labels = el('g', { class: 'scene-layer wire-label-layer' });
  const interaction = el('g', { class: 'scene-layer interaction-layer' });
  const debug = el('g', { class: 'scene-layer debug-layer' });
  svg.appendChild(physical);
  svg.appendChild(labels);
  svg.appendChild(interaction);
  svg.appendChild(debug);
  return { physical, labels, interaction, debug };
}

function updateReferenceGrid(svg, visible = false) {
  const debugLayer = host.querySelector('.debug-layer');
  if (!debugLayer) return;
  debugLayer.textContent = '';
  if (!svg) return;
  const bounds = renderedSceneBounds(svg, state.scene || state.canvas);
  const grid = referenceGridFromBounds(bounds, state.data?.reference_grid);
  if (state.data) state.data.reference_grid = grid;
  applyWireReferences(grid);
  renderReferenceGrid(debugLayer, grid, visible);
  if (state.data && wireTableBody.children.length) renderWireTable(state.data.wires);
}

function referenceGridFromBounds(bounds, fallbackGrid = {}) {
  const normalized = normalizeBounds(bounds);
  const columns = Math.max(8, Math.min(80, Number(fallbackGrid?.columns) || Math.ceil(normalized.width / 90)));
  const rows = Math.max(4, Math.min(26, Number(fallbackGrid?.rows) || Math.ceil(normalized.height / 90)));
  const verticals = [];
  const horizontals = [];
  for (let index = 0; index <= columns; index += 1) {
    verticals.push(normalized.x + (normalized.width * index) / columns);
  }
  for (let index = 0; index <= rows; index += 1) {
    horizontals.push(normalized.y + (normalized.height * index) / rows);
  }
  const labels = [];
  for (let row = 0; row < rows; row += 1) {
    const rowLabel = String.fromCharCode('A'.charCodeAt(0) + row);
    for (let col = 0; col < columns; col += 1) {
      labels.push({
        ref: `${rowLabel}${col + 1}`,
        x: (verticals[col] + verticals[col + 1]) / 2,
        y: (horizontals[row] + horizontals[row + 1]) / 2,
      });
    }
  }
  return {
    columns: columns || fallbackGrid.columns || 8,
    rows: rows || fallbackGrid.rows || 4,
    verticals,
    horizontals,
    labels,
  };
}

function renderReferenceGrid(parentLayer, grid, visible = false) {
  if (!parentLayer || !grid || !grid.verticals?.length || !grid.horizontals?.length) return;
  const gridGroup = el('g', {
    class: `reference-grid-layer${visible ? ' visible' : ''}`,
    'data-columns': grid.columns,
    'data-rows': grid.rows,
  });
  const minY = grid.horizontals[0];
  const maxY = grid.horizontals[grid.horizontals.length - 1];
  const minX = grid.verticals[0];
  const maxX = grid.verticals[grid.verticals.length - 1];
  grid.verticals.forEach((x) => {
    gridGroup.appendChild(el('line', {
      class: 'reference-grid-line',
      x1: x,
      y1: minY,
      x2: x,
      y2: maxY,
    }));
  });
  grid.horizontals.forEach((y) => {
    gridGroup.appendChild(el('line', {
      class: 'reference-grid-line',
      x1: minX,
      y1: y,
      x2: maxX,
      y2: y,
    }));
  });
  grid.labels.forEach((label) => {
    gridGroup.appendChild(textEl(label.ref, {
      class: 'reference-grid-label',
      x: label.x,
      y: label.y,
    }));
  });
  parentLayer.appendChild(gridGroup);
  toggleReferenceGridButton.setAttribute('aria-pressed', String(visible));
}

function applyWireReferences(grid) {
  if (!state.data?.wires || !grid?.verticals?.length || !grid?.horizontals?.length) return;
  state.data.wires.forEach((wire) => {
    const fromAnchor = renderedEndpointAnchor(wire, wire.endpoints?.[0]);
    const toAnchor = renderedEndpointAnchor(wire, wire.endpoints?.[1]);
    wire.from_ref = fromAnchor ? referenceForPoint(grid, fromAnchor.x, fromAnchor.y) : '';
    wire.to_ref = toAnchor ? referenceForPoint(grid, toAnchor.x, toAnchor.y) : '';
  });
}

function renderedEndpointAnchor(wire, endpoint) {
  if (!endpoint) return null;
  const component = state.components.get(endpoint.component);
  const pin = component?.pins?.find((item) => item.node === endpoint.node);
  if (component && pin) {
    return transformComponentLocalPoint(component, pinBoundaryPoint(pin));
  }
  return endpoint.anchor || null;
}

function transformComponentLocalPoint(component, point) {
  const rotated = rotatePoint(
    point,
    { x: component.width / 2, y: component.height / 2 },
    Number(component.rotation || 0),
  );
  return {
    x: Number(component.x) + rotated.x,
    y: Number(component.y) + rotated.y,
  };
}

function referenceForPoint(grid, x, y) {
  let col = 0;
  while (col + 1 < grid.verticals.length && Number(x) >= grid.verticals[col + 1]) col += 1;
  let row = 0;
  while (row + 1 < grid.horizontals.length && Number(y) >= grid.horizontals[row + 1]) row += 1;
  col = Math.max(0, Math.min(grid.columns - 1, col));
  row = Math.max(0, Math.min(grid.rows - 1, row));
  return `${String.fromCharCode('A'.charCodeAt(0) + row)}${col + 1}`;
}

function renderComponent(layer, component) {
  const storedComponent = state.components.get(component.name);
  const group = el('g', {
    class: 'component',
    'data-component': component.name,
  });
  group.dataset.x = component.x;
  group.dataset.y = component.y;
  group.dataset.rotation = component.rotation || 0;

  const body = el('rect', {
    class: 'component-body component-drag-surface',
    x: 0,
    y: 0,
    width: component.width,
    height: component.height,
    rx: 6,
    ry: 6,
  });
  bindComponentSelectTarget(body, group, component.name);
  group.appendChild(body);

  const center = el('rect', {
    class: 'component-center component-drag-surface',
    x: component.center.x,
    y: component.center.y,
    width: component.center.width,
    height: component.center.height,
  });
  bindComponentSelectTarget(center, group, component.name);
  group.appendChild(center);
  const centerX = component.center.x + component.center.width / 2;
  const centerY = component.center.y + component.center.height / 2;
  const preferredNameSize = Math.max(component.font.name * 2.2, Math.min(22, Math.max(12, component.center.height * 0.16)));
  const thinCenterText = centerTextOrientation(component, component.rotation || 0, component.name, preferredNameSize) === 'vertical';
  const centerFitWidth = centerTextFitWidth(component, component.rotation || 0, thinCenterText ? 'vertical' : 'horizontal');
  const fittedNameSize = fitTextSize(component.name, preferredNameSize, centerFitWidth, 8);
  const preferredTypeSize = Math.max(5, fittedNameSize * 0.62);
  const componentSubtitle = componentSubtitleText(component);
  const typeFontSize = Math.min(fittedNameSize * 0.72, fitTextSize(componentSubtitle, preferredTypeSize, centerFitWidth, 4.5));
  group.appendChild(textEl(component.name, {
    class: 'component-name',
    'data-text-role': 'name',
    'data-preferred-size': preferredNameSize,
    'data-center-orientation': thinCenterText ? 'vertical' : 'horizontal',
    'data-center-x': centerX,
    'data-center-y': centerY,
    x: centerX,
    y: centerY - typeFontSize * 0.55,
    'font-size': fittedNameSize,
  }));
  group.appendChild(textEl(componentSubtitle, {
    class: 'component-type',
    'data-text-role': 'type',
    'data-preferred-size': preferredTypeSize,
    'data-center-orientation': thinCenterText ? 'vertical' : 'horizontal',
    'data-center-x': centerX,
    'data-center-y': centerY,
    x: centerX,
    y: centerY + fittedNameSize * 0.75,
    'font-size': typeFontSize,
  }));

  component.pins.forEach((pin) => {
    const terminalFontSize = terminalTextFontSize(component, pin);
    const pinBox = el('rect', {
      class: 'pin-box',
      'data-node': pin.node,
      'data-component': component.name,
      x: pin.x,
      y: pin.y,
      width: pin.width,
      height: pin.height,
    });
    pinBox.addEventListener('click', (event) => {
      event.stopPropagation();
      selectPin(pin.node);
    });
    group.appendChild(pinBox);
    const pinLabel = textEl(pin.pin, {
      class: 'pin-label',
      'data-side': pin.side,
      x: pin.x + pin.width / 2,
      y: pin.y + pin.height / 2,
      'font-size': terminalFontSize,
    });
    group.appendChild(pinLabel);
  });
  group.appendChild(el('rect', {
    class: 'component-outline-overlay',
    x: 0,
    y: 0,
    width: component.width,
    height: component.height,
    rx: 6,
    ry: 6,
  }));
  group.appendChild(el('g', {
    class: 'component-endpoint-layer',
    'data-component': component.name,
  }));
  const markerLayer = el('g', { class: 'component-marker-layer' });
  component.pins.forEach((pin) => renderNoConnectMarker(markerLayer, pin));
  group.appendChild(markerLayer);
  updateComponentTransform(group, storedComponent);
  layer.appendChild(group);
}

function terminalTextFontSize(component, pin) {
  const terminalDepth = Math.max(pin.width, pin.height);
  return Math.max(component.font.pin, Math.min(4.2, terminalDepth * 0.32));
}

function renderNoConnectMarker(group, pin) {
  if (!pin.no_connect) return;
  const vector = sideVector(pin.side);
  const anchor = pinBoundaryPoint(pin);
  const stubLength = 20;
  const markerGap = 5;
  const stub = {
    x: anchor.x + vector.x * stubLength,
    y: anchor.y + vector.y * stubLength,
  };
  const center = {
    x: stub.x + vector.x * markerGap,
    y: stub.y + vector.y * markerGap,
  };
  const terminalPitch = Math.min(pin.width, pin.height);
  const size = Math.max(1.8, terminalPitch * 0.38);
  group.appendChild(el('path', {
    class: 'no-connect-stub',
    'data-node': pin.node,
    d: `M ${anchor.x} ${anchor.y} L ${stub.x} ${stub.y}`,
  }));
  group.appendChild(el('circle', {
    class: 'no-connect-dot',
    'data-node': pin.node,
    cx: anchor.x,
    cy: anchor.y,
    r: Math.max(0.8, Math.min(1.25, Math.max(pin.width, pin.height) * 0.16)),
  }));
  [
    [center.x - size, center.y - size, center.x + size, center.y + size],
    [center.x + size, center.y - size, center.x - size, center.y + size],
  ].forEach(([x1, y1, x2, y2]) => {
    group.appendChild(el('line', {
      class: 'no-connect-x no-connect-marker',
      'data-node': pin.node,
      x1,
      y1,
      x2,
      y2,
    }));
  });
}

function pinBoundaryPoint(pin) {
  if (pin.side === 'left') return { x: pin.x, y: pin.y + pin.height / 2 };
  if (pin.side === 'right') return { x: pin.x + pin.width, y: pin.y + pin.height / 2 };
  if (pin.side === 'top') return { x: pin.x + pin.width / 2, y: pin.y };
  return { x: pin.x + pin.width / 2, y: pin.y + pin.height };
}

function bindComponentSelectTarget(target, group, componentName) {
  target.addEventListener('click', (event) => {
    if (group.dataset.ignoreClick === 'true') {
      group.dataset.ignoreClick = 'false';
      return;
    }
    event.stopPropagation();
    selectComponent(componentName);
  });
}

function renderWireTable(wires) {
  renderWireTableHeader();
  wireTableBody.textContent = '';
  const visibleWires = sortedWires(wires);
  updateWireTableCount(visibleWires.length, wires.length);
  visibleWires.forEach((wire) => {
    const row = document.createElement('tr');
    row.className = 'wire-table-row';
    row.dataset.wire = String(wire.index);
    row.dataset.net = wire.net;
    row.dataset.tags = wire.tags || '';
    setNetStyle(row, wire.style);
    row.innerHTML = state.tableMode === 'combined'
      ? `
        <td><span class="wire-chip">${escapeHtml(wire.label)}</span></td>
        <td>${escapeHtml(wire.from)}</td>
        <td>${escapeHtml(wire.to)}</td>
        <td>${escapeHtml(wire.net)}</td>
        <td>${escapeHtml(wire.awg)}</td>
        <td>${escapeHtml(wire.tags || '')}</td>
        <td>${escapeHtml(wire.from_ref || '')}</td>
        <td>${escapeHtml(wire.to_ref || '')}</td>
      `
      : `
        <td><span class="wire-chip">${escapeHtml(wire.label)}</span></td>
        <td>${escapeHtml(wire.from_component)}</td>
        <td>${escapeHtml(wire.from_pin)}</td>
        <td>${escapeHtml(wire.from_ref || '')}</td>
        <td>${escapeHtml(wire.to_component)}</td>
        <td>${escapeHtml(wire.to_pin)}</td>
        <td>${escapeHtml(wire.to_ref || '')}</td>
        <td>${escapeHtml(wire.net)}</td>
        <td>${escapeHtml(wire.awg)}</td>
        <td>${escapeHtml(wire.tags || '')}</td>
      `;
    row.addEventListener('click', () => {
      selectWire(String(wire.index), wire.net);
      applyHighlight();
    });
    wireTableBody.appendChild(row);
  });
}

function updateWireTableCount(visibleCount, totalCount) {
  if (!wireTableCount) return;
  const visible = Number(visibleCount) || 0;
  const total = Number(totalCount) || 0;
  wireTableCount.textContent = visible === total ? `${total} wires` : `${visible} of ${total} wires`;
}

function renderWireTableHeader() {
  const marker = (key) => state.sortKey === key ? (state.sortDirection === 'asc' ? '^' : 'v') : '';
  if (state.tableMode === 'combined') {
    wireTableHead.innerHTML = `
      <tr>
        ${sortableHeader('Wire', 'label', marker('label'))}
        ${sortableHeader('From', 'from', marker('from'))}
        ${sortableHeader('To', 'to', marker('to'))}
        ${sortableHeader('Net', 'net', marker('net'))}
        ${sortableHeader('AWG', 'awg', marker('awg'))}
        ${sortableHeader('Tags', 'tags', marker('tags'))}
        ${sortableHeader('From Ref', 'from_ref', marker('from_ref'))}
        ${sortableHeader('To Ref', 'to_ref', marker('to_ref'))}
      </tr>
    `;
  } else {
    wireTableHead.innerHTML = `
      <tr>
        <th rowspan="2">${sortButton('Wire', 'label', marker('label'))}</th>
        <th colspan="3">From</th>
        <th colspan="3">To</th>
        <th rowspan="2">${sortButton('Net', 'net', marker('net'))}</th>
        <th rowspan="2">${sortButton('AWG', 'awg', marker('awg'))}</th>
        <th rowspan="2">${sortButton('Tags', 'tags', marker('tags'))}</th>
      </tr>
      <tr>
        ${sortableHeader('Component', 'from_component', marker('from_component'))}
        ${sortableHeader('Terminal', 'from_pin', marker('from_pin'))}
        ${sortableHeader('Ref', 'from_ref', marker('from_ref'))}
        ${sortableHeader('Component', 'to_component', marker('to_component'))}
        ${sortableHeader('Terminal', 'to_pin', marker('to_pin'))}
        ${sortableHeader('Ref', 'to_ref', marker('to_ref'))}
      </tr>
    `;
  }
  wireTableHead.querySelectorAll('button[data-sort-key]').forEach((button) => {
    button.addEventListener('click', () => sortWireTable(button.dataset.sortKey));
  });
}

function sortableHeader(label, key, marker) {
  return `<th>${sortButton(label, key, marker)}</th>`;
}

function sortButton(label, key, marker) {
  return `<button type="button" data-sort-key="${key}" data-sort-marker="${marker}">${label}</button>`;
}

function sortWireTable(key) {
  if (state.sortKey === key) {
    state.sortDirection = state.sortDirection === 'asc' ? 'desc' : 'asc';
  } else {
    state.sortKey = key;
    state.sortDirection = 'asc';
  }
  renderWireTable(state.data.wires);
  applyHighlight();
}

function sortedWires(wires) {
  const direction = state.sortDirection === 'asc' ? 1 : -1;
  return filterWiresByTag(wires).sort((left, right) => {
    const leftValue = wireSortValue(left, state.sortKey);
    const rightValue = wireSortValue(right, state.sortKey);
    if (leftValue < rightValue) return -1 * direction;
    if (leftValue > rightValue) return 1 * direction;
    return left.index - right.index;
  });
}

function filterWiresByTag(wires) {
  if (!state.tagFilter) return [...wires];
  return wires.filter((wire) => wireTags(wire).some((tag) => tag.toLowerCase() === state.tagFilter));
}

function wireTags(wire) {
  return String(wire.tags || '')
    .split(',')
    .map((tag) => tag.trim())
    .filter(Boolean);
}

function populateTagFilterOptions(wires) {
  if (!wireTagOptions) return;
  const tags = [...new Set(wires.flatMap(wireTags))].sort((left, right) => left.localeCompare(right));
  wireTagOptions.textContent = '';
  tags.forEach((tag) => {
    const option = document.createElement('option');
    option.value = tag;
    wireTagOptions.appendChild(option);
  });
}

function componentSubtitleText(component) {
  if (Array.isArray(component.tags) && component.tags.length) return component.tags.join(', ');
  return component.type || '';
}

function wireSortValue(wire, key) {
  if (key === 'index') return wire.index;
  if (key === 'awg') return Number(wire.awg || 0);
  return String(wire[key] || '').toLowerCase();
}

function renderWireEndpointGroups(wire, endpointLayer = host.querySelector('.wire-label-layer')) {
  wire.endpoints.forEach((endpoint) => {
    const component = state.components.get(endpoint.component);
    if (!component || !endpointLayer) return;
    const localEndpoint = endpointToLocal(endpoint, component);
    const group = el('g', {
      class: 'wire-endpoint-group',
      'data-wire': wire.index,
      'data-net': wire.net,
      'data-node': endpoint.node,
      'data-component': endpoint.component,
    });
    group.dataset.tx = 0;
    group.dataset.ty = 0;
    group.dataset.baseTx = 0;
    group.dataset.baseTy = 0;
    group.dataset.anchorX = localEndpoint.anchor.x;
    group.dataset.anchorY = localEndpoint.anchor.y;
    group.dataset.side = endpoint.side;
    group.dataset.stubLength = endpoint.stub_length;
    group.dataset.stubDistance = localEndpoint.stub_distance || endpoint.stub_distance || endpoint.stub_length;
    group.dataset.labelGap = endpoint.label_gap;
    group.dataset.labelWidth = endpoint.label.width || Math.max(8, wire.label.length * 4 + 1.5);
    group.dataset.labelHeight = endpoint.label.height || 17;
    group.dataset.slot = endpoint.label.slot || 0;
    group.dataset.slotCount = endpoint.label.slot_count || 1;
    group.setAttribute('transform', componentTransform(component));
    setNetStyle(group, wire.style);

    group.appendChild(el('path', {
      class: 'wire-stub',
      d: `M ${localEndpoint.anchor.x} ${localEndpoint.anchor.y} L ${localEndpoint.stub.x} ${localEndpoint.stub.y}`,
    }));
    group.appendChild(el('circle', {
      class: 'wire-dot',
      cx: localEndpoint.anchor.x,
      cy: localEndpoint.anchor.y,
      r: localEndpoint.dot_radius || endpoint.dot_radius || 1.15,
    }));

    group.dataset.labelX = localEndpoint.label.x;
    group.dataset.labelY = localEndpoint.label.y;
    const label = renderWireLabel(wire, localEndpoint);
    group.appendChild(label);
    endpointLayer.appendChild(group);
  });
}

function sortEndpointLayers() {
  const layer = host.querySelector('.wire-label-layer');
  if (!layer) return;
  [...layer.querySelectorAll('.wire-endpoint-group')]
    .sort((left, right) => Number(right.dataset.slot || 0) - Number(left.dataset.slot || 0))
    .forEach((group) => layer.appendChild(group));
}

function endpointToLocal(endpoint, component) {
  const pin = component.pins.find((item) => item.node === endpoint.node);
  if (!pin) {
    return absoluteEndpointToLocal(endpoint, component);
  }
  const slot = Number(endpoint.label.slot || 0);
  const vector = sideVector(endpoint.side);
  const anchor = pinBoundaryPoint(pin);
  const stubLength = Number(endpoint.stub_length || 0);
  const labelWidth = Number(endpoint.label.width || 44);
  const labelGap = Number(endpoint.label_gap || 0);
  const stubDistance = stubLength + slot * (labelWidth + stubLength);
  const labelOffset = labelGap + labelWidth / 2;
  const stub = {
    x: anchor.x + vector.x * stubDistance,
    y: anchor.y + vector.y * stubDistance,
  };
  return {
    ...endpoint,
    anchor,
    stub,
    stub_distance: stubDistance,
    label: {
      ...endpoint.label,
      x: stub.x + vector.x * labelOffset,
      y: stub.y + vector.y * labelOffset,
      rotation: readableLabelLocalRotation(endpoint.side, component.rotation || 0),
    },
  };
}

function absoluteEndpointToLocal(endpoint, component) {
  const originX = component.endpointOriginX ?? component.x;
  const originY = component.endpointOriginY ?? component.y;
  return {
    ...endpoint,
    anchor: {
      x: endpoint.anchor.x - originX,
      y: endpoint.anchor.y - originY,
    },
    stub: {
      x: endpoint.stub.x - originX,
      y: endpoint.stub.y - originY,
    },
    label: {
      ...endpoint.label,
      x: endpoint.label.x - originX,
      y: endpoint.label.y - originY,
      rotation: readableLabelLocalRotation(endpoint.side, component.rotation || 0),
    },
  };
}

function renderWireLabel(wire, endpoint) {
  const label = el('g', {
    class: 'wire-label-group',
    'data-wire': wire.index,
    'data-net': wire.net,
    'data-node': endpoint.node,
    'data-component': endpoint.component,
  });
  const width = endpoint.label.width || Math.max(8, wire.label.length * 4 + 1.5);
  const height = endpoint.label.height || 17;
  const cornerRadius = endpoint.label.corner_radius || 2;
  const transform = endpoint.label.rotation
    ? `rotate(${endpoint.label.rotation} ${endpoint.label.x} ${endpoint.label.y})`
    : '';
  if (transform) {
    label.setAttribute('transform', transform);
  }
  label.appendChild(el('rect', {
    class: 'wire-label-bg',
    x: endpoint.label.x - width / 2,
    y: endpoint.label.y - height / 2,
    width,
    height,
    rx: cornerRadius,
    ry: cornerRadius,
  }));
  label.appendChild(textEl(wire.label, {
    class: 'wire-label-text',
    x: endpoint.label.x,
    y: endpoint.label.y,
    'font-size': endpoint.label.font_size || 5,
  }));
  label.addEventListener('click', (event) => {
    event.stopPropagation();
    selectWire(String(wire.index), wire.net);
    applyHighlight();
  });
  return label;
}

function enableDrag(svg) {
  let active = null;
  svg.addEventListener('pointerdown', (event) => {
    if (!panelVizCanEdit()) return;
    const dragSurface = event.target.closest('.component-drag-surface');
    if (!dragSurface) return;
    const component = dragSurface.closest('.component');
    if (!component) return;
    const start = pointerToSvg(svg, event);
    const names = dragSelectionNames(component.dataset.component);
    const items = names
      .map((name) => {
        const element = document.querySelector(`.component[data-component="${cssEscape(name)}"]`);
        const model = state.components.get(name);
        if (!element || !model) return null;
        return {
          element,
          component: model,
          name,
          x: Number(element.dataset.x),
          y: Number(element.dataset.y),
        };
      })
      .filter(Boolean);
    active = {
      items,
      name: component.dataset.component,
      names,
      startX: start.x,
      startY: start.y,
      moved: false,
    };
    items.forEach((item) => item.element.classList.add('dragging'));
    component.setPointerCapture(event.pointerId);
  });
  svg.addEventListener('pointermove', (event) => {
    if (!active) return;
    const current = pointerToSvg(svg, event);
    const dx = current.x - active.startX;
    const dy = current.y - active.startY;
    if (Math.abs(dx) > 2 || Math.abs(dy) > 2) {
      active.moved = true;
    }
    active.items.forEach((item) => {
      const x = item.x + dx;
      const y = item.y + dy;
      item.element.dataset.x = x;
      item.element.dataset.y = y;
      item.component.x = x;
      item.component.y = y;
      updateComponentTransform(item.element, item.component);
      updateComponentEndpoints(item.component);
    });
  });
  svg.addEventListener('pointerup', () => endDrag(true));
  svg.addEventListener('pointercancel', () => endDrag(false));

  function endDrag(selectAfterDrag) {
    if (!active) return;
    active.items.forEach((item) => {
      item.component.x = Number(item.element.dataset.x);
      item.component.y = Number(item.element.dataset.y);
      if (active.moved) {
        item.element.dataset.ignoreClick = 'true';
      }
      item.element.classList.remove('dragging');
    });
    if (selectAfterDrag) {
      if (active.names.length > 1) {
        setComponentGroupSelection(active.names);
      } else {
        selectComponent(active.name);
      }
    }
    active.items.forEach((item) => dispatchComponentLayout(item.name, item.component));
    state.scene = renderedSceneBounds(svg, state.scene);
    updateReferenceGrid(svg, host.querySelector('.reference-grid-layer')?.classList.contains('visible') ?? false);
    active = null;
  }
}

function dragSelectionNames(componentName) {
  if (state.selectedComponents.includes(componentName)) {
    return [...state.selectedComponents];
  }
  return [componentName];
}

function enableMarqueeSelect(svg) {
  let activeMarquee = null;
  svg.addEventListener('pointerdown', (event) => {
    if (event.button !== 0 || !event.shiftKey || event.target.closest('.component') || event.target.closest('.wire-label-group')) return;
    event.preventDefault();
    event.stopPropagation();
    const start = pointerToSvg(svg, event);
    const rect = el('rect', {
      class: 'selection-marquee',
      x: start.x,
      y: start.y,
      width: 0,
      height: 0,
    });
    const interactionLayer = svg.querySelector('.interaction-layer') || svg;
    interactionLayer.appendChild(rect);
    activeMarquee = {
      pointerId: event.pointerId,
      start,
      rect,
    };
    svg.setPointerCapture(event.pointerId);
  });
  svg.addEventListener('pointermove', (event) => {
    if (!activeMarquee) return;
    const current = pointerToSvg(svg, event);
    updateMarqueeRect(activeMarquee.rect, activeMarquee.start, current);
  });
  svg.addEventListener('pointerup', () => endMarquee(true));
  svg.addEventListener('pointercancel', () => endMarquee(false));

  function endMarquee(selectComponents) {
    if (!activeMarquee) return;
    const bounds = normalizedRect(activeMarquee.rect);
    activeMarquee.rect.remove();
    activeMarquee = null;
    if (!selectComponents) return;
    const names = [...state.components.values()]
      .filter((component) => rectsIntersect(bounds, componentBounds(component)))
      .map((component) => component.name);
    setComponentGroupSelection(names);
  }
}

function updateMarqueeRect(rect, start, current) {
  const x = Math.min(start.x, current.x);
  const y = Math.min(start.y, current.y);
  const width = Math.abs(current.x - start.x);
  const height = Math.abs(current.y - start.y);
  rect.setAttribute('x', x);
  rect.setAttribute('y', y);
  rect.setAttribute('width', width);
  rect.setAttribute('height', height);
}

function normalizedRect(rect) {
  return {
    x: Number(rect.getAttribute('x')),
    y: Number(rect.getAttribute('y')),
    width: Number(rect.getAttribute('width')),
    height: Number(rect.getAttribute('height')),
  };
}

function componentBounds(component) {
  return {
    x: component.x,
    y: component.y,
    width: component.width,
    height: component.height,
  };
}

function rectsIntersect(left, right) {
  return left.x <= right.x + right.width
    && left.x + left.width >= right.x
    && left.y <= right.y + right.height
    && left.y + left.height >= right.y;
}

function enablePan(svg) {
  let activePan = null;
  svg.addEventListener('pointerdown', (event) => {
    if (event.button !== 0 || event.shiftKey || event.target.closest('.component') || event.target.closest('.wire-label-group')) return;
    activePan = {
      pointerId: event.pointerId,
      startX: event.clientX,
      startY: event.clientY,
      viewBox: { ...state.viewBox },
    };
    host.classList.add('panning');
    svg.setPointerCapture(event.pointerId);
  });
  svg.addEventListener('pointermove', (event) => {
    if (!activePan) return;
    const rect = svg.getBoundingClientRect();
    const dx = ((event.clientX - activePan.startX) / Math.max(rect.width, 1)) * activePan.viewBox.width;
    const dy = ((event.clientY - activePan.startY) / Math.max(rect.height, 1)) * activePan.viewBox.height;
    state.viewBox = {
      ...activePan.viewBox,
      x: activePan.viewBox.x - dx,
      y: activePan.viewBox.y - dy,
    };
    setViewBox(svg);
  });
  svg.addEventListener('pointerup', () => endPan());
  svg.addEventListener('pointercancel', () => endPan());

  function endPan() {
    if (!activePan) return;
    host.classList.remove('panning');
    activePan = null;
  }
}

function enableZoom(svg) {
  svg.addEventListener('wheel', (event) => {
    event.preventDefault();
    if (!state.viewBox || !state.canvas || !state.scene) return;
    state.scene = renderedSceneBounds(svg, state.scene);
    const pointer = pointerToSvg(svg, event);
    const zoomFactor = event.deltaY > 0 ? 1.12 : 0.89;
    const fitBox = fitBoundsToViewport(state.scene, 96);
    const aspect = state.viewBox.height / Math.max(state.viewBox.width, 1);
    const minWidth = Math.max(24, fitBox.width / 80);
    const maxWidth = fitBox.width * 1.15;
    const nextWidth = clamp(state.viewBox.width * zoomFactor, minWidth, maxWidth);
    const nextHeight = nextWidth * aspect;
    const ratioX = (pointer.x - state.viewBox.x) / state.viewBox.width;
    const ratioY = (pointer.y - state.viewBox.y) / state.viewBox.height;
    state.viewBox = {
      x: pointer.x - ratioX * nextWidth,
      y: pointer.y - ratioY * nextHeight,
      width: nextWidth,
      height: nextHeight,
    };
    setViewBox(svg);
  }, { passive: false });
}

function enableTableResize() {
  if (wireTableResizer.dataset.bound === 'true') return;
  wireTableResizer.dataset.bound = 'true';
  let activeResize = null;
  wireTableResizer.addEventListener('pointerdown', (event) => {
    event.preventDefault();
    activeResize = {
      startX: event.clientX,
      width: Number.parseFloat(workspace.style.getPropertyValue('--wire-table-width'))
        || document.querySelector('.wire-table-panel').getBoundingClientRect().width
        || 420,
    };
    wireTableResizer.setPointerCapture(event.pointerId);
  });
  window.addEventListener('pointermove', (event) => {
    if (!activeResize) return;
    const nextWidth = clamp(activeResize.width - (event.clientX - activeResize.startX), 280, 900);
    workspace.style.setProperty('--wire-table-width', `${nextWidth}px`);
  });
  window.addEventListener('pointerup', () => {
    activeResize = null;
  });
  window.addEventListener('pointercancel', () => {
    activeResize = null;
  });
}

function enableContextMenu(svg) {
  svg.addEventListener('contextmenu', (event) => {
    event.preventDefault();
    const componentGroup = event.target.closest('.component');
    if (componentGroup) {
      if (panelVizCanEdit()) rotateComponent(componentGroup.dataset.component);
      return;
    }
    clearSelectionState();
    applyHighlight();
  });
  host.addEventListener('contextmenu', (event) => {
    if (event.target.closest('svg')) return;
    event.preventDefault();
    clearSelectionState();
    applyHighlight();
  });
}

function rotateComponent(componentName) {
  if (!panelVizCanEdit()) return;
  const component = state.components.get(componentName);
  const group = document.querySelector(`.component[data-component="${cssEscape(componentName)}"]`);
  if (!component || !group) return;
  component.rotation = (Number(component.rotation || 0) + 90) % 360;
  group.dataset.rotation = component.rotation;
  group.dataset.ignoreClick = 'true';
  updateComponentTransform(group, component);
  updateComponentEndpoints(component);
  dispatchComponentLayout(componentName, component);
  updateReferenceGrid(host.querySelector('svg'), host.querySelector('.reference-grid-layer')?.classList.contains('visible') ?? false);
}

function dispatchComponentLayout(componentName, component) {
  document.dispatchEvent(new CustomEvent('panelviz:component-layout', {
    detail: {
      component: componentName,
      x: Number(component.x),
      y: Number(component.y),
      rotation: Number(component.rotation || 0),
    },
  }));
}

function panelVizCanEdit() {
  return typeof window.PanelVizCanEdit === 'function' ? Boolean(window.PanelVizCanEdit()) : true;
}

function updateComponentTransform(group, component) {
  group.setAttribute('transform', componentTransform(component));
  group.dataset.x = component.x;
  group.dataset.y = component.y;
  group.dataset.rotation = component.rotation || 0;
  updateReadableComponentText(group, component.rotation || 0);
}

function componentTransform(component) {
  return `translate(${component.x} ${component.y}) rotate(${component.rotation || 0} ${component.width / 2} ${component.height / 2})`;
}

function updateReadableComponentText(group, rotation) {
  const normalized = ((rotation % 360) + 360) % 360;
  updateCenterTextMetrics(group, rotation);
  group.querySelectorAll('.pin-label,.component-name,.component-type').forEach((text) => {
    let x = Number(text.getAttribute('x'));
    let y = Number(text.getAttribute('y'));
    const role = text.dataset.textRole;
    if (role === 'name' || role === 'type') {
      const centerX = Number(text.dataset.centerX);
      const centerY = Number(text.dataset.centerY);
      const centerOrientation = text.dataset.centerOrientation === 'vertical' ? 'vertical' : 'horizontal';
      const offsetMagnitude = role === 'name' ? -Number(text.getAttribute('font-size')) * 0.45 : Number(text.getAttribute('font-size')) * 1.15;
      const offsetVector = centerOrientation === 'vertical'
        ? { x: offsetMagnitude, y: 0 }
        : { x: 0, y: offsetMagnitude };
      const localOffset = inverseRotateVector(offsetVector.x, offsetVector.y, normalized);
      x = centerX + localOffset.x;
      y = centerY + localOffset.y;
      text.setAttribute('x', x);
      text.setAttribute('y', y);
    }
    const textRotation = role === 'name' || role === 'type'
      ? readableCenterTextLocalRotation(text.dataset.centerOrientation, rotation)
      : readableLabelLocalRotation(text.dataset.side, rotation);
    text.setAttribute('transform', `rotate(${textRotation} ${x} ${y})`);
  });
}

function updateCenterTextMetrics(group, rotation) {
  const component = state.components.get(group.dataset.component);
  if (!component) return;
  const nameText = group.querySelector('.component-name');
  const typeText = group.querySelector('.component-type');
  if (!nameText || !typeText) return;
  const preferredNameSize = Number(nameText.dataset.preferredSize || nameText.getAttribute('font-size') || component.font.name || 10);
  const centerOrientation = centerTextOrientation(component, rotation, nameText.textContent, preferredNameSize);
  const fitWidth = centerTextFitWidth(component, rotation, centerOrientation);
  const fittedNameSize = fitTextSize(nameText.textContent, preferredNameSize, fitWidth, 8);
  const preferredTypeSize = Math.max(5, fittedNameSize * 0.62);
  const typeFontSize = Math.min(fittedNameSize * 0.72, fitTextSize(typeText.textContent, preferredTypeSize, fitWidth, 4.5));
  [nameText, typeText].forEach((text) => {
    text.dataset.centerOrientation = centerOrientation;
  });
  nameText.setAttribute('font-size', fittedNameSize);
  typeText.setAttribute('font-size', typeFontSize);
}

function inverseRotateVector(x, y, rotation) {
  if (rotation === 90) return { x: y, y: -x };
  if (rotation === 180) return { x: -x, y: -y };
  if (rotation === 270) return { x: -y, y: x };
  return { x, y };
}

function updateComponentEndpoints(component) {
  document.querySelectorAll(`.wire-endpoint-group[data-component="${cssEscape(component.name)}"]`).forEach((group) => {
    group.setAttribute('transform', componentTransform(component));
    const label = {
      x: Number(group.dataset.labelX),
      y: Number(group.dataset.labelY),
      width: Number(group.dataset.labelWidth),
      height: Number(group.dataset.labelHeight),
      rotation: readableLabelLocalRotation(group.dataset.side, component.rotation || 0),
    };
    setEndpointLabelGeometry(group, label);
  });
}

function setEndpointLabelGeometry(group, label) {
  const labelGroup = group.querySelector('.wire-label-group');
  const labelRect = group.querySelector('.wire-label-bg');
  const labelText = group.querySelector('.wire-label-text');
  if (label.rotation) {
    labelGroup.setAttribute('transform', `rotate(${label.rotation} ${label.x} ${label.y})`);
  } else {
    labelGroup.removeAttribute('transform');
  }
  labelRect.setAttribute('x', label.x - label.width / 2);
  labelRect.setAttribute('y', label.y - label.height / 2);
  labelRect.setAttribute('width', label.width);
  labelRect.setAttribute('height', label.height);
  labelText.setAttribute('x', label.x);
  labelText.setAttribute('y', label.y);
}

function rotatePoint(point, center, rotation) {
  const normalized = ((rotation % 360) + 360) % 360;
  const dx = point.x - center.x;
  const dy = point.y - center.y;
  if (normalized === 90) return { x: center.x - dy, y: center.y + dx };
  if (normalized === 180) return { x: center.x - dx, y: center.y - dy };
  if (normalized === 270) return { x: center.x + dy, y: center.y - dx };
  return { x: point.x, y: point.y };
}

function rotateSide(side, rotation) {
  const order = ['top', 'right', 'bottom', 'left'];
  const turns = (((rotation / 90) % 4) + 4) % 4;
  const index = order.indexOf(side);
  return order[(index + turns) % order.length] || side;
}

function sideVector(side) {
  if (side === 'left') return { x: -1, y: 0 };
  if (side === 'right') return { x: 1, y: 0 };
  if (side === 'top') return { x: 0, y: -1 };
  return { x: 0, y: 1 };
}

function fanOffset(side, slot, slotCount, spacing) {
  if (slotCount <= 1) return { x: 0, y: 0 };
  const offset = (slot - (slotCount - 1) / 2) * spacing;
  if (side === 'left' || side === 'right') return { x: 0, y: offset };
  return { x: offset, y: 0 };
}

function readableScreenRotation(side) {
  return readableScreenTextRotationForSide(side, 0);
}

function readableLabelLocalRotation(localSide, componentRotation) {
  return readableLocalTextRotation(
    readableScreenTextRotationForSide(localSide, componentRotation || 0),
    componentRotation || 0,
  );
}

function readableCenterTextLocalRotation(centerOrientation, componentRotation) {
  return readableLocalTextRotation(centerOrientation === 'vertical' ? -90 : 0, componentRotation || 0);
}

function centerTextOrientation(component, componentRotation, text, preferredSize) {
  const screenSize = centerScreenSize(component, componentRotation || 0);
  const screenWidth = Math.max(1, screenSize.width);
  const screenHeight = Math.max(1, screenSize.height);
  if (screenWidth < screenHeight * 0.62) return 'vertical';
  if (estimateTextWidth(text, preferredSize) > Math.max(1, screenWidth - 8)) return 'vertical';
  return 'horizontal';
}

function centerTextFitWidth(component, componentRotation, centerOrientation) {
  const screenSize = centerScreenSize(component, componentRotation || 0);
  const fitSpan = centerOrientation === 'vertical' ? screenSize.height : screenSize.width;
  return Math.max(8, fitSpan - 8);
}

function centerScreenSize(component, componentRotation) {
  const rotation = normalizeRotation(componentRotation || 0);
  if (Math.abs(rotation) === 90) {
    return { width: component.center.height, height: component.center.width };
  }
  return { width: component.center.width, height: component.center.height };
}

function readableScreenTextRotationForSide(localSide, componentRotation) {
  const screenSide = rotateSide(localSide, componentRotation || 0);
  return screenSide === 'top' || screenSide === 'bottom' ? -90 : 0;
}

function readableLocalTextRotation(targetScreenRotation, componentRotation) {
  return normalizeRotation(targetScreenRotation - (componentRotation || 0));
}

function normalizeRotation(rotation) {
  let normalized = ((rotation % 360) + 360) % 360;
  if (normalized > 180) normalized -= 360;
  return normalized;
}

function pointerToSvg(svg, event) {
  const rect = svg.getBoundingClientRect();
  const viewBox = state.viewBox || {
    x: 0,
    y: 0,
    width: rect.width || 1,
    height: rect.height || 1,
  };
  return {
    x: viewBox.x + ((event.clientX - rect.left) / Math.max(rect.width, 1)) * viewBox.width,
    y: viewBox.y + ((event.clientY - rect.top) / Math.max(rect.height, 1)) * viewBox.height,
  };
}

function normalizeBounds(bounds) {
  return {
    x: Number(bounds?.x ?? 0),
    y: Number(bounds?.y ?? 0),
    width: Math.max(1, Number(bounds?.width ?? 1)),
    height: Math.max(1, Number(bounds?.height ?? 1)),
  };
}

function fitBoundsToViewport(bounds, padding = 48) {
  const normalized = normalizeBounds(bounds);
  const rect = host.getBoundingClientRect();
  const viewportAspect = Math.max(rect.width, 1) / Math.max(rect.height, 1);
  let width = normalized.width + padding * 2;
  let height = normalized.height + padding * 2;
  if (width / height < viewportAspect) {
    width = height * viewportAspect;
  } else {
    height = width / viewportAspect;
  }
  const centerX = normalized.x + normalized.width / 2;
  const centerY = normalized.y + normalized.height / 2;
  return {
    x: centerX - width / 2,
    y: centerY - height / 2,
    width,
    height,
  };
}

function renderedSceneBounds(svg, fallbackBounds) {
  if (!svg || !svg.getScreenCTM) return normalizeBounds(fallbackBounds);
  const inverse = svg.getScreenCTM()?.inverse();
  if (!inverse) return normalizeBounds(fallbackBounds);
  const items = [...svg.querySelectorAll('.component,.wire-endpoint-group,.no-connect-marker,.no-connect-stub,.no-connect-dot')];
  const points = [];
  items.forEach((item) => {
    const rect = item.getBoundingClientRect();
    if (!rect.width && !rect.height) return;
    [
      [rect.left, rect.top],
      [rect.right, rect.top],
      [rect.right, rect.bottom],
      [rect.left, rect.bottom],
    ].forEach(([x, y]) => {
      const point = svg.createSVGPoint();
      point.x = x;
      point.y = y;
      points.push(point.matrixTransform(inverse));
    });
  });
  if (!points.length) return normalizeBounds(fallbackBounds);
  const minX = Math.min(...points.map((point) => point.x));
  const minY = Math.min(...points.map((point) => point.y));
  const maxX = Math.max(...points.map((point) => point.x));
  const maxY = Math.max(...points.map((point) => point.y));
  return {
    x: minX,
    y: minY,
    width: Math.max(1, maxX - minX),
    height: Math.max(1, maxY - minY),
  };
}

function setViewBox(svg) {
  svg.setAttribute('viewBox', `${state.viewBox.x} ${state.viewBox.y} ${state.viewBox.width} ${state.viewBox.height}`);
}

function clamp(value, min, max) {
  return Math.min(max, Math.max(min, value));
}

function selectWire(wireIndex, netName) {
  clearSelectionState();
  state.selectedWire = wireIndex;
  state.selectedNet = netName;
  state.selectedWires = [wireIndex];
  state.selectedNets = netName ? [netName] : [];
}

function selectPin(node) {
  clearSelectionState();
  state.selectedNode = node;
  const endpoints = [...document.querySelectorAll(`.wire-endpoint-group[data-node="${cssEscape(node)}"]`)];
  if (state.mode === 'net') {
    state.selectedNets = uniqueValues(endpoints.map((endpoint) => endpoint.dataset.net).filter(Boolean));
    state.selectedNet = state.selectedNets[0] || null;
  } else {
    state.selectedWires = uniqueValues(endpoints.map((endpoint) => endpoint.dataset.wire).filter(Boolean));
    state.selectedWire = state.selectedWires[0] || null;
  }
  applyHighlight();
}

function selectComponent(componentName) {
  clearSelectionState();
  state.selectedComponent = componentName;
  const endpoints = [...document.querySelectorAll(`.wire-endpoint-group[data-component="${cssEscape(componentName)}"]`)];
  if (state.mode === 'net') {
    state.selectedNets = uniqueValues(endpoints.map((endpoint) => endpoint.dataset.net).filter(Boolean));
    state.selectedNet = state.selectedNets[0] || null;
  } else {
    state.selectedWires = uniqueValues(endpoints.map((endpoint) => endpoint.dataset.wire).filter(Boolean));
    state.selectedWire = state.selectedWires[0] || null;
  }
  applyHighlight();
}

function setComponentGroupSelection(componentNames) {
  clearSelectionState();
  state.selectedComponents = uniqueValues(componentNames);
  applyHighlight();
}

function selectDiagnosticNodes(nodes) {
  clearSelectionState();
  state.diagnosticNodes = nodes;
  applyHighlight();
}

function clearSelectionState() {
  state.selectedWire = null;
  state.selectedNet = null;
  state.selectedWires = [];
  state.selectedNets = [];
  state.selectedNode = null;
  state.selectedComponent = null;
  state.selectedComponents = [];
  state.diagnosticNodes = [];
  state.diagnosticComponents = [];
  document.querySelectorAll('.component.group-selected').forEach((component) => {
    component.classList.remove('group-selected');
  });
  setDiagnosticButtonState(null);
}

function setDiagnosticButtonState(activeKey) {
  Object.entries(diagnosticButtons).forEach(([key, button]) => {
    button?.setAttribute('aria-pressed', String(key === activeKey));
  });
}

function uniqueValues(values) {
  return [...new Set(values)];
}

function applyHighlight() {
  const selectedWires = new Set(state.selectedWires);
  const selectedNets = new Set(state.selectedNets);
  const hasSelection = state.mode === 'net'
    ? selectedNets.size > 0 || Boolean(state.selectedComponent)
    : selectedWires.size > 0 || Boolean(state.selectedComponent);
  document.querySelectorAll('.dimmed,.selected').forEach((item) => {
    item.classList.remove('dimmed', 'selected');
  });
  document.querySelectorAll('.diagnostic-selected').forEach((item) => {
    item.classList.remove('diagnostic-selected');
  });
  document.querySelectorAll('.pin-box').forEach((pin) => {
    pin.style.removeProperty('--net-color');
  });
  state.diagnosticNodes.forEach((node) => {
    const pin = document.querySelector(`.pin-box[data-node="${cssEscape(node)}"]`);
    if (pin) pin.classList.add('diagnostic-selected');
    document.querySelectorAll(`.wire-endpoint-group[data-node="${cssEscape(node)}"]`).forEach((endpoint) => {
      endpoint.classList.add('diagnostic-selected');
    });
  });
  state.diagnosticComponents.forEach((componentName) => {
    const component = document.querySelector(`.component[data-component="${cssEscape(componentName)}"]`);
    if (component) component.classList.add('diagnostic-selected');
  });
  document.querySelectorAll('.component').forEach((component) => {
    component.classList.toggle('group-selected', state.selectedComponents.includes(component.dataset.component));
  });
  if (!hasSelection) return;

  document.querySelectorAll('.wire-endpoint-group').forEach((group) => {
    const match = state.mode === 'net'
      ? selectedNets.has(group.dataset.net)
      : selectedWires.has(group.dataset.wire);
    group.classList.toggle('selected', match);
    group.classList.toggle('dimmed', !match);
  });
  document.querySelectorAll('.wire-table-row').forEach((row) => {
    const match = state.mode === 'net'
      ? selectedNets.has(row.dataset.net)
      : selectedWires.has(row.dataset.wire);
    row.classList.toggle('selected', match);
    row.classList.toggle('dimmed', !match);
  });
  document.querySelectorAll('.component').forEach((component) => {
    component.classList.toggle('selected', component.dataset.component === state.selectedComponent);
  });
  document.querySelectorAll('.pin-box').forEach((pin) => {
    const endpoint = document.querySelector(`.wire-endpoint-group.selected[data-node="${cssEscape(pin.dataset.node)}"]`);
    pin.classList.toggle('selected', Boolean(endpoint));
    pin.classList.toggle('dimmed', !endpoint);
    if (endpoint) {
      pin.style.setProperty('--net-color', getComputedStyle(endpoint).getPropertyValue('--net-color'));
    }
  });
}

function setNetStyle(element, style) {
  element.style.setProperty('--net-color', style.color || '#475569');
  const lineWeight = Number(style.line_weight || 1.6);
  element.style.setProperty('--net-weight', lineWeight);
  element.style.setProperty('--net-selected-weight', lineWeight + 2);
  element.style.setProperty('--net-dasharray', dashArray(style.line_style));
}

function dashArray(lineStyle) {
  if (lineStyle === 'dashed') return '6 4';
  if (lineStyle === 'dotted') return '1 4';
  return 'none';
}

function el(name, attrs = {}) {
  const node = document.createElementNS(NS, name);
  Object.entries(attrs).forEach(([key, value]) => {
    if (value !== undefined && value !== null) node.setAttribute(key, value);
  });
  return node;
}

function textEl(value, attrs = {}) {
  const node = el('text', attrs);
  node.textContent = value;
  return node;
}

function fitTextSize(text, preferredSize, maxWidth, minimumSize) {
  const estimatedWidth = Math.max(1, String(text).length * preferredSize * 0.58);
  if (estimatedWidth <= maxWidth) return preferredSize;
  return Math.max(minimumSize, preferredSize * (maxWidth / estimatedWidth));
}

function estimateTextWidth(text, fontSize) {
  return Math.max(1, String(text).length * fontSize * 0.58);
}

function cssEscape(value) {
  if (window.CSS && CSS.escape) return CSS.escape(value);
  return String(value).replace(/"/g, '\\"');
}

function escapeHtml(value) {
  return String(value).replace(/[&<>"']/g, (character) => ({
    '&': '&amp;',
    '<': '&lt;',
    '>': '&gt;',
    '"': '&quot;',
    "'": '&#39;',
  }[character]));
}
"""
