dcowden/panelviz/(commit log)

2026-05-23 mostly working, but with net labels removed
    [component_summary.csv, wire_list.csv]
2026-05-25 fix a couple of bugs
2026-05-25 motor wires to 16 ga
2026-05-25 moved driver terminal
2026-07-04 wiring finished i think
2026-07-16 limit switches 24v not 5v
2026-09-30 add charge pump input to arduino. change logic to fault on lower limits, and require reset to power back on
2026-10-29 post install: new field box, atc, vac relay,
